softerhardware/Hermes-Lite2/README.md

Hermes-Lite 2.x
===============

See the main [Hermes-Lite Web Page](http://www.hermeslite.com) for the latest links and details.

This is a work in progress to create a low-cost software defined amateur radio HF transceiver based on a [broadband modem chip](http://www.analog.com/en/broadband-products/broadband-codecs/ad9866/products/product.html) and the [Hermes SDR](http://openhpsdr.org/wiki/index.php?title=HERMES) project.
