softerhardware/Hermes-Lite2/hardware/companions/io_jumper/README.md

# BOM

The BOM below lists possible options for IO jumper board. The builder should choose what components they need to buy and install.

| Reference | Quantity | Component |
| --- | --- | --- |
| DB1 | 1 | [5x2 male header 2.54mm](https://www.digikey.com/product-detail/en/sullins-connector-solutions/PRPC005DAAN-RC/S2011EC-05-ND) |
| P1 | 1 | [20x2 female header 2.54mm](https://www.digikey.com/product-detail/en/sullins-connector-solutions/SFH11-PBPC-D20-ST-BK/S9200-ND) |
| RF1 | 1 | [Edge Launch SMA](https://www.digikey.com/product-detail/en/adam-tech/RF2-04A-T-00-50-G/2057-RF2-04A-T-00-50-G-ND) |
| U1 | 1 | [MCP23008T-E-SS](https://www.digikey.com/product-detail/en/microchip-technology/MCP23008T-E-SS/MCP23008T-E-SSCT-ND) |
| C1 | 1 | [0.1uF 0805](https://www.digikey.com/product-detail/en/kemet/C0805C104Z5VACTU/399-1177-1-ND/411452) |
| R1, J1, J2 | 2 | [0Ohm 0805](https://www.digikey.com/product-detail/en/yageo/RC0805JR-070RL/311-0.0ARCT-ND) |
| R2 | 1 | [49.9 0805](https://www.digikey.com/product-detail/en/yageo/RC0805FR-0749R9L/311-49.9CRCT-ND) |
| R3 | 1 | [470 0805](https://www.digikey.com/product-detail/en/yageo/RC0805FR-07470RL/311-470CRCT-ND) |
| R4 | 1 | [1K 0805](https://www.digikey.com/product-detail/en/yageo/RC0805FR-071KL/311-1.00KCRCT-ND) |
