softerhardware/Hermes-Lite2/firmware/bitfiles/20180520/README.md

Hermes-Lite 2.x Firmware
========================

20180520 Release Candidate

Version 61 for beta3 and higher
Version 41 for beta2

* ADC running in low power mode to reduce heat
* New LEDs: Running, TX, ADC level just before clip, ADC clip
* Major rewrite of control to simplify and prepare for extensions
