softerhardware/Hermes-Lite2/hardware/enclosure/heatshim/enclosure_40mm/README.md

Hermes-Lite 2 heat shim for standard 40mm tall enclosure by Samuel F8ACB and Chris HB9BDM.
