softerhardware/Hermes-Lite2/hardware/companions/releases/n2adr_jumper/README.md

N2ADR Jumper Release
====================

February 24, 2019. This directory contains all files necessary to fabricate the N2ADR jumper board to connect the N2ADR filters to the Hermes-Lite 2.0.

# Files

 * pcb/* - Gerber files names as requested by assembly house
 
# BOM
 * 2-layer PCB as specified by gerber files
 * 2x20 PIN double row straight femail pin header 2.54mm pitch [AliExpress](https://www.aliexpress.com/item/10PCS-2X20-PIN-Double-row-Straight-FEMALE-PIN-HEADER-2-54MM-PITCH-Strip-Connector-Socket-2/32854215610.html)
