softerhardware/Hermes-Lite2/hardware/enclosure/endcaps/w3drk/README.md

Thank you to W3DRK for sharing these 3D printer files for HL2 end caps. They fit the recommended enclosure. The .stl files are for the 3D printer. The .f3d is an Autodesk Fusion 360 source file.
