softerhardware/Hermes-Lite2/hardware/hl/releases/hl2p0beta3/README.txt

September 4, 2017

This directory contains all files necessary to fabricate the Hermes-Lite 2.0beta3 release. Quotes are included for complete turnkey assembly by two compaines in China. A run of 5 assembled boards was done with Elecrow with good results. Elecrow is the preferred provider as they have and are developing expertise in the Hermes-Lite 2.0.
