softerhardware/Hermes-Lite2/gateware/bitfiles/stable/20180708/README.md

Hermes-Lite 2.x Firmware
========================

20180708 Release

* From Jim N2ADR: Change the CW waveform rise/fall time from 2 msec to 4 msec. Sequence TR.
* Deciamate by 8 polyphase FIR filter running at double speed.
