softerhardware/Hermes-Lite2/firmware/bitfiles/stable/20180603/README.md

Hermes-Lite 2.x Firmware
========================

20180602 Release Candidate

Version 62 for beta3 and higher
Version 42 for beta2

* Fix for proper padding with 3 or more receivers
* N2ADR additions for VNA
* N2ADR fix for PTT and CW return flags
* Combined I2C controller for I2C1 and I2C2, software may now control Versa Clock generator
