softerhardware/Hermes-Lite2/firmware/bitfiles/stable/20180106/README.md

Hermes-Lite 2.x Firmware
========================

20180106 Release Candidate

* Support for filter select via MCP23008, emulates J16 OC outputs
* New I2C module to support above
* Small change to slow ADC I2C reset to see if it makes slow ADC startup more stable
* Clock generation for 100Mbs modified to make timing closure more consistent
* RTL and SDC improvements and cleanup
