softerhardware/Hermes-Lite2/hardware/enclosure/endcaps/ad5dz/template/Readme.org

* Templates
  A kicad template is a kicad project with a meta sub-directory containing
  info.html, icon.png, and brd.png which appears in one of the template
  directories known to kicad.
  This directory provides symbolic links to the kicad projects which are
  used as templates.
