softerhardware/Hermes-Lite2/hardware/enclosure/endcaps/ad5dz/hl2-front-horiz/meta/info.html

# HL2 - Front Horizontal

Horizontally labelled front panel for the Hermes-Lite 2.0 (http://www.hermeslite.com) radio transceiver.

The final PCB looks like the following:

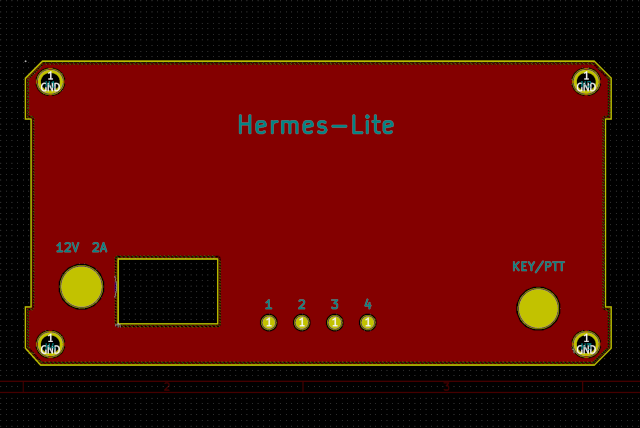
[picture p21: hardware/enclosure/endcaps/ad5dz/hl2-front-horiz/meta/brd.png]


© 2019 Roger E Critchlow Jr, Santa Fe, NM, USA
Permission granted to copy and to make derived works.
