softerhardware/Hermes-Lite2/hardware/enclosure/endcaps/ad5dz/hl2-panel/meta/info.html

# HL2 - End Panel

This is the board outline, mounting holes, and copyright notice for all the end plates of the Hermes-Lite 2.0 (http://www.hermeslite.com) radio transceiver. The board outline is cut small enough to fit inside the 105mm wide case outline. The mounting holes are spread 0.25mm horizontally to accommodate both the 105mm and 106mm width cases.

The final PCB looks like the following:

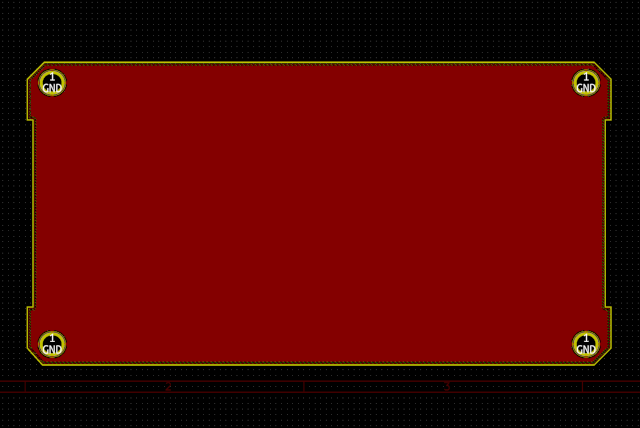
[picture p24: hardware/enclosure/endcaps/ad5dz/hl2-panel/meta/brd.png]


© 2019 Roger E Critchlow Jr, Santa Fe, NM, USA
Permission granted to copy and to make derived works.
