softerhardware/Hermes-Lite2/hardware/hl/bd.pdf

# Hermes-Lite 2.0beta2 Block Diagram

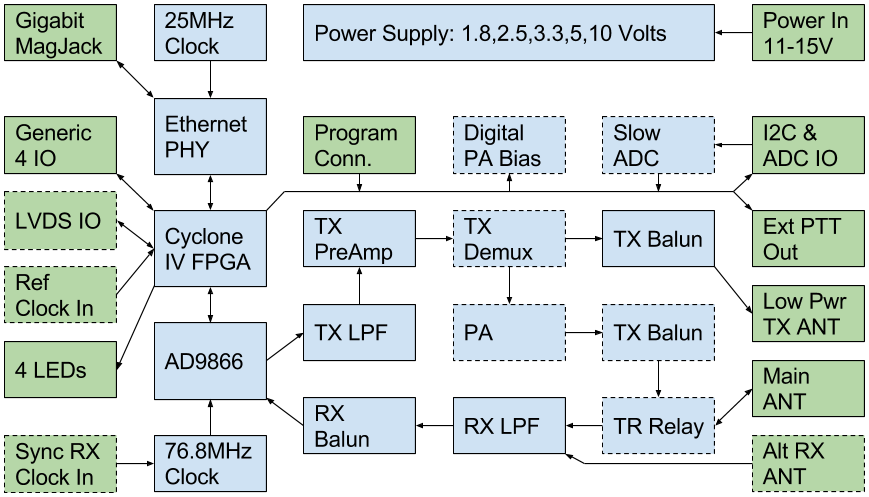
[picture p25: figure]

- Green boxes are external connectors
- Dashed boxes are common optional blocks
- Additional external filtering required for TX to meet harmonic emissions regulations
