softerhardware/Hermes-Lite2/hardware/enclosure/endcaps/ad5dz/mech-115mm/HTB1F0.VPXXXXXXGapXXq6xXFXXX0.jpg

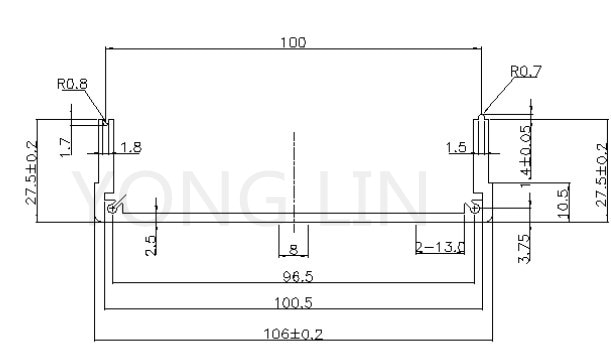
hardware/enclosure/endcaps/ad5dz/mech-115mm/HTB1F0.VPXXXXXXGapXXq6xXFXXX0.jpg
