softerhardware/Hermes-Lite2/hardware/enclosure/endcaps/ad5dz/mech-116mm/HTB1HYbmrYZnBKNjSZFrq6yRLFXaS.jpg

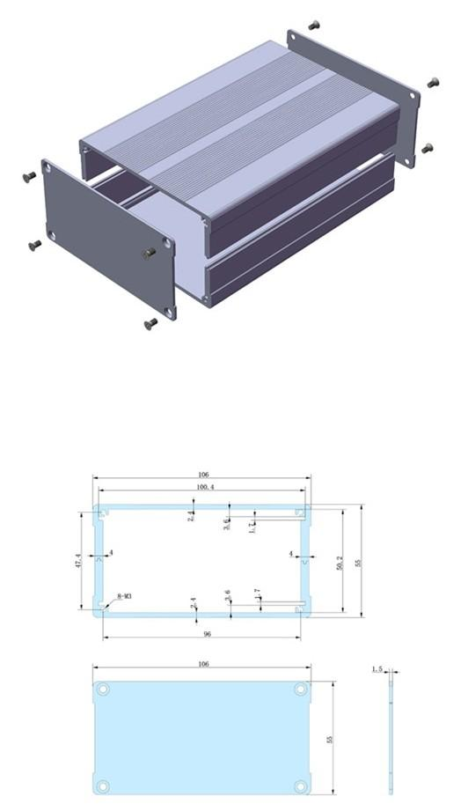
hardware/enclosure/endcaps/ad5dz/mech-116mm/HTB1HYbmrYZnBKNjSZFrq6yRLFXaS.jpg
