softerhardware/Hermes-Lite2/hardware/enclosure/endcaps/ad5dz/mech-116mm/SZOMK model number AK-C-C12.jpg

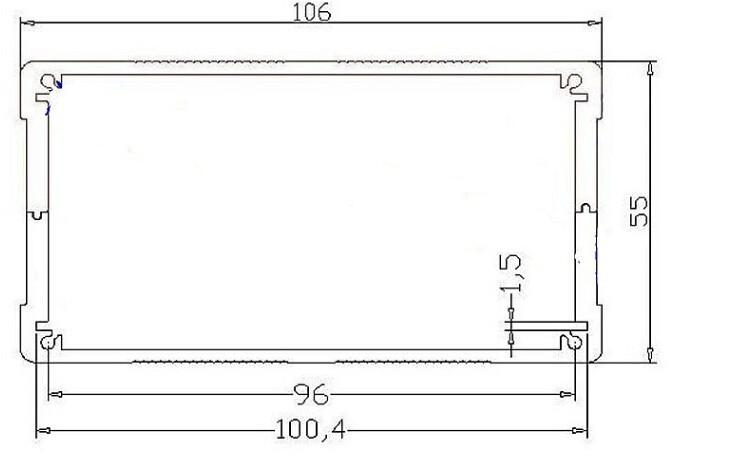
hardware/enclosure/endcaps/ad5dz/mech-116mm/SZOMK model number AK-C-C12.jpg
