softerhardware/Hermes-Lite2/hardware/enclosure/heatshim/enclosure_40mm/HL2_Cooler_Corrected_Version.jpg

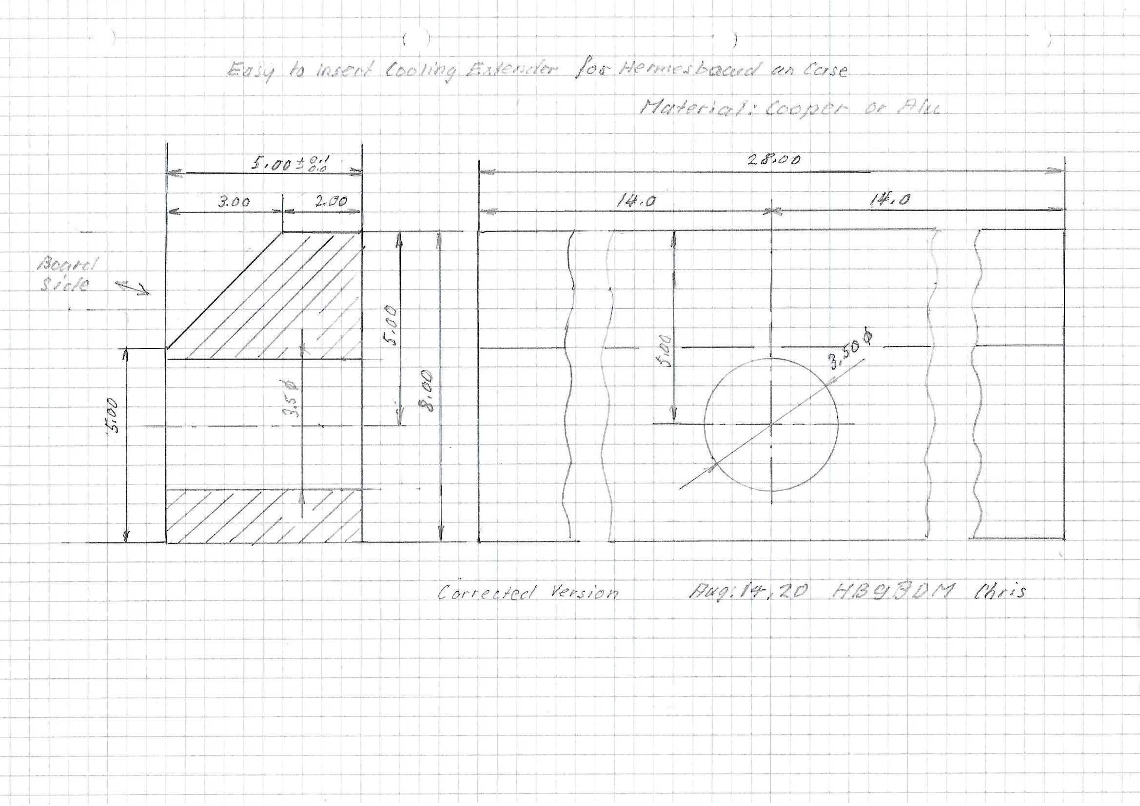
hardware/enclosure/heatshim/enclosure_40mm/HL2_Cooler_Corrected_Version.jpg
