softerhardware/Hermes-Lite2/hardware/companions/releases/n2adr_e5b9/bom.assembly.pdf

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

Line | Description | Part Number | Sub OK | Designators | Footprint | Pins | Quantity
36 | 56 0805≤1%≥1/10W | RC0805FR-0756RL (http://www.octopart.com/search?q=RC0805FR-0756RL) ERJ-6ENF56R0V (http://www.octopart.com/search?q=ERJ-6ENF56R0V) CRGCQ0805F56R (http://www.octopart.com/search?q=CRGCQ0805F56R) | Y | R3 | 0805 | 2 | 1
37 | 4.7K 0805≤1%≥1/10W | RC0805JR-074K7L (http://www.octopart.com/search?q=RC0805JR-074K7L) CRG0805F4K7 (http://www.octopart.com/search?q=CRG0805F4K7) RC2012F472CS (http://www.octopart.com/search?q=RC2012F472CS) | Y | R4,R5,R8,R9 | 0805 | 2 | 4
38 | 18 0805≤1%≥1/10W | RC0805FR-0718RL (http://www.octopart.com/search?q=RC0805FR-0718RL) CRG0805F18R (http://www.octopart.com/search?q=CRG0805F18R) | Y | R6,R7 | 0805 | 2 | 2
39 | 6.2K 0805≤1%≥1/10W | RC0805FR-076K2L (http://www.octopart.com/search?q=RC0805FR-076K2L) ERJ-6ENF6201V (http://www.octopart.com/search?q=ERJ-6ENF6201V) | Y | R11,R14 | 0805 | 2 | 2
40 | 330 0805≤1%≥1/10W | RC0805JR-07330RL (http://www.octopart.com/search?q=RC0805JR-07330RL) RC2012F331CS (http://www.octopart.com/search?q=RC2012F331CS) CRG0805F330R (http://www.octopart.com/search?q=CRG0805F330R) | Y | R12,R15 | 0805 | 2 | 2
41 | I2C Bus Expander | MCP23008T-E/SS (http://www.octopart.com/search?q=MCP23008T-E/SS) | N | U1 | SSOP-20 | 20 | 1
42 | Relay Driver | ULN2003LVPWR (http://www.octopart.com/search?q=ULN2003LVPWR) | N | U2 | TSSOP-16 | 16 | 1
43 | AD8692 Op Amp | AD8692ARMZ-R7 (http://www.octopart.com/search?q=AD8692ARMZ-R7) | N | U3 | MSOP-8 | 8 | 1
44 | NAND Gate | SN74LVC1G00DBVR (http://www.octopart.com/search?q=SN74LVC1G00DBVR) | N | U5 | SOT-23-5 | 5 | 1

Line Items: SMT:38 Assembled TH:6 Parts: SMT:81 Assembled TH:13
Pins: SMT:207 Assembled TH:107
Do Not Assemble: C12 C15 CN5 R16 RV1

3
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
