softerhardware/Hermes-Lite2/hardware/companions/releases/n2adr_e5b9/bom.assembly.xlsx

Line | Description | Part Number | Substitution Okay | Designators | Footprint | Pins | Quantity | Part Reference Links
1 | 0.1uF 0805>=X5R>=25V<=20% | 08055C104JAT2A C0805C104M3RACTU 885012207128 | Y | C1,C2,C3,C4,C5,C6, C7,C11,C13,C14,C20, C27,C28,C29,C30,C31, C45,C46,C50 | 805 | 2 | 19 | http://www.octopart.com/search?q=08055C104JAT2A | http://www.octopart.com/search?q=C0805C104M3RACTU | http://www.octopart.com/search?q=885012207128
2 | 1000pF 1206NP0>=200V<=5% | GRM31B5C2J102JW01L 885342008003 C1206C102K2GACTU | N | C8,C10 | 1206 | 2 | 2 | http://www.octopart.com/search?q=GRM31B5C2J102JW01L | http://www.octopart.com/search?q=885342008003 | http://www.octopart.com/search?q=C1206C102K2GACTU
3 | 1800pF 1206NP0>=200V<=5% | C3216C0G2J182J115AA C3216C0G2J182K115AA C1206C182JBGAC7800 | N | C9,C21,C23 | 1206 | 2 | 3 | http://www.octopart.com/search?q=C3216C0G2J182J115AA | http://www.octopart.com/search?q=C3216C0G2J182K115AA | http://www.octopart.com/search?q=C1206C182JBGAC7800
4 | 3300pF 1206NP0>=200V<=5% | C1206C332JBGACTU C3216C0G2E332J085AA CL31C332JHHNFNE | N | C22 | 1206 | 2 | 1 | http://www.octopart.com/search?q=C1206C332JBGACTU | http://www.octopart.com/search?q=C3216C0G2E332J085AA | http://www.octopart.com/search?q=CL31C332JHHNFNE
5 | 150pF 1206NP0>=200V<=5% | GRM31A5C2J151JW01D 12067A151JAT2A CC1206JKNPOZBN151 C3216C0G2J151K060AA | N | C24,C26,C33 | 1206 | 2 | 3 | http://www.octopart.com/search?q=GRM31A5C2J151JW01D | http://www.octopart.com/search?q=12067A151JAT2A | http://www.octopart.com/search?q=CC1206JKNPOZBN151 | http://www.octopart.com/search?q=C3216C0G2J151K060AA
6 | 330pF 1206NP0>=200V<=5% | GRM31A5C2J331JW01D C3216C0G2J331J060AA CL31C331JHFNNNE | N | C25,C39 | 1206 | 2 | 2 | http://www.octopart.com/search?q=GRM31A5C2J331JW01D | http://www.octopart.com/search?q=C3216C0G2J331J060AA | http://www.octopart.com/search?q=CL31C331JHFNNNE
7 | 270pF 1206NP0>=200V<=5% | GRM31A5C2J271JW01D C3216C0G2J271J060AA CL31C271JIHNNNE | N | C32,C38,C40 | 1206 | 2 | 3 | http://www.octopart.com/search?q=GRM31A5C2J271JW01D | http://www.octopart.com/search?q=C3216C0G2J271J060AA | http://www.octopart.com/search?q=CL31C271JIHNNNE
8 | 180pF 1206NP0>=200V<=5% | GRM31A5C2J181JW01D C3216C0G2J181K060AA CL31C181JHFNNNE C1206C181JGGAC7800 | N | C34,C44 | 1206 | 2 | 2 | http://www.octopart.com/search?q=GRM31A5C2J181JW01D | http://www.octopart.com/search?q=C3216C0G2J181K060AA | http://www.octopart.com/search?q=CL31C181JHFNNNE | http://www.octopart.com/search?q=C1206C181JGGAC7800
9 | 100pF 1206NP0>=200V<=5% | GRM31A5C2J101JW01D CC1206JKNPOZBN101 C3216C0G2J101J060AA | N | C35 | 1206 | 2 | 1 | http://www.octopart.com/search?q=GRM31A5C2J101JW01D | http://www.octopart.com/search?q=CC1206JKNPOZBN101 | http://www.octopart.com/search?q=C3216C0G2J101J060AA
10 | 39pF 1206NP0>=200V<=5% | GRM31A5C2J390JW01D GRM31A5C3A390JW01D | N | C36 | 1206 | 2 | 1 | http://www.octopart.com/search?q=GRM31A5C2J390JW01D | http://www.octopart.com/search?q=GRM31A5C3A390JW01D
11 | 560pF 1206NP0>=200V<=5% | GRM31A5C2J561JW01D CC1206JRNPOBBN561 C3216C0G2J561J085AA | N | C37 | 1206 | 2 | 1 | http://www.octopart.com/search?q=GRM31A5C2J561JW01D | http://www.octopart.com/search?q=CC1206JRNPOBBN561 | http://www.octopart.com/search?q=C3216C0G2J561J085AA
12 | 220pF 1206NP0>=200V<=5% | GRM31A5C2J221JW01D C3216C0G2J221J060AA CL31C221JGFNNNE | N | C41,C42 | 1206 | 2 | 2 | http://www.octopart.com/search?q=GRM31A5C2J221JW01D | http://www.octopart.com/search?q=C3216C0G2J221J060AA | http://www.octopart.com/search?q=CL31C221JGFNNNE
13 | 68pF 1206NP0>=200V<=5% | GRM31A5C2J680JW01D CL31C680JHFNNNE C1206C680J2GAC7800 | N | C43 | 1206 | 2 | 1 | http://www.octopart.com/search?q=GRM31A5C2J680JW01D | http://www.octopart.com/search?q=CL31C680JHFNNNE | http://www.octopart.com/search?q=C1206C680J2GAC7800
14 | 1500pF 0805NP0>=50V<=5% | 08055A152JAT2A 885012007064 CL21C152JBFNNNE | N | C47,C49 | 805 | 2 | 2 | http://www.octopart.com/search?q=08055A152JAT2A | http://www.octopart.com/search?q=885012007064 | http://www.octopart.com/search?q=CL21C152JBFNNNE
15 | 680pF 0805NP0>=50V<=5% | 08055A681JAT2A 885012007062 CC0805JRNPO0BN681 | N | C48 | 805 | 2 | 1 | http://www.octopart.com/search?q=08055A681JAT2A | http://www.octopart.com/search?q=885012007062 | http://www.octopart.com/search?q=CC0805JRNPO0BN681
16 | External PA Jack | RCJ-041 | Y | CN1 | Custom | 2 | 1 | http://www.aliexpress.com/wholesale?SearchText=MAXRUINOR RCA Socket PCB | http://www.octopart.com/search?q=RCJ-041
17 | 20 Pin Single Row 0.1in | PRPC020SAAN-RC | Y | CN2 | Custom | 20 | 1 | http://www.octopart.com/search?q=PRPC020SAAN-RC
18 | SMA Straight | 5-1814832-1 | Y | CN3,CN4 | Custom | 5 | 2 | http://www.aliexpress.com/wholesale?SearchText=ELECAPITAL End Launch PCB Mount SMA Female | http://www.octopart.com/search?q=5-1814832-1
19 | Schottky Diode | BAS40-07,215 BAS4007E6327HTSA1 | N | D1,D2 | SOT-143 | 4 | 2 | http://www.octopart.com/search?q=BAS40-07,215 | http://www.octopart.com/search?q=BAS4007E6327HTSA1
20 | SS Diode | 1N4148W-7-F | Y | D3 | SOD-123 | 2 | 1 | http://www.octopart.com/search?q=1N4148W-7-F
21 | FB 0805 >=600R@100MHz <=200mOhm@DC >=1.5A | MPZ2012S102AT000 ILHB0805ER601V | Y | FB1 | 805 | 2 | 1 | http://www.octopart.com/search?q=MPZ2012S102AT000 | http://www.octopart.com/search?q=ILHB0805ER601V
22 | 21cm Enameled Coopper Wire 24AWG | Various | Y | JP1 | Custom | 0 | 1 | http://www.aliexpress.com/wholesale?SearchText=Magnet Wire 0.5mm Enameled Copper Wire
23 | Relay | EC2-3NU EC2-3NJ | N | K1,K2,K3,K4,K5,K6, K7 | Custom | 10 | 7 | http://www.aliexpress.com/wholesale?SearchText=EC2-3NJ | http://www.octopart.com/search?q=EC2-3NU | http://www.octopart.com/search?q=EC2-3NJ
24 | 1.8uH | CC453232-1R8KL | N | L1,L2 | 1812 | 2 | 2 | http://www.octopart.com/search?q=CC453232-1R8KL
25 | T37 Toroid | 5977000211 | N | L3 | Custom | 5 | 1 | http://www.octopart.com/search?q=5977000211
26 | 1.8uH | LBM2016T1R8J | N | L4,L15 | 805 | 2 | 2 | http://www.octopart.com/search?q=LBM2016T1R8J
27 | 3.9uH | 7447669039 | N | L5,L6 | 1812 | 2 | 2 | http://www.octopart.com/search?q=7447669039
28 | 220nH | AISC-1210-R22J-T | N | L7,L8 | 1210 | 2 | 2 | http://www.octopart.com/search?q=AISC-1210-R22J-T
29 | 1000nH | CC453232-1R0KL | N | L9 | 1812 | 2 | 1 | http://www.octopart.com/search?q=CC453232-1R0KL
30 | 560nH | AISC-1210-R56J-T | N | L10 | 1210 | 2 | 1 | http://www.octopart.com/search?q=AISC-1210-R56J-T
31 | 390nH | AISC-1210-R39J-T | N | L11,L14 | 1210 | 2 | 2 | http://www.octopart.com/search?q=AISC-1210-R39J-T
32 | 680nH | AISC-1210-R68J-T | N | L12 | 1210 | 2 | 1 | http://www.octopart.com/search?q=AISC-1210-R68J-T
33 | 270nH | AISC-1210-R27J-T | N | L13 | 1210 | 2 | 1 | http://www.octopart.com/search?q=AISC-1210-R27J-T
34 | 22 0805<=1%>=1/10W | RC0805FR-0722RL ERJ-6ENF22R0V | Y | R1 | 805 | 2 | 1 | http://www.octopart.com/search?q=RC0805FR-0722RL | http://www.octopart.com/search?q=ERJ-6ENF22R0V
35 | 2.2K 0805<=1%>=1/10W | RC0805FR-072K2L CRG0805F2K2 | Y | R2,R10,R13 | 805 | 2 | 3 | http://www.octopart.com/search?q=RC0805FR-072K2L | http://www.octopart.com/search?q=CRG0805F2K2
36 | 56 0805<=1%>=1/10W | RC0805FR-0756RL ERJ-6ENF56R0V CRGCQ0805F56R | Y | R3 | 805 | 2 | 1 | http://www.octopart.com/search?q=RC0805FR-0756RL | http://www.octopart.com/search?q=ERJ-6ENF56R0V | http://www.octopart.com/search?q=CRGCQ0805F56R
37 | 4.7K 0805<=1%>=1/10W | RC0805JR-074K7L CRG0805F4K7 RC2012F472CS | Y | R4,R5,R8,R9 | 805 | 2 | 4 | http://www.octopart.com/search?q=RC0805JR-074K7L | http://www.octopart.com/search?q=CRG0805F4K7 | http://www.octopart.com/search?q=RC2012F472CS
38 | 18 0805<=1%>=1/10W | RC0805FR-0718RL CRG0805F18R | Y | R6,R7 | 805 | 2 | 2 | http://www.octopart.com/search?q=RC0805FR-0718RL | http://www.octopart.com/search?q=CRG0805F18R
39 | 6.2K 0805<=1%>=1/10W | RC0805FR-076K2L ERJ-6ENF6201V | Y | R11,R14 | 805 | 2 | 2 | http://www.octopart.com/search?q=RC0805FR-076K2L | http://www.octopart.com/search?q=ERJ-6ENF6201V
40 | 330 0805<=1%>=1/10W | RC0805JR-07330RL RC2012F331CS CRG0805F330R | Y | R12,R15 | 805 | 2 | 2 | http://www.octopart.com/search?q=RC0805JR-07330RL | http://www.octopart.com/search?q=RC2012F331CS | http://www.octopart.com/search?q=CRG0805F330R
41 | I2C Bus Expander | MCP23008T-E/SS | N | U1 | SSOP-20 | 20 | 1 | http://www.octopart.com/search?q=MCP23008T-E/SS
42 | Relay Driver | ULN2003LVPWR | N | U2 | TSSOP-16 | 16 | 1 | http://www.octopart.com/search?q=ULN2003LVPWR
43 | AD8692 Op Amp | AD8692ARMZ-R7 | N | U3 | MSOP-8 | 8 | 1 | http://www.octopart.com/search?q=AD8692ARMZ-R7
44 | NAND Gate | SN74LVC1G00DBVR | N | U5 | SOT-23-5 | 5 | 1 | http://www.octopart.com/search?q=SN74LVC1G00DBVR
Line Items SMT: | 38 | Line Items TH: | 6
Parts SMT: | 81 | Parts TH: | 13
Pins SMT: | 207 | Pins TH: | 107
Do Not Assemble:
C12,C15,CN5,R16,RV
