softerhardware/Hermes-Lite2/hardware/hl/releases/hl2p0beta3/Makerfabs PCBA Quotation for hermeslite2beta3.xlsx

Sheet: Total
Makerfabs PCBA Quotation
Basic info: |  |  |  |  |  | Customer address :
Vendor: Makerfabs |  |  | Customer:
Contact Person: Helen |  |  | Contact Person:
Tel: +86 189 2520 4600 |  |  | Tel:
Email: helen@makerfabs.com |  |  | Email:
Shipping method: DHL |  |  | Date:
For PCB fabricate
Project Name | Layers | Dimension | Thickness | Surface Finished | Solder Mask | Qty | Quotation（$) | Weight(kg) | Remark
hermeslite2beta3 | 4 | 10x10 cm | 1.6 | green | hasl lead free | 1 | $49.57 | 0.5
hermeslite2beta3 | 4 | 10x10 cm | 1.6 | green | hasl lead free | 5 | $49.57 | 0.5
hermeslite2beta3 | 4 | 10x10 cm | 1.6 | green | hasl lead free | 10 | $49.90 | 1.0
hermeslite2beta3 | 4 | 10x10 cm | 1.6 | green | hasl lead free | 50 | $94.69 | 5.0
Stencil |  |  |  |  |  | 1 | $18.00
 |  |  |  |  |  | Total:
For PCB Assembly
Project Name | Pads | Qty | Price | Qty of Boards | Quotation | Remark
hermeslite2beta3 | SMT | 1110 | 0.030 | 1 | $100.00
 | THT | 28 | 0.040
hermeslite2beta3 | SMT | 1110 | 0.030 | 5 | $250.00
 | THT | 28 | 0.040
hermeslite2beta3 | SMT | 1110 | 0.030 | 10 | $350.00
 | THT | 28 | 0.040
hermeslite2beta3 | SMT | 1110 | 0.030 | 50 | $780.00
 | THT | 28 | 0.040
 |  |  |  | Total:
Engineer Start
Total: | $10.00
Components
Project | Price | Remark
hermeslite2beta3 | $174.39 | for 1 pcs | $40 sourcing fee added for the first round of prototyping
hermeslite2beta3 | $671.96 | for 5 pcs
hermeslite2beta3 | $1273.20 | for 10 pcs
hermeslite2beta3 | $5894.63 | for 50 pcs
Total:
Shipping
Products | Shipping Method | Weight(kg) | Quotation | Remark
PCBAs | SZ DHL | 0.5 | $0.00 | for 1 pcs 2-3 shipping day
 |  | 0.5 | $0.00 | for 5 pcs 2-3 shipping day
 |  | 1.0 | $25.56 | for 10 pcs 2-3 shipping day
 |  | 5.0 | $45.00 | for 50 pcs 2-3 shipping day
 |  | Total:
 |  |  |  |  |  | Total Quatation($): | $351.96 | for 1 pcs
 |  |  |  |  |  |  | $999.53 | for 5 pcs
 |  |  |  |  |  |  | $1726.66 | for 10 pcs
 |  |  |  |  |  |  | $6842.32 | for 50 pcs

Sheet: hermeslite2beta3
 |  |  |  |  |  |  |  | 1/5pcs |  | 10pcs |  | 50pcs
Part ID | Description | Part Number | Substitution Okay | Designators | Footprint | Pins | Quantity | Unit Price | Total Price | Unit Price | Total Price | Unit Price | Total Price | Part Reference Link
1941-12-21 | 0.1uF 0603>=X5R>=50V<=20% | C0603C104M5RACTU | Y | B1,B2,B3,B4,B5,B6, B7,B8,B9,B10,B11, B12,B13,B14,B15,B16, B17,B18,B19,B20,B21, B22,B23,B24,B25,B26, B27,B28,B29,B30,B31, B32,B33,B34,B35,B36, B37,B38,B39,B40,B41, B42,B43,B44,B45,B46, B47,B48,B49,B50,B51, B52,B53,B54,B56,B57, B59,B60,B61,B62,B63, B64,B66,B67,B68,B69, B70,B71,B72,B73,B74, B75,B76,B77,B78,B79, B80,B81,B83,B84,B85, B86,B87,B88,B89,B90, B91,B92,B93,B94,B95, B96,B97,B98,B99,B100, B101,B102,B103,B105, B106,B108,B109,B111, B113,B114,B115,B116, B117,B119,B120,B122 | 603 | 2 | 112 | 0.000 | 0.000 | 0.000 | 0.000 | 0.000 | 0.000 | http://www.octopart.com/search?q=C0603C104M5RACTU
1955-11-18 | 10uF 0603>=X5R>=6.3V<=20% | GRM188R60J106KE47D | Y | C1,C2,C3,C4,C6,C7, C8,C9,C12,C25,C35, C38,C39,C40,C41,C44, C45,C62,C64,C66,C70 | 603 | 2 | 21 | 0.000 | 0.000 | 0.000 | 0.000 | 0.000 | 0.000 | http://www.octopart.com/search?q=GRM188R60J106KE47D
 | 100uF 1206>=X5R>=6.3V<=20% | GRM31CR60J107ME39K | Y | C5,C16,C22 | 1206 | 2 | 3 | 0.400 | 1.200 | 0.400 | 1.200 | 0.300 | 0.900 | http://www.octopart.com/search?q=GRM31CR60J107ME39K
2050-08-04 | 4.7nF 0603>=X5R>=25V<=20% | CL10B472KB8NNNC | Y | C13,C19,C27 | 603 | 2 | 3 | 0.000 | 0.000 |  | 0.000 |  | 0.000 | http://www.octopart.com/search?q=CL10B472KB8NNNC
2028-02-03 | 22uF 0805>=X5R>=16V<=20% | GRM21BR61E226ME44L | Y | C14,C15,C20,C21,C28, C29,C30,C31,C32 | 805 | 2 | 9 | 0.200 | 1.800 | 0.200 | 1.800 | 0.150 | 1.350 | http://www.octopart.com/search?q=GRM21BR61E226ME44L
1938-12-22 | 10uF 1206>=X5R>=25V<=20% | CL31A106KAHNNNE | Y | C17,C23,C33,C43,C48, C86,C88 | 1206 | 2 | 7 | 0.050 | 0.350 | 0.050 | 0.350 | 0.040 | 0.280 | http://www.octopart.com/search?q=CL31A106KAHNNNE
1905-10-31 | 4.7uF 0805>=X5R>=25V<=20% | GRM21BR61E475KA12L | Y | C18,C24,C34 | 805 | 2 | 3 | 0.000 | 0.000 | 0.000 | 0.000 | 0.000 | 0.000 | http://www.octopart.com/search?q=GRM21BR61E475KA12L
1945-04-04 | 1uF 0603>=X5R>=6.3V<=20% | GRM188R61E105KA12D | Y | C26,C60,C61,C63,C65, C67,C68,C69,C71,C72, C73,C74 | 603 | 2 | 12 | 0.000 | 0.000 | 0.000 | 0.000 | 0.000 | 0.000 | http://www.octopart.com/search?q=GRM188R61E105KA12D
1905-06-18 | 15pF 0603NP0>=6.3V<=5% | CC0603JRNPO9BN150 | Y | C36,C37 | 603 | 2 | 2 | 0.000 | 0.000 | 0.000 | 0.000 | 0.000 | 0.000 | http://www.octopart.com/search?q=CC0603JRNPO9BN150
1979-08-07 | 1uF 0805>=X5R>=25V<=20% | CL21B105KAFNNNE | Y | C46,C89,C144,C145, C146,C147 | 805 | 2 | 6 | 0.000 | 0.000 | 0.000 | 0.000 | 0.000 | 0.000 | http://www.octopart.com/search?q=CL21B105KAFNNNE
 | 75pF 0805NP0>=50V<=5% | C0805C750J1GACTU | Y | C49 | 805 | 2 | 1 | 0.000 | 0.000 | 0.000 | 0.000 | 0.000 | 0.000 | http://www.octopart.com/search?q=C0805C750J1GACTU
 | 150pF 0805NP0>=50V<=5% | CC0805JRNPO0BN151 | Y | C50 | 805 | 2 | 1 | 0.000 | 0.000 | 0.000 | 0.000 | 0.000 | 0.000 | http://www.octopart.com/search?q=CC0805JRNPO0BN151
 | 160pF 0805NP0>=50V<=5% | GRM2165C2A161JA01D | Y | C51 | 805 | 2 | 1 | 0.000 | 0.000 | 0.000 | 0.000 | 0.000 | 0.000 | http://www.octopart.com/search?q=GRM2165C2A161JA01D
1905-11-11 | 100pF 0805NP0>=50V<=5% | CC0805JRNPO0BN101 | Y | C52,C57,C81 | 805 | 2 | 3 | 0.000 | 0.000 | 0.000 | 0.000 | 0.000 | 0.000 | http://www.octopart.com/search?q=CC0805JRNPO0BN101
1905-11-06 | 10pF 0805NP0>=50V<=5% | CC0805JRNPO9BN100 | Y | C53 | 805 | 2 | 1 | 0.000 | 0.000 | 0.000 | 0.000 | 0.000 | 0.000 | http://www.octopart.com/search?q=CC0805JRNPO9BN100
 | 180pF 0805NP0>=50V<=5% | CC0805JRNPO0BN181 | Y | C56 | 805 | 2 | 1 | 0.000 | 0.000 | 0.000 | 0.000 | 0.000 | 0.000 | http://www.octopart.com/search?q=CC0805JRNPO0BN181
 | 270pF 0805NP0>=50V<=5% | CC0805JRNPO0BN271 | Y | C84 | 805 | 2 | 1 | 0.000 | 0.000 | 0.000 | 0.000 | 0.000 | 0.000 | http://www.octopart.com/search?q=CC0805JRNPO0BN271
 | 8.2pF 0805NP0>=25V<=5% | CL21C8R2DBANNNC | Y | C87 | 805 | 2 | 1 | 0.000 | 0.000 | 0.000 | 0.000 | 0.000 | 0.000 | http://www.octopart.com/search?q=CL21C8R2DBANNNC
 | 2x5 M 0.1in | 67997-410HLF | Y | CN1 | Custom | 10 | 1 | 0.100 | 0.100 | 0.100 | 0.100 | 0.100 | 0.100 | http://www.octopart.com/search?q=67997-410HLF
 | Eth MagJack | L829-1J1T-43 | N | CN3 | Custom | 18 | 1 | 7.370 | 7.370 | 7.060 | 7.060 | 6.180 | 6.180 | http://www.octopart.com/search?q=L829-1J1T-43
 | TVS Diode | CDSOD323-T05LC | N | D1 | SC-76, SOD-323 | 2 | 1 | 0.948 | 0.948 | 0.821 | 0.821 | 0.821 | 0.821 | http://www.octopart.com/search?q=CDSOD323-T05LC
 | LED RA | LTST-S220KFKT | N | D2,D3,D4,D5 | 2.1x1.0mmRightAngle | 2 | 4 | 0.291 | 1.165 | 0.227 | 0.908 | 0.117 | 0.468 | http://www.octopart.com/search?q=LTST-S220KFKT
 | Schottky Barrier Diode | 1N5711WS-7-F | N | D10,D11 | SC-76, SOD-323 | 2 | 2 | 0.220 | 0.440 | 0.120 | 0.240 | 0.080 | 0.160 | http://www.octopart.com/search?q=1N5711WS-7-F
 | TVS Diode | SMBJ18CA | N | D12 | DO-214AA (SMB) | 2 | 1 | 0.400 | 0.400 | 0.200 | 0.200 | 0.150 | 0.150 | http://www.aliexpress.com/wholesale?SearchText=SMBJ18CA
 | FUSE PTC 3.0A 24V | MF-LSMF300/24X-2 | N | F1 | 2920 7.36x5.12mm | 2 | 1 | 0.583 | 0.583 | 0.548 | 0.548 | 0.462 | 0.462 | http://www.aliexpress.com/wholesale?SearchText=MF-LSMF300/24X-2
 | Ferrite Bead 0603 >= 600 Ohms at 100MHz <= 200 mOhms at DC 1A <=25% | MPZ1608S601ATA00 | Y | FB1,FB2,FB3,FB4,FB5, FB6,FB7,FB8,FB9,FB10, FB11,FB12,FB13,FB14, FB15,FB16,FB17,FB18, FB19,FB20,FB21,FB23, FB24,FB25,FB26,FB28, FB30 | 603 | 2 | 27 | 0.040 | 1.080 | 0.040 | 1.080 | 0.030 | 0.810 | http://www.octopart.com/search?q=MPZ1608S601ATA00
1959-12-19 | 0Ohm 0603<=5%>=1/10W | RC0603JR-070RL | Y | J1,J2,J9,J10,J11, J14,J15,J19,J21,J22, J28,J30,J31,J32,L33, L34 | 603 | 2 | 16 | 0.000 | 0.000 | 0.000 | 0.000 | 0.000 | 0.000 | http://www.octopart.com/search?q=RC0603JR-070RL
 | 3.3uH >=2.4A | SRN5020-3R3M | N | L1,L3 | 5x5mm | 2 | 2 | 0.449 | 0.899 | 0.330 | 0.660 | 0.330 | 0.660 | http://www.octopart.com/search?q=SRN5020-3R3M
 | 2.2uH >=2.4A | SRN5020-2R2Y | N | L2 | 5x5mm | 2 | 1 | 0.449 | 0.449 | 0.330 | 0.330 | 0.330 | 0.330 | http://www.octopart.com/search?q=SRN5020-2R2Y
 | 240nH | LQW2BASR24J00L | N | L4,L7 | 805 | 2 | 2 | 0.300 | 0.600 | 0.300 | 0.600 | 0.250 | 0.500 | http://www.octopart.com/search?q=LQW2BASR24J00L
 | 270nH | LQW2BASR27J00L | N | L5,L6,L8,L9 | 805 | 2 | 4 | 0.292 | 1.170 | 0.250 | 1.000 | 0.250 | 1.000 | http://www.octopart.com/search?q=LQW2BASR27J00L
 | 330nH | LQW2BASR33J00L | N | L10,L11 | 805 | 2 | 2 | 0.291 | 0.583 | 0.257 | 0.515 | 0.175 | 0.351 | http://www.octopart.com/search?q=LQW2BASR33J00L
 | MOSFET P-CH 30V | DMP3099L-7 | N | Q1 | SOT-23-3 | 3 | 1 | 0.250 | 0.250 | 0.200 | 0.200 | 0.100 | 0.100 | http://www.octopart.com/search?q=DMP3099L-7
 | Inductive Load Driver | NUD3124LT1G | N | Q2,Q5 | SOT-23-3 | 3 | 2 | 0.350 | 0.700 | 0.250 | 0.500 | 0.200 | 0.400 | http://www.aliexpress.com/wholesale?SearchText=NUD3124LT1G
 | RF LDMOS | AFT05MS003NT1 | N | Q3,Q4 | SOT-89-3 | 3 | 2 | 2.352 | 4.703 | 2.106 | 4.212 | 1.708 | 3.416 | http://www.octopart.com/search?q=AFT05MS003NT1
 | Thermal Sensor | MCP9700T-E/TT | N | Q6 | SOT-23-3 | 3 | 1 | 0.250 | 0.250 | 0.250 | 0.250 | 0.210 | 0.210 | http://www.aliexpress.com/wholesale?SearchText=MCP9700T-E/TT
1965-05-05 | 33 0603<=1%>=1/10W | RC0603FR-0733RL | Y | R1,R42,R50,R64 | 603 | 2 | 4 | 0.000 | 0.000 | 0.000 | 0.000 | 0.000 | 0.000 | http://www.octopart.com/search?q=RC0603FR-0733RL
1972-09-05 | 10K 0603<=5%>=1/10W | RC0603FR-0710KL | Y | R2,R3,R4,R5,R6,R7, R14,R21,R22,R23,R24, R25,R27,R28,R29 | 603 | 2 | 15 | 0.000 | 0.000 | 0.000 | 0.000 | 0.000 | 0.000 | http://www.octopart.com/search?q=RC0603FR-0710KL
1964-10-16 | 2.2 0603<=5%>=1/10W | RC0603FR-072R2L | Y | R10 | 603 | 2 | 1 | 0.000 | 0.000 | 0.000 | 0.000 | 0.000 | 0.000 | http://www.octopart.com/search?q=RC0603FR-072R2L
 | 35.7K 0603<=1%>=1/10W | RC0603FR-0735K7L | Y | R11 | 603 | 2 | 1 | 0.000 | 0.000 | 0.000 | 0.000 | 0.000 | 0.000 | http://www.octopart.com/search?q=RC0603FR-0735K7L
 | 11.5K 0603<=1%>=1/10W | RC0603FR-0711K5L | Y | R12,R91 | 603 | 2 | 2 | 0.000 | 0.000 | 0.000 | 0.000 | 0.000 | 0.000 | http://www.octopart.com/search?q=RC0603FR-0711K5L
1912-07-26 | 20K 0603<=1%>=1/10W | RC0603FR-0720KL | Y | R15 | 603 | 2 | 1 | 0.000 | 0.000 | 0.000 | 0.000 | 0.000 | 0.000 | http://www.octopart.com/search?q=RC0603FR-0720KL
 | 16.2K 0603<=1%>=1/10W | RC0603FR-0716K2L | Y | R19 | 603 | 2 | 1 | 0.000 | 0.000 | 0.000 | 0.000 | 0.000 | 0.000 | http://www.octopart.com/search?q=RC0603FR-0716K2L
1912-08-01 | 2.2K 0603<=5%>=1/10W | RC0603FR-072K2L | Y | R20,R26,R49,R65,R75, R76,R79,R80 | 603 | 2 | 8 | 0.000 | 0.000 | 0.000 | 0.000 | 0.000 | 0.000 | http://www.octopart.com/search?q=RC0603FR-072K2L
1964-11-12 | 270 0603<=5%>=1/10W | RC0603FR-07270RL | Y | R30,R31,R92,R99 | 603 | 2 | 4 | 0.000 | 0.000 | 0.000 | 0.000 | 0.000 | 0.000 | http://www.octopart.com/search?q=RC0603FR-07270RL
1959-12-20 | 1K 0603<=5%>=1/10W | RC0603FR-071KL | Y | R32,R33,R57,R58,R67, R68,R71,R72,R73,R74, R103,R108,R111,R114 | 603 | 2 | 14 | 0.000 | 0.000 | 0.000 | 0.000 | 0.000 | 0.000 | http://www.octopart.com/search?q=RC0603FR-071KL
 | 12.1K 0603<=1%>=1/10W | RC0603FR-0712K1L | Y | R34 | 603 | 2 | 1 | 0.000 | 0.000 | 0.000 | 0.000 | 0.000 | 0.000 | http://www.octopart.com/search?q=RC0603FR-0712K1L
1965-05-27 | 4.7K 0603<=5%>=1/10W | RC0603FR-074K7L | Y | R43,R44,R48,R53,R106, R107,R124,R125,R126, R130 | 603 | 2 | 10 | 0.000 | 0.000 | 0.000 | 0.000 | 0.000 | 0.000 | http://www.octopart.com/search?q=RC0603FR-074K7L
1912-07-19 | 1.8K 0603<=1%>=1/10W | RC0603FR-071K8L | Y | R46,R104,R115 | 603 | 2 | 3 | 0.000 | 0.000 | 0.000 | 0.000 | 0.000 | 0.000 | http://www.octopart.com/search?q=RC0603FR-071K8L
1965-09-02 | 9.1K 0603<=1%>=1/10W | RC0603FR-079K1L | Y | R47,R66 | 603 | 2 | 2 | 0.000 | 0.000 | 0.000 | 0.000 | 0.000 | 0.000 | http://www.octopart.com/search?q=RC0603FR-079K1L
1965-12-02 | 22 0603<=5%>=1/10W | RC0603FR-0722RL | Y | R51,R63 | 603 | 2 | 2 | 0.000 | 0.000 | 0.000 | 0.000 | 0.000 | 0.000 | http://www.octopart.com/search?q=RC0603FR-0722RL
 | 12 0805<=5%>=1/8W | RC0805FR-0712RL | Y | R52,R54,R61,R62,R94, R100 | 805 | 2 | 6 | 0.000 | 0.000 | 0.000 | 0.000 | 0.000 | 0.000 | http://www.octopart.com/search?q=RC0805FR-0712RL
1912-10-25 | 75 0603<=5%>=1/10W | RC0603FR-0775RL | Y | R55 | 603 | 2 | 1 | 0.000 | 0.000 | 0.000 | 0.000 | 0.000 | 0.000 | http://www.octopart.com/search?q=RC0603FR-0775RL
1965-05-03 | 330 0603<=1%>=1/10W | RC0603FR-07330RL | Y | R56,R59 | 603 | 2 | 2 | 0.000 | 0.000 | 0.000 | 0.000 | 0.000 | 0.000 | http://www.octopart.com/search?q=RC0603FR-07330RL
 | 1.6K 0603<=5%>=1/10W | RC0603FR-071K6L | Y | R69,R102 | 603 | 2 | 2 | 0.000 | 0.000 | 0.000 | 0.000 | 0.000 | 0.000 | http://www.octopart.com/search?q=RC0603FR-071K6L
1964-11-13 | 27K 0603<=1%>=1/10W | RC0603FR-0727KL | Y | R70,R127 | 603 | 2 | 2 | 0.000 | 0.000 | 0.000 | 0.000 | 0.000 | 0.000 | http://www.octopart.com/search?q=RC0603FR-0727KL
1964-05-05 | 100 0603<=1%>=1/10W | RC0603FR-07100RL | Y | R77,R78,R81,R82,R120, R121,R122 | 603 | 2 | 7 | 0.000 | 0.000 | 0.000 | 0.000 | 0.000 | 0.000 | http://www.octopart.com/search?q=RC0603FR-07100RL
1964-11-07 | 220K 0603<=1%>=1/10W | RC0603FR-07220KL | Y | R113,R116 | 603 | 2 | 2 | 0.000 | 0.000 | 0.000 | 0.000 | 0.000 | 0.000 | http://www.octopart.com/search?q=RC0603FR-07220KL
 | 0.04 1206<=1%>=1/4W | RL1206FR-070R04L | Y | R123 | 1206 | 2 | 1 | 0.100 | 0.100 | 0.100 | 0.100 | 0.100 | 0.100 | http://www.octopart.com/search?q=RL1206FR-070R04L
 | 1:1 RF Transformer | MABAES0060 | N | T1 | SM-22-5 3.81x3.81mm | 5 | 1 | 1.900 | 1.900 | 1.800 | 1.800 | 1.500 | 1.500 | http://www.aliexpress.com/wholesale?SearchText=MABAES0060
 | 8:1 RF Transformer | MABA-010143-FLUX18 | N | T2 | SM-22-5 3.81x3.81mm | 5 | 1 | 3.600 | 3.600 | 3.600 | 3.600 | 3.250 | 3.250 | http://www.octopart.com/search?q=MABA-010143-FLUX18
 | EEPROM 2Mx8bit >40MHz | W25Q16JVSNIQ | N | U1 | 8-SOIC (3.90mm) | 8 | 1 | 0.400 | 0.400 | 0.400 | 0.400 | 0.400 | 0.400 | http://www.aliexpress.com/wholesale?SearchText=S25FL116K0XMFI041
 | FPGA | EP4CE22E22C8N | N | U2 | 144-LQFP EP | 144 | 1 | 41.558 | 41.558 | 41.558 | 41.558 | 41.558 | 41.558 | http://www.aliexpress.com/wholesale?SearchText=EP4CE22E22C8N
 | Switching Regulator | ST1S10PHR | N | U3,U8,U16 | 8-SOIC (3.90mm) EP | 8 | 3 | 1.100 | 3.300 | 1.000 | 3.000 | 0.900 | 2.700 | http://www.aliexpress.com/wholesale?SearchText=st1s10
 | Gigabit EthPhy | KSZ9031RNXCC | N | U4 | 48-VFQFN EP | 48 | 1 | 3.978 | 3.978 | 3.346 | 3.346 | 2.960 | 2.960 | http://www.aliexpress.com/wholesale?SearchText=KSZ9031
 | Clock Generator | 5P49V5923B000NLGI | N | U6 | 24-VFQFN EP | 24 | 1 | 3.393 | 3.393 | 3.042 | 3.042 | 2.738 | 2.738 | http://www.octopart.com/search?q=5P49V5923B000NLGI
 | RF ADC DAC | AD9866BCPZ | N | U7 | 64-VFQFN EP | 64 | 1 | 35.000 | 35.000 | 33.000 | 33.000 | 30.000 | 30.000 | http://www.aliexpress.com/wholesale?SearchText=AD9866BCPZ
 | RF Preamp OpAmp | OPA2677IDDA | N | U9 | 8-SOIC (3.90mm) EP | 8 | 1 | 4.762 | 4.762 | 4.270 | 4.270 | 3.978 | 3.978 | http://www.aliexpress.com/wholesale?SearchText=OPA2677
 | RF Switch | 4259-63 | N | U10,U11 | SC70-6 | 6 | 2 | 0.870 | 1.740 | 0.870 | 1.740 | 0.870 | 1.740 | http://www.aliexpress.com/wholesale?SearchText=pe4259
 | LDO Regulator | AP2204MP-ADJTRG1 | N | U12 | 8-SOIC (3.90mm) EP | 8 | 1 | 0.400 | 0.400 | 0.350 | 0.350 | 0.320 | 0.320 | http://www.octopart.com/search?q=AP2204MP-ADJTRG1
 | Slow ADC | MAX11613EUA | N | U13 | 8-MSOP (3.00mm) | 8 | 1 | 2.141 | 2.141 | 2.059 | 2.059 | 2.059 | 2.059 | http://www.octopart.com/search?q=MAX11613EUA
 | Current Sense AMP | INA199A1DC | N | U14 | SC-70-6 | 6 | 1 | 0.900 | 0.900 | 0.800 | 0.800 | 0.550 | 0.550 | http://www.octopart.com/search?q=INA199A1DC
 | Digital Rheostat 5K | MCP4662-502E/UN | N | U15 | 10-MSOP (3.00mm) | 10 | 1 | 1.622 | 1.622 | 1.474 | 1.474 | 1.305 | 1.305 | http://www.octopart.com/search?q=MCP4662-502E/UN
 | LDO Regulator | TPS73025DBVR | N | U17 | SOT-23-5 | 5 | 1 | 0.600 | 0.600 | 0.500 | 0.500 | 0.500 | 0.500 | http://www.aliexpress.com/wholesale?SearchText=TPS73025DBVR
 | OpAmp | LMV324IDR | N | U18 | 14-SOIC (3.90mm) | 14 | 1 | 0.400 | 0.400 | 0.300 | 0.300 | 0.250 | 0.250 | http://www.aliexpress.com/wholesale?SearchText=LMV324IDR
 | LDO 10V 150mA | LP2985-10DBVR | N | U19 | SOT-23-5 | 5 | 1 | 0.702 | 0.702 | 0.620 | 0.620 | 0.580 | 0.580 | http://www.octopart.com/search?q=LP2985-10DBVR
 | 25MHz XTAL | NX3225SA-25.000M-STD-CSR-3 | Y | X1 | 3.2x2.5mm | 4 | 1 | 0.200 | 0.200 | 0.200 | 0.200 | 0.170 | 0.170 | http://www.aliexpress.com/wholesale?SearchText=25mhz 3.2x2.5 passive
 | 38.4MHz Osc 3.3V<=10ppm | ASTXR-12-38.400MHZ-514054-T | N | X2 | 2.5x2mm | 4 | 1 | 2.656 | 2.656 | 2.586 | 2.586 | 2.586 | 2.586 | http://www.octopart.com/search?q=ASTXR-12-38.400MHZ-514054-T
Line Items SMT: | 76 | Line Items TH: | 2 |  |  |  |  | Total: | 134.391 |  | 127.320 |  | 117.893
Parts SMT: | 371 | Parts TH: | 2
Pins SMT: | 1110 | Pins TH: | 28
Do Not Assemble:
B55 B58 B65 B82 B104 B107 B112 B118 B121 C10 C11 C42 C47 C54 C55 C58 C59 C75 C76 C77 C78 C79 C80 C82 C83 C85 C148 C149 CL1 CL2 CL3 CL4 CN2 CN4 CN5 CN6 CN7 CN8 CN9 CN10 CN11 CN12 D6 D7 D8 D9 D13 D14 DB1 DB2 DB3 DB4 DB5 DB6 DB7 DB8 DB9 DB10 DB11 DB12 DB14 DB16 DB17 DB19 DB20 DB22 DB23 DB24 DB26 DB27 EN1 FB27 FB29 J3 J4 J5 J6 J7 J8 J12 J13 J16 J17 J18 J20 J23 K2 PB1 PG1 Q7 R8 R9 R13 R16 R17 R18 R35 R36 R37 R38 R39 R40 R41 R45 R60 R83 R84 R85 R86 R87 R88 R89 R90 R93 R96 R97 R98 R105 R109 R110 R112 R117 R118 R119 R128 R129 R131 R132 R133 R134 R135 RF1 RF2 RF3 T3 U5 X3
