softerhardware/Hermes-Lite2/hardware/hl/bom/bom.assembly.pdf

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

Line | Description | Part Number | Sub OK | Designators | Footprint | Pins | Quantity
39 | RF LDMOS | AFT05MS003NT1 (http://www.octopart.com/search?q=AFT05MS003NT1) | N | Q3,Q4 | SOT-89-3 | 3 | 2
40 | Thermal Sensor | AliExpress (http://www.aliexpress.com/wholesale?SearchText=MCP9700T-E/TT) MCP9700T-E/TT (http://www.octopart.com/search?q=MCP9700T-E/TT) | N | Q6 | SOT-23-3 | 3 | 1
41 | 33 0603≤1%≥1/10W | RC0603FR-0733RL (http://www.octopart.com/search?q=RC0603FR-0733RL) CR0603-FX-33R0ELF (http://www.octopart.com/search?q=CR0603-FX-33R0ELF) | Y | R1,R41,R42,R45,R50, R64 | 0603 | 2 | 6
42 | 10K 0603≤5%≥1/10W | RC0603FR-0710KL (http://www.octopart.com/search?q=RC0603FR-0710KL) CR0603-FX-1002HLF (http://www.octopart.com/search?q=CR0603-FX-1002HLF) | Y | R2,R3,R4,R5,R6,R7, R14,R21,R22,R23,R24, R25,R27,R28,R29,R131, R132 | 0603 | 2 | 17
43 | 2.2 0603≤5%≥1/10W | RC0603FR-072R2L (http://www.octopart.com/search?q=RC0603FR-072R2L) | Y | R10 | 0603 | 2 | 1
44 | 35.7K 0603≤1%≥1/10W | RC0603FR-0735K7L (http://www.octopart.com/search?q=RC0603FR-0735K7L) | Y | R11 | 0603 | 2 | 1
45 | 11.5K 0603≤1%≥1/10W | RC0603FR-0711K5L (http://www.octopart.com/search?q=RC0603FR-0711K5L) | Y | R12,R91 | 0603 | 2 | 2
46 | 20K 0603≤1%≥1/10W | RC0603FR-0720KL (http://www.octopart.com/search?q=RC0603FR-0720KL) CR0603-FX-2002ELF (http://www.octopart.com/search?q=CR0603-FX-2002ELF) | Y | R15 | 0603 | 2 | 1
47 | 16.2K 0603≤1%≥1/10W | RC0603FR-0716K2L (http://www.octopart.com/search?q=RC0603FR-0716K2L) | Y | R19 | 0603 | 2 | 1
48 | 2.2K 0603≤5%≥1/10W | RC0603FR-072K2L (http://www.octopart.com/search?q=RC0603FR-072K2L) | Y | R20,R26,R49,R65,R75, R76 | 0603 | 2 | 6
49 | 12.1K 0603≤1%≥1/10W | RC0603FR-0712K1L (http://www.octopart.com/search?q=RC0603FR-0712K1L) | Y | R34 | 0603 | 2 | 1
50 | 130 0603≤1%≥1/10W | RC0603FR-07130RL (http://www.octopart.com/search?q=RC0603FR-07130RL) | Y | R39 | 0603 | 2 | 1
51 | 75 0603≤5%≥1/10W | RC0603FR-0775RL (http://www.octopart.com/search?q=RC0603FR-0775RL) CR0603-FX-75R0ELF (http://www.octopart.com/search?q=CR0603-FX-75R0ELF) | Y | R40 | 0603 | 2 | 1
52 | 4.7K 0603≤5%≥1/10W | RC0603FR-074K7L (http://www.octopart.com/search?q=RC0603FR-074K7L) CR0603-FX-4701ELF (http://www.octopart.com/search?q=CR0603-FX-4701ELF) | Y | R43,R44,R48,R53,R95, R101,R106,R107,R117, R118,R119,R124,R125, R126,R130 | 0603 | 2 | 15
53 | 1.8K 0603≤1%≥1/10W | RC0603FR-071K8L (http://www.octopart.com/search?q=RC0603FR-071K8L) CR0603-FX-1801ELF (http://www.octopart.com/search?q=CR0603-FX-1801ELF) | Y | R46 | 0603 | 2 | 1
54 | 9.1K 0603≤1%≥1/10W | RC0603FR-079K1L (http://www.octopart.com/search?q=RC0603FR-079K1L) | Y | R47,R66 | 0603 | 2 | 2
55 | 22 0603≤5%≥1/10W | RC0603FR-0722RL (http://www.octopart.com/search?q=RC0603FR-0722RL) CR0603-FX-22R0ELF (http://www.octopart.com/search?q=CR0603-FX-22R0ELF) | Y | R51,R63 | 0603 | 2 | 2
56 | 12 0805≤5%≥1/8W | RC0805FR-0712RL (http://www.octopart.com/search?q=RC0805FR-0712RL) ERJ-6ENF12R0V (http://www.octopart.com/search?q=ERJ-6ENF12R0V) | Y | R52,R54,R61,R62,R94, R100 | 0805 | 2 | 6
57 | 120 0603≤1%≥1/10W | RC0603FR-07120RL (http://www.octopart.com/search?q=RC0603FR-07120RL) | Y | R55 | 0603 | 2 | 1
58 | 330 0603≤1%≥1/10W | RC0603FR-07330RL (http://www.octopart.com/search?q=RC0603FR-07330RL) CR0603-FX-3300ELF (http://www.octopart.com/search?q=CR0603-FX-3300ELF) | Y | R56,R59 | 0603 | 2 | 2
59 | 1K 0603≤5%≥1/10W | RC0603FR-071KL (http://www.octopart.com/search?q=RC0603FR-071KL) CR0603-FX-1001HLF (http://www.octopart.com/search?q=CR0603-FX-1001HLF) | Y | R57,R58,R67,R68,R71, R72,R73,R74,R109 | 0603 | 2 | 9
60 | 1.6K 0603≤5%≥1/10W | RC0603FR-071K6L (http://www.octopart.com/search?q=RC0603FR-071K6L) | Y | R69,R102 | 0603 | 2 | 2

4

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
