softerhardware/Hermes-Lite2/hardware/hl/releases/hl2p0build9/bom.assembly.pdf

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

Line | Description | Part Number | Sub OK | Designators | Footprint | Pins | Quantity
37 | 240nH | LQW2BASR24J00L (http://www.octopart.com/search?q=LQW2BASR24J00L) | N | L4,L7 | 0805 | 2 | 2
38 | 270nH | LQW2BASR27J00L (http://www.octopart.com/search?q=LQW2BASR27J00L) | N | L5,L6,L8,L9 | 0805 | 2 | 4
39 | 330nH | LQW2BASR33J00L (http://www.octopart.com/search?q=LQW2BASR33J00L) | N | L10,L11 | 0805 | 2 | 2
40 | MOSFET P-CH 30V | DMP3099L-7 (http://www.octopart.com/search?q=DMP3099L-7) | N | Q1 | SOT-23-3 | 3 | 1
41 | Inductive Load Driver | AliExpress (http://www.aliexpress.com/wholesale?SearchText=NUD3124LT1G) NUD3124LT1G (http://www.octopart.com/search?q=NUD3124LT1G) | N | Q2,Q5 | SOT-23-3 | 3 | 2
42 | RF LDMOS | AFT05MS003NT1 (http://www.octopart.com/search?q=AFT05MS003NT1) | N | Q3,Q4 | SOT-89-3 | 3 | 2
43 | Thermal Sensor | AliExpress (http://www.aliexpress.com/wholesale?SearchText=MCP9700T-E/TT) MCP9700T-E/TT (http://www.octopart.com/search?q=MCP9700T-E/TT) | N | Q6 | SOT-23-3 | 3 | 1
44 | 33 0603≤1%≥1/10W | RC0603FR-0733RL (http://www.octopart.com/search?q=RC0603FR-0733RL) CR0603-FX-33R0ELF (http://www.octopart.com/search?q=CR0603-FX-33R0ELF) | Y | R1,R41,R42,R45,R50, R64 | 0603 | 2 | 6
45 | 10K 0603≤5%≥1/10W | RC0603FR-0710KL (http://www.octopart.com/search?q=RC0603FR-0710KL) CR0603-FX-1002HLF (http://www.octopart.com/search?q=CR0603-FX-1002HLF) | Y | R2,R3,R4,R5,R6,R7, R13,R14,R16,R21,R22, R23,R24,R25,R27,R28, R29,R131,R132 | 0603 | 2 | 19
46 | 2.2 0603≤5%≥1/10W | RC0603FR-072R2L (http://www.octopart.com/search?q=RC0603FR-072R2L) | Y | R10 | 0603 | 2 | 1
47 | 35.7K 0603≤1%≥1/10W | RC0603FR-0735K7L (http://www.octopart.com/search?q=RC0603FR-0735K7L) | Y | R11 | 0603 | 2 | 1
48 | 11.5K 0603≤1%≥1/10W | RC0603FR-0711K5L (http://www.octopart.com/search?q=RC0603FR-0711K5L) | Y | R12,R91 | 0603 | 2 | 2
49 | 20K 0603≤1%≥1/10W | RC0603FR-0720KL (http://www.octopart.com/search?q=RC0603FR-0720KL) CR0603-FX-2002ELF (http://www.octopart.com/search?q=CR0603-FX-2002ELF) | Y | R15 | 0603 | 2 | 1
50 | 16.2K 0603≤1%≥1/10W | RC0603FR-0716K2L (http://www.octopart.com/search?q=RC0603FR-0716K2L) | Y | R19 | 0603 | 2 | 1
51 | 2.2K 0603≤5%≥1/10W | RC0603FR-072K2L (http://www.octopart.com/search?q=RC0603FR-072K2L) | Y | R20,R26,R49,R65,R75, R76 | 0603 | 2 | 6
52 | 12.1K 0603≤1%≥1/10W | RC0603FR-0712K1L (http://www.octopart.com/search?q=RC0603FR-0712K1L) | Y | R34 | 0603 | 2 | 1
53 | 130 0603≤1%≥1/10W | RC0603FR-07130RL (http://www.octopart.com/search?q=RC0603FR-07130RL) | Y | R39 | 0603 | 2 | 1
54 | 75 0603≤5%≥1/10W | RC0603FR-0775RL (http://www.octopart.com/search?q=RC0603FR-0775RL) CR0603-FX-75R0ELF (http://www.octopart.com/search?q=CR0603-FX-75R0ELF) | Y | R40 | 0603 | 2 | 1
55 | 4.7K 0603≤5%≥1/10W | RC0603FR-074K7L (http://www.octopart.com/search?q=RC0603FR-074K7L) CR0603-FX-4701ELF (http://www.octopart.com/search?q=CR0603-FX-4701ELF) | Y | R43,R44,R48,R53,R95, R101,R106,R107,R117, R118,R119,R124,R125, R126,R130 | 0603 | 2 | 15
56 | 1.8K 0603≤1%≥1/10W | RC0603FR-071K8L (http://www.octopart.com/search?q=RC0603FR-071K8L) CR0603-FX-1801ELF (http://www.octopart.com/search?q=CR0603-FX-1801ELF) | Y | R46 | 0603 | 2 | 1
57 | 9.1K 0603≤1%≥1/10W | RC0603FR-079K1L (http://www.octopart.com/search?q=RC0603FR-079K1L) | Y | R47,R66 | 0603 | 2 | 2
58 | 22 0603≤5%≥1/10W | RC0603FR-0722RL (http://www.octopart.com/search?q=RC0603FR-0722RL) CR0603-FX-22R0ELF (http://www.octopart.com/search?q=CR0603-FX-22R0ELF) | Y | R51,R63 | 0603 | 2 | 2
59 | 12 0805≤5%≥1/8W | RC0805FR-0712RL (http://www.octopart.com/search?q=RC0805FR-0712RL) ERJ-6ENF12R0V (http://www.octopart.com/search?q=ERJ-6ENF12R0V) | Y | R52,R54,R61,R62,R94, R100 | 0805 | 2 | 6

4

Line | Description | Part Number | Sub OK | Designators | Footprint | Pins | Quantity
60 | 120 0603≤1%≥1/10W | RC0603FR-07120RL (http://www.octopart.com/search?q=RC0603FR-07120RL) | Y | R55 | 0603 | 2 | 1
61 | 330 0603≤1%≥1/10W | RC0603FR-07330RL (http://www.octopart.com/search?q=RC0603FR-07330RL) CR0603-FX-3300ELF (http://www.octopart.com/search?q=CR0603-FX-3300ELF) | Y | R56,R59 | 0603 | 2 | 2
62 | 1K 0603≤5%≥1/10W | RC0603FR-071KL (http://www.octopart.com/search?q=RC0603FR-071KL) CR0603-FX-1001HLF (http://www.octopart.com/search?q=CR0603-FX-1001HLF) | Y | R57,R58,R67,R68,R71, R72,R73,R74,R109 | 0603 | 2 | 9
63 | 1.6K 0603≤5%≥1/10W | RC0603FR-071K6L (http://www.octopart.com/search?q=RC0603FR-071K6L) | Y | R69,R102 | 0603 | 2 | 2
64 | 27K 0603≤1%≥1/10W | RC0603FR-0727KL (http://www.octopart.com/search?q=RC0603FR-0727KL) | Y | R70,R127 | 0603 | 2 | 2
65 | 100 0603≤1%≥1/10W | RC0603FR-07100RL (http://www.octopart.com/search?q=RC0603FR-07100RL) CR0603-FX-1000ELF (http://www.octopart.com/search?q=CR0603-FX-1000ELF) AC0603FR-07100RL (http://www.octopart.com/search?q=AC0603FR-07100RL) | Y | R77,R78 | 0603 | 2 | 2
66 | 270 0603≤5%≥1/10W | RC0603FR-07270RL (http://www.octopart.com/search?q=RC0603FR-07270RL) CR0603-FX-2700ELF (http://www.octopart.com/search?q=CR0603-FX-2700ELF) | Y | R92,R99,R108,R133, R134 | 0603 | 2 | 5
67 | 0.04 1206≤1%≥1/4W | RL1206FR-070R04L (http://www.octopart.com/search?q=RL1206FR-070R04L) PE1206FRM070R04L (http://www.octopart.com/search?q=PE1206FRM070R04L) | Y | R123 | 1206 | 2 | 1
68 | 1:1 RF Transformer | AliExpress (http://www.aliexpress.com/wholesale?SearchText=MABAES0060) MABAES0060 (http://www.octopart.com/search?q=MABAES0060) PWB1010-1LB (http://www.octopart.com/search?q=PWB1010-1LB) TC1-1TG2+ (http://www.octopart.com/search?q=TC1-1TG2+) | N | T1 | SM-22-5 3.81x3.81mm | 5 | 1
69 | 8:1 RF Transformer | MABA-010143-FLUX18 (http://www.octopart.com/search?q=MABA-010143-FLUX18) WBC8-1LB (http://www.octopart.com/search?q=WBC8-1LB) | N | T2 | SM-22-5 3.81x3.81mm | 5 | 1
70 | 4:1 RF Transformer | B62152A4X30 (http://www.octopart.com/search?q=B62152A4X30) | N | T3 | Custom | 5 | 1
71 | EEPROM 2Mx8bit >40MHz | AliExpress (http://www.aliexpress.com/wholesale?SearchText=S25FL116K0XMFI041) W25Q16JVSNIQ (http://www.octopart.com/search?q=W25Q16JVSNIQ) S25FL116K0XMFI043 (http://www.octopart.com/search?q=S25FL116K0XMFI043) S25FL116K0XMFI041 (http://www.octopart.com/search?q=S25FL116K0XMFI041) | N | U1 | 8-SOIC (3.90mm) | 8 | 1
72 | FPGA | AliExpress (http://www.aliexpress.com/wholesale?SearchText=EP4CE22E22C8N) EP4CE22E22C8N (http://www.octopart.com/search?q=EP4CE22E22C8N) | N | U2 | 144-LQFP EP | 144 | 1
73 | Switching Regulator | AliExpress (http://www.aliexpress.com/wholesale?SearchText=st1s10) ST1S10PHR (http://www.octopart.com/search?q=ST1S10PHR) | N | U3,U8,U16 | 8-SOIC (3.90mm) EP | 8 | 3
74 | Gigabit EthPhy | AliExpress (http://www.aliexpress.com/wholesale?SearchText=KSZ9031) KSZ9031RNXCC (http://www.octopart.com/search?q=KSZ9031RNXCC) KSZ9031RNXCA (http://www.octopart.com/search?q=KSZ9031RNXCA) | N | U4 | 48-VFQFN EP | 48 | 1
75 | Clock Generator | 5P49V5923B000NLGI (http://www.octopart.com/search?q=5P49V5923B000NLGI) | N | U6 | 24-VFQFN EP | 24 | 1
76 | RF ADC DAC | AliExpress (http://www.aliexpress.com/wholesale?SearchText=AD9866BCPZ) AD9866BCPZ (http://www.octopart.com/search?q=AD9866BCPZ) | N | U7 | 64-VFQFN EP | 64 | 1
77 | RF Preamp OpAmp | AliExpress (http://www.aliexpress.com/wholesale?SearchText=OPA2677) OPA2677IDDA (http://www.octopart.com/search?q=OPA2677IDDA) | N | U9 | 8-SOIC (3.90mm) EP | 8 | 1
78 | RF Switch | AliExpress (http://www.aliexpress.com/wholesale?SearchText=pe4259) 4259-63 (http://www.octopart.com/search?q=4259-63) 4239-52 (http://www.octopart.com/search?q=4239-52) PE42421SCAA (http://www.octopart.com/search?q=PE42421SCAA) | N | U10,U11 | SC70-6 | 6 | 2

5

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
