softerhardware/Hermes-Lite2/hardware/hl/releases/hl2p0build7/bom.standard.pdf

## Hermes-Lite 2.0build7 BOM

Standard Build - June 19, 2018

Reference | Spec | Part No. | Supplier | SKU | Price | Qty | Total
B1,B2,B3,B4,B5,B6,
B7,B8,B9,B10,B11,
B12,B13,B14,B15,B16,
B17,B18,B19,B20,B21,
B22,B23,B24,B25,B26,
B27,B28,B29,B30,B31,
B32,B33,B34,B35,B36,
B37,B38,B39,B40,B41,
B42,B43,B44,B45,B46,
B47,B48,B49,B50,B51,
B52,B53,B54,B56,B57,
B59,B60,B61,B62,B63,
B64,B66,B68,B70,B72,
B73,B74,B75,B77,B78,
B80,B81,B83,B84,B85,
B86,B87,B88,B89,B90,
B91,B92,B94,B97,B98,
B99,B100,B101,B102,
B103,B105,B106,B108,
B109,B111,B113,B114,
B115,B116,B118,B119,
B120,B122
0.1uF 0603≥X5R≥25V≤20% | C1608X7R1E104K080AA (http://www.octopart.com/search?q=C1608X7R1E104K080AA) | Digi-Key (http://www.digikey.com) | 445-1316-1-ND (http://www.digikey.com/product-search/en?keywords=445-1316-1-ND) | 0.03 | 104 | 3.37
C1,C2,C3,C4,C6,C7, C8,C9,C12,C25,C35, C38,C39,C40,C41,C44, C45,C62,C64,C66,C70 | 10uF 0603≥X5R≥6.3V≤20% | GRM188R60J106ME47D (http://www.octopart.com/search?q=GRM188R60J106ME47D) | Digi-Key (http://www.digikey.com) | 490-3896-1-ND (http://www.digikey.com/product-search/en?keywords=490-3896-1-ND) | 0.32 | 21 | 6.78
C5,C16,C22 | 100uF 1206≥X5R≥6.3V≤20% | GRM31CR60J107ME39K (http://www.octopart.com/search?q=GRM31CR60J107ME39K) | Digi-Key (http://www.digikey.com) | 490-7217-1-ND (http://www.digikey.com/product-search/en?keywords=490-7217-1-ND) | 1.23 | 3 | 3.69
C13,C19,C27,C90,C91 | 4.7nF 0603≥X5R≥25V≤20% | CL10B472KB8NNNC (http://www.octopart.com/search?q=CL10B472KB8NNNC) | Digi-Key (http://www.digikey.com) | 1276-1098-1-ND (http://www.digikey.com/product-search/en?keywords=1276-1098-1-ND) | 0.10 | 5 | 0.50
C14,C15,C20,C21,C28, C29,C30,C31,C32,C92 | 22uF 0805≥X5R≥16V≤20% | CL21A226MOCLRNC (http://www.octopart.com/search?q=CL21A226MOCLRNC) | Digi-Key (http://www.digikey.com) | 1276-6780-1-ND (http://www.digikey.com/product-search/en?keywords=1276-6780-1-ND) | 0.23 | 10 | 2.27
C17,C23,C33,C43,C48, C86,C88 | 10uF 1206≥X5R≥25V≤20% | TMK316AB7106KL-T (http://www.octopart.com/search?q=TMK316AB7106KL-T) | Digi-Key (http://www.digikey.com) | 587-3486-1-ND (http://www.digikey.com/product-search/en?keywords=587-3486-1-ND) | 0.38 | 7 | 2.66
C18,C24,C34 | 4.7uF 0805≥X5R≥25V≤20% | GRM21BR61E475KA12L (http://www.octopart.com/search?q=GRM21BR61E475KA12L) | Digi-Key (http://www.digikey.com) | 490-3335-1-ND (http://www.digikey.com/product-search/en?keywords=490-3335-1-ND) | 0.19 | 3 | 0.57
C26,C60,C61,C63,C65, C67,C68,C69,C71,C72 | 1uF 0603≥X5R≥6.3V≤20% | CL10B105KP8NNNC (http://www.octopart.com/search?q=CL10B105KP8NNNC) | Digi-Key (http://www.digikey.com) | 1276-1946-1-ND (http://www.digikey.com/product-search/en?keywords=1276-1946-1-ND) | 0.05 | 10 | 0.47

Reference | Spec | Part No. | Supplier | SKU | Price | Qty | Total
C36,C37 | 15pF 0603NP0≥6.3V≤5% | CC0603JRNPO9BN150 (http://www.octopart.com/search?q=CC0603JRNPO9BN150) | Digi-Key (http://www.digikey.com) | 311-1060-1-ND (http://www.digikey.com/product-search/en?keywords=311-1060-1-ND) | 0.10 | 2 | 0.20
C46,C89,C144,C145, C146,C147 | 1uF 0805≥X5R≥25V≤20% | CL21A105KACLNNC (http://www.octopart.com/search?q=CL21A105KACLNNC) | Digi-Key (http://www.digikey.com) | 1276-2395-1-ND (http://www.digikey.com/product-search/en?keywords=1276-2395-1-ND) | 0.18 | 6 | 1.08
C49 | 75pF 0805NP0≥50V≤5% | C0805C750J1GACTU (http://www.octopart.com/search?q=C0805C750J1GACTU) | Mouser (http://www.mouser.com) | 80-C0805C750J1G | 0.27 | 1 | 0.27
C50 | 150pF 0805NP0≥50V≤5% | CC0805JRNPO0BN151 (http://www.octopart.com/search?q=CC0805JRNPO0BN151) | Digi-Key (http://www.digikey.com) | 311-1839-1-ND (http://www.digikey.com/product-search/en?keywords=311-1839-1-ND) | 0.15 | 1 | 0.15
C51 | 160pF 0805NP0≥50V≤5% | GRM2165C2A161JA01D (http://www.octopart.com/search?q=GRM2165C2A161JA01D) | Mouser (http://www.mouser.com) | 81-GRM2165C2A161JA1D | 0.19 | 1 | 0.19
C52,C57,C81 | 100pF 0805NP0≥50V≤5% | C0805C101J1GACTU (http://www.octopart.com/search?q=C0805C101J1GACTU) | Mouser (http://www.mouser.com) | 80-C0805C101J1G | 0.11 | 3 | 0.33
C53 | 10pF 0805NP0≥50V≤5% | CC0805JRNPO9BN100 (http://www.octopart.com/search?q=CC0805JRNPO9BN100) | Digi-Key (http://www.digikey.com) | 311-1099-1-ND (http://www.digikey.com/product-search/en?keywords=311-1099-1-ND) | 0.10 | 1 | 0.10
C56 | 180pF 0805NP0≥50V≤5% | CC0805JRNPO0BN181 (http://www.octopart.com/search?q=CC0805JRNPO0BN181) | Mouser (http://www.mouser.com) | 603-CC805JRNPO0BN181 | 0.16 | 1 | 0.16
C84 | 270pF 0805NP0≥50V≤5% | CC0805JRNPO0BN271 (http://www.octopart.com/search?q=CC0805JRNPO0BN271) | Mouser (http://www.mouser.com) | 603-CC805JRNPO0BN271 | 0.18 | 1 | 0.18
C87 | 8.2pF 0805NP0≥25V≤5% | CL21C8R2DBANNNC (http://www.octopart.com/search?q=CL21C8R2DBANNNC) | Digi-Key (http://www.digikey.com) | 1276-2697-1-ND (http://www.digikey.com/product-search/en?keywords=1276-2697-1-ND) | 0.10 | 1 | 0.10
CN1 | 2x5 M 0.1in | 67997-410HLF (http://www.octopart.com/search?q=67997-410HLF) | Digi-Key (http://www.digikey.com) | 609-3243-ND (http://www.digikey.com/product-search/en?keywords=609-3243-ND) | 0.27 | 1 | 0.27
CN2 | Power | PJ-102AH (http://www.octopart.com/search?q=PJ-102AH) | Mouser (http://www.mouser.com) | 490-PJ-102AH | 0.75 | 1 | 0.75
CN3 | Eth MagJack | L829-1J1T-43 (http://www.octopart.com/search?q=L829-1J1T-43) | Mouser (http://www.mouser.com) | 530-L829-1J1T-43 | 5.72 | 1 | 5.72
CN4 | CW Jack | SJ1-3525N (http://www.octopart.com/search?q=SJ1-3525N) | Mouser (http://www.mouser.com) | 490-SJ1-3525N | 0.76 | 1 | 0.76
D1 | TVS Diode | CDSOD323-T05LC (http://www.octopart.com/search?q=CDSOD323-T05LC) | Mouser (http://www.mouser.com) | 652-CDSOD323-T05LC | 0.82 | 1 | 0.82
D2,D3,D4,D5 | LED RA | LTST-S220KFKT (http://www.octopart.com/search?q=LTST-S220KFKT) | Mouser (http://www.mouser.com) | 859-LTST-S220KFKT | 0.23 | 4 | 0.92
D8 | TVS Diode | SM05.TCT (http://www.octopart.com/search?q=SM05.TCT) | Mouser (http://www.mouser.com) | 947-SM05.TCT | 0.62 | 1 | 0.62
D12 | TVS Diode | SMBJ18CA (http://www.octopart.com/search?q=SMBJ18CA) | Mouser (http://www.mouser.com) | 512-SMBJ18CA | 0.40 | 1 | 0.40
F1 | FUSE PTC 3.0A 24V | MF-LSMF300/24X-2 (http://www.octopart.com/search?q=MF-LSMF300/24X-2) | Mouser (http://www.mouser.com) | 652-MF-LSMF300/24X-2 | 0.80 | 1 | 0.80
FB1,FB2,FB3,FB4,FB5, FB6,FB7,FB8,FB9,FB10, FB11,FB12,FB13,FB14, FB15,FB16,FB17,FB18, FB19,FB20,FB21,FB22, FB23,FB24,FB25,FB26, FB28,FB30 | FB 0603 ≥600R@100MHz ≤200mOhm@DC 1A ≤25% | MPZ1608S601ATA00 (http://www.octopart.com/search?q=MPZ1608S601ATA00) | Digi-Key (http://www.digikey.com) | 445-2205-1-ND (http://www.digikey.com/product-search/en?keywords=445-2205-1-ND) | 0.07 | 28 | 2.00
J1,J2,J5,J9,J10,J11, J13,J15,J17,J18,J19, J21,J22,J23,J24,J25, J26,J27,J28,J29,J30, J31,J32,L33,L34 | 0Ohm 0603≤5%≥1/10W | CR0603-J/-000ELF (http://www.octopart.com/search?q=CR0603-J/-000ELF) | Mouser (http://www.mouser.com) | 652-CR0603-J/-000ELF | 0.01 | 25 | 0.20
L1,L3 | 3.3uH ≥2.4A | SRN5020-3R3M (http://www.octopart.com/search?q=SRN5020-3R3M) | Mouser (http://www.mouser.com) | 652-SRN5020-3R3M | 0.36 | 2 | 0.72
L2 | 2.2uH ≥2.4A | SRN5020-2R2Y (http://www.octopart.com/search?q=SRN5020-2R2Y) | Mouser (http://www.mouser.com) | 652-SRN5020-2R2Y | 0.36 | 1 | 0.36
L4,L7 | 240nH | LQW2BASR24J00L (http://www.octopart.com/search?q=LQW2BASR24J00L) | Digi-Key (http://www.digikey.com) | 490-5670-1-ND (http://www.digikey.com/product-search/en?keywords=490-5670-1-ND) | 0.24 | 2 | 0.48
L5,L6,L8,L9 | 270nH | LQW2BASR27J00L (http://www.octopart.com/search?q=LQW2BASR27J00L) | Digi-Key (http://www.digikey.com) | 490-5671-1-ND (http://www.digikey.com/product-search/en?keywords=490-5671-1-ND) | 0.24 | 4 | 0.96
L10,L11 | 330nH | LQW2BASR33J00L (http://www.octopart.com/search?q=LQW2BASR33J00L) | Digi-Key (http://www.digikey.com) | 490-5672-1-ND (http://www.digikey.com/product-search/en?keywords=490-5672-1-ND) | 0.24 | 2 | 0.48
Q1 | MOSFET P-CH 30V | DMP3099L-7 (http://www.octopart.com/search?q=DMP3099L-7) | Mouser (http://www.mouser.com) | 621-DMP3099L-7 | 0.34 | 1 | 0.34

Reference | Spec | Part No. | Supplier | SKU | Price | Qty | Total
Q2,Q5 | Inductive Load Driver | NUD3124LT1G (http://www.octopart.com/search?q=NUD3124LT1G) | Mouser (http://www.mouser.com) | 863-NUD3124LT1G | 0.45 | 2 | 0.90
Q3,Q4 | RF LDMOS | AFT05MS003NT1 (http://www.octopart.com/search?q=AFT05MS003NT1) | Mouser (http://www.mouser.com) | 841-AFT05MS003NT1 | 3.16 | 2 | 6.32
Q6 | Thermal Sensor | MCP9700T-E/TT (http://www.octopart.com/search?q=MCP9700T-E/TT) | Digi-Key (http://www.digikey.com) | MCP9700T-E/TTCT-ND (http://www.digikey.com/product-search/en?keywords=MCP9700T-E/TTCT-ND) | 0.26 | 1 | 0.26
R1,R41,R42,R45,R50, R64 | 33 0603≤1%≥1/10W | CR0603-FX-33R0ELF (http://www.octopart.com/search?q=CR0603-FX-33R0ELF) | Mouser (http://www.mouser.com) | 652-CR0603FX-33R0ELF | 0.10 | 6 | 0.60
R2,R3,R4,R5,R6,R7, R14,R21,R22,R23,R24, R25,R27,R28,R29,R131, R132 | 10K 0603≤5%≥1/10W | CR0603-FX-1002HLF (http://www.octopart.com/search?q=CR0603-FX-1002HLF) | Mouser (http://www.mouser.com) | 652-CR0603-FX1002HLF | 0.02 | 17 | 0.42
R10 | 2.2 0603≤5%≥1/10W | RC0603FR-072R2L (http://www.octopart.com/search?q=RC0603FR-072R2L) | Digi-Key (http://www.digikey.com) | 311-2.2HRCT-ND (http://www.digikey.com/product-search/en?keywords=311-2.2HRCT-ND) | 0.10 | 1 | 0.10
R11 | 35.7K 0603≤1%≥1/10W | RC0603FR-0735K7L (http://www.octopart.com/search?q=RC0603FR-0735K7L) | Digi-Key (http://www.digikey.com) | 311-35.7KHRCT-ND (http://www.digikey.com/product-search/en?keywords=311-35.7KHRCT-ND) | 0.10 | 1 | 0.10
R12,R91 | 11.5K 0603≤1%≥1/10W | RC0603FR-0711K5L (http://www.octopart.com/search?q=RC0603FR-0711K5L) | Digi-Key (http://www.digikey.com) | 311-11.5KHRCT-ND (http://www.digikey.com/product-search/en?keywords=311-11.5KHRCT-ND) | 0.10 | 2 | 0.20
R15 | 20K 0603≤1%≥1/10W | CR0603-FX-2002ELF (http://www.octopart.com/search?q=CR0603-FX-2002ELF) | Digi-Key (http://www.digikey.com) | CR0603-FX-2002ELFCT-ND (http://www.digikey.com/product-search/en?keywords=CR0603-FX-2002ELFCT-ND) | 0.10 | 1 | 0.10
R19 | 16.2K 0603≤1%≥1/10W | RC0603FR-0716K2L (http://www.octopart.com/search?q=RC0603FR-0716K2L) | Mouser (http://www.mouser.com) | 603-RC0603FR-0716K2L | 0.10 | 1 | 0.10
R20,R26,R49,R65,R75, R76 | 2.2K 0603≤5%≥1/10W | RC0603FR-072K2L (http://www.octopart.com/search?q=RC0603FR-072K2L) | Digi-Key (http://www.digikey.com) | 311-2.20KHRCT-ND (http://www.digikey.com/product-search/en?keywords=311-2.20KHRCT-ND) | 0.10 | 6 | 0.60
R34 | 12.1K 0603≤1%≥1/10W | RC0603FR-0712K1L (http://www.octopart.com/search?q=RC0603FR-0712K1L) | Digi-Key (http://www.digikey.com) | 311-12.1KHRCT-ND (http://www.digikey.com/product-search/en?keywords=311-12.1KHRCT-ND) | 0.10 | 1 | 0.10
R39 | 130 0603≤1%≥1/10W | RC0603FR-07130RL (http://www.octopart.com/search?q=RC0603FR-07130RL) | Digi-Key (http://www.digikey.com) | 311-130HRCT-ND (http://www.digikey.com/product-search/en?keywords=311-130HRCT-ND) | 0.10 | 1 | 0.10
R40 | 75 0603≤5%≥1/10W | CR0603-FX-75R0ELF (http://www.octopart.com/search?q=CR0603-FX-75R0ELF) | Mouser (http://www.mouser.com) | 652-CR0603FX-75R0ELF | 0.10 | 1 | 0.10
R43,R44,R48,R53,R95, R101,R106,R107,R124, R125,R126,R130 | 4.7K 0603≤5%≥1/10W | CR0603-FX-4701ELF (http://www.octopart.com/search?q=CR0603-FX-4701ELF) | Mouser (http://www.mouser.com) | 652-CR0603FX-4701ELF | 0.02 | 12 | 0.25
R46 | 1.8K 0603≤1%≥1/10W | CR0603-FX-1801ELF (http://www.octopart.com/search?q=CR0603-FX-1801ELF) | Digi-Key (http://www.digikey.com) | CR0603-FX-1801ELFCT-ND (http://www.digikey.com/product-search/en?keywords=CR0603-FX-1801ELFCT-ND) | 0.10 | 1 | 0.10
R47,R66 | 9.1K 0603≤1%≥1/10W | RC0603FR-079K1L (http://www.octopart.com/search?q=RC0603FR-079K1L) | Digi-Key (http://www.digikey.com) | 311-9.10KHRCT-ND (http://www.digikey.com/product-search/en?keywords=311-9.10KHRCT-ND) | 0.10 | 2 | 0.20
R51,R63 | 22 0603≤5%≥1/10W | CR0603-FX-22R0ELF (http://www.octopart.com/search?q=CR0603-FX-22R0ELF) | Digi-Key (http://www.digikey.com) | CR0603-FX-22R0ELFCT-ND (http://www.digikey.com/product-search/en?keywords=CR0603-FX-22R0ELFCT-ND) | 0.10 | 2 | 0.20
R52,R54,R61,R62,R94, R100 | 12 0805≤5%≥1/8W | RC0805FR-0712RL (http://www.octopart.com/search?q=RC0805FR-0712RL) | Digi-Key (http://www.digikey.com) | 311-12.0CRCT-ND (http://www.digikey.com/product-search/en?keywords=311-12.0CRCT-ND) | 0.10 | 6 | 0.60
R55 | 120 0603≤1%≥1/10W | RC0603FR-07120RL (http://www.octopart.com/search?q=RC0603FR-07120RL) | Digi-Key (http://www.digikey.com) | 311-120HRCT-ND (http://www.digikey.com/product-search/en?keywords=311-120HRCT-ND) | 0.10 | 1 | 0.10
R56,R59 | 330 0603≤1%≥1/10W | CR0603-FX-3300ELF (http://www.octopart.com/search?q=CR0603-FX-3300ELF) | Mouser (http://www.mouser.com) | 652-CR0603FX-3300ELF | 0.10 | 2 | 0.20
R57,R58,R67,R68,R71, R72,R73,R74,R109 | 1K 0603≤5%≥1/10W | CR0603-FX-1001HLF (http://www.octopart.com/search?q=CR0603-FX-1001HLF) | Mouser (http://www.mouser.com) | 652-CR0603-FX1001HLF | 0.10 | 9 | 0.90
R69,R102 | 1.6K 0603≤5%≥1/10W | RC0603FR-071K6L (http://www.octopart.com/search?q=RC0603FR-071K6L) | Digi-Key (http://www.digikey.com) | 311-1.60KHRCT-ND (http://www.digikey.com/product-search/en?keywords=311-1.60KHRCT-ND) | 0.10 | 2 | 0.20
R70,R127 | 27K 0603≤1%≥1/10W | RC0603FR-0727KL (http://www.octopart.com/search?q=RC0603FR-0727KL) | Digi-Key (http://www.digikey.com) | 311-27.0KHRCT-ND (http://www.digikey.com/product-search/en?keywords=311-27.0KHRCT-ND) | 0.10 | 2 | 0.20
R77,R78 | 100 0603≤1%≥1/10W | AC0603FR-07100RL (http://www.octopart.com/search?q=AC0603FR-07100RL) | Mouser (http://www.mouser.com) | 603-AC0603FR-07100RL | 0.10 | 2 | 0.20
R92,R99,R108,R133, R134 | 270 0603≤5%≥1/10W | CR0603-FX-2700ELF (http://www.octopart.com/search?q=CR0603-FX-2700ELF) | Mouser (http://www.mouser.com) | 652-CR0603FX-2700ELF | 0.12 | 5 | 0.60
R123 | 0.04 1206≤1%≥1/4W | RL1206FR-070R04L (http://www.octopart.com/search?q=RL1206FR-070R04L) | Digi-Key (http://www.digikey.com) | 311-.04LWCT-ND (http://www.digikey.com/product-search/en?keywords=311-.04LWCT-ND) | 0.70 | 1 | 0.70
T1 | 1:1 RF Transformer | MABAES0060 (http://www.octopart.com/search?q=MABAES0060) | Mouser (http://www.mouser.com) | 937-MABAES0060 | 2.35 | 1 | 2.35

Reference | Spec | Part No. | Supplier | SKU | Price | Qty | Total
T2 | 8:1 RF Transformer | MABA-010143-FLUX18 (http://www.octopart.com/search?q=MABA-010143-FLUX18) | Mouser (http://www.mouser.com) | 937-MABA010143FLUX18 | 3.15 | 1 | 3.15
U1 | EEPROM 2Mx8bit >40MHz | W25Q16JVSNIQ (http://www.octopart.com/search?q=W25Q16JVSNIQ) | Digi-Key (http://www.digikey.com) | W25Q16JVSNIQ-ND (http://www.digikey.com/product-search/en?keywords=W25Q16JVSNIQ-ND) | 0.60 | 1 | 0.60
U2 | FPGA | EP4CE22E22C8N (http://www.octopart.com/search?q=EP4CE22E22C8N) | Digi-Key (http://www.digikey.com) | 544-3193-ND (http://www.digikey.com/product-search/en?keywords=544-3193-ND) | 35.52 | 1 | 35.52
U3,U8,U16 | Switching Regulator | ST1S10PHR (http://www.octopart.com/search?q=ST1S10PHR) | Digi-Key (http://www.digikey.com) | ST1S10PHR (http://www.digikey.com/product-search/en?keywords=ST1S10PHR) | 1.82 | 3 | 5.46
U4 | Gigabit EthPhy | KSZ9031RNXCC (http://www.octopart.com/search?q=KSZ9031RNXCC) | Digi-Key (http://www.digikey.com) | KSZ9031RNXCC-ND (http://www.digikey.com/product-search/en?keywords=KSZ9031RNXCC-ND) | 2.89 | 1 | 2.89
U6 | Clock Generator | 5P49V5923B000NLGI (http://www.octopart.com/search?q=5P49V5923B000NLGI) | Digi-Key (http://www.digikey.com) | 800-3404-ND (http://www.digikey.com/product-search/en?keywords=800-3404-ND) | 2.80 | 1 | 2.80
U7 | RF ADC DAC | AD9866BCPZ (http://www.octopart.com/search?q=AD9866BCPZ) | Digi-Key (http://www.digikey.com) | AD9866BCPZ-ND (http://www.digikey.com/product-search/en?keywords=AD9866BCPZ-ND) | 38.59 | 1 | 38.59
U9 | RF Preamp OpAmp | OPA2677IDDA (http://www.octopart.com/search?q=OPA2677IDDA) | Digi-Key (http://www.digikey.com) | 296-33472-5-ND (http://www.digikey.com/product-search/en?keywords=296-33472-5-ND) | 5.12 | 1 | 5.12
U10,U11 | RF Switch | 4259-63 (http://www.octopart.com/search?q=4259-63) | Digi-Key (http://www.digikey.com) | 1046-1011-1-ND (http://www.digikey.com/product-search/en?keywords=1046-1011-1-ND) | 0.65 | 2 | 1.30
U12 | LDO Regulator | AP2204MP-ADJTRG1 (http://www.octopart.com/search?q=AP2204MP-ADJTRG1) | Mouser (http://www.mouser.com) | 621-AP2204MP-ADJTRG1 | 0.51 | 1 | 0.51
U13 | Slow ADC | MAX11613EUA (http://www.octopart.com/search?q=MAX11613EUA) | Mouser (http://www.mouser.com) | 700-MAX11613EUA | 1.75 | 1 | 1.75
U14 | Current Sense AMP | INA199A1DCKR (http://www.octopart.com/search?q=INA199A1DCKR) | Mouser (http://www.mouser.com) | 595-INA199A1DCKR | 0.83 | 1 | 0.83
U15 | Digital Rheostat 5K | MCP4662-502E/UN (http://www.octopart.com/search?q=MCP4662-502E/UN) | Digi-Key (http://www.digikey.com) | MCP4662-502E/UN-ND (http://www.digikey.com/product-search/en?keywords=MCP4662-502E/UN-ND) | 1.30 | 1 | 1.30
U17 | LDO Regulator | TPS73025DBVR (http://www.octopart.com/search?q=TPS73025DBVR) | Mouser (http://www.mouser.com) | 595-TPS73025DBVR | 0.69 | 1 | 0.69
U19 | LDO 10V 150mA | LP2985-10DBVR (http://www.octopart.com/search?q=LP2985-10DBVR) | Mouser (http://www.mouser.com) | 595-LP2985-10DBVR | 0.58 | 1 | 0.58
X1 | 25MHz XTAL | NX3225SA-25.000M-STD-CSR-3 (http://www.octopart.com/search?q=NX3225SA-25.000M-STD-CSR-3) | Digi-Key (http://www.digikey.com) | 644-1267-1-ND (http://www.digikey.com/product-search/en?keywords=644-1267-1-ND) | 1.09 | 1 | 1.09
X2 | 38.4MHz Osc 3.3V≤10ppm | ASTXR-12-38.400MHZ-514054-T (http://www.octopart.com/search?q=ASTXR-12-38.400MHZ-514054-T) | Digi-Key (http://www.digikey.com) | 535-13192-1-ND (http://www.digikey.com/product-search/en?keywords=535-13192-1-ND) | 2.18 | 1 | 2.18

Total Price: $160.84
Line Items: SMT:76 TH:4 Total:80
Parts: SMT:365 TH:4 Total:369
Pins: SMT:1087 TH:36 Total:1123
Do Not Include: B55 B104 B107 C42 C47 C54 C55 C58 C59 C79 C80 C82 C83 C85 C148 C149 CL1 CL2 CL3 CL4 CL5 CL6 CL7 CL8 CL10 CN7 CN8 CN9 CN10 D6 D7 DB1 DB2 DB3 DB6 DB7 DB8 DB9 DB11 DB12 DB13 DB14 DB15 DB17 DB20 DB23 DB27 J3 J4 J6 J7 J8 J12 J14 J16 J20 K2 R8 R9 R13 R16 R17 R36 R38 R60 R93 R96 R97 R98 R104 R112 R115 R117 R118 R119 R128 R129 R135 RF1 RF2 RF3 RF4 RF5 RF6 RF7 T3 X3
