softerhardware/Hermes-Lite2/hardware/enclosure/endcaps/ad5dz/dxf/front.dxf

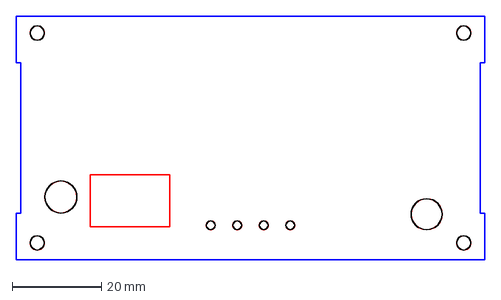
[picture p31: CAD file, 2019-08-12]
hardware/enclosure/endcaps/ad5dz/dxf/front.dxf
104.7 x 54.3 mm
