softerhardware/Hermes-Lite2/hardware/enclosure/endcaps/f4grx/front.dxf

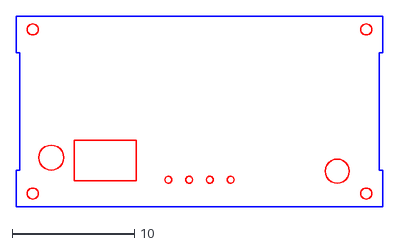
[picture p32: CAD file, 2018-06-18]
hardware/enclosure/endcaps/f4grx/front.dxf
29.9 x 15.5
