softerhardware/Hermes-Lite2/hardware/enclosure/endcaps/w3drk/HL_Front_Cover.dxf

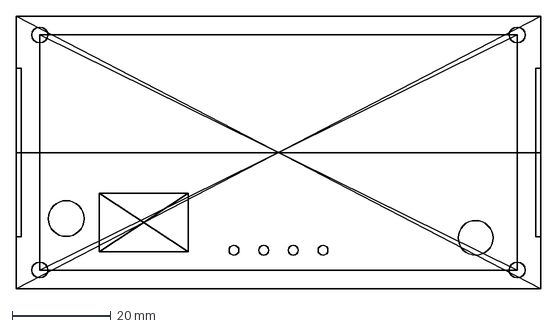
[picture p33: CAD file, 2018-06-16]
hardware/enclosure/endcaps/w3drk/HL_Front_Cover.dxf
106.0 x 55.0 mm
