softerhardware/Hermes-Lite2/hardware/enclosure/heatshim/enclosure_40mm/HL2CoolerCorrected.step

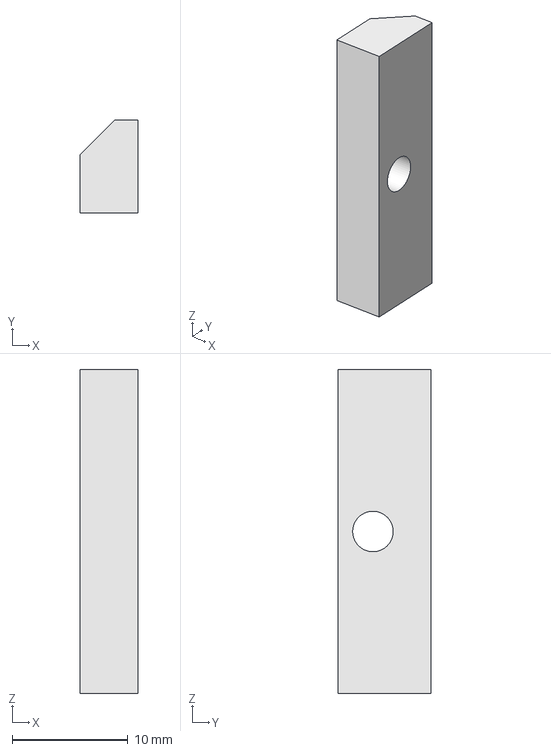
[picture p34: CAD file, 2020-11-26]
hardware/enclosure/heatshim/enclosure_40mm/HL2CoolerCorrected.step
5.00 x 8.00 x 28.0 mm
