softerhardware/Hermes-Lite2/hardware/enclosure/endcaps/ad5dz/dxf/rear.dxf

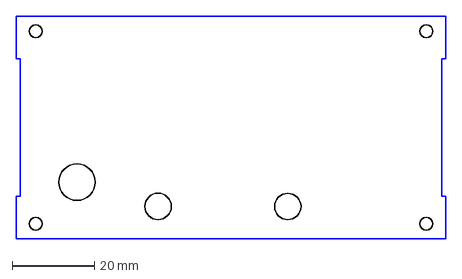
[picture p35: CAD file, 2019-08-12]
hardware/enclosure/endcaps/ad5dz/dxf/rear.dxf
104.7 x 54.3 mm
