softerhardware/Hermes-Lite2/hardware/enclosure/endcaps/f4grx/rear.dxf

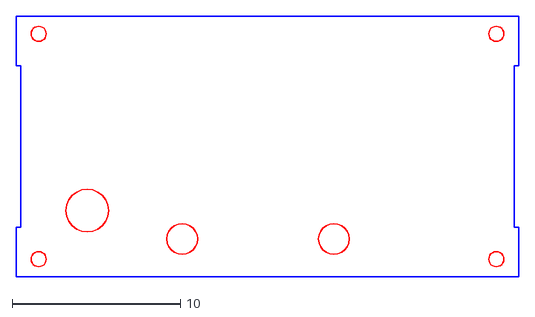
[picture p36: CAD file, 2018-06-18]
hardware/enclosure/endcaps/f4grx/rear.dxf
29.9 x 15.5
