softerhardware/Hermes-Lite2/hardware/enclosure/endcaps/w3drk/HL2_Enclosure_Front_Cap.stl

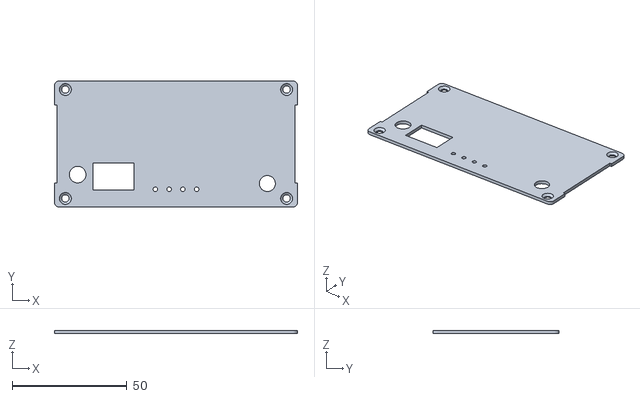
[picture p38: CAD file, 2018-05-19]
hardware/enclosure/endcaps/w3drk/HL2_Enclosure_Front_Cap.stl
106.0 x 55.0 x 1.50
