softerhardware/Hermes-Lite2/(list of files, cad)

Other CAD files:
hardware/enclosure/endcaps/w3drk/HL2_Enclosure_Rear_Cap.stl
hardware/enclosure/endcaps/w3drk/HL2_End_Caps.f3d
hardware/enclosure/heatshim/enclosure_40mm/HL2CoolerCorrected.FCStd
hardware/enclosure/heatshim/enclosure_40mm/HL2CoolerCorrected.stl
