softerhardware/Hermes-Lite2/hardware/hl/releases/hl2p0build6/hermeslite.pdf

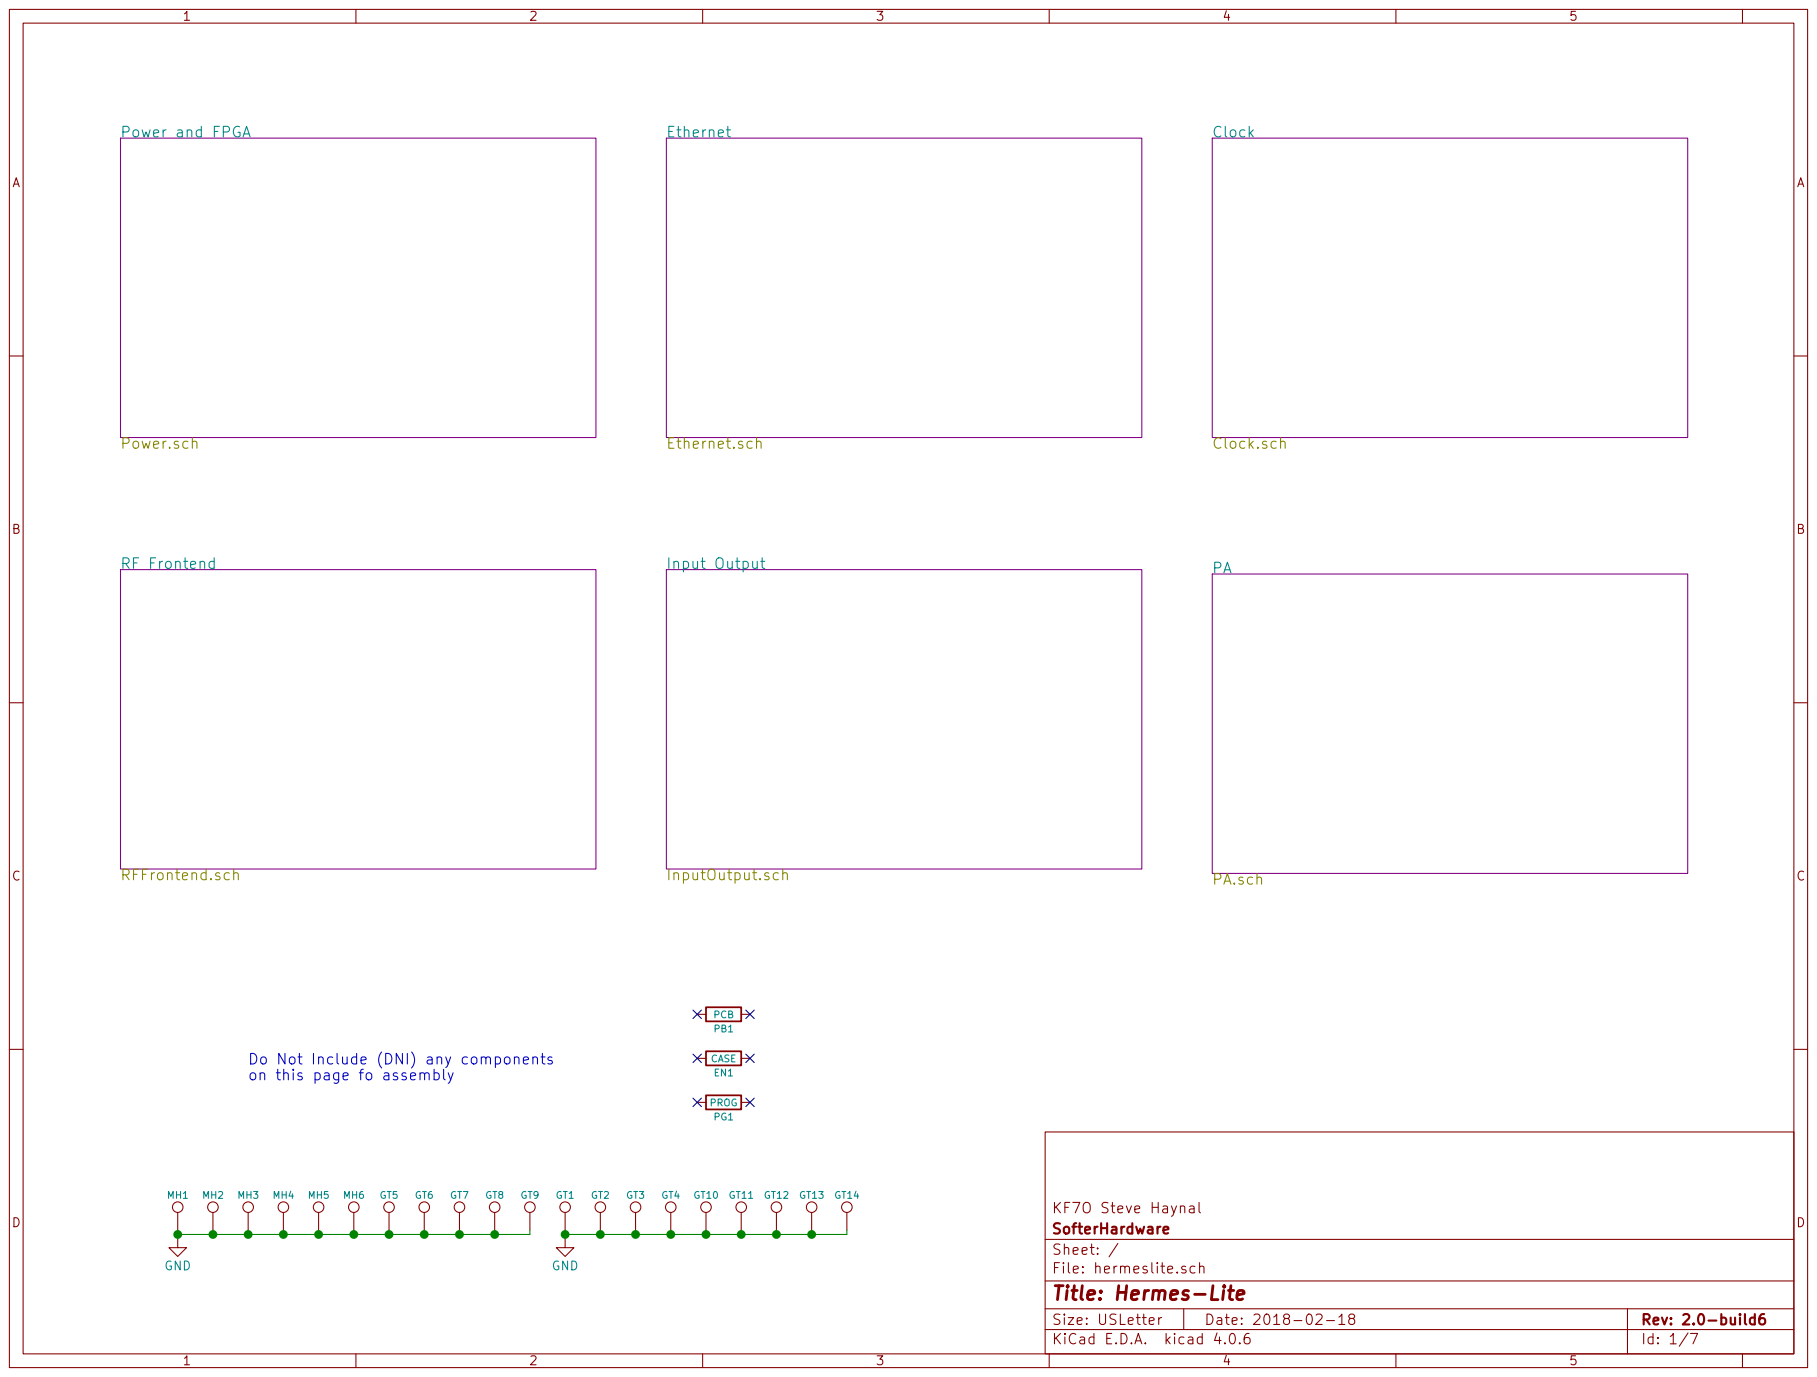
[picture p53: page 1]

Clock.sch RF Frontend RFFrontend.sch

on this page fo assembly

File: hermeslite.sch Sheet: / SofterHardware KF7O Steve Haynal

Id: 1/7 Title: Hermes-Lite

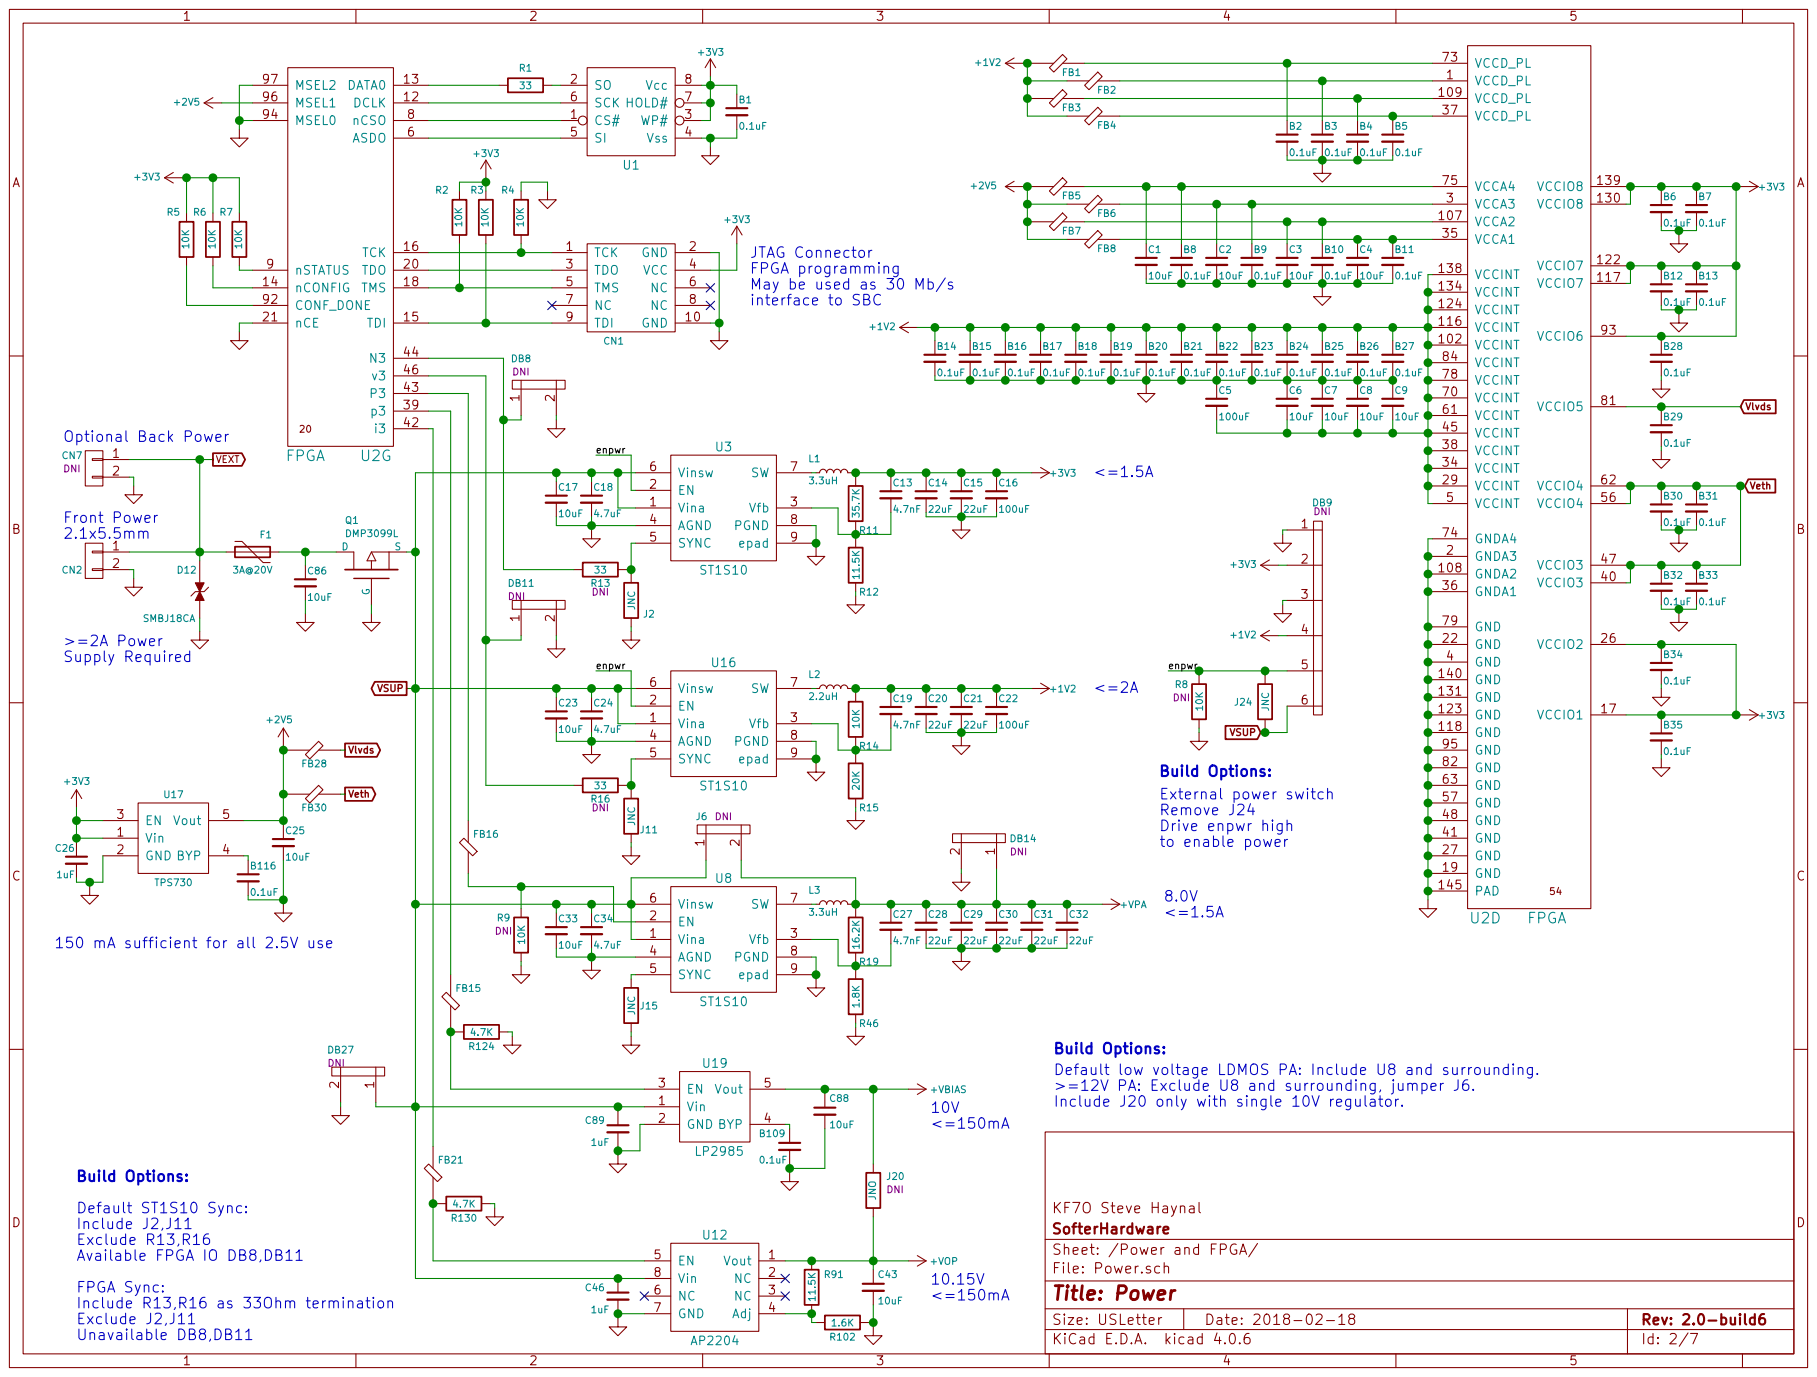
[picture p54: page 2]

FPGA programming
May be used as 30 Mb/s
interface to SBC

J15 JNC >=2A Power Supply Required

Build Options:
External power switch Remove J24 Drive enpwr high

22uF Default low voltage LDMOS PA: Include U8 and surrounding.

>=12V PA: Exclude U8 and surrounding, jumper J6.

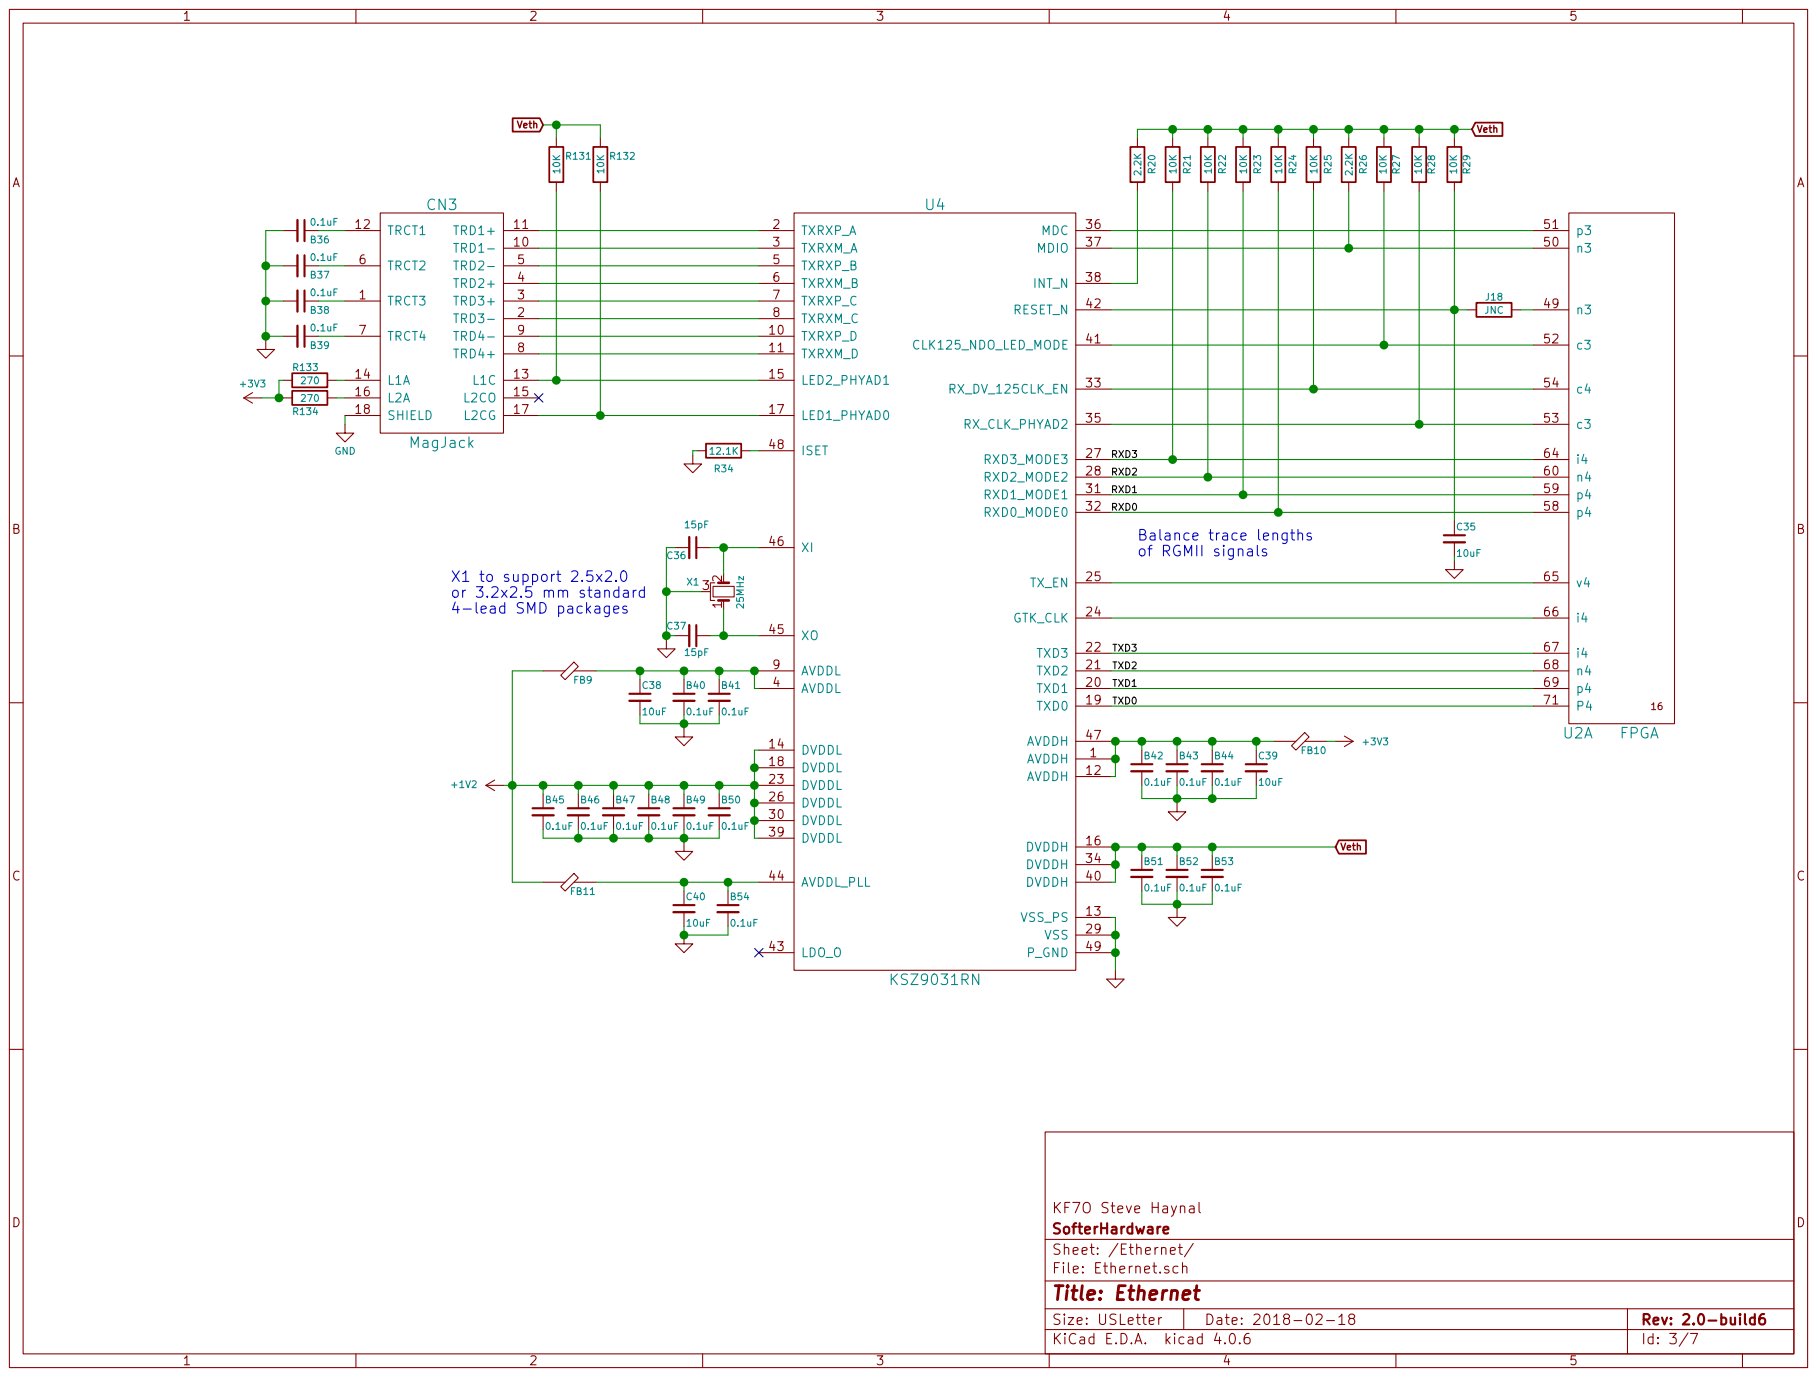
[picture p55: page 3]

i4 64
n4 60
p4 59
p4 58

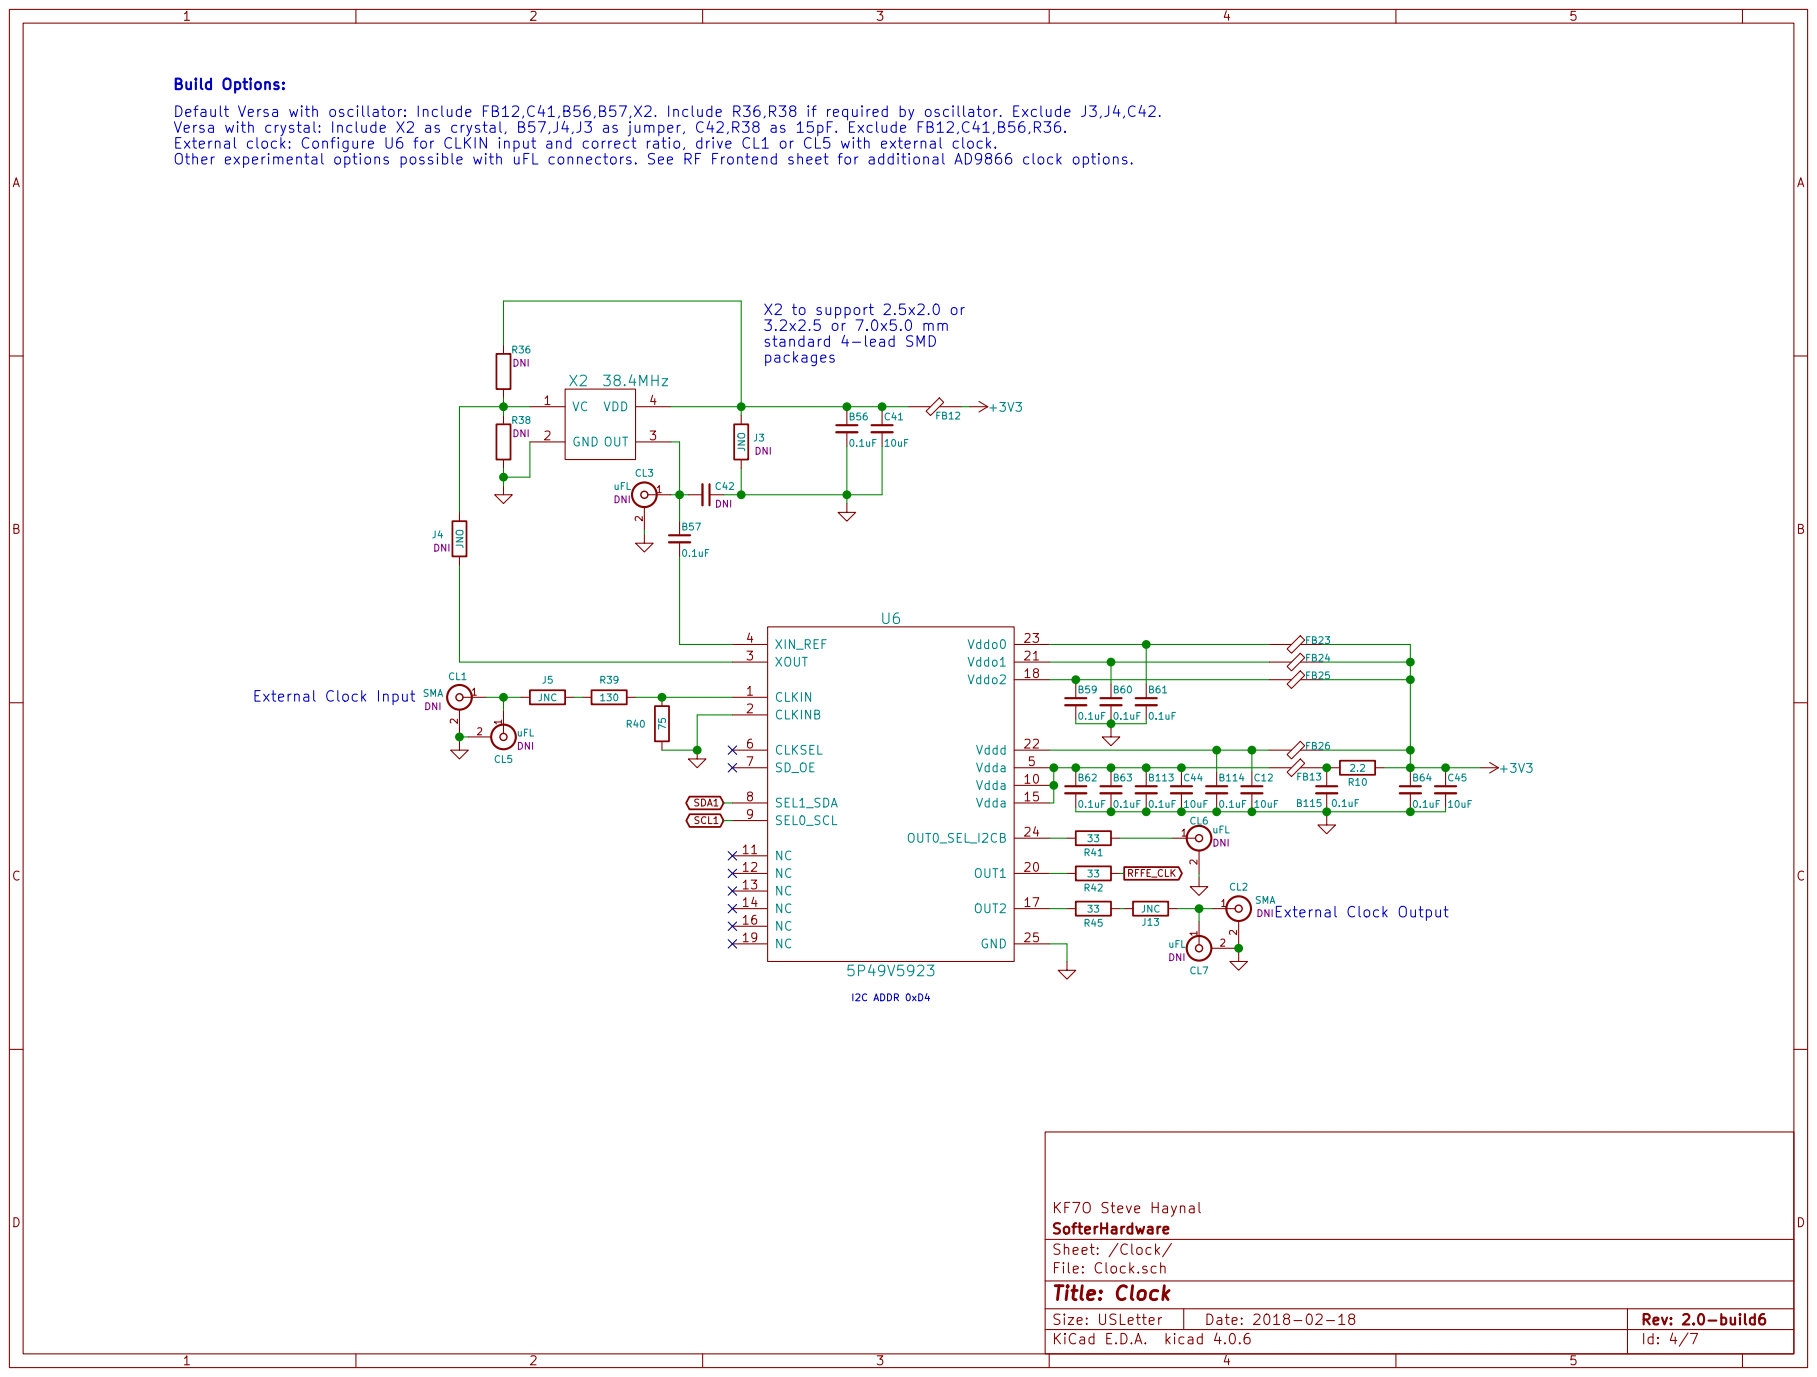
[picture p56: page 4]

Build Options:
Default Versa with oscillator: Include FB12,C41,B56,B57,X2. Include R36,R38 if required by oscillator. Exclude J3,J4,C42.
Versa with crystal: Include X2 as crystal, B57,J4,J3 as jumper, C42,R38 as 15pF. Exclude FB12,C41,B56,R36.
External clock: Configure U6 for CLKIN input and correct ratio, drive CL1 or CL5 with external clock.

10uF X2 to support 2.5x2.0 or 3.2x2.5 or 7.0x5.0 mm
standard 4-lead SMD
packages

uFL DNI External Clock Input

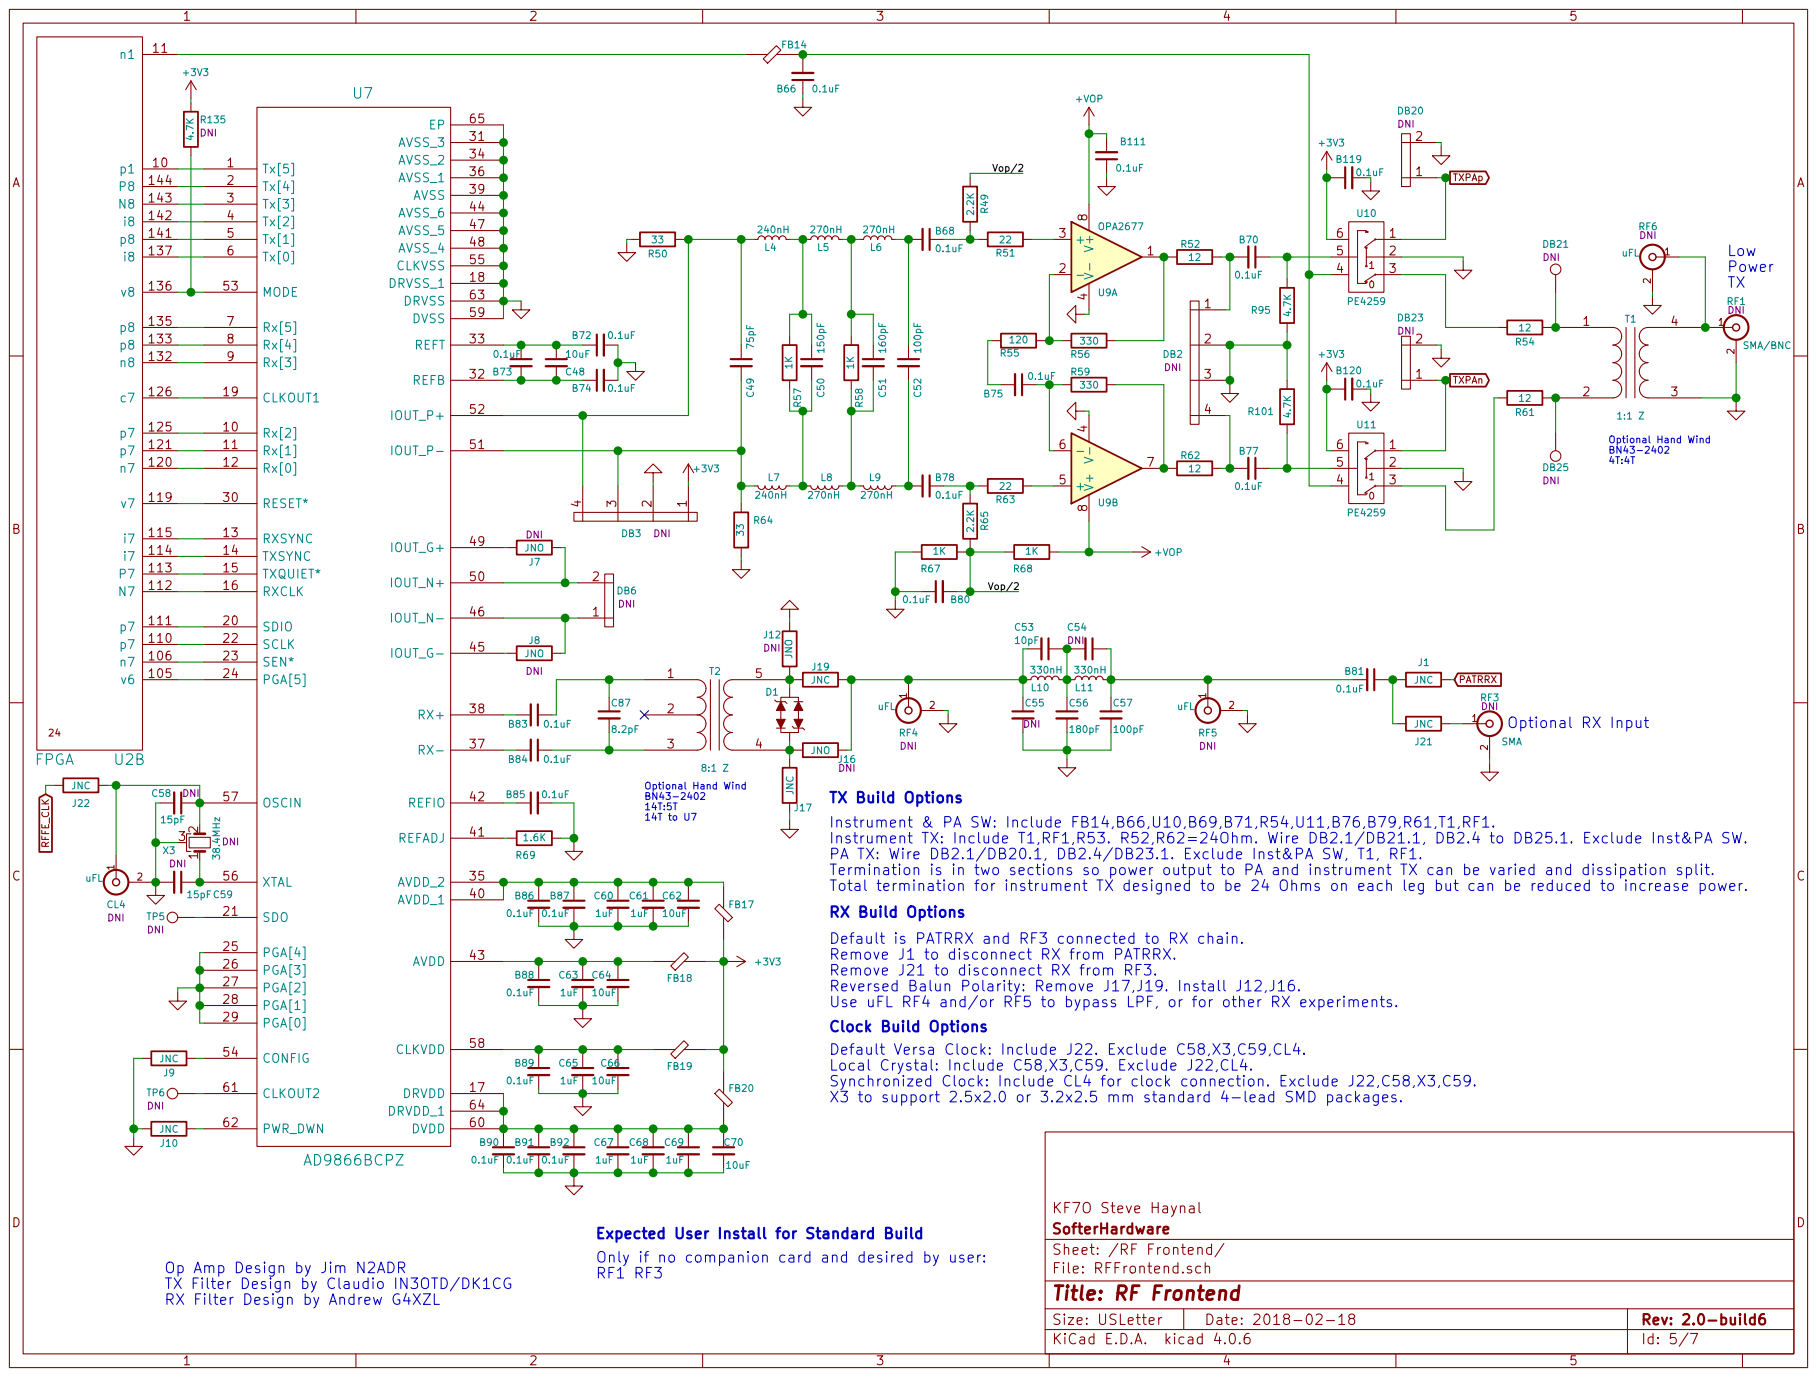
[picture p57: page 5]

2 RF3 SMA DNI Optional RX Input

J17 JNC
TX Build Options
Instrument & PA SW: Include FB14,B66,U10,B69,B71,R54,U11,B76,B79,R61,T1,RF1.
Instrument TX: Include T1,RF1,R53. R52,R62=24Ohm. Wire DB2.1/DB21.1, DB2.4 to DB25.1. Exclude Inst&PA SW.
PA TX: Wire DB2.1/DB20.1, DB2.4/DB23.1. Exclude Inst&PA SW, T1, RF1.
Termination is in two sections so power output to PA and instrument TX can be varied and dissipation split.
Total termination for instrument TX designed to be 24 Ohms on each leg but can be reduced to increase power.
RX Build Options

File: RFFrontend.sch Sheet: /RF Frontend/ SofterHardware KF7O Steve Haynal B87

Use uFL RF4 and/or RF5 to bypass LPF, or for other RX experiments.
Clock Build Options
Default Versa Clock: Include J22. Exclude C58,X3,C59,CL4.
Local Crystal: Include C58,X3,C59. Exclude J22,CL4.
Synchronized Clock: Include CL4 for clock connection. Exclude J22,C58,X3,C59.
X3 to support 2.5x2.0 or 3.2x2.5 mm standard 4-lead SMD packages.

Expected User Install for Standard Build
Only if no companion card and desired by user: RF1 RF3

TX Filter Design by Claudio IN3OTD/DK1CG
RX Filter Design by Andrew G4XZL

Id: 5/7 Title: RF Frontend

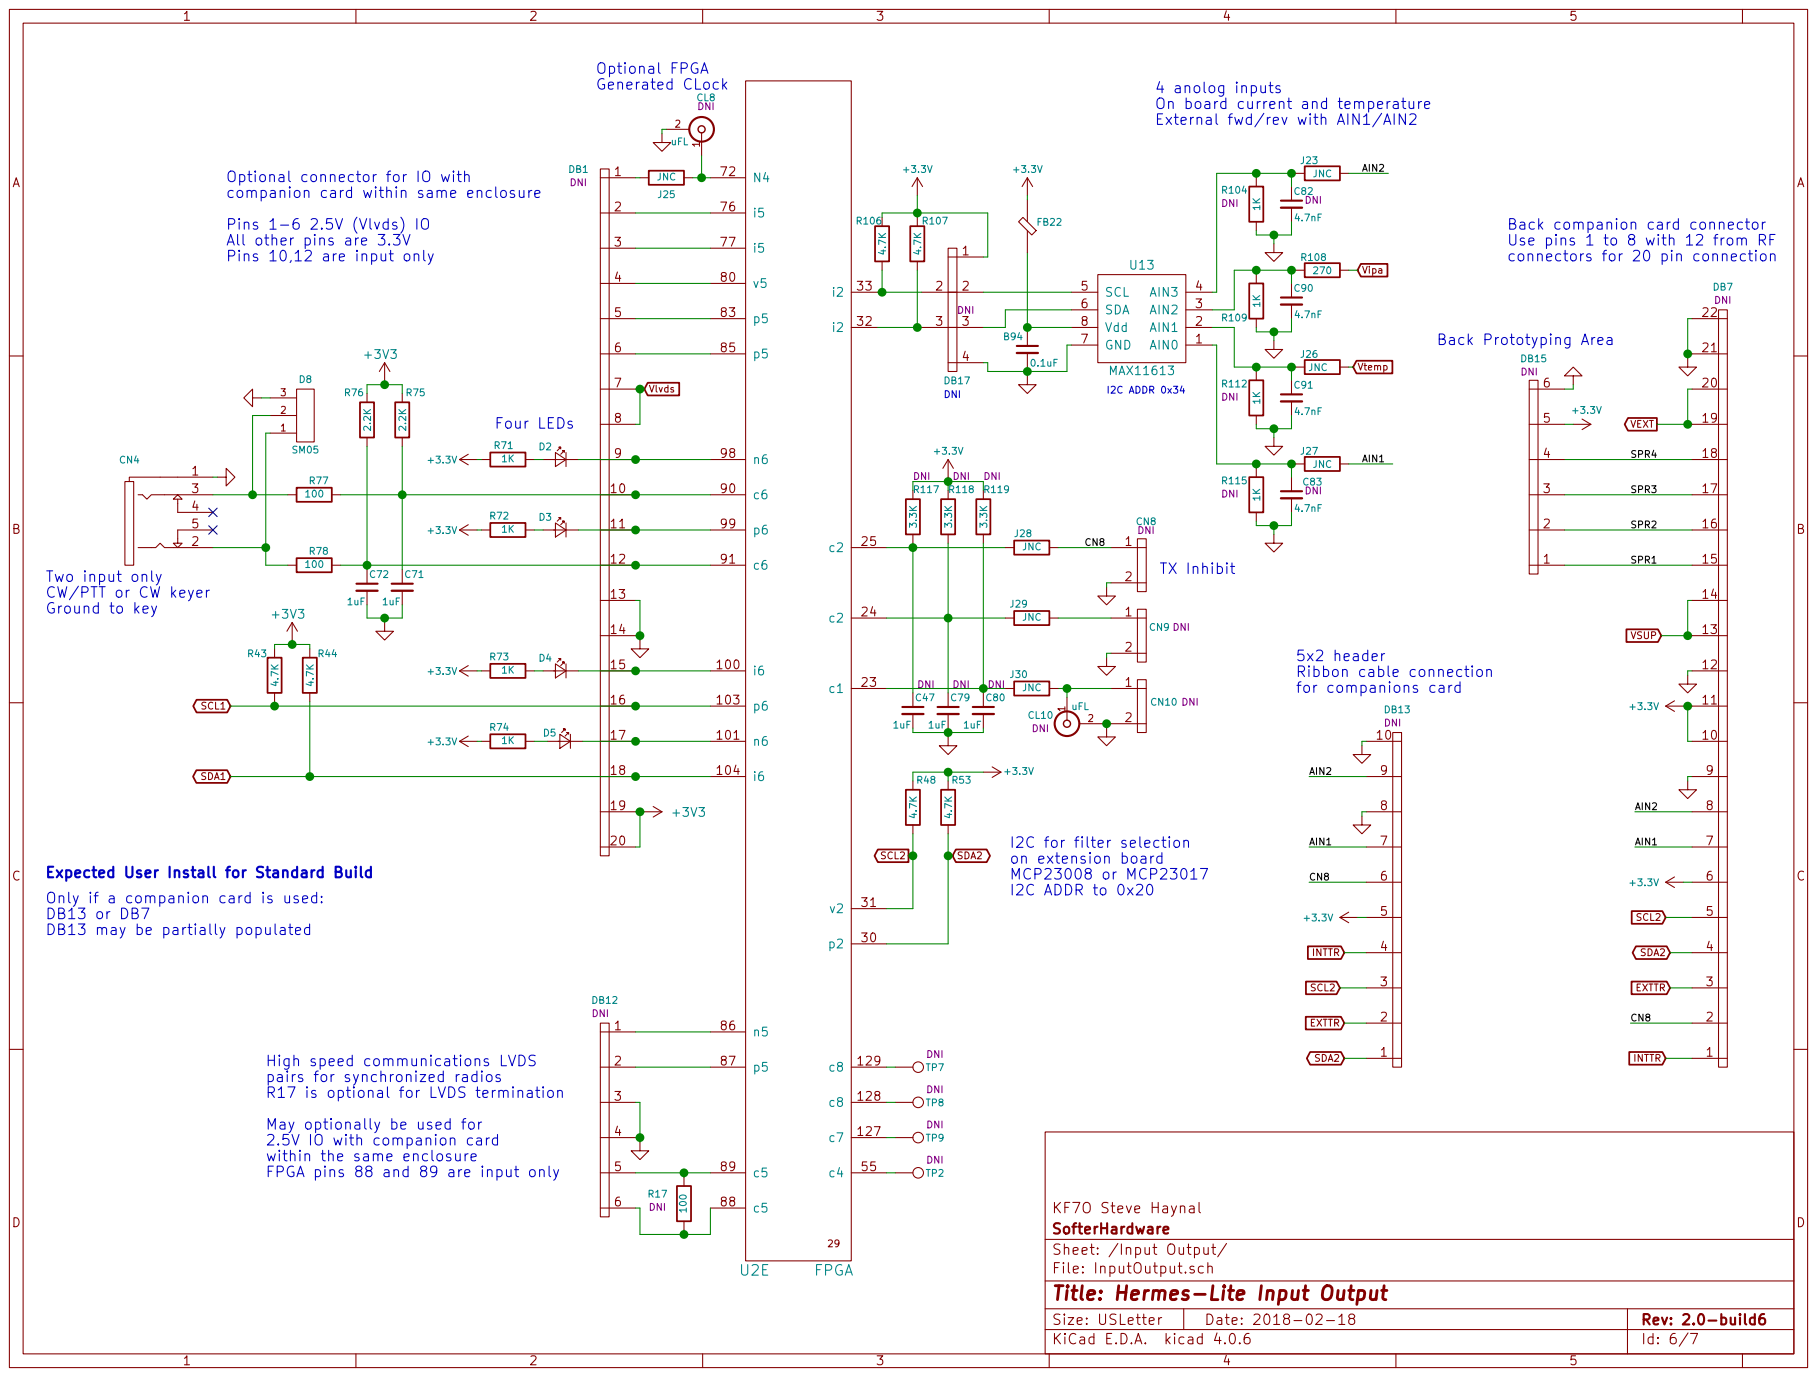
[picture p58: page 6]

4 anolog inputs
On board current and temperature
External fwd/rev with AIN1/AIN2

Optional connector for IO with
companion card within same enclosure
Pins 1-6 2.5V (Vlvds) IO
All other pins are 3.3V
Pins 10,12 are input only

Back companion card connector
Use pins 1 to 8 with 12 from RF
connectors for 20 pin connection

100 High speed communications LVDS

Two input only
CW/PTT or CW keyer
Ground to key

5x2 header Ribbon cable connection
for companions card

I2C for filter selection
on extension board MCP23008 or MCP23017
I2C ADDR to 0x20

Expected User Install for Standard Build
Only if a companion card is used: DB13 or DB7 DB13 may be partially populated

pairs for synchronized radios
R17 is optional for LVDS termination
May optionally be used for
2.5V IO with companion card within the same enclosure FPGA pins 88 and 89 are input only

Sheet: /Input Output/ SofterHardware KF7O Steve Haynal

File: InputOutput.sch
Id: 6/7 Title: Hermes-Lite Input Output

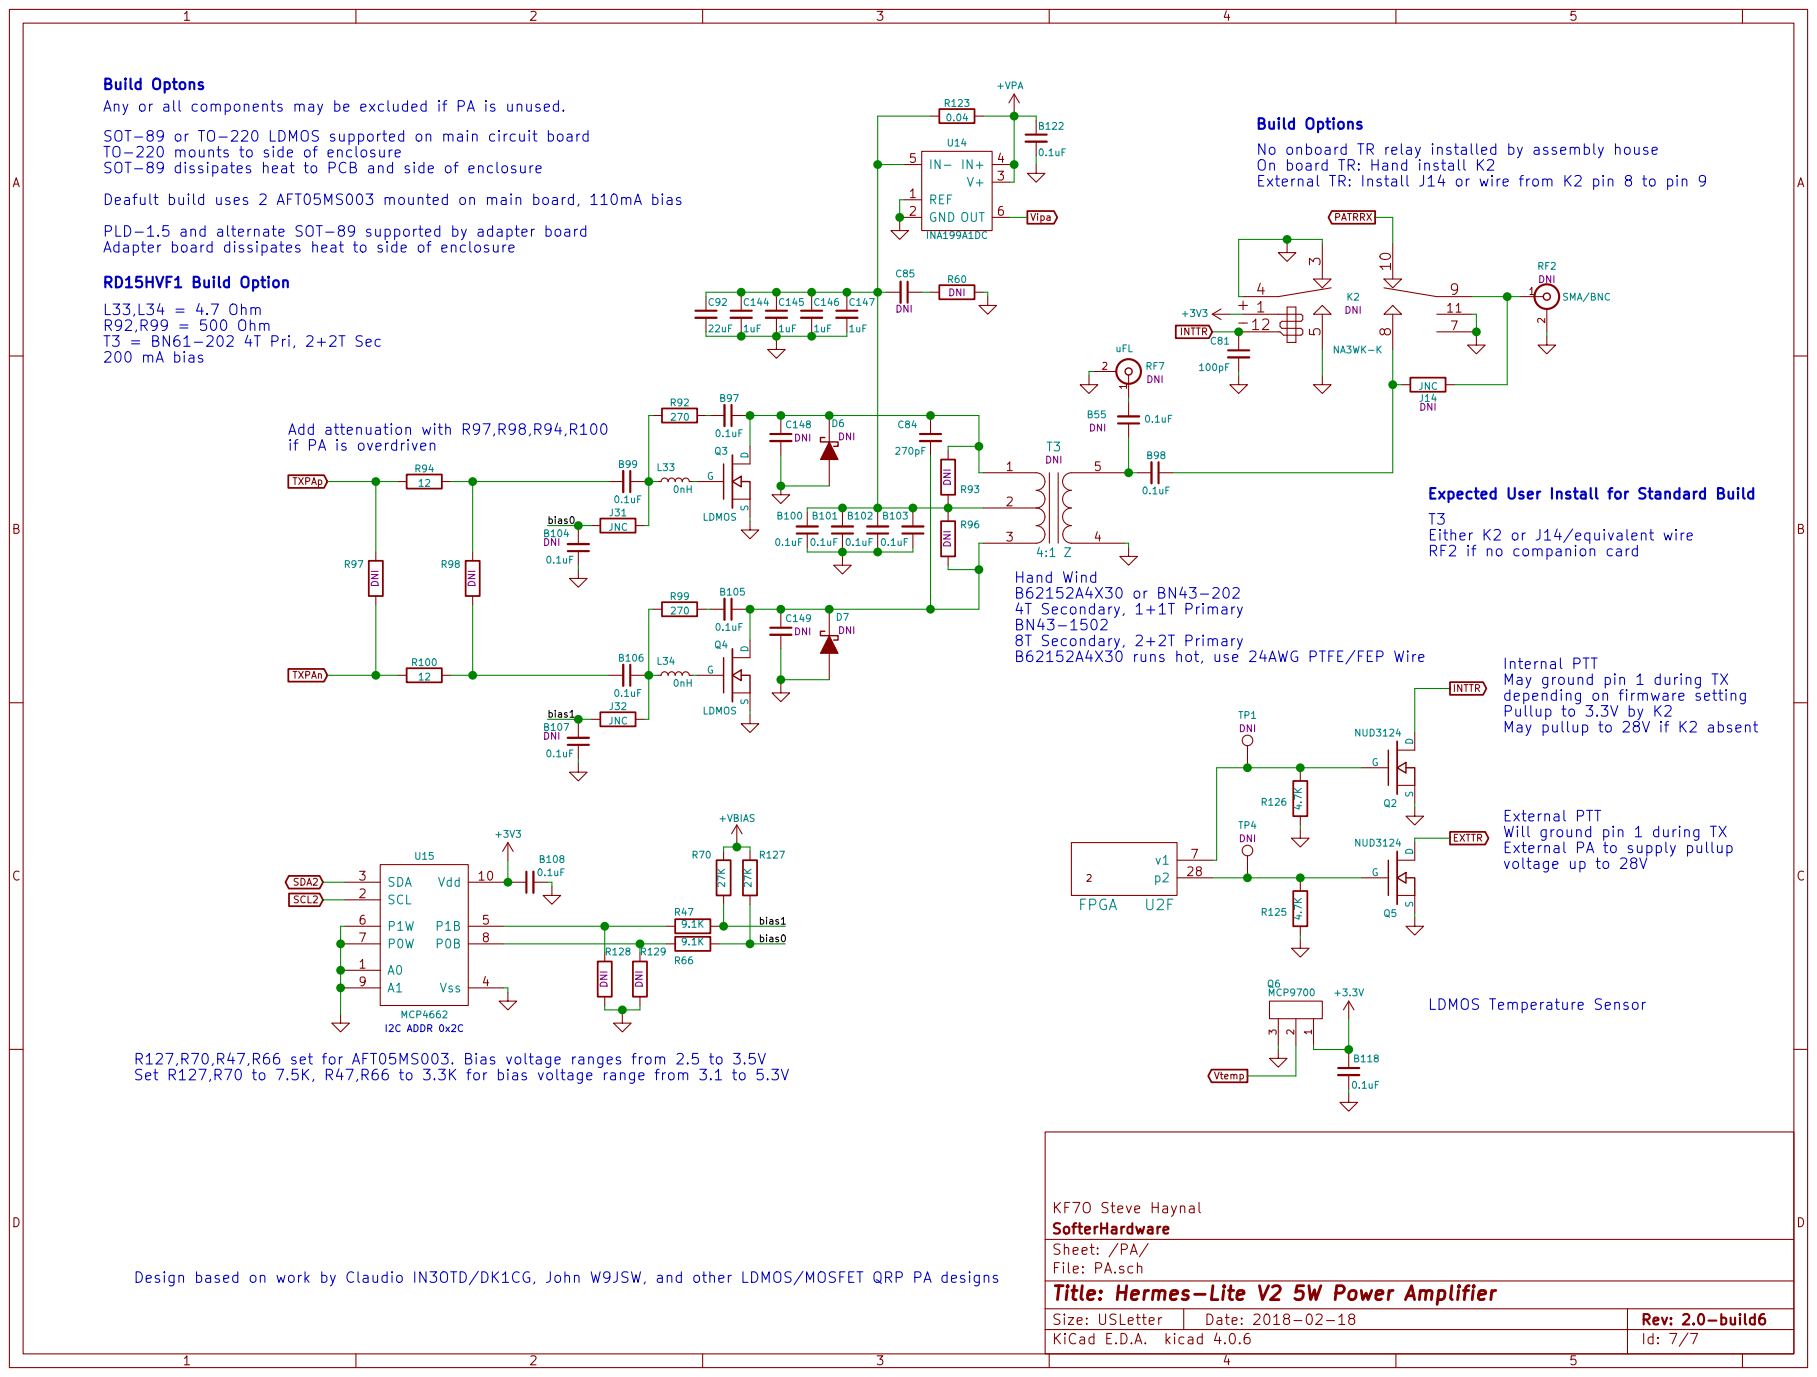
[picture p59: page 7]

Build Optons
Any or all components may be excluded if PA is unused.
SOT-89 or TO-220 LDMOS supported on main circuit board
TO-220 mounts to side of enclosure
SOT-89 dissipates heat to PCB and side of enclosure
Deafult build uses 2 AFT05MS003 mounted on main board, 110mA bias
PLD-1.5 and alternate SOT-89 supported by adapter board
Adapter board dissipates heat to side of enclosure
T3 = BN61-202 4T Pri, 2+2T Sec 200 mA bias RD15HVF1 Build Option

Build Options
No onboard TR relay installed by assembly house
On board TR: Hand install K2
External TR: Install J14 or wire from K2 pin 8 to pin 9

JNC
DNI Expected User Install for Standard Build

270pF Add attenuation with R97,R98,R94,R100
if PA is overdriven

DNI TXPAp TXPAn Design based on work by Claudio IN3OTD/DK1CG, John W9JSW, and other LDMOS/MOSFET QRP PA designs

T3Either K2 or J14/equivalent wire
RF2 if no companion card

4T Secondary, 1+1T Primary BN43-1502
8T Secondary, 2+2T Primary
B62152A4X30 runs hot, use 24AWG PTFE/FEP Wire

Internal PTT May ground pin 1 during TX
depending on firmware setting
Pullup to 3.3V by K2
May pullup to 28V if K2 absent

S D Q5 NUD3124 R125 4.7K External PTT Will ground pin 1 during TX

External PA to supply pullup
voltage up to 28V

Id: 7/7 Title: Hermes-Lite V2 5W Power Amplifier File: PA.sch Sheet: /PA/ SofterHardware KF7O Steve Haynal bias1

9.1K R127,R70,R47,R66 set for AFT05MS003. Bias voltage ranges from 2.5 to 3.5V

Set R127,R70 to 7.5K, R47,R66 to 3.3K for bias voltage range from 3.1 to 5.3V
