softerhardware/Hermes-Lite2/hardware/hl/releases/hl2p0build6/hl2top.jpg

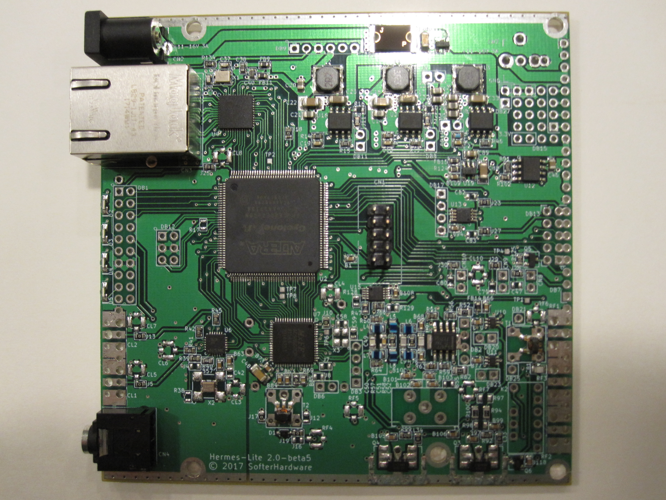
hardware/hl/releases/hl2p0build6/hl2top.jpg
