softerhardware/Hermes-Lite2/gateware/bitfiles/testing/20261025_74p3_41d75b8/README.md

Hermes-Lite 2.x Gateware
========================

## 20261025_74p3_41d75b8 Testing Release

This is a testing release for these changes:

* Fix for IP lost when ethernet cable is disconnected as discussed in [this thread](https://groups.google.com/g/hermes-lite/c/Kl3wbTzMy-8)

This test release contains only the RBF files for main variant hl2b5up_main 

See the [gateware](https://github.com/softerhardware/Hermes-Lite2/wiki/Updating-Gateware) wiki page for more details on how to update the gateware. Most people will use the file root and suffix in bold below, hl2b5up_main.rbf, for programming over ethernet.

### Variants

* **hl2b5up_main - Main gateware for Hermes-Lite 2.0 build5 and later** Includes all programming file types. This is what most people will use. Use the hl2b5up_main.rbf file for network update with Quisk, SparkSDR or hermeslite.py.
* variants/hl2b3to4_main - Main gateware for Hermes-Lite 2.0 beta3 or beta4. Includes all programming file types.
* variants/hl2b2_main - Main gateware for Hermes-Lite 2.0 beta2. Includes all programming file types.
* variants/hl2b5_cicrx - 10RX only gateware for Hermes-Lite 2.0 build5 and later. This only supports 192kHz receivers. This uses only CIC filters and consequently only about 70kHz of the spectrum is usable. This is for multiband skimming.
* variants/hl2b3to4_cicrx - 10RX only gateware for Hermes-Lite 2.0 beta3 or beta4. This only supports 192kHz receivers. This uses only CIC filters and consequently only about 70kHz of the spectrum is usable. This is for multiband skimming.
* variants/hl2b5up_ak4951v3 - AK4951V3 companion board gateware for Hermes-Lite 2. build5 and later. ATU is not supported.
* variants/hl2b5up_ak4951v4 - AK4951V4 companion board gateware for Hermes-Lite 2. build5 and later. ATU is supported. Do not use AK4951V4 gateware with AK4951V3 companion board.

### File Types

* **.rbf - Raw binary format for programming over ethernet using openhpsdr protocol 1**
* .jic - Nonvolatile EEPROM programming with Quartus
* .sof - Volatile FPGA-only programming with Quartus
* jic.jam - Nonvolatile EEPROM programming with JAM/STAPL player as used in the Raspberry Pi setup image
* sof.jam - Volatile FPGA-only programming with JAM/STAPL player as used in the Raspberry Pi setup image
* .svf - Volatile FPGA-only programming with urjtag or openocd

If your HL2 does not yet have gateware which supports network gateware updates and only a .rbf file is provided for your desired variant, first update to the main gateware and then update to your variant.
