softerhardware/Hermes-Lite2/(threads)

Thread 1 (2016-12-30):

Hardware: Wrong voltage for 1.2V supply

softerhardware, 2016-12-30:
Some schematics out in the wild have an incorrect voltage divider (swapped resistor values) for the 1.2V power supply. R14 should be 10K and R15 should be 20K. R14 is the resistor in parallel with C19.

jimahlstrom, 2016-12-31:
On the KiCad schematic in Hermes-Lite2/hardware/hl the value of R14 is 10K, and R15 is 20K.  But in the printed circuit board editor, the values are reversed.  It is necessary to create a new netlist and read it into the board editor.  Then create a new BOM.  I can try this if I have permission.

softerhardware, 2017-01-01:
I have custom Python scripts that generate the BOMs in a different way directly from the schematics. I just need to update all files eventually.

jimahlstrom, 2017-01-01:
There are a number of small PCB changes (labels, etc.) in these Open Issues.  Do you want me to make them and push them to github, or do you want to make them yourself?

softerhardware, 2017-01-02:
I am happy if you make these changes. I do not want give commit privileges to others yet for HL2. (HL1 and HL2 are separate repositories.) It is under active development, and just like what is done with Linux, I want to review all accepted patches. Please create a fork and then issue a pull request for the changes you think should be in my repository. See https://help.github.com/articles/creating-a-pull-request-from-a-fork/ Please make more smaller commits to your github rather than fewer large commits as that will make it easier to pull in changes. I will try to do the same to make merges easier for you too.

In my mind, a successful open source project accept patches from others, but has a gatekeeper that reviews patches, even when they come from skilled and qualified contributors. I've seen too many open source projects devolve into a buggy bowel of spaghetti because everyone is given commit privileges.

Sometimes a fork overtakes the original repository because the fork developer is more active, does better work, or has better ideas and goals. I am totally fine with that if it happens.

jimahlstrom, 2017-01-02:
Perfectly fine with me.  I will fork and issue a pull request.  My git is a little weak, so if I am doing it wrong, please advise.  Meanwhile just assume I am working on all PCB issues.

jimahlstrom, 2017-01-02:
Posted here in case someone else wants to work on the PCB.

Without any PCB changes, I made a new hermeslite.net file on my Linux KiCad version 4.0.2.  Your version was made on Windows KiCad 4.0.4.  The files seem totally different because of the difference in line endings between Windows and Linux.

So I made a new hermeslite.net on Windows KiCad 4.0.5.  Now the line endings agree but the new version wants to update the obsolete library files.  I could use 4.0.5 but I am not sure your 4.0.4 will read the new files.

To make things simple, anyone working on the PCB must be using the same operating system and the same version of KiCad.  I don't have your version of KiCad 4.0.4 and I don't know where to download it, as the new 4.0.5 is on the download page.

I am happy to switch to Windows, but either you must upgrade to 4.0.5 or I must find the install file for 4.0.4.  That way, there should be no confusing differences in the files, and the only difference should be the result of actual changes.  And it will be easy to compare the original and changed branches.

softerhardware, 2017-01-03:
I switch back and forth between using 4.05 on Linux and 4.04 on Windows without issues. The KiCAD databases/files are compatible when just the minor version number changes. KiCAD can handle the files with or without the Windows control-M at the end of lines. There are also the Linux utilities dos2unix and unix2dos to clean this up. These utilities are also available with Cygwin when using Windows. I will upgrade my Windows install to 4.0.5. You can find the Windows install at http://kicad-pcb.org/download/windows/

jimahlstrom, 2017-01-03:
Glad to hear you are set up for dual boot, and able to sort out line end problems.  Another handy command with Ubuntu is:
git difftool --tool gvimdiff origin/master rtl/receiver.v
The gvimdiff tool is immune to line ends, and you can change the last two file arguments or omit them.

I will carry on on Linux with KiCad 4.0.2 if that is OK with you.

softerhardware, 2017-01-10:
I had switched the values of R14 and R15, but didn't generate a netlist. You switched them back. I just switched them again and updated the netlist. Also, in the schematics, I don't like to use the hermeslite-cache library as that is problematic, so removed it.

jimahlstrom, 2017-01-10:
The schematic and PCB have correct values for R14 and R15.  But the BOM is incorrect.  I tried to run your code to create the BOM but it failed because some imports were missing.  Please run the BOM code, as it depends on the netlist file.

softerhardware, 2017-01-11:
I updated the BOM pdfs. If you like, you can grab missing packages with "pip install <package name>." LaTeX is also required to create the pdf.

Closed 2017-01-10.

Thread 10 (2016-12-30):

Hardware: FPGA EEPROM on some BOMs is too wide

softerhardware, 2016-12-30:
The FPGA EEPROM U1 on some BOMs is specified as the wide package. The footprints on the PCB expects 3.9mm width. All BOMs in circulation should be updated.

jimahlstrom, 2017-01-10:
The part number on the BOM is incorrect.  It should be S25FL116K0XMFI041.  In the last four characters, the "I" (eye) is the temperature grade, "04" is the narrow 3.9 mm width, and "1" means tube packaging.  Mouser doesn't stock this, but they have the better temperature "A" part with Mouser number 727-S25FL116K0XMF040 for $1.36.  Digikey stocks S25FL116K0XMFI041 with Digikey part number 1274-1106-ND for $0.53.

I do not know how your database BOM files work, so I can't change this myself.

softerhardware, 2017-01-11:
Please add any alternate new part numbers to Hermes-Lite2/hardware/hl/bom/parts.json. This is a text file. If you look for "C 270pF 0805" in this file, you will see that there is a list "mpn" associated with it of part numbers. You can just add new part numbers to this list. The requirement is that the part number yields a valid result on www.octopart.com. Once the new parts are in place, they will be picked up and possibly used the next time I generate a BOM.

jimahlstrom, 2017-01-11:
I didn't change anything, but the "I041" part number is now correct in parts.json.

softerhardware, 2017-05-25:
Corrected.

Closed 2017-05-25.

Thread 11 (2016-12-30):

Hardware: Oscillator X2 footprint is very tight

softerhardware, 2016-12-30:
The primary X2 on the BOM has 6 pins. Only the 4 outer pins are used and the 2 inner pins are no connect. The footprint is such that it is easy to short one of the outer pins with an inner pin. Adjust the footprint to make this less likely. Also, the primary X2 has no pads that wrap around the edge for easy hand soldering. I resorted to hot air for this (which worked well). The current X2 is preferred as it is the most stable. Consider specifying/recommending a 4-pin variant also on the BOM for any hand builds.

jimahlstrom, 2017-01-05:
I am working on this.

jimahlstrom, 2017-01-09:
The footprint for X2 supports multiple packages.  A useful trick is to place all the manufactures' recommended footprints for various packages on the bottom, and then draw a footprint on the top that accommodates them all.  When the top is done, delete the bottom footprints.

There doesn't seem to be a way to specify a keepout on a footprint, so KiCad will try to flow ground copper under X2.  You must draw the keepout on the PCB every time the X2 footprint is used.

Closed 2017-01-10.

Thread 12 (2016-12-30):

Hardware: Add alternates to BOM

softerhardware, 2016-12-30:
The current BOM only includes the preferred part for any line item. There are more alternatives in the master database. These should be exposed in the BOM so that builders can better see and understand the options.

jimahlstrom, 2017-04-05:
The commercial receive transformer T2 is:
    MABA-010143-FLUX18
The commercial transmit transformers for T1 are:
    CoilCraft PWB1010-1LB
    MABAES0060 from Mouser
    ETC1-1T
    Mini Circuits TC1-1TG2+
The above parts were discussed on newsgroup "Commercial Transformers" on March 14, 2017.

daniestevez, 2017-04-11:
Low priority: The EEPROM part for U1 (S25FL116K0XMFI041) in the BOM should be replaced by an equivalent part. I just received notification from Digikey that this particular part reaches its end of life.

softerhardware, 2017-06-20:
I considered this but don't have room in the pdf. I or other users can always generate a new BOM with alternatives using the scripts.

Closed 2017-06-20.

Thread 13 (2016-12-30):

Hardware: Solder stencil support

softerhardware, 2016-12-30:
The current PCB has some footprints with invalid openings for the solder stencil. All footprints need to be reviewed and valid solder stencil footprints verified, corrected or created. For example, larger ICs will have a grid of openings, but beta2 footprints have just a single large opening. This is required for any sort of mass production.

softerhardware, 2017-06-28:
The PCB assembly house may make there own based on the gerbers and their desires.

softerhardware, 2019-02-11:
Added to build7, thanks to group member.

Closed 2019-02-11.

Thread 14 (2016-12-30):

Hardware: Standalone KiCAD support

softerhardware, 2016-12-30:
The HL2beta2 KiCAD files still depend on a few components in the KiCAD libraries. Sometimes these libraries change or are hard to install for a user. Any external library dependencies should be copied into the hermes lite libraries so that KiCAD files are more portable, not subject to library changes, and easier for users to setup.

softerhardware, 2017-05-25:
Latest beta3 schematic is standalone. All components are in the local hermeslite library.

softerhardware, 2017-06-28:
Both PCB and schematic editor are standalone. Design was done with KiCAD 4.0.6.

Closed 2017-06-28.

Thread 17 (2016-12-30):

Firmware: Sync HL2 Ethernet RTL with latest openHPSDR version

softerhardware, 2016-12-30:
The HL2 ethernet RTL forked from the openHPSDR version over a year ago. It is now quite different to support the old protocol and we can't just switch to what openHPSDR has. All changes made to the openHPSDR since we forked should be reviewed and incorporated into the HL2 version if of value.

jimahlstrom, 2017-01-01:
Does anyone have a URL for Phil's current Ethernet code?  Does this code use the same MAC as HL2?

softerhardware, 2017-01-02:
I always have to ask Phil for the latest RTL. Last time I asked, I didn't get around to merging it into our branch. Before asking him again, I want to be sure that I am ready and will merge his changes soon.

I forked from Phil's new ethernet MAC more than a year ago. The new MAC does not support the old protocol. The changes we made to this MAC was to support the old protocol and fix a few bugs. The HL2 MAC and Phil's new MAC are now different enough that you can not take the latest from Phil and plug it into any HL RTL and have it work. Phil may have fixed some other bugs and added support for 100 Mb/s since we forked which I would like to merge back into the HL2 repository.

jimahlstrom, 2017-01-09:
I got a new ./Ethernet directory from Phil because we are working on the DHCP renewal.  We have new DHCP code in the files Ethernet/dhcp.v and Ethernet/network.v.  These two files are now in Hermes-Lite/rtl/Ethernet and (I think) can be directly moved to HL2.

softerhardware, 2017-01-10:
Great! Can you e-mail me a copy?

softerhardware, 2017-05-25:
Check done in early Jan. Not much difference. Now openhpsdr supports 100mb so another check should be done.

softerhardware, 2018-02-18:
Check done in January 2018. Incorporated some DHCP enhancements from Jim. With 1000/100 autosense, we are now quite different and more enhanced then the main branch.

Closed 2018-02-18.

Thread 18 (2016-12-30):

Firmware: Support for i2c programming of clock and PA bias

softerhardware, 2016-12-30:
As a first step, create a bit file that properly programs the i2c clock generator.

As a longterm solution, add support for a wishbone communication structure to all i2c and spi clients so that they can be accessed via software over a ethernet connection sidechannel.

jimahlstrom, 2017-01-01:
I looked up "Wishbone" on wikipedia.  Interesting.  But it is easier to extend the Hermes PC to HPSDR protocol by using the C0 indexes from 18 to 127 that are currently unused.  For example, we need a way to specify the frequency of the second clock output of the VersaClock.

softerhardware, 2017-01-02:
Wishbone is part of www.opencores.org. I work with a lot of RTL in may day job, and there are certain design patterns that lead to RTL that is maintainable, sharable, learnable, less buggy, etc. One of those is abstraction of IP blocks and a standard mechanism (bus) for communication. This is lacking in the current inherited hermes-lite RTL. A wishbone bus provides this.

I do not want to simply extend the protocol because most people are not using software that natively supports the Hermes-Lite like Quisk or Spark SDR. They are using PowerSDR. By adding a side channel to make Hermes-Lite features, people can continue using PowerSDR with support for Pure Signal. On a side note, Quisk could use Warren Pratt's wdsp library and implement pure signal too.

My goal is to have everything memory mapped. For example, to specify the second clock output of the VersaClock, the software will read and write memory locations that correspond to a remapped range of the VersaClock IC's native memory map. The software will program with the native VersaClock interface. There will be no abstraction in the RTL that takes a frequency and converts this to VersaClock interface commands. This leads to simpler and smaller RTL, and more flexibility for the software.

I have thought about and am open to extending the current Hermes protocoal (via C0 indices fro 18 to 127, etc.) to pack memory map read and write commands into the existing protocol. This would allow software targeting the Hermes-Lite to have just one communication mechanism. The RTL would support both paths, side channel and packed in original protocol, to support PowerSDR and other software users.

jimahlstrom, 2017-01-02:
All this sounds good to me.

As you know, it is hard to make a "universal protocol" for hardware you don't have yet.  The current Old Hermes protocol is full of peculiar bits of data for old hardware which will probably never be used again.  But it lacks anything like the 2nd output of VersaClock.  This is a tough problem.

softerhardware, 2017-05-25:
Wishbone bus in use for AD9866 and I2C peripherals. Clock, bias and slow ADC i2c in place. Need to combine clock and bias I2C controllers to save space in the FPGA.

softerhardware, 2018-05-19:
Switched to cmd bus with ack and AXI4-ST for stream traffic.

Closed 2018-05-19.

Thread 19 (2016-12-30):

Firmware: Port VNA support in HL1.22 to HL2

softerhardware, 2016-12-30:
The current HL2 RTL forked before Jim added better VNA support. Backport Jim's changes into HL2.

jimahlstrom, 2016-12-31:
I will do this as soon as I have the RTL and a working board.

softerhardware, 2019-02-11:
Jim Ahlstrom, N2ADR, has done this. VNA suppot works in Quisk.

Closed 2019-02-11.

Thread 2 (2016-12-30):

Hardware: Improve power supply labels

softerhardware, 2016-12-30:
Label VPA+ with target 9.44V on schematic.
Label input power supply requirements and +/- on PCB silkscreen.

jimahlstrom, 2017-01-05:
I am working on this.

jimahlstrom, 2017-01-10:
I think these changes were merged, so this issue should be closed too.

Closed 2017-01-11.

Thread 20 (2016-12-30):

Hardware: Measure and document proper current consumption in HL2

softerhardware, 2016-12-30:
Stew observed variations in HL2 current usage. Look for these variations in my prototypes. Document what expected current consumption should be.

kf5kog, 2016-12-30:
After loading LED .jic file power consumption dropped to a steady 100ma.

softerhardware, 2017-05-25:
Beta2 build notes on wiki contains a table with current measurements.

softerhardware, 2017-06-28:
On wiki.

Closed 2017-06-28.

Thread 3 (2016-12-30):

Hardware: PowerPole holes too small on PCB

softerhardware, 2016-12-30:
The holes on the PCB for the dual-purpose power connector are too small for the power pole connectors specified in the BOM. The holes must be enlarged.

softerhardware, 2017-06-11:
PCB holes large enough for mouser 879-1377G2-BK. Connector will be outside of chassis due to size. Extra pads for better mechanical durability.

Closed 2017-06-11.

Thread 4 (2016-12-30):

Hardware: Dim and bright LEDs

softerhardware, 2016-12-30:
The ethernet connector LEDs are very dim. The 4 general purpose LEDs are very bright. Consider tweaking resistor values for more current for ethernet connector LEDs and less for general purpose LEDs.

softerhardware, 2017-05-25:
New values in latest beta3 schematic.

softerhardware, 2017-05-30:
Eth PHY LEDs not working at 3.3V.  See:
https://groups.google.com/d/msg/hermes-lite/fcMIKhnhkoY/pT1L4uc-BwAJ

Try to support 3.3, 2.5V as well as pullup and pulldown configurations.

softerhardware, 2017-06-10:
PCB supports 3.3, 2.5, pull up and pull down configurations. Best configuration to be determined experimentally on beta3 build.

Closed 2017-06-10.

Thread 5 (2016-12-30):

Hardware: Simplify metric hole sizes

softerhardware, 2016-12-30:
In beta2, corner holes support metric M2.5 but the hole for pressure on the PA transistors is M2. Consider increasing this hole to M2.5 to simplify nut/bolt/standoff requirements.

vk3pe, 2016-12-30:
Steve, not sure about USA but in VK, 2 or 2.5mm screws are much harder to get in small quantities, than 3mm. (even though we are an official metric country)  Might you consider changing all to 3mm?
glenn
vk3pe

vk3pe, 2016-12-30:
Steve, from Stews picture,  it appears the holes on the rear of some parts for soldering the IC paddles, is located in a corner of the chip. Would it not be better located in the centre?  And made a bit larger? I find 3mm a better size for getting a reasonable sized solder iron tip through for better heat transfer. (ie a small hole means a small solder iron tip which is much harder to get good heat transfer, to solder the chips paddle.)

glenn
vk3pe

vk3pe, 2017-01-01:
Thanks Steve

You need about 240-250mils for a 3mm screw head.  Digikey and Mouser is
fine but freight cost are the killer for us. OK if already placing an
order for other items though.   Most electronic stores here (we have
only have 3 companies with outlets) stock 3mm screws, sometimes 2.5mm in
very limited lengths and never 2mm.. Imperial sizes just not available
in small qty. I am talking local stores, not via internet. I don't have
a pcb in my hand and you know it better of course, but the step up from
2.5mm to 3mm is not all that great.

I would have thought that auto assembly of PCB's with a hole off centre
of the paddle, would tend to draw heat away from the opposite corner? I
may well be wrong but center 'seems' like a nicer way. And 3mm even
better to fit a decent solder tip in the hole for good heat transfer,
not just a blob in the hole, which may not solder the paddle at all.
Just my thoughts.

glenn

vk3pe

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

---
This email has been checked for viruses by Avast antivirus software.
https://www.avast.com/antivirus

ahopper, 2017-01-01:
Steve,
I'd vote for M3 if you can make it fit, taps get very fragile below M3 and tend to be more expensive.  The average cheap tap and die sets often stop at M3.
Alan M0NNB

softerhardware, 2017-01-02:
My measurements have been based on http://www.spaenaur.com/pdf/sectionR/R11.pdf My concern is not the hole size for M3 but the head size of the bolt or screw. Looking at the PCB, we should be able to support a M3 head size of 5.6mm. I will have to expand the hole to accommodate M3. Note that not all M3 hardware will work, as some head dimensions for M3 are 6mm.

Since most diy builders will have to order some specialized parts (AD9866, ethernet, et.c) from a place like Digi-Key or Mouser, I don't think it is too much to expect that some hardware should be added to the order. Also, the mounting holes are secondary in my mind. An enclosure is needed for proper thermal dissipation of the PA and so fitting into the slot of an enclosure is more important in my mind.

I've already received concern from assembly houses regarding the hole I include to solder the hidden pad on some ICs. This is nonstandard and only included to support hand builders. Again, I expect the number of hand builders to be low relative to those who want a preassembled unit so this hole is a secondary consideration. Solder is a relatively bad conductor of heat. You want the center of the pad as close as possible to copper and vias for thermal dissipation. The empty space with a centered hole means the solder is conducting the heat. Since Stew has been able to build his board with an iron, I feel the holes are large enough.

vk3pe, 2017-01-02:
Thats all fine Steve.

Happy to go with whatever you decide.

glenn

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

---
This email has been checked for viruses by Avast antivirus software.
https://www.avast.com/antivirus

ahopper, 2017-01-02:
just to complete your list of head sizes http://www.roymech.co.uk/Useful_Tables/Screws/cap_screws.htm this puts M3 socket head cap screws at 5.2-5.5mm
Alan

softerhardware, 2017-06-20:
PCB supports M3 screws with small heads, regular M2.5 in all corners plus the pressure point for thermal dissipation.

All other holes on PCB have been checked and consolidated.

Closed 2017-06-20.

Thread 6 (2016-12-30):

Hardware: ENIG finish

softerhardware, 2016-12-30:
Beta2 was fabricated without ENIG finish. It worked fine, but for hand-built ENIG may be better. I did pull one pad and destroy one trace that I had to fix with a manual mod.

softerhardware, 2017-06-28:
Not sure how this will affect thermal conductivity.

softerhardware, 2017-08-07:
Sticking with least expensive finish as all prototypes used that, and majority of assembly occurs soon after board is made.

Closed 2017-08-07.

Thread 7 (2016-12-30):

Hardware: Working support for multiple enclosure widths

softerhardware, 2016-12-30:
Beta2 has tabs to support two enclosure widths. The intent is that these tabs may be broken off for use with  the narrower enclosure width. The beta2 boards were fabricated without V-cuts to make this break-off easy. Also, the enclosure listed in the BOM has a slot that is not tall enough for a 1.6mm thick PCB. Support for multiple enclosure widths needs to be cleaned up. Possibilities are:

Work with Elecrow so that V-cuts are on the next batches of boards, and use a 1mm thick PCB (no extra cost) instead of 1.6mm. This option is attractive as PCB weight will be reduced for shipment and 0.05 spacing inexpensive headers/receptacles can be used for end launch connection to the filter board.

Scrap the narrow enclosure option, but then the BOM must be updated with a 10mm length of the current 15mm length enclosure. The 15mm length is commonly available, but the 10mm length is supposedly available for special order. I prefer relying on commonly available enclosures.

jimahlstrom, 2016-12-31:
I recall that the enclosure first discussed by Steve had a slot for the PCB, but the eBay reference for the enclosure EN1 lacks a slot; or at least the picture lacks a slot.  It is also out of stock.  This enclosure

http://www.ebay.com/itm/Silver-Aluminum-PCB-instrument-Box-Enclosure-DIY-Project-100-100-50mm-US-Stock/112121507828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

is available but I can't quite make out if it has a slot.  Even if it does, I don't know the size.  The two comments state that the size 100x100x50mm is inaccurate.  I am uncomfortable depending on boxes on ebay that come and go and vary in size.

In contrast, the Hammond 1455 series boxes are designed for standard PCBs and have 2mm slots.  For example, the 1455L1201 fits a 100x120mm PCB.  But it costs $19.32 from Digikey.  It has multiple PCB slots, so is convenient for inserting a second board.  But the slots interfere with mounting a TO-220 on the side of the box with good thermal contact.

I am uncomfortable with a 1mm PCB  because OshPark does not offer them.  I guess if we just provide everyone with boards from Elecrow maybe the non-standard size is not a problem.  But why change to a 1mm board because of an ebay board that goes out of stock.

Maybe going to a no-slot box makes sense.  The HL2 is mounted with four standoffs, and more boards are added with a second layer of standoffs.  Then the box is less of a problem.

I guess I came up with more problems than solutions.  Sorry.  I will try and search for more boxes to see if there is a standard size we can depend on.  If anyone knows of one, please post here.

softerhardware, 2017-01-01:
Jim, I have both target enclosures in hand. They are pretty common models and I don't anticipate variation. I have verified the slot is not tall enough in one unit. I also have drawings for these two enclosures. I want to stick with the two current target enclosures, although hopefully keeping it easy to target other enclosures for those who want to.

I don't think a 1mm PCB will be a problem for you or any others interested in using OshPark. The same Gerber files are used for both 1.6mm or 1mm. You can have OshPark build 1.6mm. When ordering from www.elecrow.com, one just select the thickness they want. People using OshPark may want to tweak the final card dimensions also to support some other target enclosure they want to use.

I don't think the stackup spacing (except between the two inner layers) or dielectric variations between OshPark and Elecrow will be significant enough to matter. A closer spacing between the two inner ground layers should have no electrical impact. The 1mm thick boards have better thermal transfer for the PA transistors. The PA test boards sent to Claudio were 1mm thick.

jimahlstrom, 2017-01-01:
There is one enclosure on the HL2 BOM.  What is the URL for the second enclosure?  If the dimensions are standard then we can provide a template for drilling the holes in the back panel.

softerhardware, 2017-01-02:
The second enclosure is:
https://www.amazon.com/Electronic-Enclousure-Amplifier-Headphone-Wv-diyc-l/dp/B00ZOM3BUK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

Search for AK-C-C12 on www.aliexpress.com. SMOZK will customize the length. 150mm is the target with filter extension board, 100mm without the extension board. There are other manufacturers of this style of enclosure. Search for aluminum enclosures 150*105*55  or 150*106*55 on aliexpress or google.

Another possibility for the panes is a 3D printer. I expect that elecrow will be able to help with sourcing enclosures with custom front and rear panels once we go into small production.

softerhardware, 2017-06-12:
Since it appears difficult to have PCBs fabricated with break away tabs for various widths, beta3 will be 100mm. There is unused area so that narrower width PCBs can be fabricated in the future if needed.

For enclosure, I am standardizing on AK-C-C12 my SZOMK and others at 100 mm length for two board configuration, filters on second 100x100 board. Google AK-C-C12.

Closed 2017-06-12.

Thread 8 (2016-12-30):

Hardware: Tweak BOM to reduce lines, use less expensive capacitors

softerhardware, 2016-12-30:
Some resistor and capacitor values may be modified to reduce the total number of BOM lines.

In places where higher voltage capacitors are required, consider using sizes even larger than 0805 to reduce cost.

Consider using higher voltage capacitors in more locations to reduce ESR.

It can be confusing to have the same value of resistor or capacitor but in different packages in different spots. Try to simplify this.

softerhardware, 2017-06-20:
This is done. Capacitors all differ by value and/or package.

Closed 2017-06-20.

Thread 9 (2016-12-30):

Hardware: Clean-up silkscreen

softerhardware, 2016-12-30:
There are still some places in beta2 where the silkscreen is not clear. For example, around the clock generator U6.

Create pdf files of just the silkscreen at 2x enlargement to check. Post these pdfs for builders without KiCAD access to use when identifying components.

softerhardware, 2017-06-28:
Done

Closed 2017-06-28.

Thread 22 (2017-02-22):

Hardware: Make sure stuff is disabled during FPGA configuration

in3otd, 2017-02-22:
In the H-L v2b2 the TX relay toggles at power-up, while the FPGA is being configured. Similarly, the  bias source for the PA, U14, is briefly enabled. May not be harmful but would be good to add a pull down (as R125, which should likely be mounted by default).
I find the relay clicking a bit annoying because it makes the user think that the unit went into TX unexpectedly.

in3otd, 2017-05-22:
I may have missed something but why did you move this to "Firmware"? My understanding was that you cannot control the pin status during configuration - the docs say "The user I/O pins and dual-purpose I/O pins have weak pull-up resistors, which are always enabled (after POR) before and during configuration".

softerhardware, 2017-05-23:
Yes, you are right. I didn't pay close attention when reading this initially. There are also some sequencing changes that need to be made in the firmware.

softerhardware, 2017-05-25:
Resistors R124, R125, R126 added to beta3 schematic.

softerhardware, 2017-06-10:
Done on PCB.

Closed 2017-06-10.

Thread 23 (2017-03-04):

Hardware: Feedback from Claudio

softerhardware, 2017-03-04:
General:
- could be useful to add to the wiki that KiCad 5 (under development) should allow to flip the PCB view; this will make easier to find/check components on the bottom side. This new feature was mentioned at FOSDEM 2017, I did not try KiCad 5 yet.
- for those manually assembling an H-L v2 from a bare PCB, a separate top-components BOM and bottom-components BOM will be useful. I extracted the top/bottom info from the KiCad "PCB Footprint Report" with a simple python script and manually marked with a different color every component on the BOM. Maybe your scripts could be modified to print the references in the BOM e.g. in red for the components on the top and in green for the ones on the bottom so there will still be a single BOM but it will be immediately clear where a component goes. This can avoid flipping the PCB too many times or easing placing all the components on one side first for those using reflow.

Schematic:
- U12 should be marked DNI ?
- is there a reason to have connection dots on the lines to DB2, DB16 and DB4?

BOM:
- J29 has a space in front of the reference text in the BOM (just wondering why)

PCB:
- C12 reference positioning on silkscreen unclear (maybe there was no space for a connecting line)
- D8-D11 polarity on PCB unclear (I see no polarity indication in their silkscreen)
- R54 refdes partially over pad
- B70 refdes partially over via
- B22 1v2 via maybe too close to B29, for manual assembly
  The problem here is that vias are not tented, which is great for a prototype, since one has many test points for "free" but for (manual) reflow may lead to some issues.
  On my PCB, after reflow I found several capacitors which were "skewed" toward the untented via, probably because of solder sucked by the via and/or surface tension during reflow moving the component in that direction. I then used too much solder paste and had several shorts due to this. I understand it may not be an issue for a proper reflow process but I wonder if in a "production" run via near pads (or even in general) should be tented.
  Same as above for
  - B10, C3 and B4
  - B9, B3 and B14
  - B18 and B30 - but they are on same net, GND (I just got the caps stuck together during soldering)
  - B19 and B33 - but they are on same net, GND
  - B11 and B16 - but they are on same net, GND
- C48, C150 could be in 0603 (like the other 10 uF caps) instead of 0805?
- X1 has no pin 1 dot/indication on silkscreen
- D1 should be CDSOD323-T05L*C* (bidirectional); its footprint on PCB is fine for an unidirectional device but will not for a bidirectional one (it shows a polarity line, bidirectional devices do not have a polarity line on case)
- L33, L34 (actually 0 ohm for a "standard build") can be 0603 like the other 0 ohm resistors in the BOM

Testing:
- on the wiki, for the leds.jic test, which 2 of the 4 are lit ? (is it random ?)

in3otd, 2017-03-25:
- PCB mounting holes: the holes in the corners currently accept a #<i></i>4 screw or a M2.5. Here standoffs are slightly more common with M3 screws, in my experience - M3 can be forced in the current holes but it's of course not a good thing to do. M3 will require also a bit more clearance, to be safe.
No real need to enlarge the holes, but put a note somewhere to use M2.5 or #4 screws :grin:

- T3 (PA output) holes are too big, except maybe the one for the center tap, which will usually be done by twisting the wire. If you would like to support wires in parallel for the primary, two smaller holes side by side can be used.

softerhardware, 2017-05-25:
Schematic changes made in beta3.

softerhardware, 2017-06-20:
Still need to clean-up silkscreen, but a few comments:

C48 is now uses 1206 package (as others in the power supply do) for higher ESR. There are only two sizes of 10uF now.

L3 and L4 are 0 ohm now.

Mounting holes are larger to supper M3

softerhardware, 2017-06-28:
Vias can be selected now to have tenting on top, bottom or both.
I think all issues are addressed. It would still be nice to eventually have printouts of components by side.

Closed 2017-06-28.

Thread 24 (2017-03-07):

Hardware: Add Bypass Cap Near OpAmp Power

softerhardware, 2017-03-07:
See data from Claudio: https://groups.google.com/forum/#!topic/hermes-lite/1M7IdEku60U

softerhardware, 2017-05-16:
Link should be https://groups.google.com/d/msg/hermes-lite/1M7IdEku60U/XoHzL_yFAgAJ

softerhardware, 2017-05-16:
Change made in schematic.

softerhardware, 2017-06-10:
Done on PCB.

Closed 2017-06-10.

Thread 25 (2017-03-07):

Firmware: Simulation of DSP Chain

softerhardware, 2017-03-07:
Bugs may have crept into the DSP chain. Simulation of the DSP blocks at max,min,normal values as well as reponse extraction would be good.

softerhardware, 2017-05-25:
Github Hermes-Lite2/firmware/sim now has tests for some of the RX chain.

softerhardware, 2019-12-14:
Full Verilator simulation would be nice.

Thread 26 (2017-03-20):

Hardware: How to Measure Power Amp Current

jimahlstrom, 2017-03-20:
There needs to be a better way to measure the current to the power amp so that we can set the bias.

softerhardware, 2017-05-25:
Beta3 schematic has sense resistor, INA199x1 and uses one slow ADC channel for current measurements.

softerhardware, 2017-06-10:
Done on PCB.

Closed 2017-06-10.

Thread 27 (2017-03-24):

Hardware: K2 pins 1 and 12 are reversed

jimahlstrom, 2017-03-24:
Reverse them.

softerhardware, 2017-05-30:
Fixed in schematic and PCB.

Closed 2017-05-30.

Thread 28 (2017-03-25):

Hardware:  Static protection for Q1

jimahlstrom, 2017-03-25:
Add a 10 uF capacitor to the input of Q1.

in3otd, 2017-03-25:
and/or a TVS like [this](https://www.digikey.com/product-detail/en/epcos-tdk/B72530T140K62/495-7474-1-ND/6073151). I wonder if we should provide also some overvoltage protection (the input MOS is rated to 30 V); I don't think a TVS like this will be enough for non-transient overvoltages, though.

softerhardware, 2017-05-16:
Change made in schematic. There is room for both capacitor and TVS device so footprints for both are planned. Best build TBD.

softerhardware, 2017-05-30:
In schematic, footprints on PCB. BOM will pick up info from schematic. TVS was moved to before fuse.

Closed 2017-05-30.

Thread 29 (2017-03-25):

Hardware: Test Q5 works, use same device for Q2 and Q5

softerhardware, 2017-03-25:
Test that external PTT driven by Q5 works.

There are two similar devices Q2 NUD3124 and Q5 2N7002K. I would like to merge these BOM lines. The 2N7002K is less expensive. Can it be used for Q2?

in3otd, 2017-03-26:
I think it can be used, with a freewheeling diode preferably.

We could probably get rid of Q5 entirely and use the unused pole of K2 instead.

kf5kog, 2017-03-27:
Q5 works fine with John's 5W amp.   Using K2 unused pin is an interesting idea.  The SMA connectors can be slid up and the PTT out can be placed near the relay.   Stew

daniestevez, 2017-03-27:
Q5 also works fine with my Hardrock-50 HF amp.

in3otd, 2017-03-27:
out of curiosity I did some measurements around the PA relay timings, using Quisk 4.1.3.hl2; I put a pull up on the PTT output at CN11 and used the relay second pole to switch a voltage and get an indication of when the relay had actually switched (I hadn't soldered these relay pins on the PCB but bent them outwards for later use).

At TX start - with infinite persistence
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
the relay switches in a couple of milliseconds; actual RF output starts 30 ms to 50 ms later - seems a bit long even if we are not aiming for QSK, hi. I do not know if this delay is introduced by Quisk or the FW on purpose.

At TX end - also with infinite persistence
(note the change of scale w.r.t. the previous capture)
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
The RF output stops just before the PTT output is released, relay switches about 1 ms later.

I was wondering if we need a *TX inhibit* input also; it could be useful for relay sequencing for those using old big relays or transverters. This will exclude the possibility of using the relay second pole as H-Lv2 PTT output, though.

in3otd, 2017-03-28:
> I was wondering if we need a TX inhibit input also; it could be useful for relay sequencing for those using old big relays or transverters. This will exclude the possibility of using the relay second pole as H-Lv2 PTT output, though.

correction: the relay can be used anyway, it's enough that no RF signal is present at the H-L PA output until the *TX inhibit* is deasserted.

softerhardware, 2017-06-20:
NUD3124 is used in both places. Footprint is the same if we need to revert back. TX inhibit is specified to a free input.

Closed 2017-06-20.

Thread 31 (2017-04-11):

Hardware: Mark CN7 I2C

jimahlstrom, 2017-04-11:
Mark pin 2 of CN7 (FPGA 30) as "SDA" and pin 3 (FPGA 31) as "SCL".

jimahlstrom, 2017-04-23:
Also, mark the I2C address as 0x20.

softerhardware, 2017-05-16:
Change made in beta3 schematic.

Closed 2017-05-16.

Thread 32 (2017-04-23):

Firmware: I2C address for CN7

jimahlstrom, 2017-04-23:
The default standard I2C address for CN7 (band select) is 0x20.

softerhardware, 2017-05-16:
Change made in schematic.

Closed 2017-05-16.

Thread 33 (2017-04-23):

Hardware: U18 configured as followers

jimahlstrom, 2017-04-23:
The diodes D8, D9, D10 and D11 are removed, and U18 is configured as four followers.

jimahlstrom, 2017-04-25:
Maybe diodes D10 and D11 should remain.  They are used for AIN1 and AIN2, and the forward and reverse power is probably measured with diodes.  If so, D10 and D11 will provide some diode drop compensation.

softerhardware, 2017-05-25:
Beta3 schematic updated. 2 channels for temp and current are followers.

softerhardware, 2017-06-10:
Done on PCB.

Closed 2017-06-10.

Thread 34 (2017-04-28):

Hardware: Better Capacitor Placement for RX

softerhardware, 2017-04-28:
See post https://groups.google.com/d/msg/hermes-lite/1M7IdEku60U/_WGwC57HEgAJ from Claudio

Hello,

I was doing some more experiments on the RX input and noticed that probably the value of C55 needs to be corrected to compensate for the input capacitance of the AD9866. The differential input capacitance, from the datasheet, is 4 pF, which is then multiplied by 8 by the input transformer T2 so it looks like 32 pF on the 50 ohm side; this value needs to be subtracted from the theoretical 100 pF needed. We could then use 68 pF for C55 but for some reason things look a bit better when moving the whole capacitance after the transformer, removing C55 and placing 8.2 pF across the AD9866 RX inputs.

In the graph below is the measured wideband response for the default values (same as in the previous post) and when replacing C55 with 8.2 pF on the differential RX pins:

the notch moves a little higher in frequency (in the middle of the FM band) and the final rejection is a little higher, maybe because the transformer leakage inductance adds some filtering effect.

Looking at the passband response, there is a slight change on the upper end of the HF, maybe some fraction of a dB less loss at 30 MHz (as usual, ignore the small dips on the red trace, these were due to an issue in the measurement script)

the input impedance also looks a bit better, as the return loss above 10 MHz is improved:

softerhardware, 2017-05-16:
Change done in schematic. Left footprint for original C55 in case it is ever needed. Claudio's tests included C55 footprint.

softerhardware, 2017-06-10:
Done on PCB.

Closed 2017-06-10.

Thread 35 (2017-04-30):

Hardware: ESD protection

jimahlstrom, 2017-04-30:
Add four TVS at CN4.  Or document the need for TVS at panel mount connectors.

softerhardware, 2017-05-25:
D8, D9, D13 and D14 added to beta3 schematic.

softerhardware, 2017-05-30:
Footprints added to schematic.

Closed 2017-05-30.

Thread 36 (2017-05-23):

Hardware: Allow for Enable use of 1.2 and 3.3V regulators

softerhardware, 2017-05-23:
Layout traces to the enable pins on the 1.2 and 3.3V regulators such that they can be cut and a wire connected easily. This is to support companion cards which may want to switch these supplies on and off.

softerhardware, 2017-06-10:
Routing changed on PCB.

Closed 2017-06-10.

Thread 37 (2017-05-30):

Hardware: Allow for aluminum block below PA transistors

softerhardware, 2017-05-30:
The holes for TO-220 devices get in the way of using an aluminum block below the PA transistors as an alternate heat transfer path. Modify the PA device footprints so that TO-220 device leads must be bent and therefore no through holes. Make sure there is enough area with only ground exposed so that an reasonable size aluminum block may be used.

softerhardware, 2017-06-11:
Done on PCB.

Closed 2017-06-11.

Thread 38 (2017-05-30):

Hardware: Consider Ferrite Bead or Jumper on all SW PS Output

softerhardware, 2017-05-30:
To facilitate testing the power supplies isolated from the design, consider ferrite bead or jumpers on all switching regulator output pins.

softerhardware, 2017-06-10:
Considered but no room and little benefit. For DIY, please build power supply first and test.

Closed 2017-06-10.

Thread 39 (2017-06-10):

Hardware: Consider support for shield over AD9866

softerhardware, 2017-06-10:

softerhardware, 2017-06-12:
Added another ground through hole. There are enough ground through holes around the AD9866 that a shield can be hacked and tested.

Closed 2017-06-12.

Thread 40 (2017-08-07):

Hardware: Beta3 R55 should be 120 Ohm

softerhardware, 2017-08-07:
R55 was changed from 75 to 120 Ohm to reduce the output of the opamp so that the PA is not over driven. This change did not make it into the beta3 BOM. With 75 Ohm, the output is 20dBm. R55 must be changed to 120 Ohm or care must be taken to not over drive the PA by reducing the TX Dac output level.

softerhardware, 2017-09-07:
Done in github.

Closed 2017-09-07.

Thread 41 (2017-08-12):

Firmware: More CW Options

softerhardware, 2017-08-12:
See:

https://groups.google.com/d/msg/hermes-lite/_BAiRyqGvJk/GZsyNuuNBAAJ

softerhardware, 2019-07-15:
Include fast path for CW: https://groups.google.com/d/msg/hermes-lite/CnqO2wi1m-4/ZzBxK46hCQAJ

softerhardware, 2019-10-29:
Yesterday I upgraded my HL2b8 to the latest gateware for a build 8 using the N2ADR filter boards on a 64 bit Win10 laptop using the latest Sparkradio SW over direct ethernet connection.
It went flawlessly.
The gateware runs fine on Spark and PowerSDR. But when using Quisk in CW mode, the TX mode hangs and does not return to receive mode when done keying. Quisk works just fine running digital modes (FT8) with respect to RX/TX switching.
This was not an issue with the gateware version factory-installed by MakerFabs for the build 8 run.
I hope reporting this bug is helpful.

softerhardware, 2019-12-14:
I've started simplifying the keyer. The idea is to enable it with no side tone. Can be used from the front panel but intended uses is primarily remote use with CWX from PowerSDR.

softerhardware, 2019-12-14:
Also, experimenting with connecting a CW key or paddle to a Pro Micro board:
https://www.amazon.com/HiLetgo-Atmega32U4-Bootloadered-Development-Microcontroller/dp/B01MTU9GOB

Key on/off can be sent to PC as MIDI events with low latency using this library
https://github.com/arduino-libraries/MIDIUSB

A small independent program can send data to the HL2 via the alternate async ethernet port. This small program can use ASIO or JACK for low latency sidetone at the PC. This program can be modeled after the one just started for HL2 EEPROM configuration.

softerhardware, 2020-01-04:
Look at the YouTube videos of Chuck aa0hw:
http://qrqcwnet.ning.com/profile/chase

In particular
https://www.youtube.com/watch?v=zzd7naKzRgw
https://www.youtube.com/user/QRQcw
https://www.youtube.com/watch?v=w3LKiU0kKCg
https://www.youtube.com/watch?v=TgiHS2UC0JQ

His use of Jack and KXStudio is exactly along the lines of what I'd like to do. For example, an LV plugin for Carla that sits between the radio output and main jack output could listen for CW over midi, insert the CW tone in near real time, and send key signals to the HL2 over ethernet asynchronously.

Thread 42 (2017-08-12):

Firmware: Temperature and Current data sometimes stops

softerhardware, 2017-08-12:
Handle errors in firmware

softerhardware, 2019-12-14:
This hasn't been seen or reported in a long time. Will close.

Closed 2019-12-14.

Thread 46 (2017-09-01):

Hardware: PE4259s are not switching cleanly in beta3, need pulldown resistors

softerhardware, 2017-09-01:
https://github.com/softerhardware/Hermes-Lite2/wiki/Build-Notes-2.0beta3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

softerhardware, 2017-09-24:
Done in beta4.

Closed 2017-09-24.

Thread 47 (2017-09-01):

Hardware: Switch to 2 input opamp, direct connection for temperature and current

softerhardware, 2017-09-01:
https://github.com/softerhardware/Hermes-Lite2/wiki/Build-Notes-2.0beta3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

softerhardware, 2017-09-01:
Current measurement is not full range, use resistor divider at input of slow ADC.

Taka has noise or pegged at zero issues. Review his modifications.

in3otd, 2017-09-02:
The opamp used may not be well suited to the diode linearization circuit, as its bias current is relatively high. Moreover, the conventional wisdom says that the RF detector diode and the linearization diode used around the opamp should be matched; this won't likely be the case if these two diodes resides on two different boards. We could maybe drop the opamp completely and assume that it will be on the filter/SWR bridge board or provide jumpers to access the ADC inputs directly. More details in the following days, hopefully  :grin:

softerhardware, 2017-09-24:
U18 was essentially eliminated in beta4 with bypass vias provided for FWD and REV, and temperature and bias current connected directly to the ADC. The issue remains open as U18 will be entirely removed in beta5. This op amp belongs near the SWR bridge.

softerhardware, 2017-10-27:
Removed in beta5.

Closed 2017-10-27.

Thread 48 (2017-09-01):

Hardware: Beta3 RF low power output rolls off at 12/10M unline beta2

softerhardware, 2017-09-01:
https://groups.google.com/d/msg/hermes-lite/xJK3CdW_uV0/1ZSSs5A8AQAJ

softerhardware, 2017-09-20:
C50 and C51 must be as specified and with <=5% tolerance. It appears Elecrow installed two 150pF capacitors of large tolerance. No substitutions in BOM.

softerhardware, 2017-09-24:
Done for beta4.

Closed 2017-09-24.

Thread 49 (2017-09-01):

Hardware: Short jumpers that will not change on PCB

softerhardware, 2017-09-01:
Footprints to be left in place so that traces can be cut to have real jumper if ever needed.

softerhardware, 2017-11-06:
This was a bad idea when tried. Requires void in layer underneath. Grounds become ambiguous. Not enough to make much of an assembly difference. Sticking with 0603 jumpers.

Closed 2017-11-06.

Thread 50 (2017-09-01):

Firmware: Enable half/full duplex dynamic switching

in3otd, 2017-09-01:
As discussed [here](https://groups.google.com/d/msg/hermes-lite/iP45Tecrlsg/ZneH7Ef8AwAJ), it would be nice to be able to switch to half duplex to (hopefully) improve RX performances and to full duplex when needed (Puresignal, etc.).

softerhardware, 2019-02-11:
There are build targets for half duplex now. Dynamic switching still does not exist.

softerhardware, 2019-12-14:
This would help lower power.

Thread 51 (2017-09-01):

Firmware: Faint Lines in Bandscope Waterfall

softerhardware, 2017-09-01:
See

https://groups.google.com/d/msg/hermes-lite/PM1fHZNECS4/Cdzv8tFKAAAJ

and other posts in that same thread.

softerhardware, 2019-09-22:
This is fixed in Quisk 4.1.45. It was a software bug.

Closed 2019-09-22.

Thread 52 (2017-09-02):

Hardware: Add PTT to free pin on CN7

softerhardware, 2017-09-02:
https://groups.google.com/d/msg/hermes-lite/cbwdlO_I4uM/PA-fE4QABwAJ

softerhardware, 2017-09-24:
No longer needed as we will try to put the RX HPF on the HL2.

Closed 2017-09-24.

Thread 55 (2017-09-09):

Hardware: Via inductance on beta3 may affect RF paths

softerhardware, 2017-09-09:
Unmask and make vias near pins 2 and 6 of U9 larger. Consider the same for other vias in RF path.

softerhardware, 2017-09-24:
The problem here was out of spec capacitors used in the TX filter. These have been changed to no substitutions in beta4. No changes will be made to these vias.

Closed 2017-09-24.

Thread 56 (2017-09-09):

Hardware: B106 is very near LDMOS thermal mount hole

softerhardware, 2017-09-09:
Consider moving

softerhardware, 2017-09-24:
Fixed in beta4

Closed 2017-09-24.

Thread 57 (2017-09-09):

Hardware: MCP9700 Needs Decoupling Capacitor

softerhardware, 2017-09-09:
Datasheet recommends cap to decouple. B118 on output is unneeded and unused. Switch this to decouple power.

softerhardware, 2017-09-24:
Fixed in beta4

Closed 2017-09-24.

Thread 58 (2017-09-24):

Hardware: Move power supply connector to front by ethernet jack

softerhardware, 2017-09-24:
To facilitate testing and usage without companion filter board.

softerhardware, 2017-09-24:
Prefer 5.5mm OD 2.1mm barrel jack. May have to nudge ethernet connector slightly provided there is more room after the addition of a stereo jack for CW.

softerhardware, 2017-10-27:
Done

Closed 2017-10-27.

Thread 59 (2017-09-24):

Hardware: RX HPF on main HL2 board

softerhardware, 2017-09-24:
Use PE4259s to switch in and out RX HPF filter. Use Jim's design or the design by Graeme and tested by Taka. Repurpose the mode FPGA line switch this filter. This needs to be checked. For more room, possibly reduce the footprint size of the RX balun to only the commercial option.

softerhardware, 2017-11-06:
Decided against this. Group members who responded do not want this on the HL2 but prefer any HPF on a companion card. Since I do not suffer from ADC overload, I have no strong preference.

Closed 2017-11-06.

Thread 60 (2017-09-24):

Hardware: Add 2.54mm Single Row Header at Rear of HL2

softerhardware, 2017-09-24:
This is a vertical header. This is to interface with a companion filter board. The two parallel vertical headers are also spaced at 2.54mm so that standard jumpers, wires or even a custom connector board may be used to join the two.

softerhardware, 2017-10-27:
Done

Closed 2017-10-27.

Thread 62 (2017-09-24):

Hardware: Consider Using UFL Connectors instead of SMA for some RF/clock connectors

softerhardware, 2017-09-24:

softerhardware, 2017-10-27:
Done. Still consider RX filter bypass with uFL. Additonal clock out of AD9866 to uFL. uFL overlap with back RF connectors.

softerhardware, 2017-11-06:
Done in beta5.

Closed 2017-11-06.

Thread 65 (2017-09-27):

Hardware: Consider Larger Footprint for C92

softerhardware, 2017-09-27:
C92 was added to reduce ripple of Vpa at T3. If possible, switch to 1206 10uF HV as used in power supply for lowest ESR.

softerhardware, 2017-11-06:
No room on PCB. 0805 22uF HV is also used in power supply. C92 will bring the count up to 10 for lower price break.

Closed 2017-11-06.

Thread 66 (2017-09-27):

Hardware: Consider Larger Footprint or Jumper for B82

softerhardware, 2017-09-27:
B82 enables RF3 RX input. This is one component that many will have to add depending on how they want to customize their HL2. Make it easy to add this by using a larger footprint or wire jumper. There is already a decoupling capacitor in the path.

softerhardware, 2017-10-27:
Shorted 0603 footprints were added here. RF3 is always enabled. May be disabled by cut.

Closed 2017-10-27.

Thread 67 (2017-09-30):

Hardware: Glitches Seen on Power Supply

softerhardware, 2017-09-30:
https://groups.google.com/d/msg/hermes-lite/xJK3CdW_uV0/tPshwRzXAwAJ

softerhardware, 2017-11-02:
I tried to observe these again but did not see them. I had some noise issues when my probe was set to 1x that looked like these glitches. Perhaps these are the "pulse skipping" feature of these regulators. I reviewed the datasheet and didn't find anything I wanted to change or experiment with. I think the layout and circuit are okay. Maybe someone will tweak discrete component values to find a better operation point in the future.

softerhardware, 2019-12-14:
Stale report. No recent reports.

Closed 2019-12-14.

Thread 68 (2017-09-30):

Hardware: Experiment with Shield on AD9866 to Possibly Improve RX IMD

softerhardware, 2017-09-30:
https://groups.google.com/d/msg/hermes-lite/iP45Tecrlsg/w_FOoVNDAgAJ

softerhardware, 2017-10-27:
More ground holes around AD9866 added in beta5

softerhardware, 2019-12-14:
We've switched to using a Raspberry Pi heat sink.

Closed 2019-12-14.

Thread 69 (2017-10-02):

Firmware: 5W Full Duplex with TR Switch on Main HL Board

softerhardware, 2017-10-02:
We can enable full duplex with 5W out if internal TX keeps the relay in TX and RX is on RF3. Also, to prevent damaging RX, full duplex low power can also use RF3 provided nothing is loaded RX on RF2.

softerhardware, 2019-12-14:
Little interest for this.

Closed 2019-12-14.

Thread 71 (2017-10-27):

Hardware: Test I2C for Filters on Back Connector

softerhardware, 2017-10-27:
And test all beta5 changes in firmware.

softerhardware, 2018-02-18:
N2ADR board is working. It uses this I2C filter selection.

Closed 2018-02-18.

Thread 72 (2017-10-27):

Hardware: Bidirectional TVS symbol is misleading

in3otd, 2017-10-27:
The symbol for the SMBJ18CA (D12) and  the CDSOD323-T05LC  (D1) are a bit misleading, they should represent two diodes in "antiseries", like [here](http://www.littelfuse.com/~/media/electronics/datasheets/tvs_diodes/littelfuse_tvs_diode_smbj_datasheet.pdf.pdf).
BTW, I'm not sure that D12 should be a bidirectional diode, even if negative voltages will be blocked by Q1, maybe we could use an unidirectional protection there.

softerhardware, 2017-11-05:
http://datasheet.octopart.com/CDSOD323-T05LC-Bourns-datasheet-13385636.pdf is slightly different.

in3otd, 2017-11-05:
yes and maybe closer to the actual internal design but the complete circuit does not fit well in a schematic symbol :grin: . My point was that the current symbol looks like two Schottky diodes in antiparallel so at a first glance it appears to conduct at around &pm;400 mV

softerhardware, 2017-11-06:
Schematic symbols updated to match datasheets.

Closed 2017-11-06.

Thread 74 (2017-11-07):

Hardware: Confirm if R131/R132 should connect to 3V3 or Veth

softerhardware, 2017-11-07:

softerhardware, 2017-11-15:
Voltage swings between 2.0 and 3.3V when 3.3V is used. Switched to 2.5 Veth on beta3 prototype and now see good swings. Veth is default for beta5 on.

Closed 2017-11-15.

Thread 75 (2017-12-06):

Hardware: All PCB Layers within .GML outline

softerhardware, 2017-12-06:
Some PCB fabrication house do not like drawing outside of the .GML board edge outline.

softerhardware, 2018-02-18:
Done in KiCad files 2/18/2018 on.

Closed 2018-02-18.

Thread 76 (2018-01-06):

Hardware: Schematic needs note reference updates

softerhardware, 2018-01-06:
https://groups.google.com/d/msg/hermes-lite/UPUR8mo7Fpw/xTlNyiXADQAJ

softerhardware, 2018-02-18:
Changed in KiCAD 2/18/2018 files.

Closed 2018-02-18.

Thread 77 (2018-01-12):

Power supply requirement for HL2

oh2lzi, 2018-01-12:
Specify the input power supply requirements in the HL2 schematic.

softerhardware, 2018-02-18:
Done in 2/18/2018 KiCAD.

Closed 2018-02-18.

Thread 78 (2018-01-13):

PA circuit diagram transformer T3 turns incorrect

g3vbv, 2018-01-13:
The note for T3 says:
Hand Wind
B62152A4X30 or BN43-202
4T Primary, 1+1T Secondary
-------------------------------------------------------
Should read 1+1T Primary, 4T Secondary.

softerhardware, 2018-02-18:
Done in KiCAD 2/18/2018 files.

Closed 2018-02-18.

Thread 79 (2018-01-17):

Add this transformer info to the wiki

W9JSW, 2018-01-17:
Pin 2 is the one in the center. Pins 1 and 3 face the LDMOS transistors, towards the edge of the board. Pins 4 and 5 face the center of the board, towards the opamp. For the 1T+1T, these are two single loops (once through the core each) from pin 1 to 2, and another from pin 3 to 2. I usually use two short wires. For the 4T, this is 4 times through the core from pins 4 to 5. There are no unusual crossings and the wires coming out of the core should go nicely to the respective pins. Only the wires going to pin 2 may need a little flexing.

softerhardware, 2018-02-18:
Added to wiki. See https://github.com/softerhardware/Hermes-Lite2/wiki/Hermes-Lite-2.0-Getting-Started#transformer-pin-out

Closed 2018-02-18.

Thread 80 (2018-01-18):

CN4 (SJ1-3525N) Will not sit flat on PCB

kf5kog, 2018-01-18:
This part will not sit flat on PCB.  Based on mechanical drawing is shows a cutout required  for the round section of jack.  There are 2 other possible solutions.  Find a different part or remove the alignment pin holes so the jack will sit on those pins.  This will allow clearance for the jack housing.  I just filed a flat spot on the bottom plastic.  The round metal edge doesn't require filing, just the plastic area just behind it.
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

softerhardware, 2018-02-18:
Added board cutout in hl2b6, 2/18/2018.

Closed 2018-02-18.

Thread 81 (2018-02-18):

Hardware: Better Cooling for AD9866

softerhardware, 2018-02-18:
HL2 beta5 AD9866 is running hot.
 Optional DB6 converted to surface mount footprint to not cut ground plane.
 One via moved to also not cut ground plane.
 Footprints without large manual soldering hole created. These will be used in the final assembly PCB gerber files.

softerhardware, 2018-05-19:
Done, but no significant reduction seen.

Closed 2018-05-19.

Thread 82 (2018-02-18):

Production: New Instructions to Elecrow for HL2b6

softerhardware, 2018-02-18:
For next run:

* Provide power supply shorted tests before power up
* Request inspection for solder balls shorting out AD9866 pins
* Insist on proper soldering of thermal pads, assembly gerber footprints have removed large hole
* If board does not pass test and programming, remove from power supply. Do not keep connected for extended period of time.
* Maybe enhance Raspberry PI test, at least include latest firmware

softerhardware, 2018-05-19:
Build 6 done. RPi test was updated.

Closed 2018-05-19.

Thread 84 (2018-03-16):

shorts >500 ohms

jsavage, 2018-03-16:
One of the checks is to ensure there are 'no shorts (>500 Ohm)'

Since a short is usually a low resistance I wonder if  '< 500 Ohms?' might be more accurate

softerhardware, 2018-05-19:
Clarified wiki.

Closed 2018-05-19.

Thread 85 (2018-05-19):

Firmware: Combine I2C Controllers to Save Resources

softerhardware, 2018-05-19:

softerhardware, 2019-12-14:
This has been done for two controllers. It should be possible to combine the ADC read controller with the default controller.

Thread 89 (2018-05-19):

Production: Investigate Kitting (Filter Board, Enclosure) of Future Builds, ZelPro AD9866/FPGA Assembly

softerhardware, 2018-05-19:

softerhardware, 2019-02-11:
Build 7 was done this way. Lack of testing resulted in me having to do too much work. Going back to 100% built and tested by assembly house in China.

Closed 2019-02-11.

Thread 102 (2018-09-20):

Hardware: Upgrade PS Inductors

softerhardware, 2018-09-20:
Upgrade to shielded inductors for the power supply. I used SRR4528A-2R2Y and SRR4528A-3R3Y for repairs in build 7. I saw about a 10dB drop in the 160M spurs, similar to what I achieved with aluminum foil. They are slightly more expensive and the shield is fragile.

softerhardware, 2019-02-12:
Update build8 BOM

Closed 2019-02-12.

Thread 103 (2018-09-20):

Hardware: Include R117, R118 and R119

softerhardware, 2018-09-20:
Include R117, R118 and R119. There was a case where someone's relay was chattering because TX inhibit was floating with the new firmware. These FPGA inputs do no have internal pull-ups since they are clock inputs. So far we've been lucky without R117, but in some scenarios it will pick up enough RF during TX to cause TX to inhibit. I manually installed R117 on all build 7 units to prevent this.

softerhardware, 2019-02-11:
Done for build8

Closed 2019-02-11.

Thread 104 (2018-09-20):

Hardware: Make X2 easier to solder

softerhardware, 2018-09-20:
Rework the footprint and/or routing for X2. I had to replace about a third of these oscillators in build 7. It wasn't because they were poorly soldered. Many of the metal caps just fell off when a little bit of heat was applied. This didn't happen with the replacement parts. I found it difficult to solder X2 because the ground pin 2 was hard to heat. The pad sizes and thermal transfer to ground need to be reduced. They may have had problems in China with this which led to the many failures.

softerhardware, 2019-02-13:
Changed in build8. Only the smaller size (one that we've been using) is now supported.

Closed 2019-02-13.

Thread 106 (2019-02-20):

JTAG CN1 Pin Out / Marking

jsavage, 2019-02-20:
Hi, just a quick note to suggest silk screen marking the top side of the board for Pin 1 of CN1.
I worked it out from the schematics and identifying R3 and R4 on the back of the board but if there is not significant addition to cost I sure it would help some.
Interestingly, my Rev B programmer cable goes over the Altera when Pin 1 is aligned whereas on the [youtube video](https://www.youtube.com/watch?v=5m2kUmod0yQ&feature=youtu.be) the cable lies the other direction.
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

I appreciate the cutout is shown but not all headers are shaped as anticipated.

softerhardware, 2019-02-24:
Added pin 1 identifier to silkscreen.

Closed 2019-02-24.

Thread 107 (2019-02-24):

Hardware: PCB End Caps

softerhardware, 2019-02-24:
See:

https://groups.google.com/d/msg/hermes-lite/iwl-Kf7IYXw/7PEjHxhHBQAJ

softerhardware, 2019-09-22:
Done and included in build9. See:
https://github.com/softerhardware/Hermes-Lite2/tree/master/hardware/enclosure/endcaps/kf7o

Closed 2019-09-22.

Thread 108 (2019-03-25):

Hardware: enclosure link

csylvain, 2019-03-25:
the link to an Amazon listing is for an enclosure product now unavailable and without other sellers.

instead, use this link:
https://www.amazon.com/MagiDeal-Instrument-Enclosure-Electronic-15010655MM/dp/B01MAYO8TC/

softerhardware, 2019-08-17:
Added the link to the wiki.

Closed 2019-08-17.

Thread 110 (2019-05-20):

Hardware: Missing DC blockers for RF Switch PE4259

rfrht, 2019-05-20:
Hi there, congratulations for the project!

After reviewing the schematics, I have found that U10 and U11 (PE4259 RF switches) has no DC blockers.

As per PE4529 datasheet, verbatim:
"All RF pins must be DC blocked with an external series capacitor or held at 0 VDC."

Might be related to Issue #46.

Just a heads up and hope that helps!

73s de PY2RAF.

softerhardware, 2019-05-21:
Hi,

Thanks for the feedback. The output of the opamp is DC biased, but there is a blocking capacitor between the opamp and the PE4259. The other connections to the PE4259 are not DC biased (at 0VDC) so do not need a blocking capacitor. There have been no issues here now in almost 200 units. We followed this application note: https://www.psemi.com/pdf/app_notes/an27.pdf

73,

Steve
kf7o

Closed 2019-05-21.

Thread 111 (2019-05-25):

Manufacture: Programming and Test must Halt if EEPROM programming fails

softerhardware, 2019-05-25:
Several build8 units were shipped without EEPROM programmed.

softerhardware, 2019-07-14:
Also, update test to point to which components may be faulty. Include additional instructions for bad X3.

softerhardware, 2019-09-22:
The latest 20190922 release checks properly for programmed EEPROM, and prints out possible faulty components for some failing tests. The wiki has instructions for bad X2.

Closed 2019-09-22.

Thread 112 (2019-05-25):

Manufacture: Some boards are too thick or wide for enclosure

softerhardware, 2019-05-25:
Compile list of good 1.6+mm enclosures. Wide boards can be sanded. Consider 1.4mm thick PCBs.

softerhardware, 2019-08-17:
Will stay with 1.6mm boards due to edge launch connectors. The wiki now has links to some enclosures with better slot thickness.

Closed 2019-08-17.

Thread 113 (2019-05-25):

Manufacture: Some SMA connectors have ding damage on top

softerhardware, 2019-05-25:
When the antistatic bag is heat sealed, sometimes the SMA connectors are dinged. Stress with the fab house to be more careful here.

softerhardware, 2019-07-14:
Makerfabs has acknowledged the problem and will be more careful for build9.

softerhardware, 2019-09-22:
Makerfabs has been instructed.

Closed 2019-09-22.

Thread 114 (2019-05-25):

Manufacture: T3 leads are long

softerhardware, 2019-05-25:
Claudio will see if this matters or if it is just cosmetic. Try to have shorted leads in the future.

softerhardware, 2019-07-14:
This does matter. Makerfabs has agreed to use the same wire as used in the mod kit, and to ensure the leads are no more than 3mm. We will hold them to it in build9.

softerhardware, 2019-09-22:
Makerfabs has been instructed.

Closed 2019-09-22.

Thread 115 (2019-05-31):

Issues with the Hermes-Lite2 addtions to the openHPSDR USB frames over IP or Protocol 1

matthew-wolf-n4mtt, 2019-05-31:
There is a new version of the  OpenHPSDR USB frames over IP protocol. The document for version 1.60 was paced on Github in the past month. The the Hermes-Lite2 "C0 Type" for  "RX 8 NCO Frequency" over laps with the new "C0 Type" for "2ND Alex, Firmware Envelope Gain" that was added in version 1.60 of the official protocol.  Also in the protocol document the "C0 Types" are defined as 7 bit numbers NOT 6 bit numbers.  I am adding the Hermes-Lite2 to my Wireshark plugin "openhpsdr-u". The plug-in uses 7 bit numbers for the "C0 Types" below are the 7 bit numbers for the Hermes-Lite2 addtional "C0 Types"

   // Hermes-Lite2 Addtions
   // Defined as 6 bit numbers. The stanard defines the C0 types as 7 bit numbers.
   // This dissector is writen using 7 bit numbers for the C0 types.
   // - 1st number 6 bits - 6:1
   // - 2nd number 7 bits - 7:1 - 1st number left shifed once for MOX.
   // 0x12 0x24 HL2 RX 8 NCO Frequency (Over Lap with 0x24 2ND Alex, Firmware Envelope Gain)
   // 0x13 0x26 HL2 RX 9 NCO Frequency
   // 0x14 0x28 HL2 10 NCO Frequency
   // 0x15 0x2A HL2 RX 11 NCO Frequency
   // 0x16 0x2C HL2 RX 12 NCO Frequency
   // 0x2B 0x56 HL2 Predistortion
   // 0x3B 0x76 AD9866 SPI
   // 0x3C 0x78 I2C1
   // 0x3D 0x7A I2C2
   // 0x3f 0x7E Extended Write Data

softerhardware, 2019-05-31:
Hi Matthew,

The Hermes-Lite only attempts to be compatible with openHPSDR protocol 1 for core use. As you have discovered, we have additional extensions that Quisk and SparkSDR use. For example, the 6 bits for C0 is because we have added commands that require a response by using the extra bit. This is documented on the wiki: https://github.com/softerhardware/Hermes-Lite2/wiki/Protocol

I'd be interested in hearing if you think any of the extensions would conflict with core openhpsdr software use.

73,

Steve
kf7o

matthew-wolf-n4mtt, 2019-05-31:
The major issue is that my plug-in is not correct .I is treating the 7 bit C0 type a a 8 bit number. This will be corrected in the next release. The OpenHPSDR protocol 1 documents are not written in a way that lists the length of the fields.

There should be no issue with Hermes-Lite2 additional 6 bit C0. When they are treated as 7 bit numbers the 7th bit is a zero.

The conflict with C0 18 (0x12) is due to the newest version of the protocol. I let you know if I discover any more conflicts.

Corrected list of "C0 Types":
   // The "C0 Types" are 7 bit numbers.
   // Before version 0.4.0 they were in-correctly treated as 8 bit numbers.
   // 0 0x00 Configuration
   // 1 0x01 TX NCO Frequency
   // 2 0x02 RX 1 NCO Frequency
   // 3 0x03 RX 2 NCO Frequency
   // 4 0x04 RX 3 NCO Frequency
   // 5 0x05 RX 4 NCO Frequency
   // 6 0x06 RX 5 NCO Frequency
   // 7 0x07 RX 6 NCO Frequency
   // 8 0x08 RX 7 NCO Frequency
   // 9 0x09 TX Drive, Anntena Presect, VNA
   // 10 0x0A RX Pre-amp, IF Gain, PureSignal, Open Drain, TTL, 20db/ADC1 Attn
   // 11 0x0B ADC[123] Attn, CW Config
   // 12 0x0C Additional Mercury 1
   // 13 0x0D Additional Mercury 2
   // 14 0x0E ADC RX Assignment
   // 15 0x0F CW Configuration 2
   // 16 0x10 CW Configuration 3
   // 17 0x11 PWM Configuration
   // 18 0x12 2ND Alex, Firmware Envelope Gain

   // Hermes-Lite2 Addtions
   // 18 0x12 HL2 RX 8 NCO Frequency (Conflict with core 0x12 - per 1.60)
   // 19 0x13 HL2 RX 9 NCO Frequency
   // 20 0x14 HL2 10 NCO Frequency
   // 21 0x15 HL2 RX 11 NCO Frequency
   // 22 0x16 HL2 RX 12 NCO Frequency
   // 43 0x2B HL2 Predistortion
   // 59 0x3B AD9866 SPI
   // 60 0x3C I2C1
   // 61 0x3D I2C2
   // 63 0x3F Extended Write Data

Closed 2019-05-31.

Thread 116 (2019-06-09):

Manufacture: 0.2mm clearance on N2ADR filter board

softerhardware, 2019-06-09:
https://groups.google.com/d/msg/hermes-lite/6ekgFg_8U88/vedt1AHIAQAJ

softerhardware, 2019-08-17:
0.21mm in build9.

Closed 2019-08-17.

Thread 118 (2019-07-14):

Gateware: DHCP Discover Dropped if no Checksum

softerhardware, 2019-07-14:
Some DHCP servers will drop the DHCP discover if the checksum is set to all zeros, not used. This is an issue with some DHCP servers as an all zeros checksum (checksum not used) is a legal alternative.  This issue was created to track this known problem, and possibly add checksum to all UDP packets sent from the HL2 (costly in terms of FPGA resources) or to switch to an ethernet stack that applies checksum to all UDP packets, such as https://github.com/alexforencich/verilog-ethernet

csylvain, 2019-07-16:
what is happening is an intermediate network device is messing up the checksum computation when bridging a DHCP packet with a 0x0000 checksum. in turn, the DHCP server rejects the incoming packet because the bridge has added a checksum and it is incorrect. the DHCP server (ISC 4.1 and later) is capable of replying to an incoming udp packet with no checksum, it just rejects packets with invalid checksums.
i see there is already a crc function in the gateware related to the network functions but did not dig in enough to determine where it is already used.

softerhardware, 2019-12-14:
I'm considering this a problem with DHCP servers and will not support workarounds in the HL2.

Closed 2019-12-14.

Thread 120 (2019-07-15):

Gateware: Provide Queue Info and Other Feedback

softerhardware, 2019-07-15:
See this thread: https://groups.google.com/d/msg/hermes-lite/vkkFb6cuvy8/suqbxn5oCQAJ

softerhardware, 2019-07-15:
Have a mode to synchronize the TX on/off with the data stream, not async like CW: https://groups.google.com/d/msg/hermes-lite/e0X2JrogGMo/0pc8JdqvAQAJ

csylvain, 2019-07-16:
does obtaining the same information remotely that is conveyed by the LEDs count as "other feedback"?

softerhardware, 2019-12-14:
This is in latest gateware:
https://github.com/softerhardware/Hermes-Lite2/wiki/Protocol#base-memory-map-when-ack0

Closed 2019-12-14.

Thread 121 (2019-09-12):

Slow Recovery After Multiple CW Dits.

softerhardware, 2019-09-12:
https://groups.google.com/d/msg/hermes-lite/WTZFXb5O40U/EWkRnFULAQAJ
https://groups.google.com/d/msg/hermes-lite/WTZFXb5O40U/191Q95d_AQAJ

softerhardware, 2019-12-14:
I don't see this. Maybe it requires a PA or higher levels of power. I don't like the solution of disabling RX during TX. More investigation is required.

softerhardware, 2020-04-04:
Hardware-based switching between TX and RX LNA gains added in version 70.

Closed 2020-04-04.

Thread 124 (2019-11-08):

PTT Hangs in CW Mode Using Quisk 4.1.40

WN7T, 2019-11-08:
Hello.
When using Quisk version 4.1.40 on a Windows10 laptop and sending CW, the PTT hangs on TX and does not return to receive mode unless I either cycle the "Spot" button (hit it twice), or terminate Quisk. This bug occurs on both a build 8 HL2 with Code Version "68" installed and on a build 9 HL2 with Code Version "67" installed.
Cheers,
Paul WN7T

softerhardware, 2019-11-08:
Thanks. I try to fix this this weekend.

WN7T, 2019-11-08:
Thank you, Steve, for all your hard work and diligence supporting this project.

Sent from my iPhone

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

softerhardware, 2019-12-14:
Fixed in latest gateware.

Closed 2019-12-14.

Thread 126 (2019-12-14):

Gateware: Basic UART Support

softerhardware, 2019-12-14:
Gateware has HR50 support. Extend this to simple bidirectional UART support with pipe to software.

softerhardware, 2020-01-04:
Changing this to microcontroller-based IO. I would like to see a microcontroller used for IO provided it can also do the following:
* UART
* DAC for band level data
* PWM for fan
* Any other slow IO needs

The idea is to have the HL2 send the microcontroller data, the 5 control bytes from the host PC plus maybe another 3 (temperature) etc from the FPGA. That way the microcontroller has all state and can do all slow control. It would make programming IO even easier if the microcontroller supported micropython or circuitpython:

http://www.micropython.org/
https://circuitpython.org/

Currently I am looking at the ESP32, STM32 red/black pills, and the Risc-V Longan Nano. Places like https://jlcpcb.com/ also have microconrollers as standard parts in their SMT libraries for easy fabrication.

softerhardware, 2021-01-01:
One option would be to leverage the work of ucx/qcx or CentSDR:
https://github.com/ttrftech/CentSDR

Or some other standalone SDR. Then the HL2 just needs to generate IQ at an acceptable rate.

Thread 128 (2019-12-14):

Fan Control and Thermal Protection

softerhardware, 2019-12-14:

softerhardware, 2020-03-23:
This is done. See https://github.com/softerhardware/Hermes-Lite2/tree/master/hardware/enclosure/endcaps/kf7o/hl2_40b

Closed 2020-03-23.

Thread 130 (2019-12-14):

Hardware: Best PureSignal Setup

softerhardware, 2019-12-14:
There are already several PureSignal users. We need to experimentally determine the best way to feedback PA signal to the HL2. We don't want low impedance hanging off of the RX chain. What is the best attenuation? Some of the new IO boards have circuitry for Pi and T attenuators which can also translate impedance.

Thread 131 (2019-12-14):

Automatic ATU Testing and Support

softerhardware, 2019-12-14:
Currently the gateware supports talking to the IC-AH4 ATU. This needs to be tested. Additional ATU support can be added if testers step forward.

softerhardware, 2020-03-23:
This is done. My Icom AH4 is working. More field testing is required and some bugs may come up.
https://github.com/softerhardware/Hermes-Lite2/tree/master/hardware/enclosure/endcaps/kf7o/hl2_40b#atu

Closed 2020-03-23.

Thread 132 (2019-12-14):

End Plate to Support IO

softerhardware, 2019-12-14:
A prototype has been released and is being tested. More testing is required, which will probably lead to some refinements of the design.

softerhardware, 2020-03-23:
This is done. Some bug reports from more testing may come up.
https://github.com/softerhardware/Hermes-Lite2/wiki/IO

Closed 2020-03-23.

Thread 133 (2019-12-14):

Backup Image and/or CRC for Robust Gateware Updates

softerhardware, 2019-12-14:
If an error is encountered during a network gateware update, it is possible that the unit becomes unrecoverable and will required Raspberry Pi or USB blaster gateware restoration.

softerhardware, 2020-04-04:
Release 70 supports two images in the eeprom, factory and application.

Closed 2020-04-04.

Thread 135 (2019-12-14):

Port Taka's Audio Codec and Keyer Functionality

softerhardware, 2019-12-14:
Port Taka's changes in https://github.com/ji1udd/Hermes-Lite2/tree/V3_Companion to the official gateware. An additional gateware release (just like the current 6RX release) can be made to support this work.

I don't intend to do this port, but will help facilitate it if someone else steps up. I would like it to be easier to extend and add functionality to the gateware.

softerhardware, 2021-01-01:
Taka has ported his i2c support and adopted/enabled the openhpsdr keyer. This is now included as a standard variant release hl2b5up_ak4951v3.

Closed 2021-01-01.

Thread 137 (2020-01-02):

Small schematic updates

in3otd, 2020-01-02:
On page 7 of the H-Lv2 schematic the text notes referencing "pin 1" for the EXTTR and INTTR signals should be corrected (maybe simply referencing "INTTR" and "EXTTR") as they now go to other connectors/pins.

Also in the [same directory](https://github.com/softerhardware/Hermes-Lite2/tree/master/hardware/hl) the files [frontsilk.pdf](https://github.com/softerhardware/Hermes-Lite2/blob/master/hardware/hl/frontsilk.pdf) and [backsilk.pdf](https://github.com/softerhardware/Hermes-Lite2/blob/master/hardware/hl/backsilk.pdf) are for the old beta2 build and should be updated or deleted.

softerhardware, 2020-03-23:
Done

Closed 2020-03-23.

Thread 138 (2020-01-04):

HL2 Companion PA

softerhardware, 2020-01-04:
A HL2 companion PA would be a nice option to have. See this thread:
https://groups.google.com/forum/#!topic/hermes-lite/NOheAd5xABE

This github:
https://github.com/mathisschmieder/HL2-MRF101

mathisschmieder, 2020-01-31:
The layout is at a stage where I was brave enough to order 3 prototype PCBs and parts. I'll probably have them in a bit less than 2 weeks and will share my results. When it's working, I'd be happy to merge the companion PA into this repository.

softerhardware, 2020-02-01:
Great! Please issue a git pull request when ready.

Thread 139 (2020-01-07):

Failure to exit transmit mode

wb2qll, 2020-01-07:
When the PTT line from my HL2 build 9 is brought low, the HL2 and PowerSDR goes into transmit mode and the MOX button is lit. This is correct. However, in all modes except for cw, when the PTT line is opened (or the PTT cable removed from the jack) the HL2 remains in transmit mode and PowerSDR remains in transmit mode with the MOX button lit as well. This happens even if VAC is disabled throughout the PTT operation. Happens into a dummy load regardless of drive setting. This is on a Windows 7/32 bit system with the HL2 plugged directly into the computer. Transmit mode on both the HL2 and PowerSDR can be exited by pressing the MOX button.

softerhardware, 2020-01-07:
Which gateware version are you using? Software reports it as 65 or 66, etc., usually at the top of window for Quisk. Can you update to the latest testing and see if that fixes the issue? It sounds very much like a bug that was recently fixed.

[latest testing gateware](https://github.com/softerhardware/Hermes-Lite2/tree/master/gateware/bitfiles/testing/20191110_68p4)

[gateware update how to](https://github.com/softerhardware/Hermes-Lite2/wiki/Updating-Gateware)

The ethernet method with SparkSDR or Quisk is recommended.

wb2qll, 2020-01-07:
<!-- DIV {margin:0px;} -->Hi Steve, thanks for the response.I can't get Quisk to work. Python and it installed without errors but when I type "quisk" it just returns the command prompt, no error indication and no processes started. I don't expect you to take time on my issue, but I've never used Python or Quisk before so it may take some time to suss out.PowerSDR reports the firmware as 6.7I do have a USB blaster, which I've never used, but I did see you have a video on running it, so thanks again.Pete-----Original Message-----
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

softerhardware, 2020-01-07:
Hi,

SparkSDR will do network gateware upgrade. It is easy to install on Windows. Just right click on the detected radio shown in the top bar main window and select the .rbf file. SparkSDR is found here:
http://www.ihopper.org/radio/previews.htm

I think you are seeing an issue fixed in the 68 release. See the latest testing gateware link sent before and the bug reported by WN7T.

73,

Steve
kf7o

wb2qll, 2020-01-07:
<!-- DIV {margin:0px;} -->Yes, Steve, thank you very much.I got Quisk working. Jim's web page says, following the install steps "You should then be able to start Quisk with the command "quisk" or "your_install_directory\Scripts\quisk"." I guess that's not right, because that's what I did before. When I typed "python -m quisk" on a hunch it plays nicely!I can follow instructions, but if they're wrong, well....Anyway, it's gateware 67. Yes, it sounds like the same issue WN7T reported, so I guess I'm off to check out Spark.73,PeteWB2QLL-----Original Message-----
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

wb2qll, 2020-01-08:
Hi again. I followed your instructions and installed Spark and selected the  <https://github.com/softerhardware/Hermes-Lite2/blob/master/gateware/bitfiles/testing/20191110_68p4/hl2b2_main/hl2b2_main.rbf> hl2b2_main.rbf from the v68 github area. Spark ran and said programming was completed.

However now neither Spark nor any other software recognizes the HL2. I tried power cycling to no avail.

What to do now?

Tnx

Pete

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

wb2qll, 2020-01-08:
Hi Steve:

I really hate taking your time or seeming to bug you, but I have a feeling you’re going to tell me I have to use the USB blaster to get this HL2 working, since Windows software doesn’t find it.

I can’t use your nice video, because there is no longer an Altera website and the current files are named in a way that doesn’t resemble anything that you’ve specified.

Unless this is written up someplace else I haven’t found, I’ll need to know exactly what to download from github and from:

https://fpgasoftware.intel.com/13.1/?edition=web <https://fpgasoftware.intel.com/13.1/?edition=web&platform=windows> &platform=windows

I think. There’s no such entry as “programming files”.

I do intend to write up a “getting started” piece once I get a stable system.

Thanks again,

Pete

ahopper, 2020-01-08:
@wb2qll Pete, I suspect the programming issue is caused by using the wrong rbf file,  for a build 9 you needed the rbf with 5up in the name. Unfortunately there is no way for the programmer to detect and prevent this at the moment. I think this https://fpgasoftware.intel.com/?edition=lite&elq_cid=2980428&erpm_id=2702282 should have the fpga programmer.

wb2qll, 2020-01-08:
<!-- DIV {margin:0px;} -->I agree, but there wasn't any way I could tell what file I needed.That site does have the fpga programmer, but since the file names don't match your video. I have NO IDEA what to download out of that .Thanks.Pete-----Original Message-----
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

ahopper, 2020-01-08:
@wb2qll Pete,
this link is better https://fpgasoftware.intel.com/18.1/?edition=lite&platform=windows
you can either download the 'combined files' which has everything including stuff to write your own fpga code but is huge or in the 'additional software' tab you can download the stand alone programmer.

ahopper, 2020-01-08:
@wb2qll Pete,
btw for this sort of question you will probably get more help on the google group https://groups.google.com/forum/#!forum/hermes-lite

wb2qll, 2020-01-08:
<!-- DIV {margin:0px;} -->There is nothing on this page that claims to be a stand alone programmer, and I've looked many times.Also, even tho it has my name and password account set, I can't sign in, says there's a "network error" with no further explanation.-----Original Message-----
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

wb2qll, 2020-01-08:
<!-- DIV {margin:0px;} -->Also it says I must download device support but I have no idea which device support file I need, haven't seen that written up anywhere.-----Original Message-----
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

ahopper, 2020-01-08:
There is a tab called 'Additional Software' if you click that you should see 'Stand alone software' and just below that 'quartus prime programmer and tools'

wb2qll, 2020-01-08:
<!-- DIV {margin:0px;} -->Oh, thanks, got it, it was indeed there.Is this the file I need?hl2b5up_main.jicor this one?hl2b5up_6rx.jicHopefully my final question.-----Original Message-----
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

ahopper, 2020-01-08:
hl2b5up_main.jic

wb2qll, 2020-01-08:
<!-- DIV {margin:0px;} -->Great, thanks, so sorry to take up your time!Goodnight.-----Original Message-----
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

wb2qll, 2020-01-10:
I've installed gateware v68 successfully. However the PTT issue remains unfixed. The HL2 stays in transmit mode when the PTT line is opened. This happens in PowerSDR, Quisk, and SDR-Console, all current versions.

The secret to installing the USB Blaster driver was the use of a Windows 10/64 machine and installing the USB Blaster as a Blaster II.

softerhardware, 2020-01-10:
What is the PTT line? It must not be the software PTT as that I use everyday. Are you using the tip or ring of the front jack? Are you grounding the tip or ring and then releasing, or is either the tip or ring always grounded? What modes are the software in? I need a more detailed description. A video or picture would be helpful.

wb2qll, 2020-01-10:
<!-- DIV {margin:0px;} -->The PTT line is, as you told me a few days ago, the ring connector of the front jack. I am operating the hardware PTT as I do every other radio I've ever used, grounding the line for transmit and opening the connection for receive. I have not seen any other indication there was any other way of doing it. The CW key input is not connected for t/r tests.If PowerSDR is in one of the CW modes, grounding PTT works correctly and puts the HL2 into transmit. Grounding the CW (tip) initiates a signal. Ungrounding the PTT line causes the HL2 to revert to receive. This is correct.I PowerSDR is in any of the voice modes, Grounding PTT puts the HL2 into transmit and a modulated signal eventuates. When the PTT line is ungrounded the HL2 continues to transmit a modulated signal. This is incorrect. Pressing MOX takes the HL2 out of transmit and into receive. In all cases when the hardware line is grounded the MOX button lights up.What's the most convenient way to send a video to you? I can do any normal means.-----Original Message-----
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

softerhardware, 2020-01-12:
Hi Pete,
Thanks for additional details, but I can't duplicate your problem. I've tried with Quisk and PowerSDR. I insert a spare audio cable into the key/ptt jack, and then use a jumper cable on the other end to ground either the ring. The HL2 enters TX when the ring is grounded and immediately exits when released. There must be something else going on with your setup:

** Have you double checked that you are using gateware 68? PowerSDR will identify this as 6.8.
** Check for any damage to R75,R76,R77,R78,C71 and C72. Confirm with a voltmeter that if the ring or tip is not grounded, then the ring and tip are pulled to 3.3V by R75 and R76.
** Do you see the same behavior with Quisk or SparkSDR?
** Remove the PowreSDR database and reconfigure from scratch again. Maybe something in your setup is causing this.

73,

Steve
kf7o

wb2qll, 2020-01-12:
Hi Steve, thanks for checking. Before I forget, I have the HL2 working perfectly with JS8Call. Using bog-standard settings of VAC and com0com and JS8Call believes it’s talking to a TS2000 and that is what PowerSDR is set to.

As to the PTT issue, yes PowerSDR and other programs identify the gateware as 68. I’m on a deadline for work this weekend so I don’t have time to check the resistors and caps. You know the print better than I but I doubt its hardware related because the PTT operation works fine when the software is in cw modes as I’ve mentioned.

PowerSDR shows the same issue with two different computers, one Win 7/32, the other Win 10/64 so doubt it’s a database issue. I get the same problem showing up with SDRConsole and Quisk. I haven’t been able to get Spark working properly, doesn’t accept audio input from the Delta 44 sound card and it doesn’t have a cw mode, nor does it respond to the PTT line at all. The software PTT works.

Voltage on the PTT line is 3.2 whether the HL2 is in receive or transmit.

My guess is that once the software sees the PTT line is grounded, the software goes into transmit mode, as it should. But there is a failure of the HL2 to communicate to the software that the PTT is ungrounded. Thus the software keeps the HL2 in transmit when the software in the voice modes.

All I can do for now.

73,

Pete

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

softerhardware, 2020-01-14:
Hi Pete,

This is a tough one as I can't fix a bug I can't replicate. We have to figure out what the difference between your setup and my setup is. Here are a few more ideas:

** Just to eliminate something different with your switch, can you plug in an audio extension cable to the front jack and use tinfoil to either engage PTT or PTT and CW. This is what I am doing and it has always been coming out of TX.

** You can do a wireshark capture of when the PTT should be released. This will tell us who (software or HL2) is holding the transmit.

** A video of the problem can often be very helpful as it will include things we are just not thinking of right now. Just a video of your PC screen with a phone should be fine. You can post it on YouTube or e-mail it to hermeslite@gmail.com.

** I am doing final testing of gateware 69. Please try that when it is released in a few days to see if there is any difference.

** On the list, you believed for a short time that gateware 68 fixed the problem. Did gateware 68 make any difference? Is the problem intermittent so that you thought it was fixed?

73,

Steve
kf7o

wb2qll, 2020-01-14:
<!-- DIV {margin:0px;} -->OK Steve I can try. I brought the HL2 to show and tell at my club meeting last night, people were really interested. May be a few days 'til I can power it up again but I can tell you now:I've never used a switch for PTT, I'm just using an audio cable and touching one end to ground to put it into transmit.I would be happy to run Wireshark, but since I've never used it and never heard of it prior to your mentioning it, that might take a while to install and figure out. I did find the web page.I think I believed 68 made a difference because I had PowerSDR in cw mode where the PTT works properly. This may have changed between v67 and 68. It's my recollection the PTT did not come out of xmit when PowerSDR was in cw mode with v67.The issue is most definitely not intermittent.I'll get you a video when I next power it up.Thanks!Pete-----Original Message-----
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

softerhardware, 2020-01-19:
This was resolved in private e-mails. An upgrade to the latest version 68 solved the issue.

Closed 2020-01-19.

Thread 140 (2020-02-03):

linhpsdr stuttering tx audio

m5evt, 2020-02-03:
Gateware 20190907 and beyond causes linhpsdr to transmit stuttering audio. Inspection of packets in wireshark confirms a systematic pattern where some tx packets are sent from linhpsdr with a time gap of up to 23 ms between packets.

see https://groups.google.com/d/msg/hermes-lite/SjzO6YE28EY/Qk7HMe-TAgAJ

softerhardware, 2020-03-23:
M5EVT has fixed this in linhpsdr. The latest changes to the TX buffer latency should help too.

Closed 2020-03-23.

Thread 141 (2020-03-17):

PS feedback amplitude does not match openhpsdr

softerhardware, 2020-03-17:
When converting to 12-bit and 76.8MHz sampling rate, the TX feedback signal no longer matches the amplitudes that openhpsdr expects. This requires software to be set with quite different parameters to use PureSignal on HL2. Review the DSP chain here and match amplitudes with openhpsdr chain.

softerhardware, 2021-01-01:
This is a duplicate.

Closed 2021-01-01.

Thread 142 (2020-03-23):

The fan does not turn off

lb1hi, 2020-03-23:
_..Observation - not a bug because it is beta phase_
The fan does not turn off even when the temperature has dropped if the control software is off.
Restarting the control program or restarting HL2 fixes the problem and the fan turns off.

PS. If the control software (Quisk) remains switched in RX, the fan switches off as planned at 30 degrees.

PS.2 Additionally suggestion is to raise the switch-off temperature to 35 degrees.

73, Jozef

softerhardware, 2020-05-29:
This has been fixed starting with 71p0 and later.

Closed 2020-05-29.

Thread 144 (2020-05-26):

No Power on TX if First from CW

softerhardware, 2020-05-26:
See:
https://groups.google.com/d/msg/hermes-lite/BRIU6nAFEUA/CxWJ32owAgAJ

softerhardware, 2020-05-29:
Fixed in github and upcoming release. Fix verified by Simon.

Closed 2020-05-29.

Thread 148 (2020-11-22):

DHCP address lost if ethernet cable removed for short period

softerhardware, 2020-11-22:
https://groups.google.com/g/hermes-lite/c/HDf3hpbspTE/m/VxIOkCfNAwAJ

softerhardware, 2021-01-01:
This has been fixed by additions from N1DQ.

softerhardware, 2021-02-01:
Appears to still be an issue.

Alessio1983A, 2023-06-16:
> This has been fixed by additions from N1DQ.non riesco più a collegare  e a trovarlo in casa cm faccio

Thread 151 (2020-12-29):

HL2 stops streaming data when DHCP renewal happens

pjsg, 2020-12-29:
I have my HL2 using DHCP to get its address. I have the ciurrent sparksdr running on windows. After a period of time, the hl2 stops streaming data to sparksdr. It recovers instantly if you press the power button (twice) in sparksdr.

It appears that the DHCP Ack packet stops the streaming. The PCAP is attached that covers the packets of interest. This was captured on a span port for the link to the HL2 so it includes all packets send and received by the HL2:
[hl2.zip](https://github.com/softerhardware/Hermes-Lite2/files/5752247/hl2.zip)

.135 is the hl2, .124 is sparksdr, .68 is the dhcp server

I don't know how good the timestamps are, but there is the additional oddity that the sending of the data packets seems to stop just a little *before* the DHCP ack is seen. Maybe it isn't the dhcp ack, but the ARP response that causes problems.

pjsg, 2020-12-30:
Actually, I think I understand the timestamps -- it looks to me as though the capturing system typically interrupts the kernel for every 2 packets (based on the other timestamps) or on a short timeout. I think that the dhcp response was the first of two packets and so it was only marked as being received after a timeout. Thus, I think, the root cause is the reception of this packet.

Also note that this gateware is my code with the IP ids -- you can see these incrementing nicely. Unfortunately I didn't see if a ping would use the next number, or whether there are some lost packets. I'll redo the test today.

softerhardware, 2020-12-30:
Hi Philip,

Thanks for the pcap file. I did take a look last night. I see there are more DHCP options than typically seen in the ACK but could find no problems in the RTL with this. (In the past we had an issue with some options.)

To clarify, are you saying that the HL2 really stops sending after the DHCP RQST and not after the DHCP ACK as seen in the pcap file?

In your network, does a DHCP RQST result in any physical change to the connection, such as renegotiate the speed? This could cause the DHCP FSM to reset.

What happens after the HL2 stops sending data? In the FSM, the HL2 will wait for 20 seconds for the DHCP ACK. If not DHCP ACK is seen, it will wait for 5 minutes and then attempt another DHCP renewal request. Do you see that?

After the HL2 stops sending data, are you able to ping the HL2? What is the status of the 4 LEDs on the HL2?

You mention that you are using your mod with the IP ids. Is this build now timing clean? Timing issues could lead to some of the strange behavior described.

I will reduce my DHCP's lease time and capture a few DHCP renewal sequences for my network to compare.

73,

Steve
kf7o

softerhardware, 2020-12-30:
Hi Philip,

I captured several HL2 DHCP renewals on my network. The HL2 continued to send data after the renewal. The only difference I noticed was that the DHCP ACK from my server included 8 bytes of padding after the option end of 0xff. Can you enable padding on your server to see if the HL2 is sensitive to this? I can't figure out how to disable it on my. I am running https://freshtomato.org/ which uses dnsmasq for DHCP services. See the picture below.
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

I was running two 384kHz receivers for this test. To match your setup, which software, how many receivers, and what receiver bandwidth are you using?

73,

Steve
kf7o

pjsg, 2020-12-30:
I'm running 10 rx at 192k. I'm currently waiting for it to stop again. I
may have to reduce the lease time....

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

pjsg, 2020-12-30:
I figured it out -- it was the mysterious ICMP unreachable that was the
problem. I don't know why it was sent, but the unreachable handler stops
streaming. I have a mod that I'm about to test that only stops streaming if
the source port on the returned pack is 1024. I'll put up a PR.

Sorry for the confusion.

Philip

On Wed, Dec 30, 2020 at 3:30 PM Philip Gladstone <philip@gladstonefamily.net>
wrote:

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

Closed 2021-01-01.

Thread 155 (2021-01-14):

N2ADR Filter Comapnion Board - typo - Final assembly

waterwin, 2021-01-14:
Typo 1. on wiki ...Companion...

Typo 2. Below is a piture of the recommended enclosure ...picture...

Dremel (dremel)

too tight (tight enough)

https://github.com/softerhardware/Hermes-Lite2/wiki/Final-Assembly

waterwin, 2021-01-14:
Made the edits on the wiki page

Closed 2021-01-14.

Thread 156 (2021-01-14):

Typo on wiki ...Companion...

waterwin, 2021-01-14:
Typo on wiki ...Companion...

N2ADR Filter Comapnion Board

https://github.com/softerhardware/Hermes-Lite2/wiki/Final-Assembly

waterwin, 2021-01-14:
Double add to github

Closed 2021-01-14.

Thread 158 (2021-05-31):

Windows on ARM, Support?

sidd-kishan, 2021-05-31:
Please let us know when can we have an ARM64 version for Windows on ARM OS. We can help you test We have Windows on Rasberry Pi setup. Please pursue it we at Windows on Rasberry Pi community will be glad to extend support in testing your drivers and tools for ARM64.

softerhardware, 2021-06-03:
Please contact software developers. All the code in this repository is OS aganostic.

Closed 2021-06-03.

Thread 171 (2025-05-01):

TX Stuck

ta4a1, 2025-05-01:
My HL2 TX Led always on when i get options on Thetis PTT Disable is ok MOX disable but not turn of TX Led also my RX Sensevity is very very low %80 drop what happen my radio need Help please ,

Thread 172 (2025-06-26):

Hermes lite will not power up

KBCANBE, 2025-06-26:
I have been Running my Hermes for about a year and love it. I recently went out of town and powered down the unit and remove power connector and antenna connection. I left cat 5 cable plugged in. I returned several days later and attempted to power my unit up and when I supply power to the unit it does not go through the boot sequence. No lights no boot. I have been on the Facebook Hermes lite group for weeks/months asking for guidance. I have validated the voltages on the components and all seems correct the fuse is good. I should point out I am trying to boot with nothing connected to the Hermes except the power. This always worked in the past. I always started Hermes and then started Thetis and it would connect through my network. most everyone on the Facebook thread keeps telling me I have a software problem but I am certain that is not the case. The unit is not even getting into the boot sequence to attempting a connection. The only life in the thing is a relay click on power up and a relay click on power down nothing else. Does anyone have any idea what the cause of this no boot situation could be? I am concerned based on the tracing from the cat 5 cable to the chip that the chip may be damaged.

Any Help would be greatly appreciated

No lights come up when powering up

Kind Regards

Thread 173 (2025-08-03):

Link to interactive BOM on "Releases" Page goes to 404

exDB2OO, 2025-08-03:
I wanted to use the interactive BOM to build my Hermes Lite 2, but the link to the Interactive BOM on the "Releases" page goes to nowhere (Error 404)
