softerhardware/Hermes-Lite2/hardware/companions/io_jumper/io_jumper.pdf

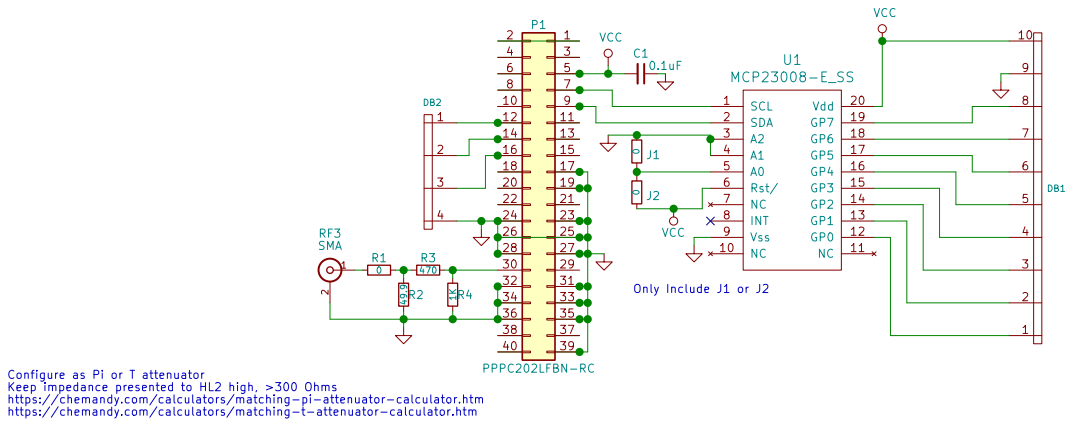
[picture p76: page 1]

9 P1 PPPC202LFBN-RC Configure as Pi or T attenuator

Keep impedance presented to HL2 high, >300 Ohms
https://chemandy.com/calculators/matching-pi-attenuator-calculator.htm
https://chemandy.com/calculators/matching-t-attenuator-calculator.htm

File: io_jumper.sch Sheet: / SofterHardware KF7O Steve Haynal

Id: 1/1 Title: Jumper Board with IO
