softerhardware/Hermes-Lite2/hardware/companions/io/io.pdf

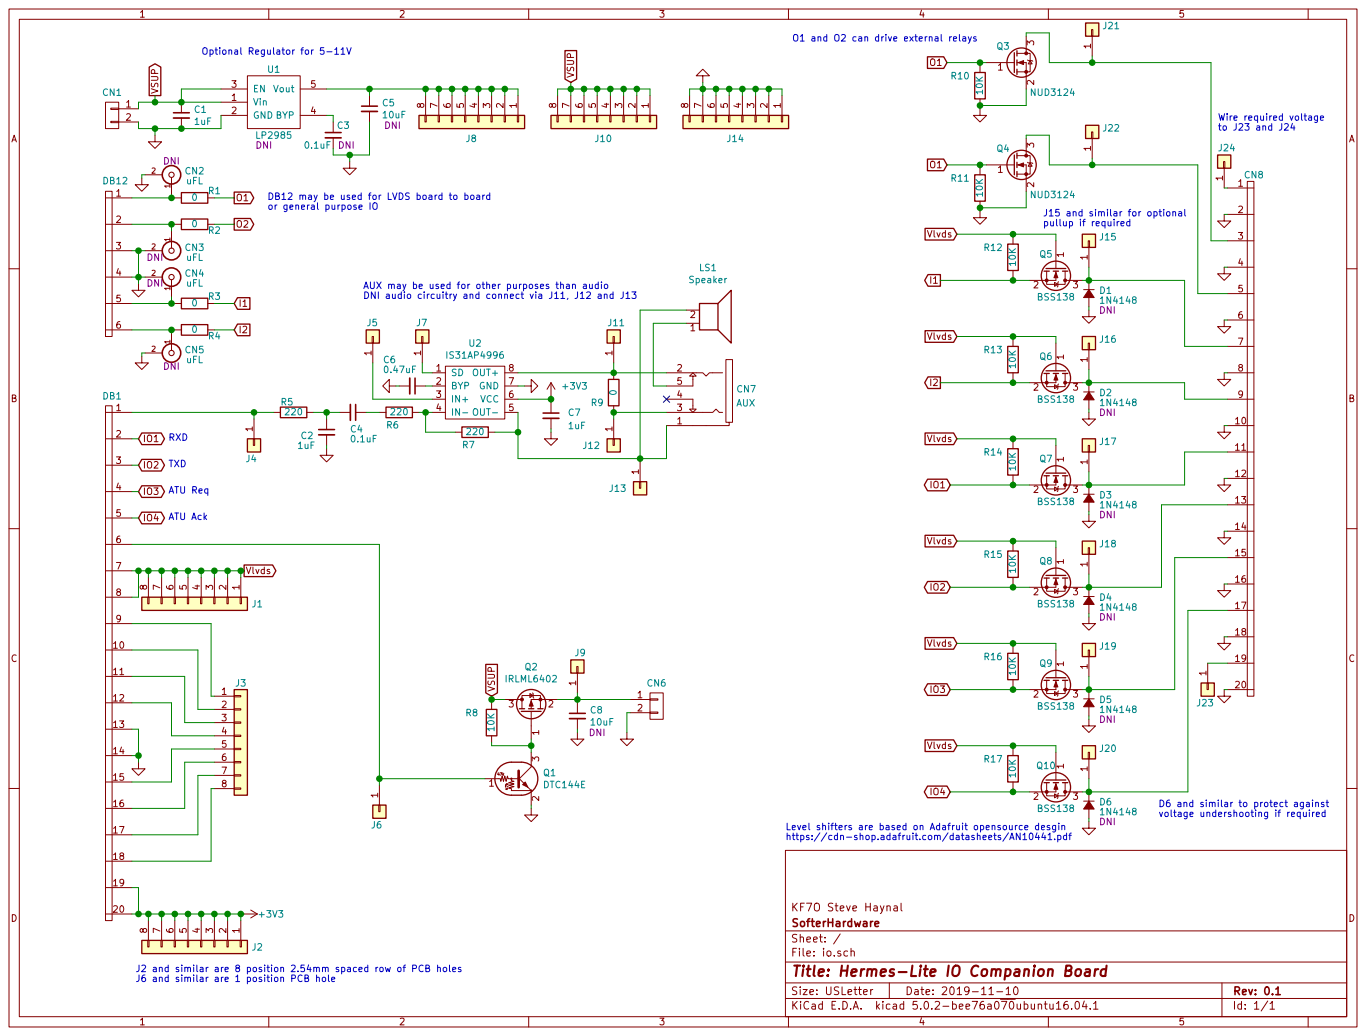
[picture p77: page 1]

O1 and O2 can drive external relays

DB12 may be used for LVDS board to board

AUX may be used for other purposes than audio
DNI audio circuitry and connect via J11, J12 and J13

D6 and similar to protect against
voltage undershooting if required

Level shifters are based on Adafruit opensource desgin
https://cdn-shop.adafruit.com/datasheets/AN10441.pdf

File: io.sch Sheet: / SofterHardware KF7O Steve Haynal

J2 and similar are 8 position 2.54mm spaced row of PCB holes
J6 and similar are 1 position PCB hole

Id: 1/1 Title: Hermes-Lite IO Companion Board
