softerhardware/Hermes-Lite2/hardware/companions/releases/n2adr_e5b9/n2adr.pdf

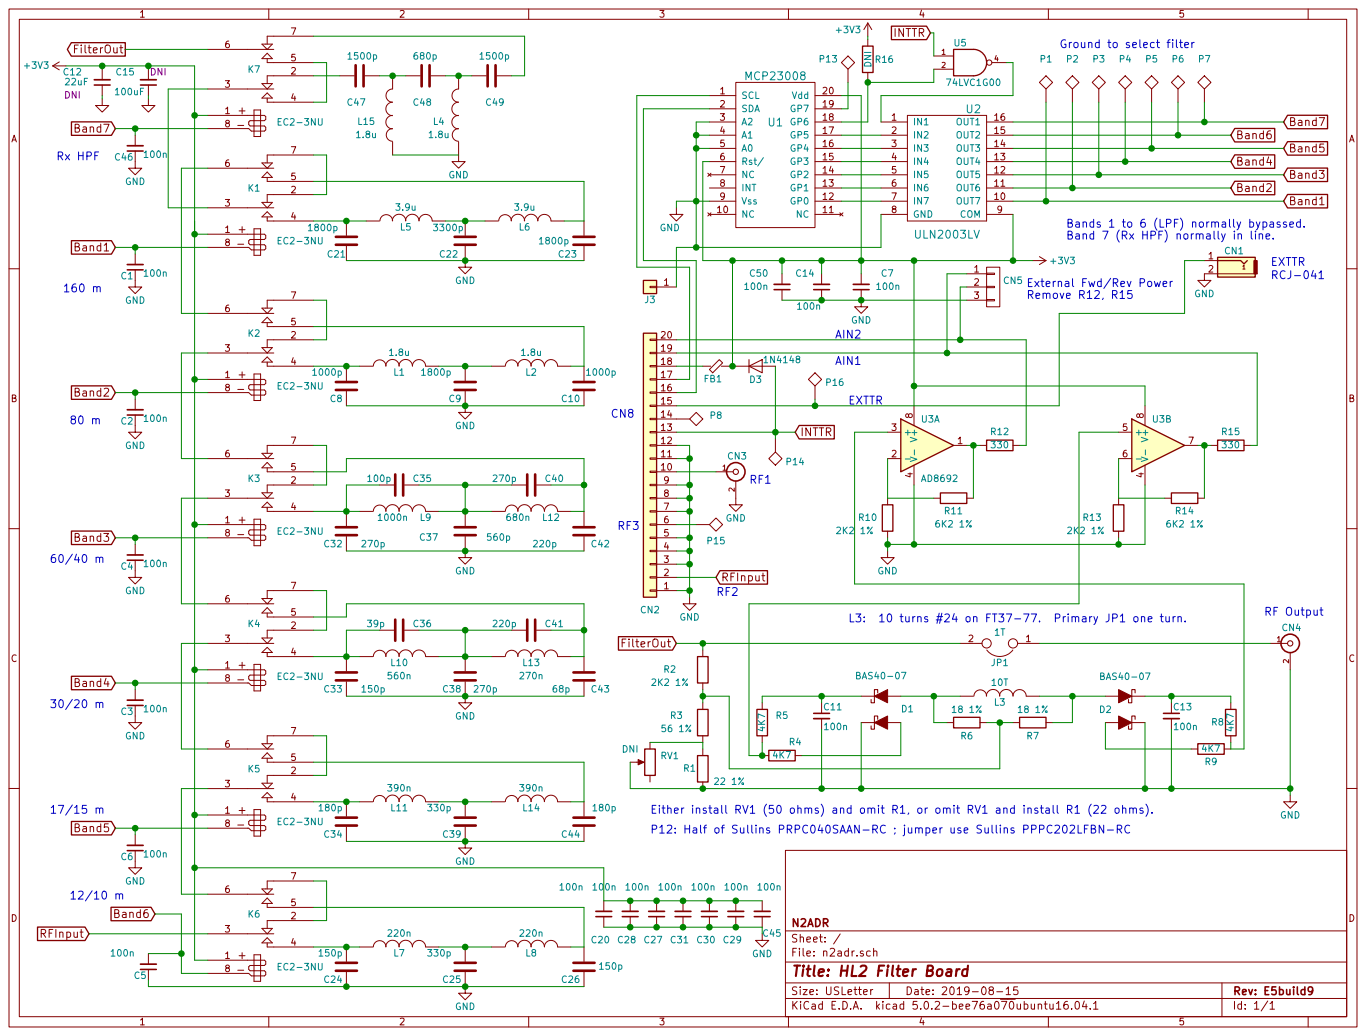
[picture p78: page 1]

IN5 5
IN6 6

Either install RV1 (50 ohms) and omit R1, or omit RV1 and install R1 (22 ohms).
P12: Half of Sullins PRPC040SAAN-RC ; jumper use Sullins PPPC202LFBN-RC

Id: 1/1 Title: HL2 Filter Board
