softerhardware/Hermes-Lite2/hardware/companions/releases/n2adr_e5/n2adr.pdf

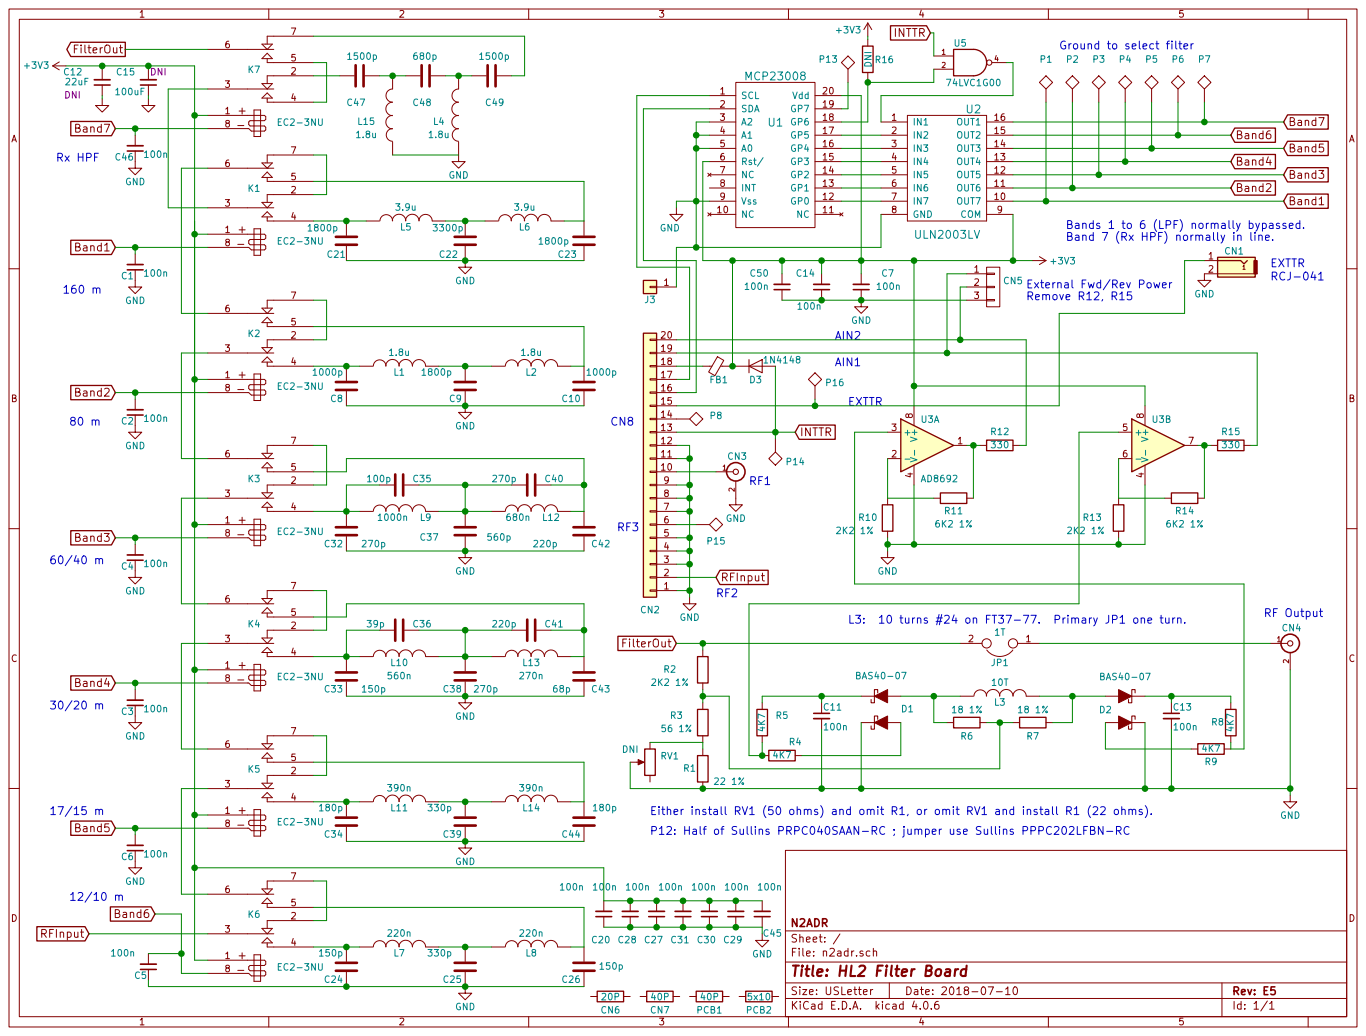
[picture p79: page 1]

SCL 1 SDA 2 A2 3 A1 4 A0 5 Rst/ 6 NC 7

IN5 5
IN6 6

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

Id: 1/1 Title: HL2 Filter Board
