softerhardware/Hermes-Lite2/hardware/hl/releases/hl2p0beta3/hermeslite.pdf

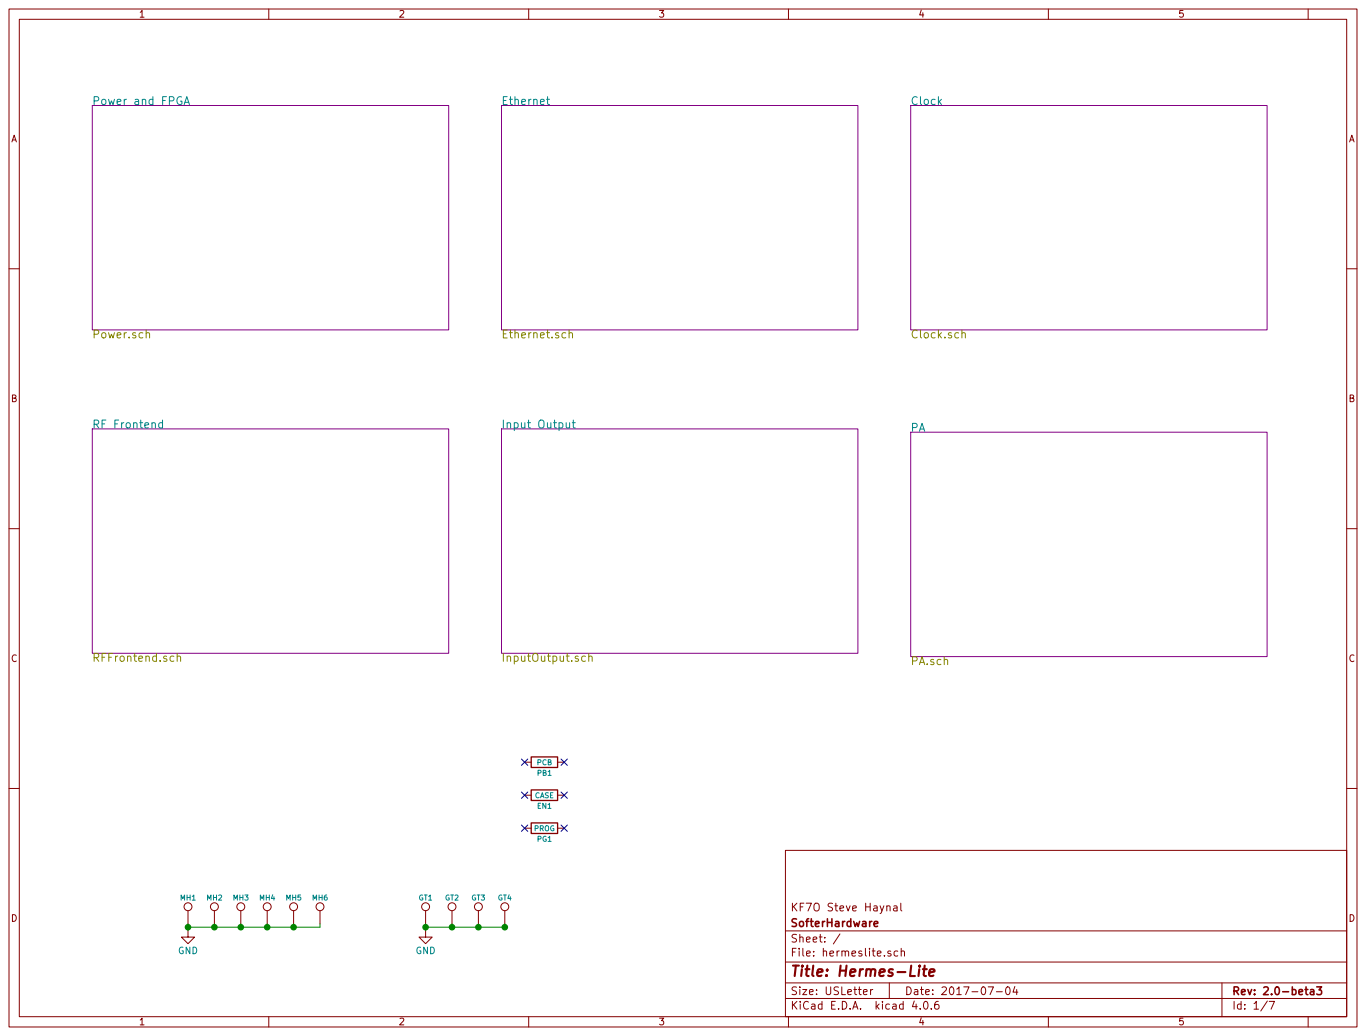
[picture p94: page 1]

Clock.sch RF Frontend RFFrontend.sch

File: hermeslite.sch Sheet: / SofterHardware KF7O Steve Haynal

Id: 1/7 Title: Hermes-Lite

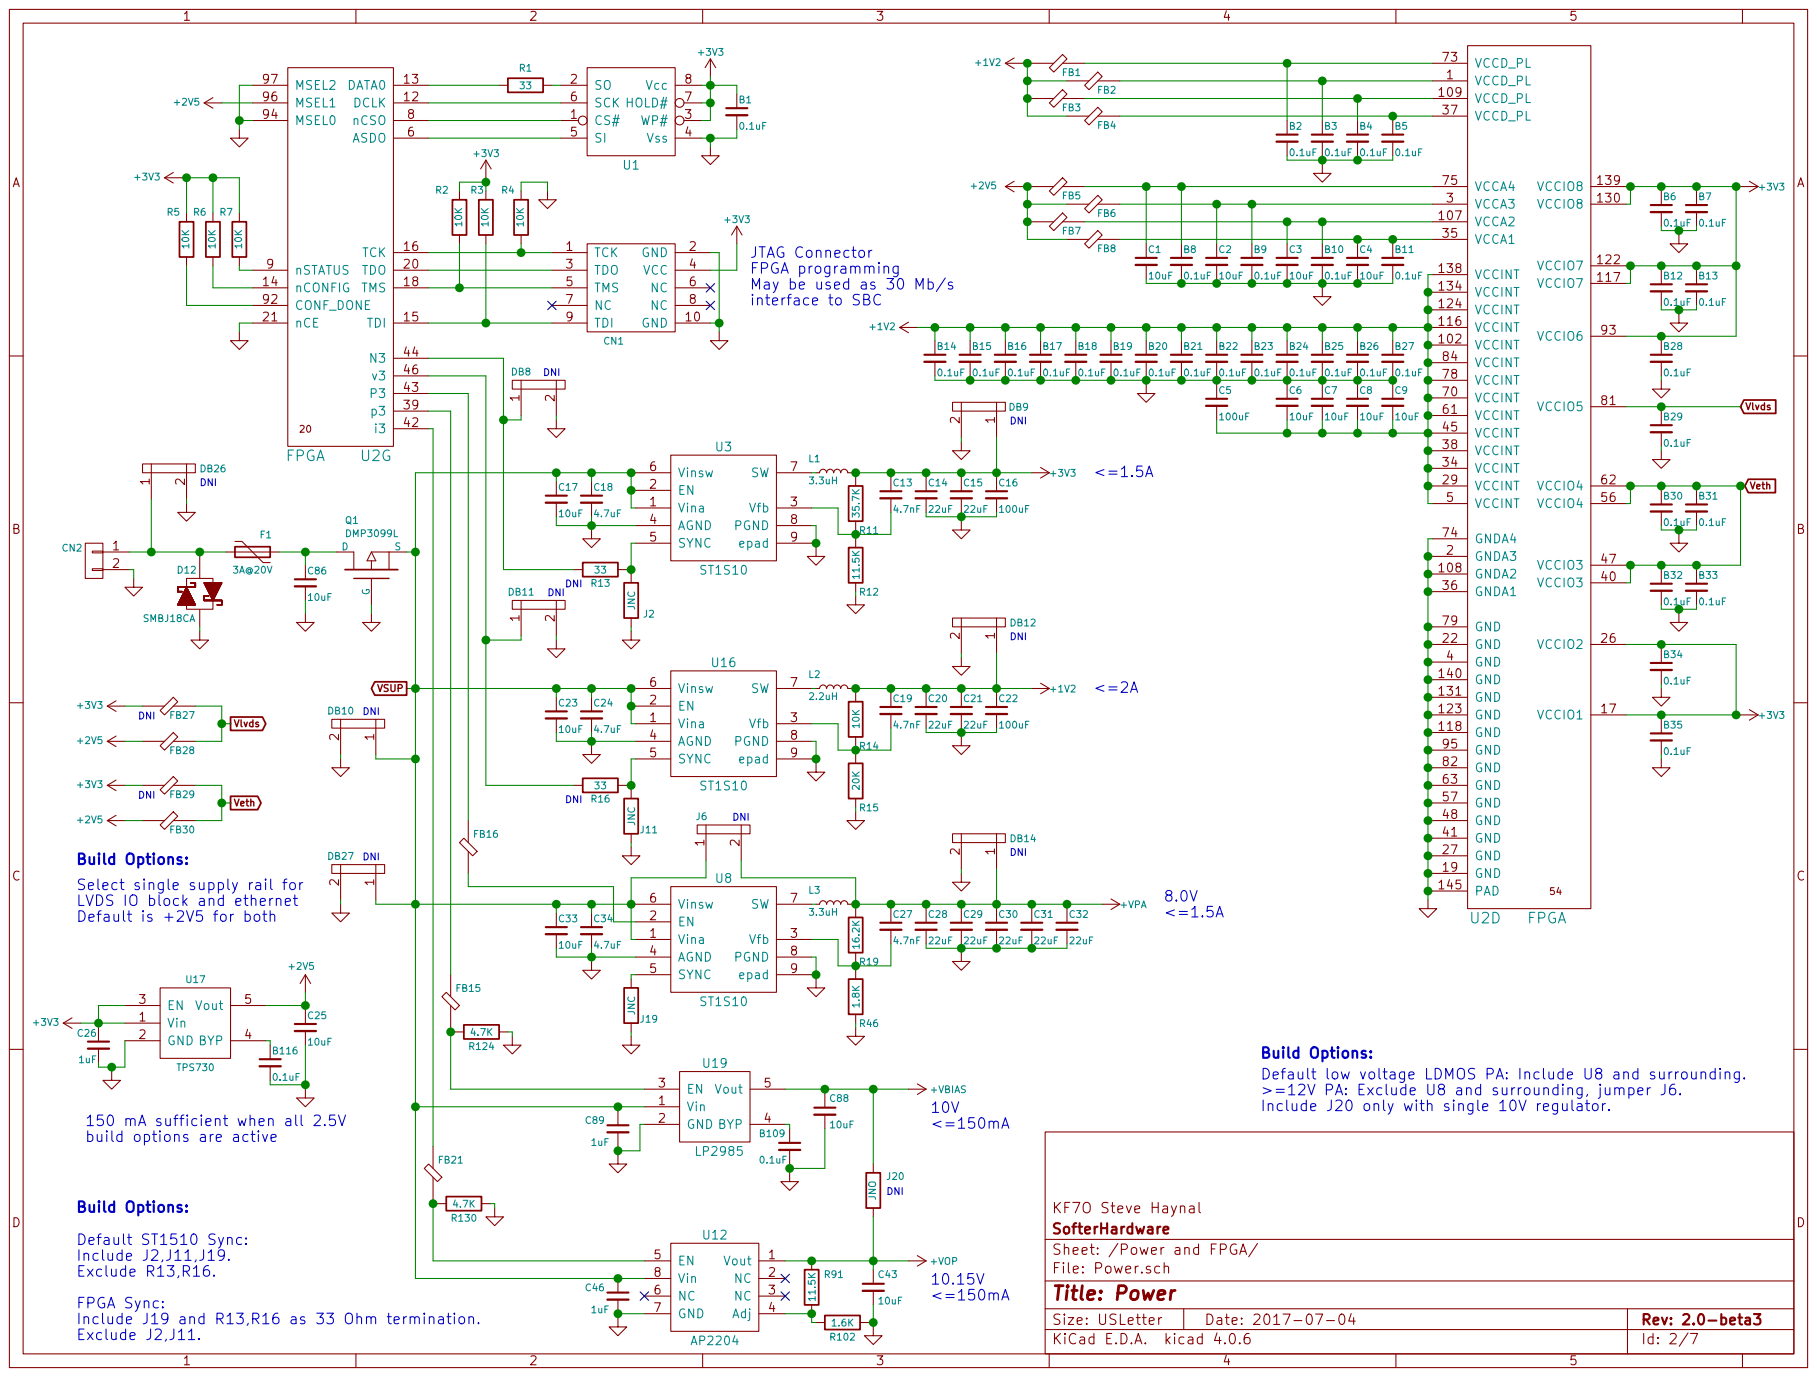
[picture p95: page 2]

FPGA programming
May be used as 30 Mb/s
interface to SBC

FB28 FB27 FB30 FB29 +3V3 +3V3 +2V5 +2V5 Select single supply rail for

<=150mA Build Options:
LVDS IO block and ethernet Default is +2V5 for both

>=12V PA: Exclude U8 and surrounding, jumper J6.

150 mA sufficient when all 2.5V
build options are active

Default ST1510 Sync:
Include J2,J11,J19.
Exclude R13,R16.
FPGA Sync:
Include J19 and R13,R16 as 33 Ohm termination.

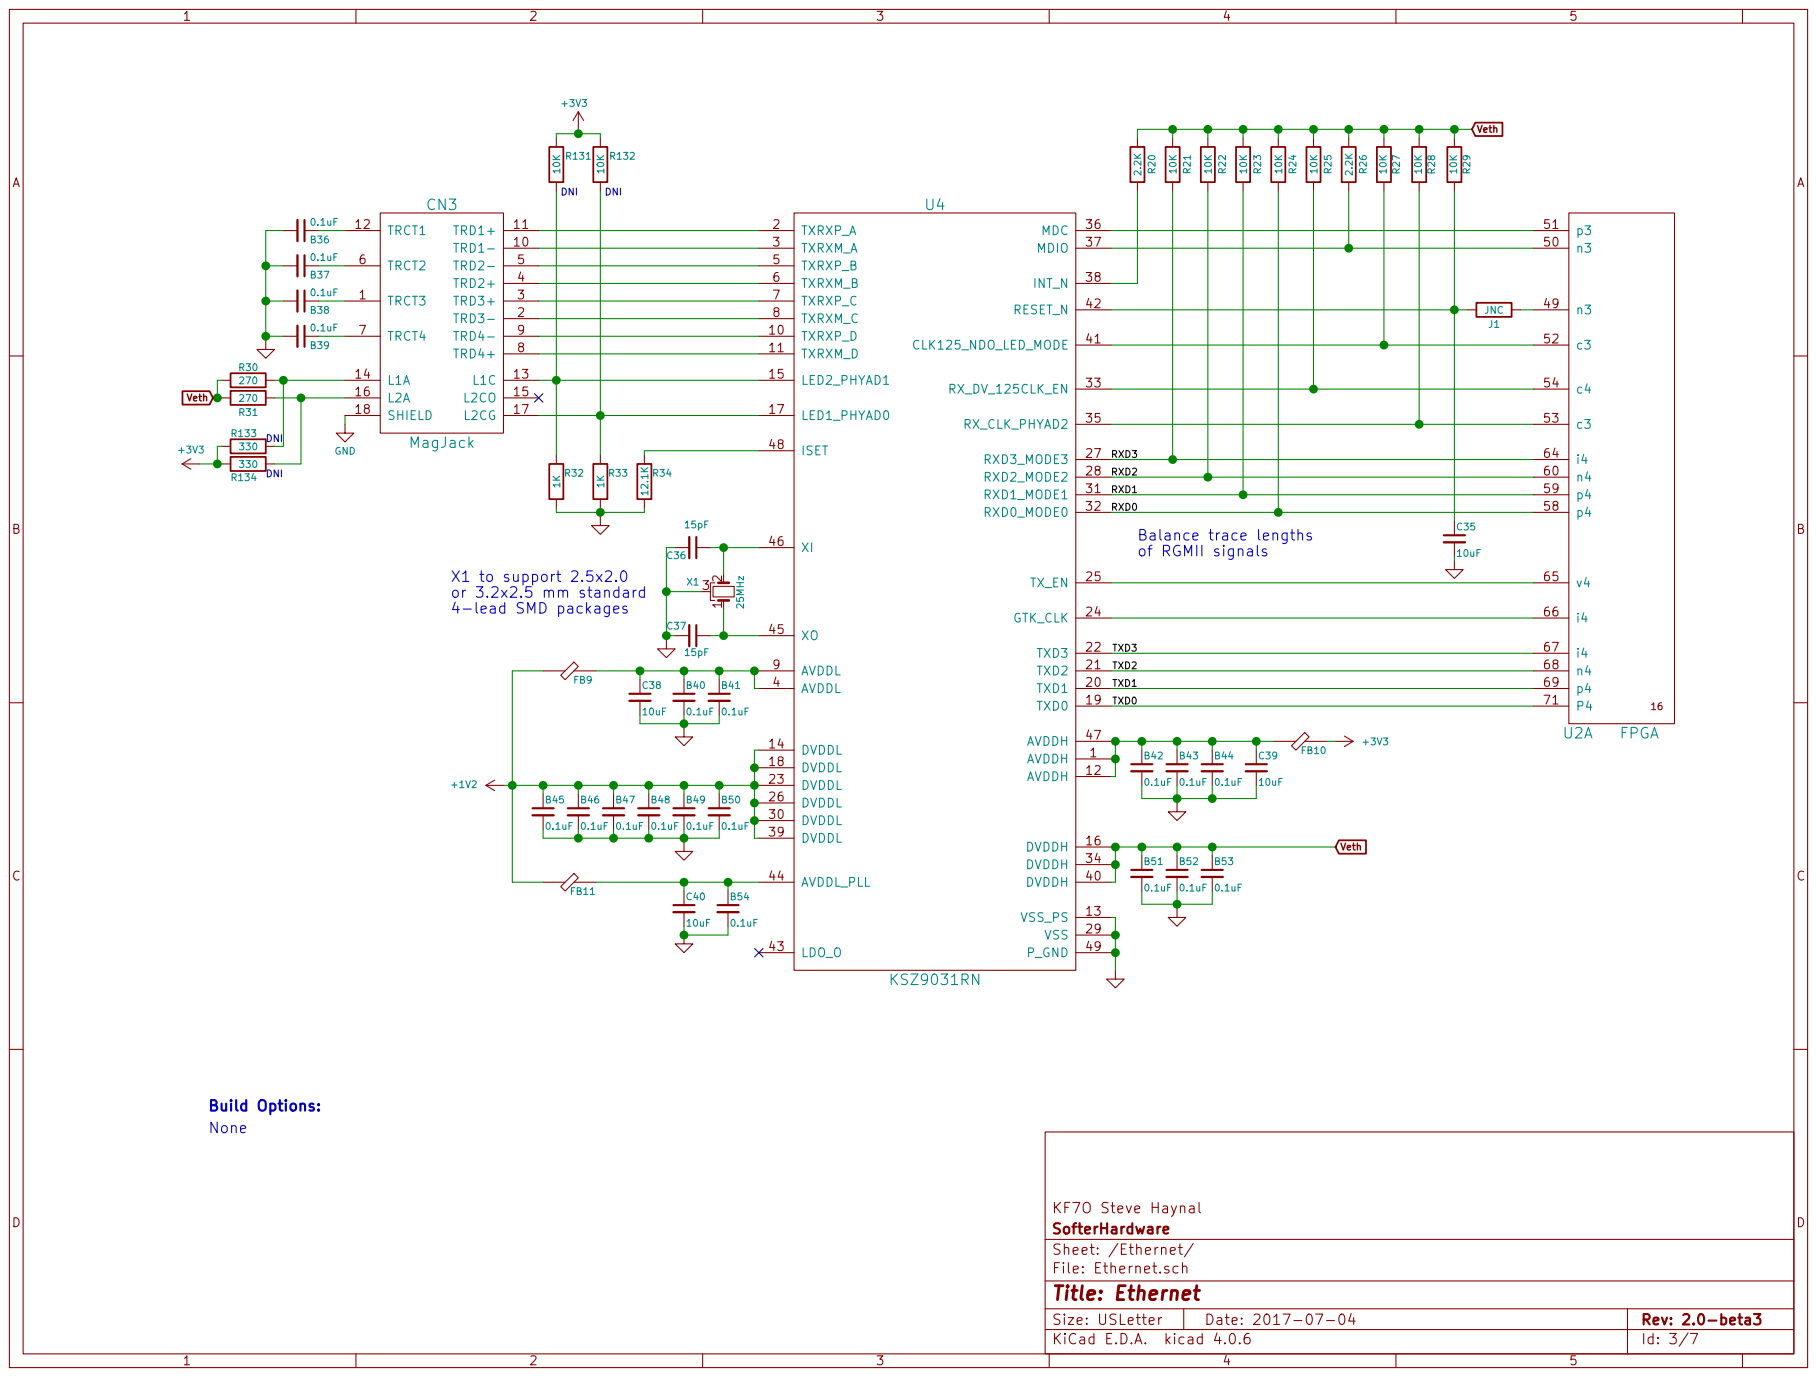
[picture p96: page 3]

Veth Build Options: None

TXD3 TXD2 TXD1 TXD0 B38

p4 59
p4 58

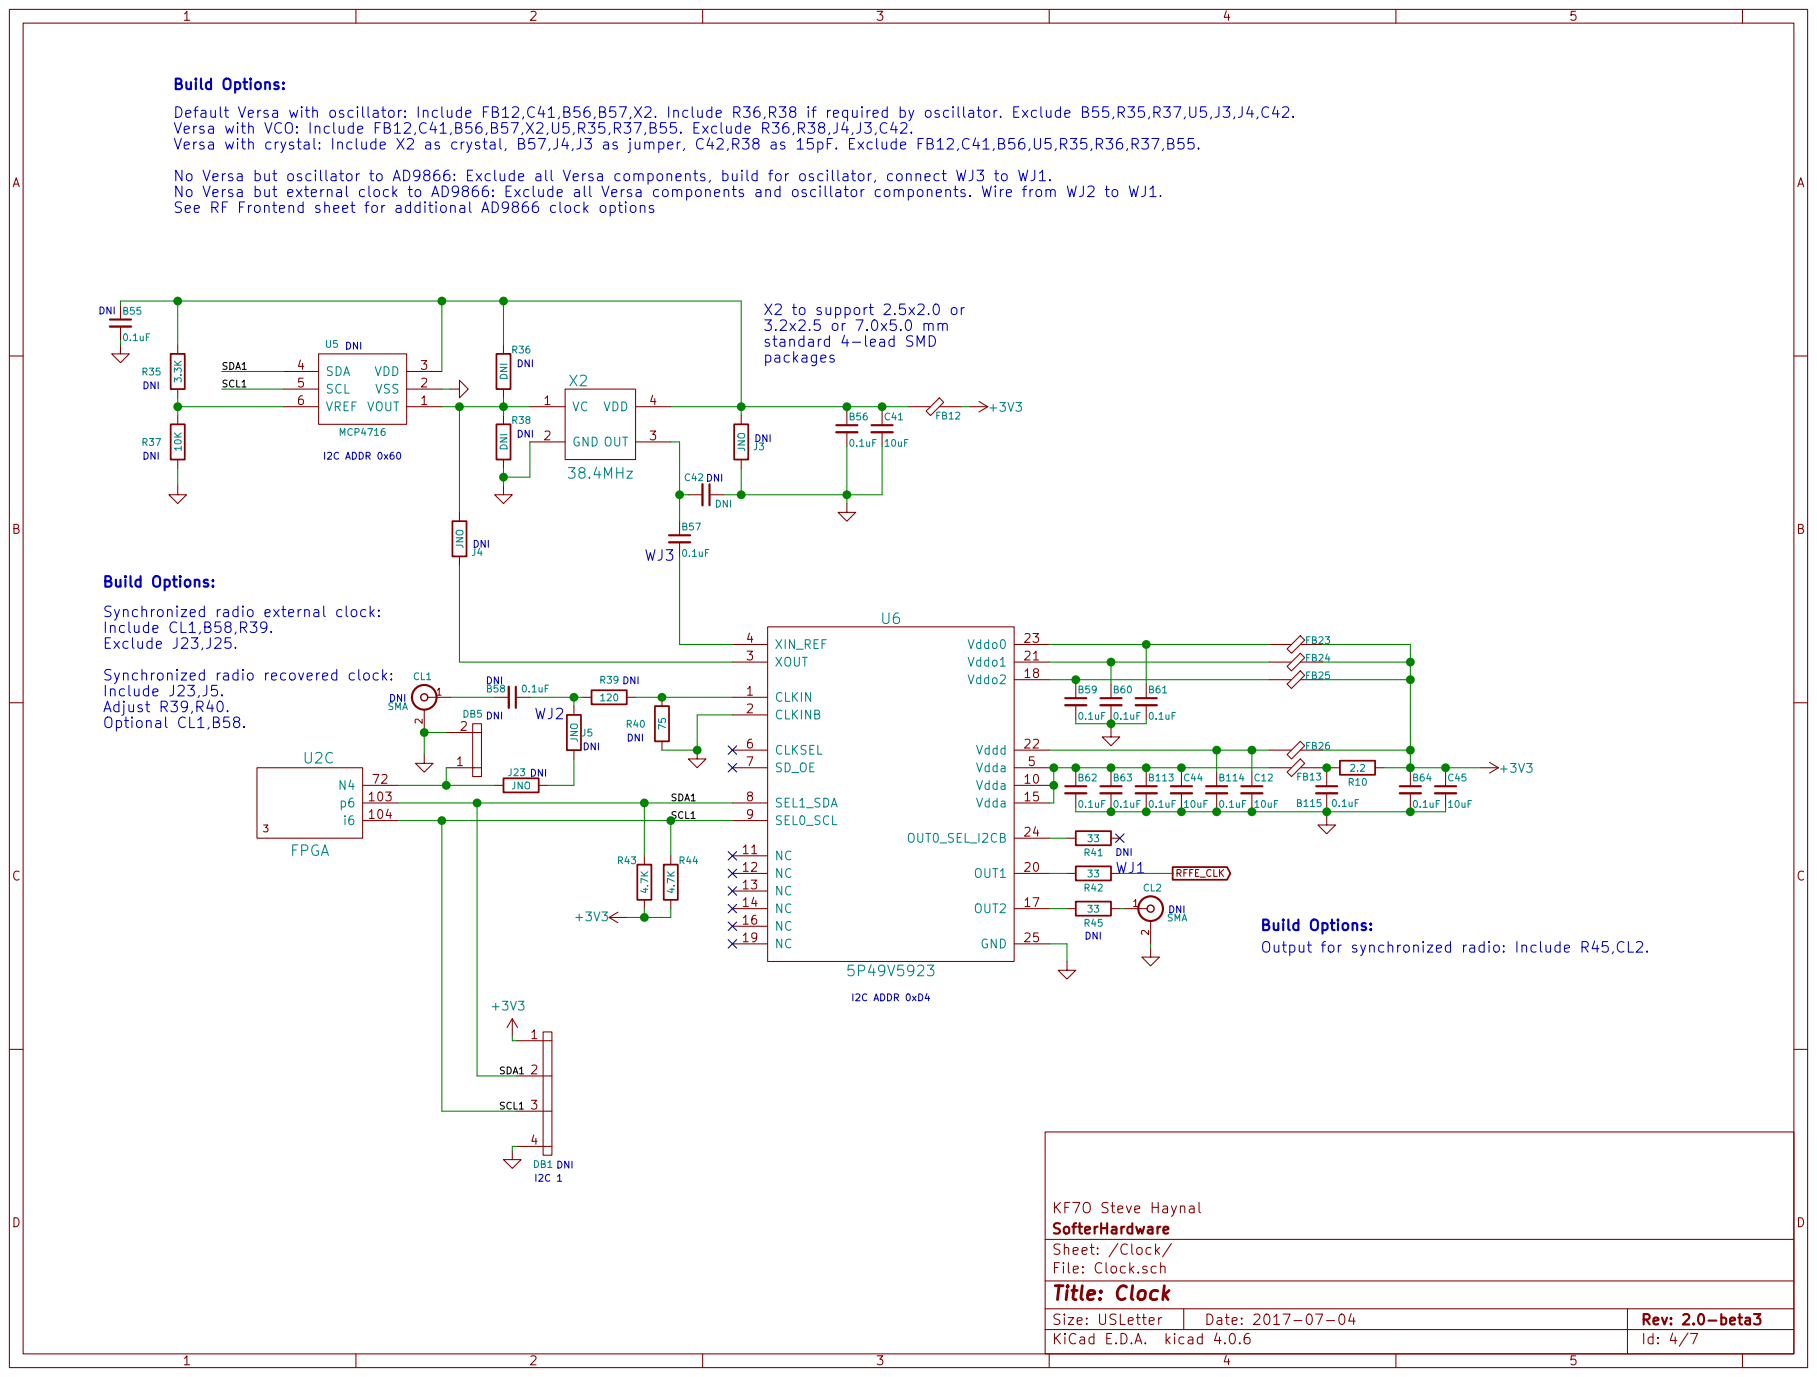
[picture p97: page 4]

Build Options:
Default Versa with oscillator: Include FB12,C41,B56,B57,X2. Include R36,R38 if required by oscillator. Exclude B55,R35,R37,U5,J3,J4,C42.
Versa with VCO: Include FB12,C41,B56,B57,X2,U5,R35,R37,B55. Exclude R36,R38,J4,J3,C42.
Versa with crystal: Include X2 as crystal, B57,J4,J3 as jumper, C42,R38 as 15pF. Exclude FB12,C41,B56,U5,R35,R36,R37,B55.
No Versa but oscillator to AD9866: Exclude all Versa components, build for oscillator, connect WJ3 to WJ1.
No Versa but external clock to AD9866: Exclude all Versa components and oscillator components. Wire from WJ2 to WJ1.

X2 to support 2.5x2.0 or 3.2x2.5 or 7.0x5.0 mm
standard 4-lead SMD
packages

Output for synchronized radio: Include R45,CL2.

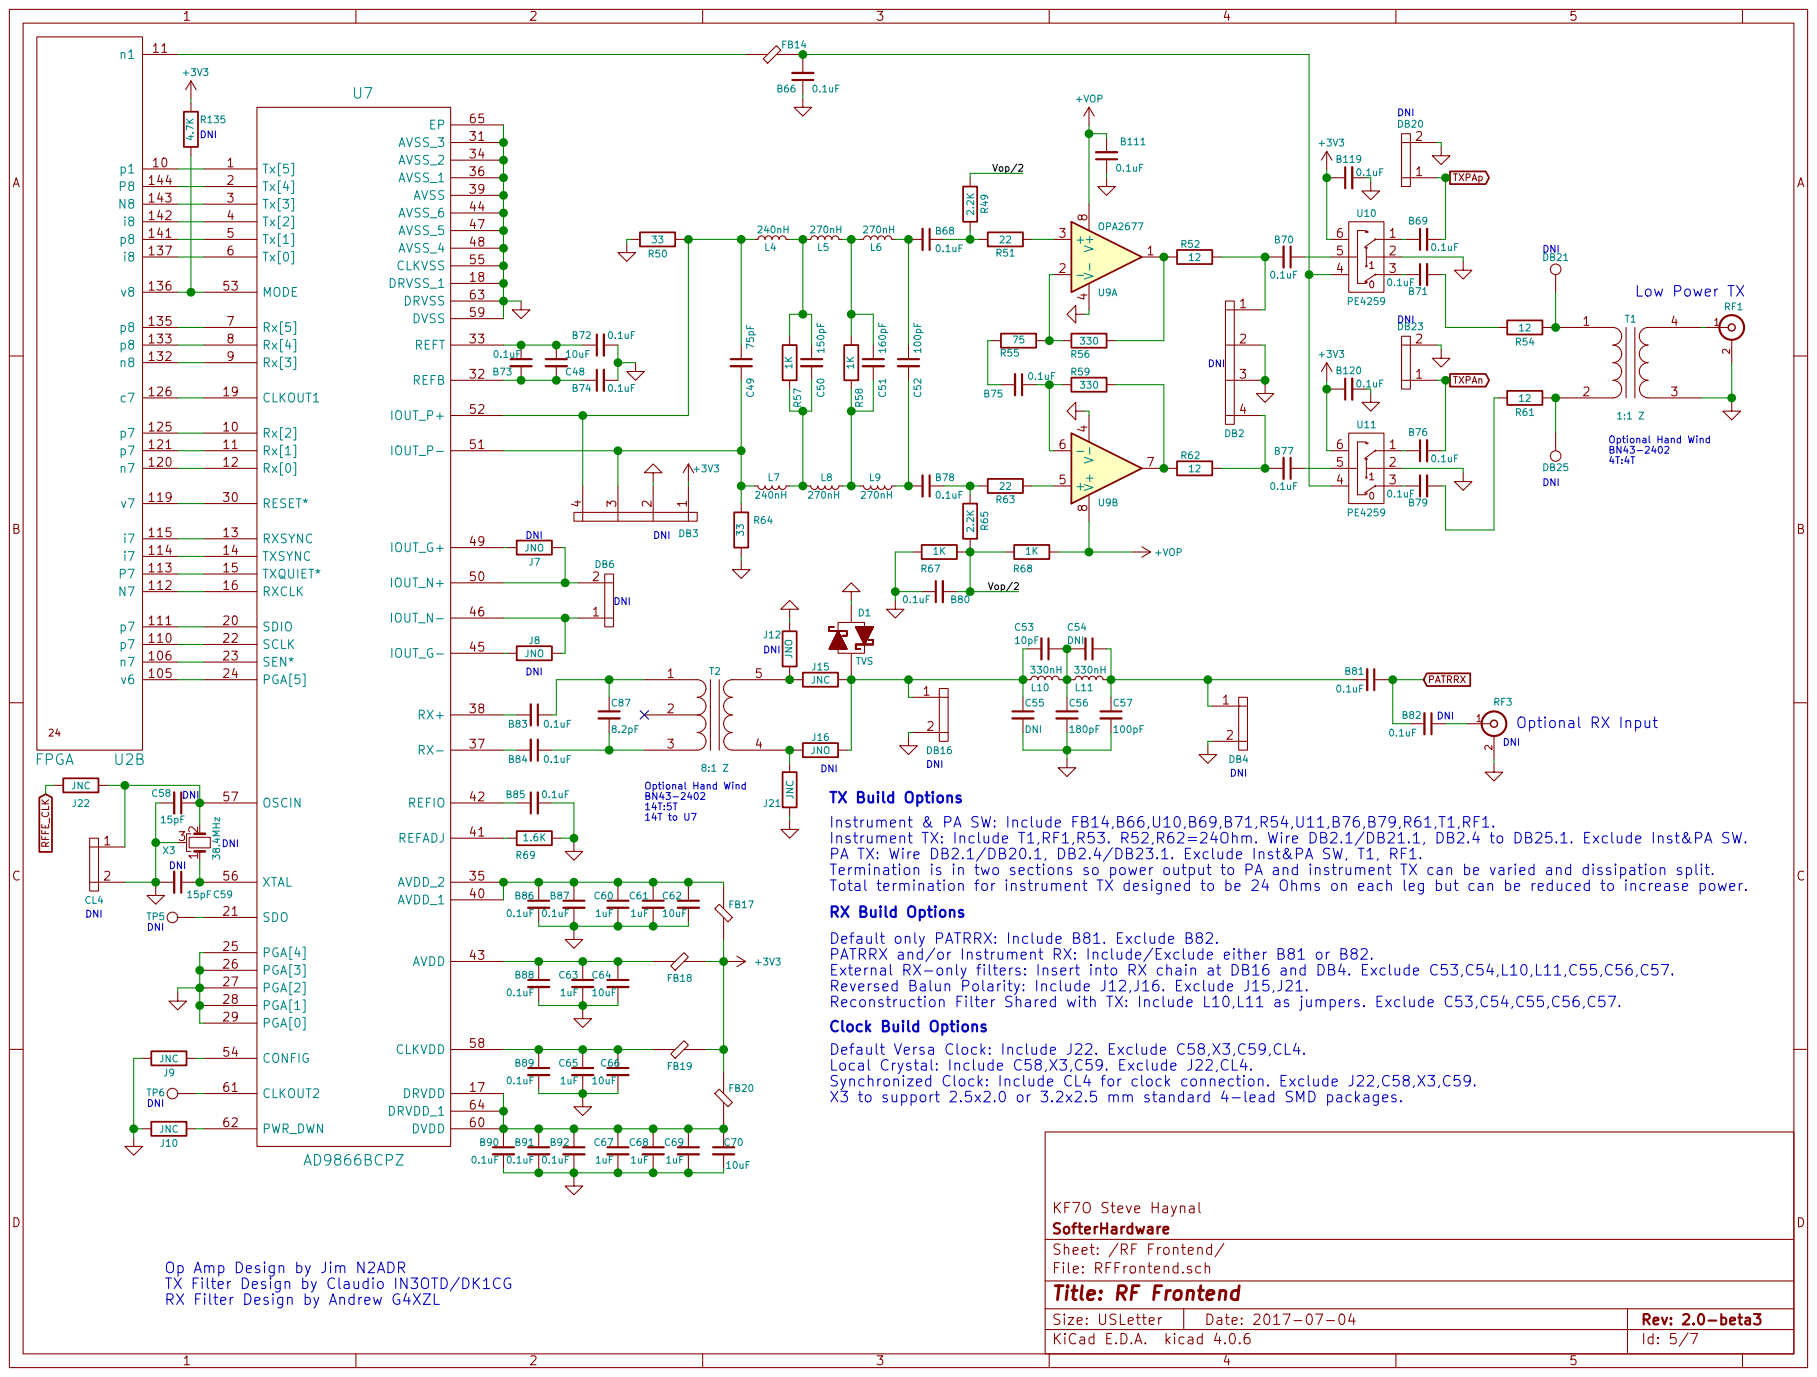
[picture p98: page 5]

2 | JNC

TX Build Options
Instrument & PA SW: Include FB14,B66,U10,B69,B71,R54,U11,B76,B79,R61,T1,RF1.
Instrument TX: Include T1,RF1,R53. R52,R62=24Ohm. Wire DB2.1/DB21.1, DB2.4 to DB25.1. Exclude Inst&PA SW.
PA TX: Wire DB2.1/DB20.1, DB2.4/DB23.1. Exclude Inst&PA SW, T1, RF1.
Termination is in two sections so power output to PA and instrument TX can be varied and dissipation split.
Total termination for instrument TX designed to be 24 Ohms on each leg but can be reduced to increase power.
RX Build Options

File: RFFrontend.sch Sheet: /RF Frontend/ SofterHardware KF7O Steve Haynal B87

PATRRX and/or Instrument RX: Include/Exclude either B81 or B82.
External RX-only filters: Insert into RX chain at DB16 and DB4. Exclude C53,C54,L10,L11,C55,C56,C57.
Reversed Balun Polarity: Include J12,J16. Exclude J15,J21.
Reconstruction Filter Shared with TX: Include L10,L11 as jumpers. Exclude C53,C54,C55,C56,C57.
Clock Build Options
Default Versa Clock: Include J22. Exclude C58,X3,C59,CL4.
Local Crystal: Include C58,X3,C59. Exclude J22,CL4.
Synchronized Clock: Include CL4 for clock connection. Exclude J22,C58,X3,C59.
X3 to support 2.5x2.0 or 3.2x2.5 mm standard 4-lead SMD packages.

TX Filter Design by Claudio IN3OTD/DK1CG
RX Filter Design by Andrew G4XZL

Id: 5/7 Title: RF Frontend

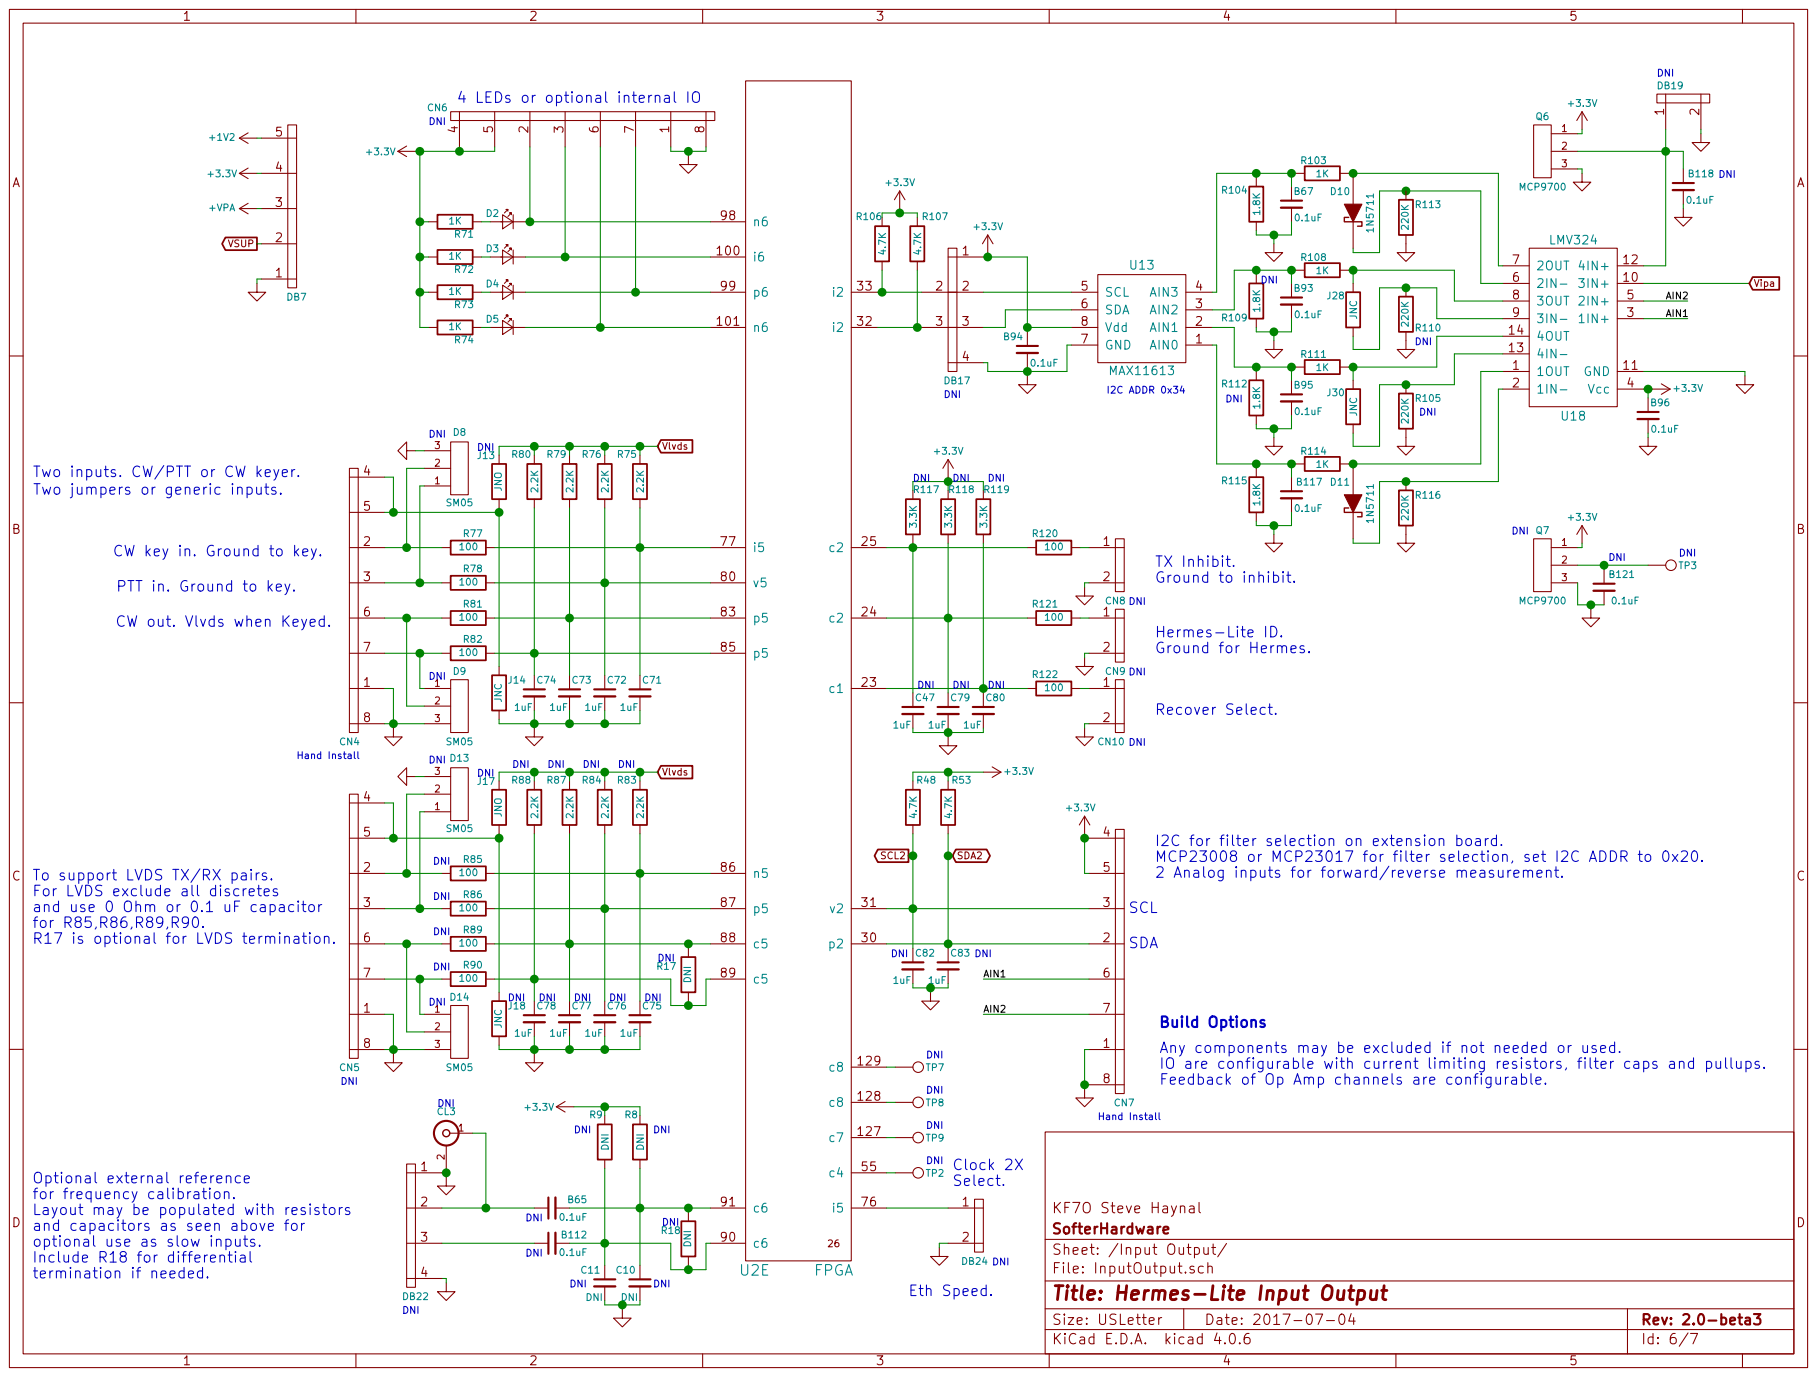
[picture p99: page 6]

8 CN6 4 LEDs or optional internal IO

Two inputs. CW/PTT or CW keyer.

3 | 100 R78 | v5 80

TP3 CW key in. Ground to key.
PTT in. Ground to key.

100 To support LVDS TX/RX pairs.

I2C for filter selection on extension board.
MCP23008 or MCP23017 for filter selection, set I2C ADDR to 0x20.
2 Analog inputs for forward/reverse measurement.

For LVDS exclude all discretes
and use 0 Ohm or 0.1 uF capacitor
for R85,R86,R89,R90.
R17 is optional for LVDS termination.

c6 91 | AIN2 AIN1 7

Any components may be excluded if not needed or used.
IO are configurable with current limiting resistors, filter caps and pullups.

for frequency calibration.
Layout may be populated with resistors
and capacitors as seen above for
optional use as slow inputs.
Include R18 for differential

Sheet: /Input Output/ SofterHardware KF7O Steve Haynal

File: InputOutput.sch
Id: 6/7 Title: Hermes-Lite Input Output

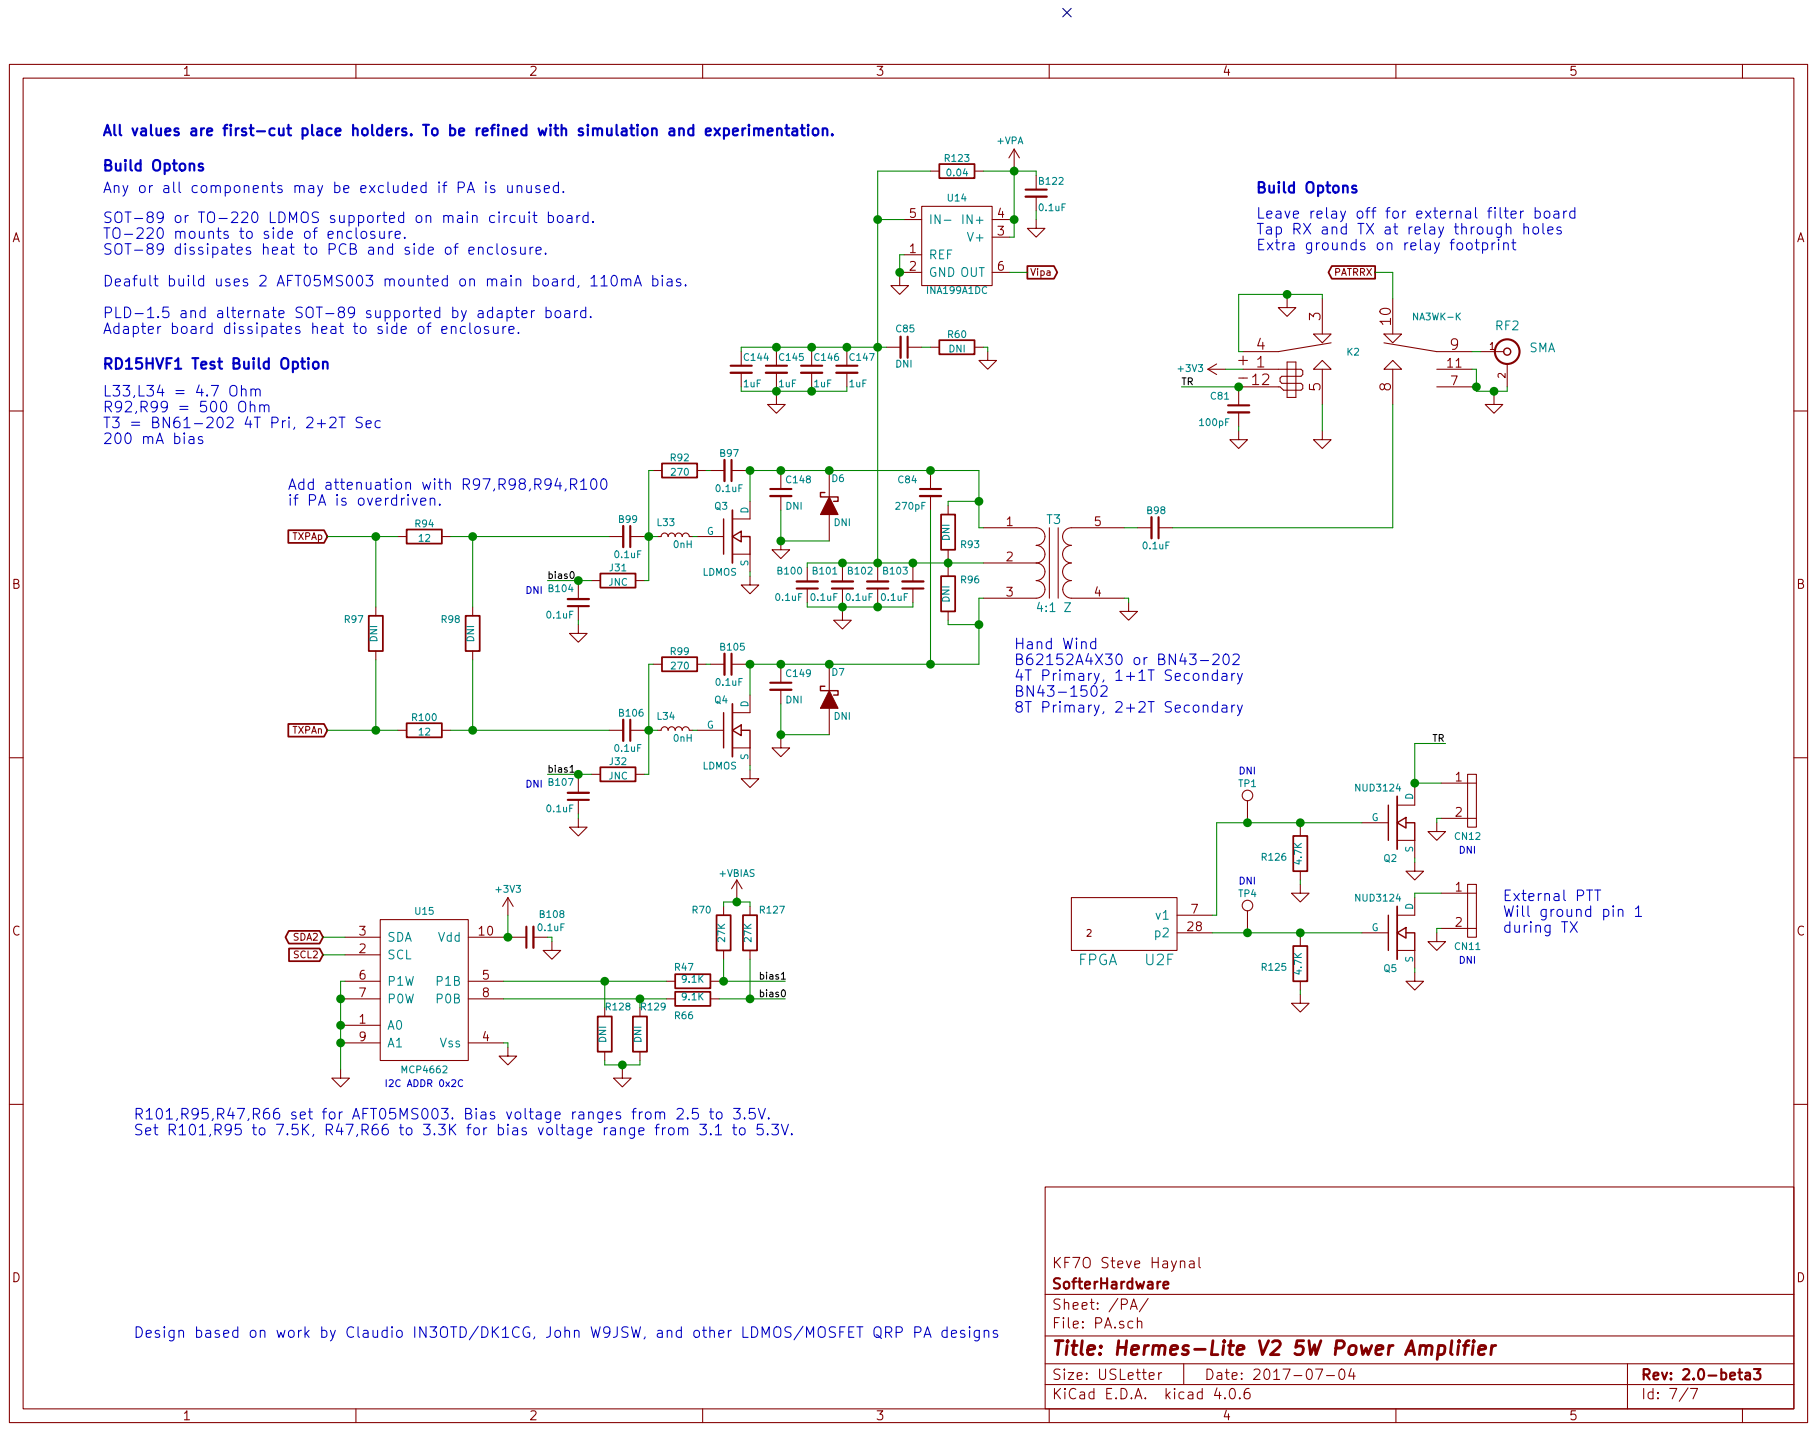
[picture p100: page 7]

TXPAp TXPAn All values are first-cut place holders. To be refined with simulation and experimentation.

2CN12 Build Optons
Extra grounds on relay footprint1

Build Optons
Any or all components may be excluded if PA is unused.
SOT-89 or TO-220 LDMOS supported on main circuit board.
TO-220 mounts to side of enclosure.
SOT-89 dissipates heat to PCB and side of enclosure.
Deafult build uses 2 AFT05MS003 mounted on main board, 110mA bias.
PLD-1.5 and alternate SOT-89 supported by adapter board.
T3 = BN61-202 4T Pri, 2+2T Sec 200 mA bias RD15HVF1 Test Build Option

Leave relay off for external filter board
Tap RX and TX at relay through holes

S D Q5 NUD3124 R125 4.7K External PTT Will ground pin 1

Id: 7/7 Title: Hermes-Lite V2 5W Power Amplifier File: PA.sch Sheet: /PA/ SofterHardware KF7O Steve Haynal bias1

9.1K R101,R95,R47,R66 set for AFT05MS003. Bias voltage ranges from 2.5 to 3.5V.

Set R101,R95 to 7.5K, R47,R66 to 3.3K for bias voltage range from 3.1 to 5.3V.

Design based on work by Claudio IN3OTD/DK1CG, John W9JSW, and other LDMOS/MOSFET QRP PA designs
