softerhardware/Hermes-Lite2/hardware/enclosure/endcaps/kf7o/hl2_40b/endcap.pdf

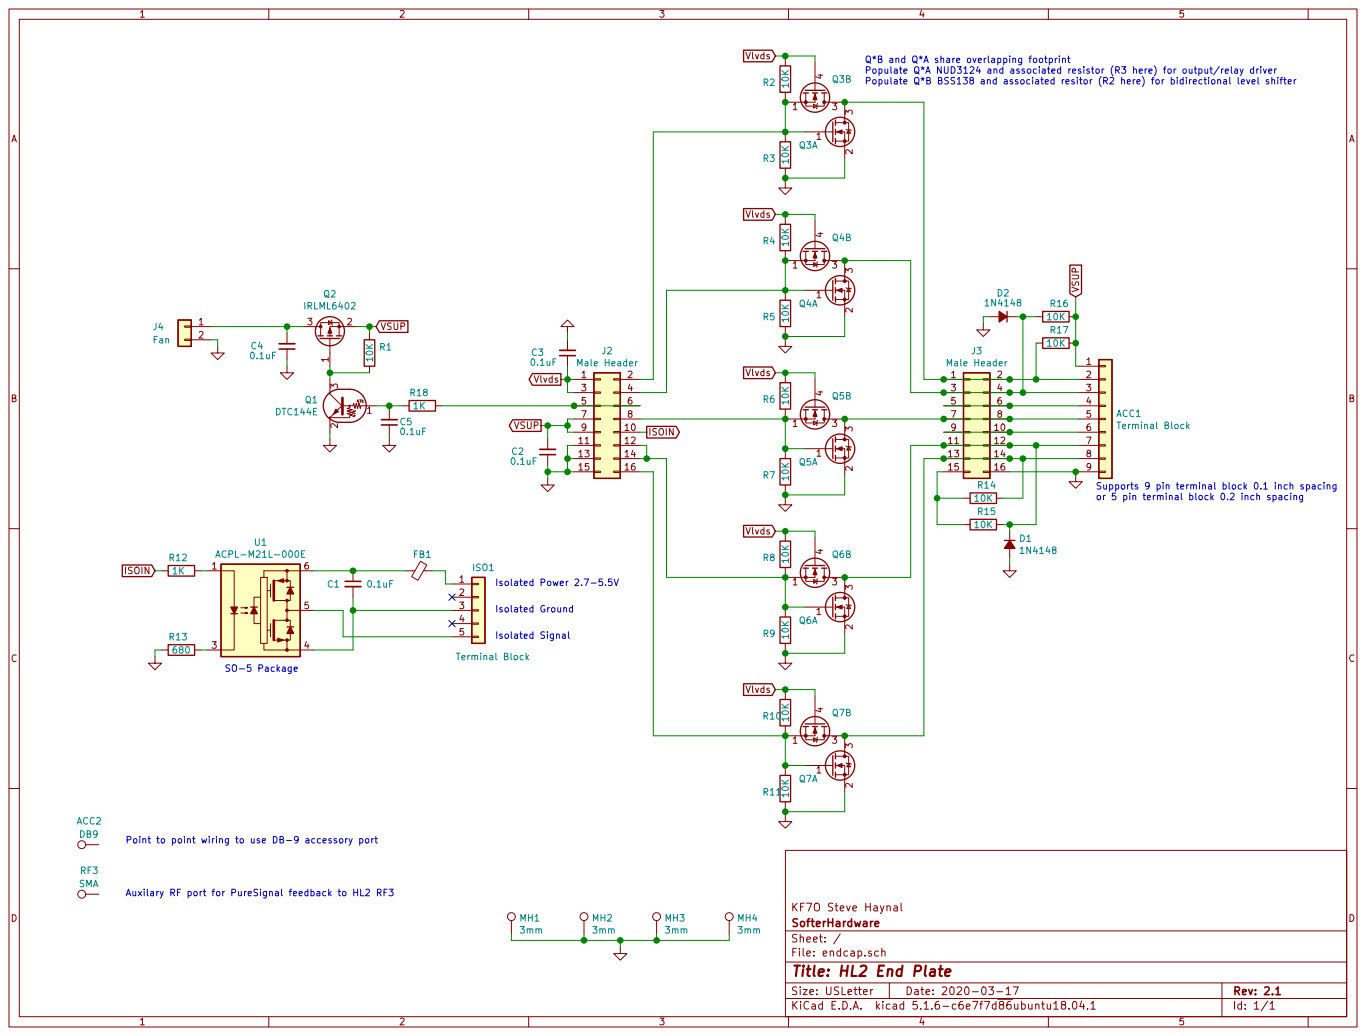
[picture p108: page 1]

Populate Q*A NUD3124 and associated resistor (R3 here) for output/relay driver
Populate Q*B BSS138 and associated resitor (R2 here) for bidirectional level shifter

Supports 9 pin terminal block 0.1 inch spacing
or 5 pin terminal block 0.2 inch spacing

Isolated Signal Isolated Ground Point to point wiring to use DB-9 accessory port

Auxilary RF port for PureSignal feedback to HL2 RF3

File: endcap.sch Sheet: / SofterHardware KF7O Steve Haynal

Id: 1/1 Title: HL2 End Plate
