softerhardware/Hermes-Lite2/hardware/companions/psfeedback/psfeedback.pdf

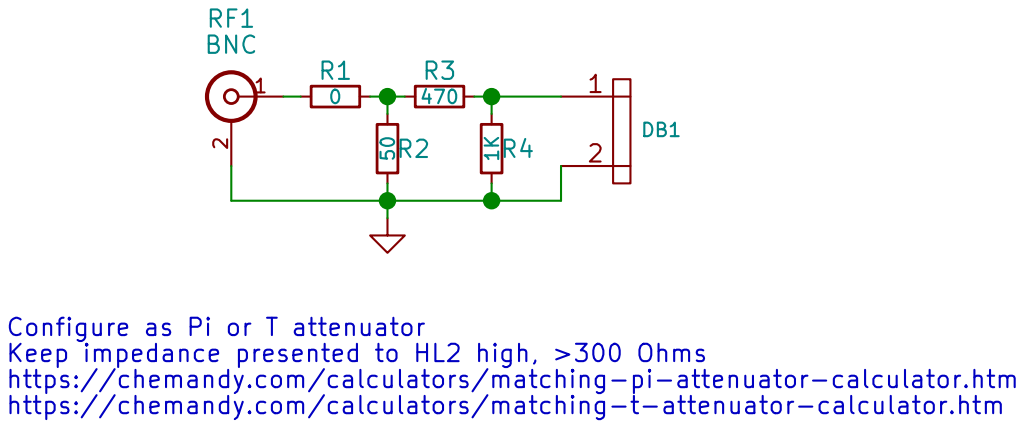
[picture p109: page 1]
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

File: psfeedback.sch Sheet: / SofterHardware KF7O Steve Haynal

Id: 1/1 Title: PureSignal Feedback
