softerhardware/Hermes-Lite2/hardware/companions/db9/db9.pdf

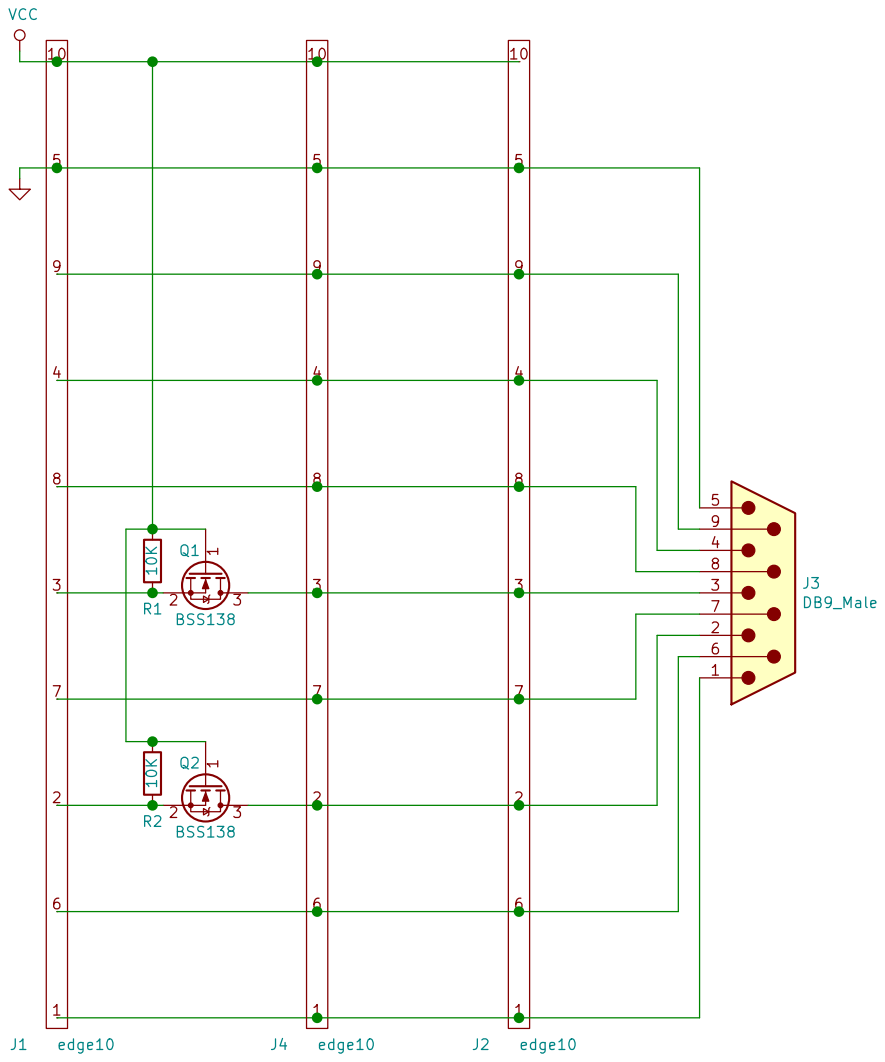
[picture p110: page 1]
