softerhardware/Hermes-Lite2/hardware/companions/smallio/smallio.pdf

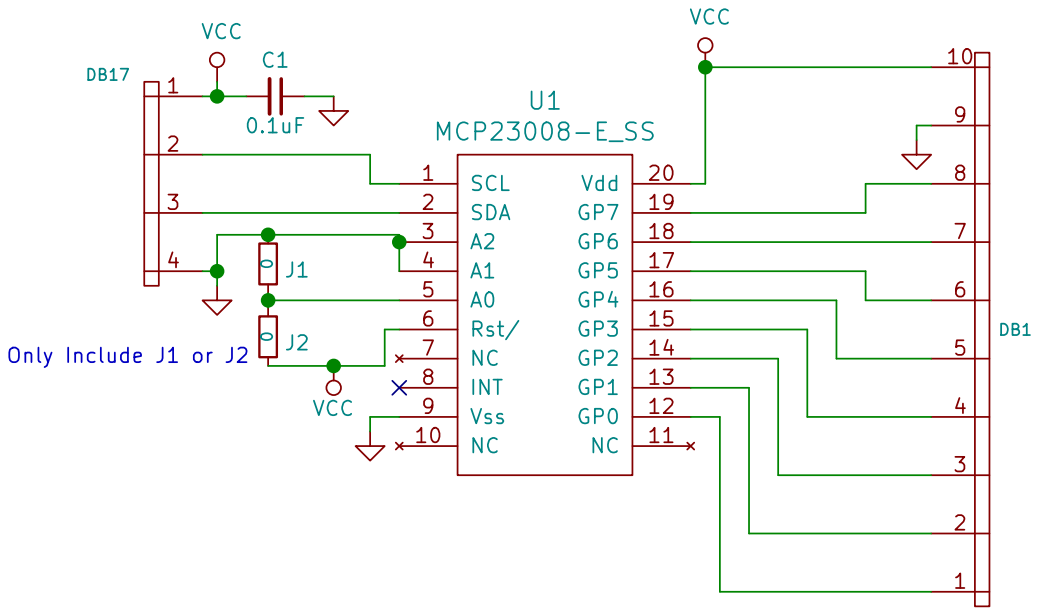
[picture p111: page 1]

File: smallio.sch Sheet: / SofterHardware KF7O Steve Haynal

Id: 1/1 Title: Hermes-Lite Small IO Expansion
