softerhardware/Hermes-Lite2/hardware/enclosure/endcaps/kf7o/hl2_55b/endcap.kicad_pcb

## KiCad design hardware/enclosure/endcaps/kf7o/hl2_55b/endcap.kicad_pcb (2020-03-30)

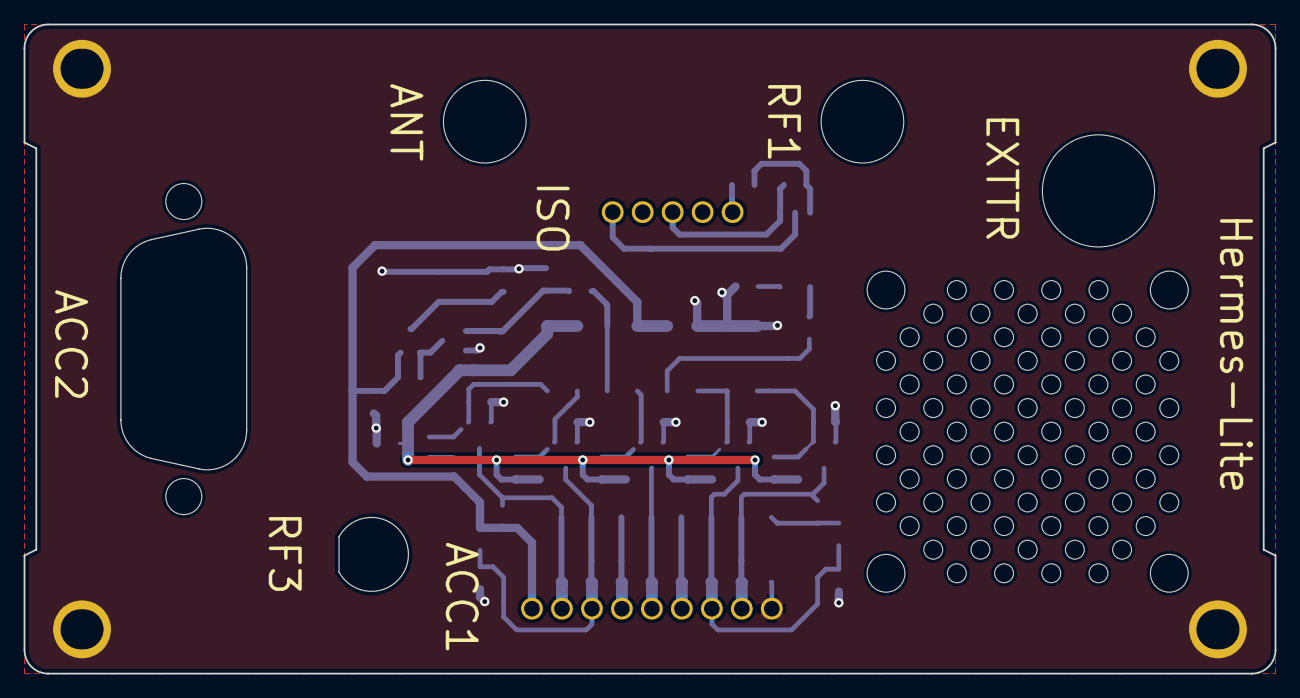
[picture p112: board endcap.kicad_pcb from above]

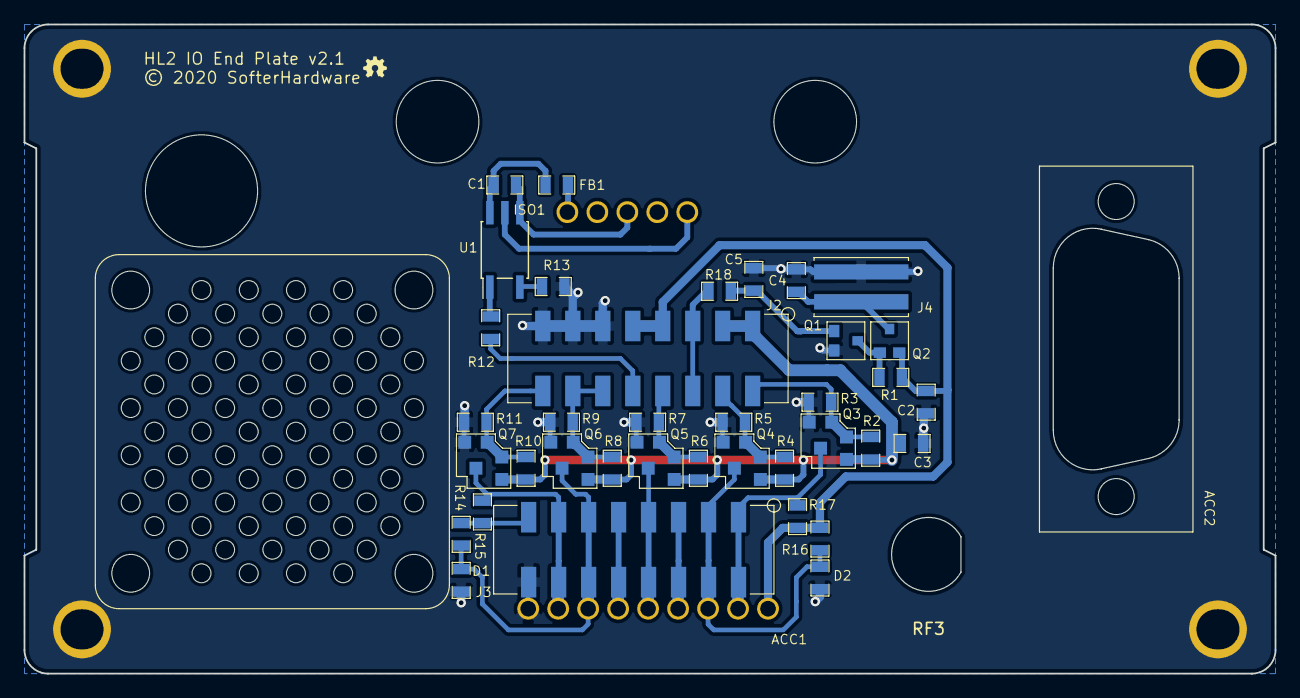
[picture p113: board endcap.kicad_pcb from below]

Board: 2 copper layers, 106.0 x 55.0 mm, 45 parts (41 on the bottom side), 27 nets.

Parts:
ACC1: Terminal Block; terminal_block
ACC2: DB9; db9inside
C1, C2, C3, C4, C5: 0.1uF; SMD-0805
D1, D2: 1N4148; SMD-0805
FB1: Ferrite_Bead_Small; SMD-0805
ISO1: Terminal Block; terminal_block5
J2, J3: Male Header; male_header
J4: Fan; male_header_2
MH1, MH2, MH3, MH4: 3mm; mh3mm
Q1: DTC144E; SOT23_3
Q2: IRLML6402; SOT23_3
Q3, Q4, Q5, Q6, Q7: MULTIFET; 3sot3_3
R1, R2, R3, R4, R5, R6, R7, R8, R9, R10, R11, R14, R15, R16, R17: 10K; SMD-0805
R12, R18: 1K; SMD-0805
R13: 680; SMD-0805
RF3: SMA; sma_panel
U1: ACPL-M21L-000E; SO-5_4.4x3.6mm_P1.27mm

Connections:
GNDS: ACC1.9, C2.1, C3.2, C4.1, C5.1, D1.2, D2.2, J2.11, J2.13, J2.15, J3.16, J4.2, MH1.1, MH2.1, MH3.1, MH4.1, Q1.2, Q3.2, Q4.2, Q5.2, Q6.2, Q7.2, R3.2, R5.2, R7.2, R9.2, R11.2, R13.2
ISOIN: J2.10, R12.2
unnamed: ACC1.2, J3.1, J3.2, Q3.3, R17.2
unnamed: ACC1.3, D2.1, J3.3, J3.4, Q4.3, R16.2
unnamed: ACC1.4, J3.5, J3.6
unnamed: ACC1.5, J3.7, J3.8, Q5.3
unnamed: ACC1.6, J3.9, J3.10
unnamed: ACC1.7, D1.1, J3.11, J3.12, Q6.3, R15.1
unnamed: ACC1.8, J3.13, J3.14, Q7.3, R14.1
unnamed: C1.1, FB1.2, U1.6
unnamed: C1.2, ISO1.3, U1.4
unnamed: C4.2, J4.1, Q2.3
unnamed: C5.2, Q1.1, R18.2
unnamed: FB1.1, ISO1.1
unnamed: ISO1.5, U1.5
unnamed: J2.2, Q3.1, R2.2, R3.1
unnamed: J2.4, Q4.1, R4.2, R5.1
unnamed: J2.5, J2.6, R18.1
unnamed: J2.8, Q5.1, R6.2, R7.1
unnamed: J2.12, J2.14, Q6.1, R8.2, R9.1
unnamed: J2.16, Q7.1, R10.2, R11.1
unnamed: J3.15, R14.2, R15.2
unnamed: Q1.3, Q2.1, R1.2
unnamed: R12.1, U1.1
unnamed: R13.1, U1.3
VSUP: ACC1.1, C2.2, J2.7, J2.9, Q2.2, R1.1, R16.1, R17.1
Vlvds: C3.1, J2.1, J2.3, Q3.4, Q4.4, Q5.4, Q6.4, Q7.4, R2.1, R4.1, R6.1, R8.1, R10.1
