softerhardware/Hermes-Lite2/hardware/companions/db9/db9.kicad_pcb

## KiCad design hardware/companions/db9/db9.kicad_pcb (2019-12-30)

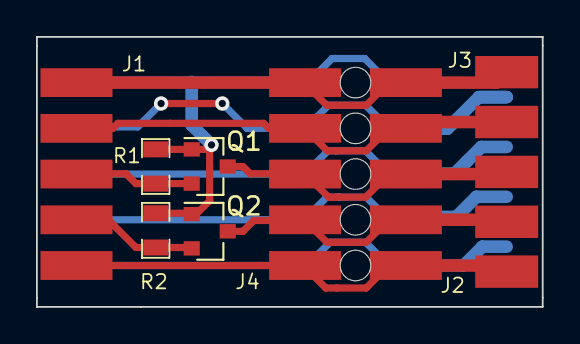
[picture p114: board db9.kicad_pcb from above]

Board: 2 copper layers, 28.1 x 15.0 mm, 9 parts (0 on the bottom side), 12 nets.

Parts:
B1: break10
J1, J2, J4: edge10
J3: DB9_Male; db9edge
Q1, Q2: BSS138; SOT-23
R1, R2: 10K; SMD-0805

Connections:
GNDS: J1.5, J2.5, J3.5, J4.5
unnamed: J1.1, J2.1, J3.1, J4.1
unnamed: J1.2, Q2.2, R2.2
unnamed: J1.3, Q1.2, R1.2
unnamed: J1.4, J2.4, J3.4, J4.4
unnamed: J1.6, J2.6, J3.6, J4.6
unnamed: J1.7, J2.7, J3.7, J4.7
unnamed: J1.8, J2.8, J3.8, J4.8
unnamed: J1.9, J2.9, J3.9, J4.9
unnamed: J2.2, J3.2, J4.2, Q2.3
unnamed: J2.3, J3.3, J4.3, Q1.3
VCC: J1.10, J2.10, J4.10, Q1.1, Q2.1, R1.1, R2.1
