softerhardware/Hermes-Lite2/hardware/companions/smallio/smallio.kicad_pcb

## KiCad design hardware/companions/smallio/smallio.kicad_pcb (2019-12-02)

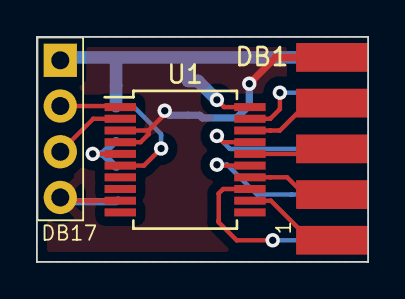
[picture p115: board smallio.kicad_pcb from above]

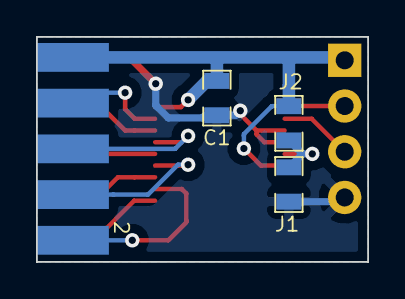
[picture p116: board smallio.kicad_pcb from below]

Board: 2 copper layers, 18.4 x 12.5 mm, 6 parts (3 on the bottom side), 13 nets.

Parts:
C1: 0.1uF; SMD-0805
DB1: IO10; edge10_alt
DB17: RFD4d; 4x1
J1, J2: 0; SMD-0805
U1: MCP23008-E_SS; SSOP-20_5.3x7.2mm_P0.65mm

Connections:
GNDS: C1.1, DB1.9, DB17.4, J1.2, U1.3, U1.4, U1.9
unnamed: DB1.1, U1.12
unnamed: DB1.2, U1.13
unnamed: DB1.3, U1.14
unnamed: DB1.4, U1.15
unnamed: DB1.5, U1.16
unnamed: DB1.6, U1.17
unnamed: DB1.7, U1.18
unnamed: DB1.8, U1.19
unnamed: DB17.2, U1.1
unnamed: DB17.3, U1.2
unnamed: J1.1, J2.2, U1.5
VCC: C1.2, DB1.10, DB17.1, J2.1, U1.6, U1.20
