softerhardware/Hermes-Lite2/hardware/companions/psfeedback/psfeedback.kicad_pcb

## KiCad design hardware/companions/psfeedback/psfeedback.kicad_pcb (2019-12-02)

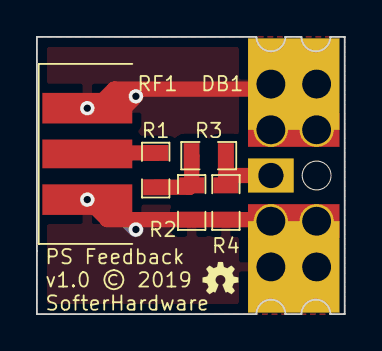
[picture p117: board psfeedback.kicad_pcb from above]

Board: 2 copper layers, 17.1 x 15.4 mm, 6 parts (0 on the bottom side), 4 nets.

Parts:
DB1: RFD2b; psfeedback
R1: 0; SMD-0805
R2: 50; SMD-0805
R3: 470; SMD-0805
R4: 1K; SMD-0805
RF1: BNC; SMAEDGE

Connections:
GNDS: DB1.2, R2.2, R4.2, RF1.2
unnamed: DB1.1, R3.1, R4.1
unnamed: R1.1, R2.1, R3.2
unnamed: R1.2, RF1.1
