softerhardware/Hermes-Lite2/hardware/companions/n2adr/n2adr.kicad_pcb

## KiCad design hardware/companions/n2adr/n2adr.kicad_pcb (2019-08-17)

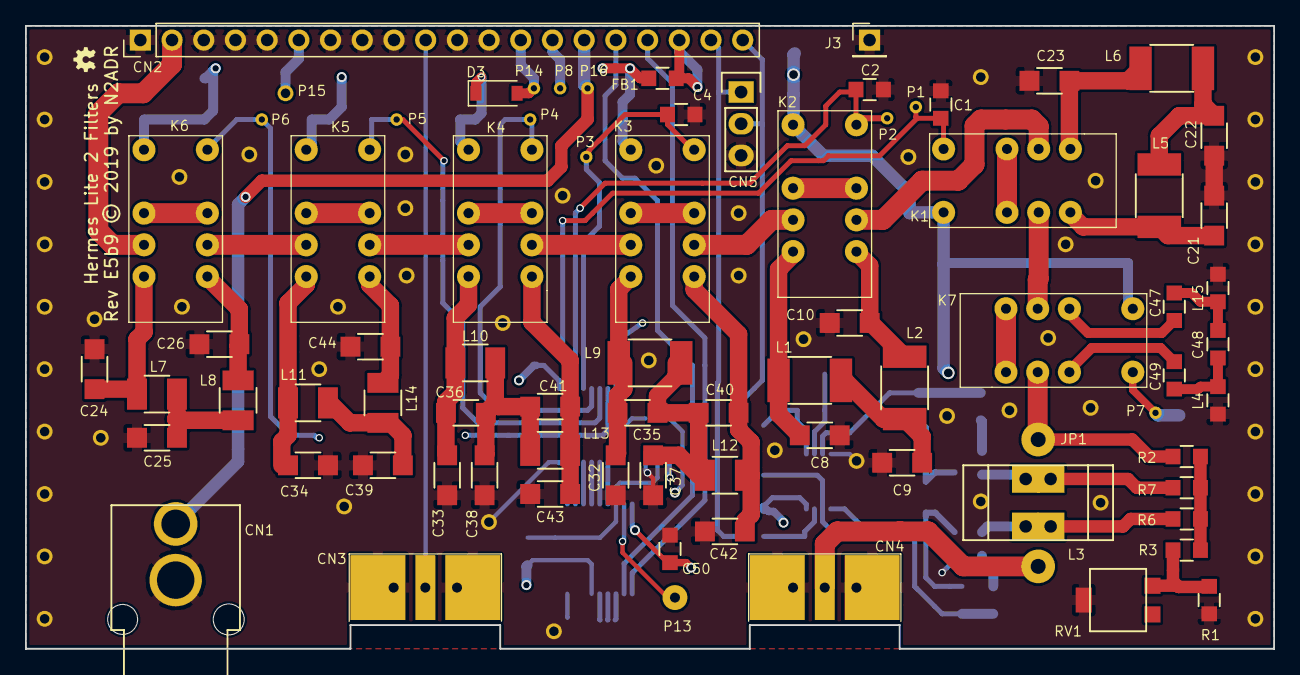
[picture p120: board n2adr.kicad_pcb from above]

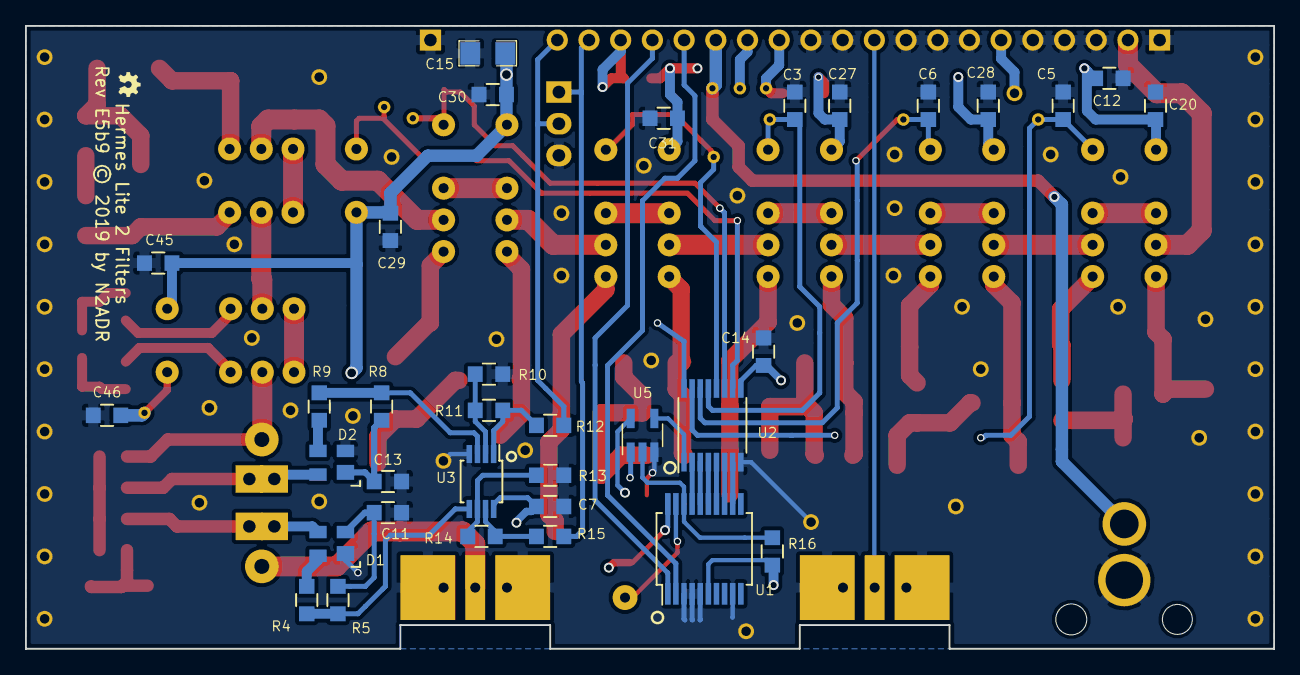
[picture p121: board n2adr.kicad_pcb from below]

Board: 4 copper layers, 100.0 x 49.9 mm, 112 parts (34 on the bottom side), 80 nets.

Parts:
C1, C2, C3, C4, C5, C6, C7, C11, C13, C14, C20, C27, C28, C29, C30, C31, C45, C46, C50: 100n; SMD_0805
C8, C10: 1000p; SMD_1206
C9, C21, C23: 1800p; SMD_1206
C12: 22uF; SMD_0805
C15: 100uF; SMD-1206
C22: 3300p; SMD_1206
C24, C26, C33: 150p; SMD_1206
C25, C39: 330p; SMD_1206
C32, C38, C40: 270p; SMD_1206
C34, C44: 180p; SMD_1206
C35: 100p; SMD_1206
C36: 39p; SMD_1206
C37: 560p; SMD_1206
C41, C42: 220p; SMD_1206
C43: 68p; SMD_1206
C47, C49: 1500p; SMD_0805
C48: 680p; SMD_0805
CN1: Audio-Jack-2; PhonoRcaRCJ-04x
CN2: Conn_01x20; Pin_Header_Straight_1x20_Pitch2.54mm
CN3, CN4: SMA; BNCEDGE
CN5: CONN_01X03; Pin_Header_Straight_1x03
D1, D2: BAS40-07; SOT-143
D3: 1N4148; D_SOD-123
FB1: FB; SMD_0805
J3: Conn_01x01; Pin_Header_Straight_1x01_Pitch2.54mm
JP1: 1T; WireConnection_1.20mmDrill
K1, K2, K3, K4, K5, K6, K7: EC2-3NU; RelayDPDT01
L1, L2: 1.8u; SMD_1812
L3: 10T; ToroidT37
L4, L15: 1.8u; SMD_0805
L5, L6: 3.9u; SMD_1812
L7, L8: 220n; SMD_1210
L9: 1000n; SMD_1812
L10: 560n; SMD_1210
L11, L14: 390n; SMD_1210
L12: 680n; SMD_1210
L13: 270n; SMD_1210
P1, P2, P3, P4, P5, P6, P7, P8, P14, P16: TST; WirePad_0.5mm
P13, P15: TST; SolderWirePad_single_0-8mmDrill
R1: 22 1%; SMD_0805
R2, R10, R13: 2K2 1%; SMD_0805
R3: 56 1%; SMD_0805
R4, R5, R8, R9: 4K7; SMD_0805
R6, R7: 18 1%; SMD_0805
R11, R14: 6K2 1%; SMD_0805
R12, R15: 330; SMD_0805
R16: DNI; SMD_0805
RV1: DNI; Trimpot_Bourns_3314G
U1: MCP23008; SSOP-20_5.3x7.2mm_Pitch0.65mm
U2: ULN2003LV; TSSOP-16_4.4x5mm_Pitch0.65mm
U3: AD8692; MSOP-8_3x3mm_Pitch0.65mm
U5: 74LVC1G00; SOT-23-5_HandSoldering

Connections:
+3V3: C7.2, C12.2, C14.2, C15.2, C20.2, C27.2, C28.2, C29.2, C30.2, C31.2, C45.2, C50.2, D3.1, FB1.1, K1.1, K2.1, K3.1, K4.1, K5.1, K6.1, K7.1, R16.1, U1.6, U1.20, U2.9, U3.8, U5.5
Band1: C1.2, K1.8, P1.1, U2.10
Band2: C2.2, K2.8, P2.1, U2.11
Band3: C4.2, K3.8, P3.1, U2.12
Band4: C3.2, K4.8, P4.1, U2.13
Band5: C6.2, K5.8, P5.1, U2.14
Band6: C5.2, K6.8, P6.1, U2.15
Band7: C46.2, K7.8, P7.1, U2.16
FilterOut: JP1.2, K7.6, R2.2
GND: C1.1, C2.1, C3.1, C4.1, C5.1, C6.1, C7.1, C8.1, C9.1, C10.1, C11.2, C12.1, C13.2, C14.1, C15.1, C20.1, C21.2, C22.2, C23.2, C24.1, C25.1, C26.1, C27.1, C28.1, C29.1, C30.1, C31.1, C32.1, C33.1, C34.1, C37.1, C38.1, C39.1, C42.1, C43.1, C44.1, C45.1, C46.1, C50.1, CN1.2, CN2.1, CN2.3, CN2.4, CN2.5, CN2.7, CN2.8, CN2.9, CN2.11, CN2.12, CN3.2, CN4.2, CN5.3, D1.1, D2.2, J3.1, L4.1, L15.1, R1.1, R10.1, R13.1, RV1.2, U1.3, U1.4, U1.5, U1.9, U2.8, U3.4, U5.3
INTTR: CN2.13, D3.2, P14.1, U5.1
unnamed: C8.2, K2.4, L1.1
unnamed: C9.2, L1.2, L2.1
unnamed: C10.2, K2.5, L2.2
unnamed: C11.1, D1.2, R5.2
unnamed: C13.1, D2.1, R8.2
unnamed: C21.1, K1.4, L5.1
unnamed: C22.1, L5.2, L6.1
unnamed: C23.1, K1.5, L6.2
unnamed: C24.2, K6.4, L7.1
unnamed: C25.2, L7.2, L8.1
unnamed: C26.2, K6.5, L8.2
unnamed: C32.2, C35.2, K3.4, L9.1
unnamed: C33.2, C36.2, K4.4, L10.1
unnamed: C34.2, K5.4, L11.1
unnamed: C35.1, C37.2, C40.2, L9.2, L12.1
unnamed: C36.1, C38.2, C41.2, L10.2, L13.1
unnamed: C39.2, L11.2, L14.1
unnamed: C40.1, C42.2, K3.5, L12.2
unnamed: C41.1, C43.2, K4.5, L13.2
unnamed: C44.2, K5.5, L14.2
unnamed: C47.1, C48.2, L15.2
unnamed: C47.2, K7.2
unnamed: C48.1, C49.2, L4.2
unnamed: C49.1, K7.7
unnamed: CN1.1, CN2.15, P16.1
unnamed: CN2.6, P15.1
unnamed: CN2.10, CN3.1
unnamed: CN2.14, P8.1
unnamed: CN2.16, U1.2
unnamed: CN2.17, U1.1
unnamed: CN2.18, FB1.2
unnamed: CN2.19, CN5.1, R15.2
unnamed: CN2.20, CN5.2, R12.2
unnamed: CN4.1, JP1.1
unnamed: D1.3, L3.1, R6.2
unnamed: D1.4, R4.2
unnamed: D2.3, R9.1
unnamed: D2.4, L3.2, R7.1
unnamed: K1.2, K1.7
unnamed: K1.3, K7.3
unnamed: K1.6, K2.6
unnamed: K2.2, K2.7
unnamed: K2.3, K3.6
unnamed: K3.2, K3.7
unnamed: K3.3, K4.6
unnamed: K4.2, K4.7
unnamed: K4.3, K5.6
unnamed: K5.2, K5.7
unnamed: K5.3, K6.6
unnamed: K6.2, K6.7
unnamed: K7.4, K7.5
unnamed: P13.1, U1.19
unnamed: R1.2, R3.1, RV1.1
unnamed: R2.1, R3.2, R6.1, R7.2
unnamed: R4.1, R5.1, U3.5
unnamed: R8.1, R9.2, U3.3
unnamed: R10.2, R11.1, U3.2
unnamed: R11.2, R12.1, U3.1
unnamed: R13.2, R14.1, U3.6
unnamed: R14.2, R15.1, U3.7
unnamed: R16.2, U1.18, U5.2
unnamed: U1.12, U2.7
unnamed: U1.13, U2.6
unnamed: U1.14, U2.5
unnamed: U1.15, U2.4
unnamed: U1.16, U2.3
unnamed: U1.17, U2.2
unnamed: U2.1, U5.4
RFInput: CN2.2, K6.3
