softerhardware/Hermes-Lite2/gateware/rtl/radioberry/ad9866ctrl.v

//
//  Hermes Lite
// 
//
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
// (C) Steve Haynal KF7O 2014-2018

module ad9866ctrl (
  clk,
  rst,

  rffe_ad9866_sdio,
  rffe_ad9866_sclk,
  rffe_ad9866_sen_n,

  // Command slave interface
  cmd_addr,
  cmd_data,
  cmd_rqst,
  cmd_ack
);

input             clk;
input             rst;

output            rffe_ad9866_sdio;
output            rffe_ad9866_sclk;
output            rffe_ad9866_sen_n;

// Command slave interface
input  [5:0]      cmd_addr;
input  [31:0]     cmd_data;
input             cmd_rqst;
output logic      cmd_ack = 1'b0;   


// SPI
logic   [15:0]    datain;
logic             start;
logic   [3:0]     dut2_bitcount;
logic             dut2_state;
logic   [15:0]    dut2_data;
logic   [5:0]     dut1_pc;
logic             sdo;

logic             cmd_ack_next;
logic             istart;

logic   [8:0]     initarrayv;
// Tool problems if below is logic
reg     [8:0]     initarray [19:0];

localparam 
  CMD_IDLE    = 2'b00,
  CMD_TXGAIN  = 2'b01,
  CMD_RXGAIN  = 2'b11,
  CMD_WRITE   = 2'b10;

// Command slave
logic [1:0]       cmd_state = CMD_IDLE;
logic [1:0]       cmd_state_next;
logic [5:0]       tx_gain = 8'h0;
logic [5:0]       tx_gain_computed;
logic [5:0]       tx_gain_next;
logic [6:0]       rx_gain = 7'b1000000;
logic [6:0]       rx_gain_next;

logic [12:0]      icmd_data = 12'h000;

initial begin
  // First bit is 1'b1 for write enable to that address
  initarray[0] = {1'b0,8'h80}; // Address 0x00, enable 4 wire SPI
  initarray[1] = {1'b0,8'h00}; // Address 0x01,
  initarray[2] = {1'b0,8'h00}; // Address 0x02,
  initarray[3] = {1'b0,8'h00}; // Address 0x03,
  initarray[4] = {1'b1,8'h36}; // Address 0x04,
  initarray[5] = {1'b0,8'h00}; // Address 0x05,
  initarray[6] = {1'b1,8'h14}; // Address 0x06, Disable clkout2
  initarray[7] = {1'b1,8'h21}; // Address 0x07, Initiate DC offset calibration and RX filter on, 21 to 20 to disable RX filter
  initarray[8] = {1'b1,8'h40}; // Address 0x08, RX filter f-3db at ~34 MHz after scaling
  initarray[9] = {1'b1,8'h7f}; // Address 0x09,
  initarray[10] = {1'b1,8'h7f}; // Address 0x0a,
  initarray[11] = {1'b1,8'h00}; // Address 0x0b, No RX gain on PGA
  initarray[12] = {1'b1,8'h43}; // Address 0x0c, TX twos complement and interpolation factor
  initarray[13] = {1'b1,8'h03}; // Address 0x0d, RX twos complement
  initarray[14] = {1'b0,8'h01}; // Address 0x0e, Enable/Disable IAMP
  initarray[15] = {1'b0,8'h00}; // Address 0x0f,
  initarray[16] = {1'b0,8'h84}; // Address 0x10, Select TX gain
  initarray[17] = {1'b0,8'h00}; // Address 0x11, Select TX gain
  initarray[18] = {1'b1,8'h00}; // Address 0x12,
  initarray[19] = {1'b0,8'h00}; // Address 0x13
end

// Command Slave State Machine
always @(posedge clk) begin
  cmd_state <= cmd_state_next;
  tx_gain <= tx_gain_next;
  rx_gain <= rx_gain_next;
  cmd_ack <= cmd_ack_next;
end

always @* begin
  cmd_state_next = cmd_state;
  tx_gain_next = tx_gain;
  rx_gain_next = rx_gain;
  cmd_ack_next = cmd_ack;
  istart = 1'b0;
  // Linear mapping from 0to255 to 0to39, like Hermes-Lite 1
  tx_gain_computed = ((cmd_data[31:24]+4) >> 3) + (cmd_data[31:24] >> 5);

  icmd_data  = {cmd_data[20:16],cmd_data[7:0]};

  case(cmd_state)

    CMD_IDLE: begin
      if (cmd_rqst) begin
        cmd_ack_next = 1'b1; // Assume acknowledge
        // Accept possible write
        case (cmd_addr)
          // Hermes TX Gain Setting
          6'h09: begin
            if (tx_gain != tx_gain_computed) begin
              // Must update
              if (rffe_ad9866_sen_n) begin
                tx_gain_next = tx_gain_computed;
                cmd_state_next = CMD_TXGAIN;
              end else begin
                cmd_ack_next = 1'b0;
              end
            end
          end

          // Hermes RX Gain Setting
          6'h0a: begin
            if (rx_gain != cmd_data[6:0]) begin
              // Must update
              if (rffe_ad9866_sen_n) begin
                rx_gain_next = cmd_data[6:0];
                cmd_state_next = CMD_RXGAIN;
              end else begin
                cmd_ack_next = 1'b0;
              end
            end
          end

          // Generic AD9866 write
          6'h3b: begin
            if (cmd_data[31:24] == 8'h06) begin
              // Must write
              if (rffe_ad9866_sen_n) cmd_state_next = CMD_WRITE;
              else cmd_ack_next = 1'b0;
            end
          end

          default: cmd_state_next = cmd_state;

        endcase 
      end        
    end

    CMD_TXGAIN: begin
      istart     = 1'b1;
      icmd_data  = {5'h0a,2'b01,tx_gain};
      cmd_state_next = CMD_IDLE;
    end
    
    CMD_RXGAIN: begin
      istart          = 1'b1;
      icmd_data[12:6] = {5'h09,2'b01};
      icmd_data[5:0]  = rx_gain[6] ? rx_gain[5:0] : (rx_gain[5] ? ~rx_gain[5:0] : {1'b1,rx_gain[4:0]});
      cmd_state_next  = CMD_IDLE;
    end

    CMD_WRITE: begin
      istart          = 1'b1;
      icmd_data       = {cmd_data[20:16],cmd_data[7:0]};
      cmd_state_next  = CMD_IDLE;
    end

  endcase
end

// SPI interface
assign sdo       = 1'b0;

// Init program counter
always @(posedge clk) begin: AD9866_DUT1_FSM
    if (rst) begin
        dut1_pc <= 6'h00;
    end
    else begin
        if ((dut1_pc != 6'h3f) & rffe_ad9866_sen_n) begin
            dut1_pc <= (dut1_pc + 6'h01);
        end
        // Toggle LSB
        else if ((dut1_pc == 6'h3f) & rffe_ad9866_sen_n) begin
            dut1_pc <= 6'h3e;
        end
    end
end

always @* begin
    initarrayv = initarray[dut1_pc[5:1]];
    datain = {3'b000,icmd_data};   
    start = 1'b0;
    if (rffe_ad9866_sen_n) begin
        if (dut1_pc[5:1] <= 6'h13) begin
            if (dut1_pc[0] == 1'b0) begin
                
                datain = {3'h0,dut1_pc[5:1],initarrayv[7:0]};
                start = initarrayv[8];
            end
        end else begin
            start = istart;
        end
    end
end

//assign dataout = dut2_data[8-1:0];
assign rffe_ad9866_sdio = dut2_data[15];

// SPI state machine
always @(posedge clk) begin: AD9866_DUT2_FSM
  if (rst) begin
    rffe_ad9866_sen_n <= 1;
    rffe_ad9866_sclk <= 0;
    dut2_state <= 1'b0;
    dut2_data <= 0;
    dut2_bitcount <= 0;
  end
  else begin
    case (dut2_state)
      1'b0: begin
        rffe_ad9866_sclk <= 0;
        dut2_bitcount <= 15;
        if (start) begin
          dut2_data <= datain;
          rffe_ad9866_sen_n <= 0;
          dut2_state <= 1'b1;
        end
        else begin
          rffe_ad9866_sen_n <= 1;
        end
      end
      1'b1: begin
        dut2_state <= 1'b1;
        if ((!rffe_ad9866_sclk)) begin
          rffe_ad9866_sclk <= 1;
        end
        else begin
          dut2_data <= {dut2_data[15-1:0], sdo};
          dut2_bitcount <= (dut2_bitcount - 4'h1);
          rffe_ad9866_sclk <= 0;
          if ((dut2_bitcount == 0)) begin
            dut2_state <= 1'b0;
          end
        end
      end
    endcase
  end
end

endmodule // ad9866ctrl
