softerhardware/Hermes-Lite2/gateware/rtl/ad9866.v

//
//  Hermes Lite
// 
//
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
// (C) Steve Haynal KF7O 2014-2018

module ad9866 (
  clk,
  clk_2x,

  rst,

  tx_data,
  rx_data,
  tx_en,
  cw_on,

  rxclip,
  rxgoodlvl,
  rxclrstatus,

  rffe_ad9866_tx,
  rffe_ad9866_rx,
  rffe_ad9866_rxsync,
  rffe_ad9866_rxclk,
  rffe_ad9866_txquiet_n,
  rffe_ad9866_txsync,
  rffe_ad9866_mode,
  rffe_ad9866_pga5,

  // Command slave interface
  cmd_addr,
  cmd_data,
  cmd_rqst,
  cmd_ack

);

input             clk;
input             clk_2x;

input             rst;

input   [11:0]    tx_data;
output  [11:0]    rx_data;
input             tx_en;
input             cw_on;

output logic      rxclip = 1'b0;
output logic      rxgoodlvl = 1'b0;
input             rxclrstatus;

`ifdef HALFDUPLEX
inout   [5:0]     rffe_ad9866_tx;
inout   [5:0]     rffe_ad9866_rx;
output            rffe_ad9866_rxsync;
output            rffe_ad9866_rxclk; 
`else
output  [5:0]     rffe_ad9866_tx;
input   [5:0]     rffe_ad9866_rx;
input             rffe_ad9866_rxsync;
input             rffe_ad9866_rxclk; 
`endif
output            rffe_ad9866_txquiet_n;
output            rffe_ad9866_txsync;

output            rffe_ad9866_mode;

output            rffe_ad9866_pga5;

// Command slave interface
input   [5:0]     cmd_addr;
input   [31:0]    cmd_data;
input             cmd_rqst;
output            cmd_ack;

parameter         FAST_LNA = 0;


// TX Path
logic   [11:0]    tx_data_d1;
logic             tx_sync;
logic             tx_en_d1;

// RX Path
logic   [11:0]    rx_data_assemble;
logic    [5:0]    rffe_ad9866_rx_d1, rffe_ad9866_rx_d2;
logic             rffe_ad9866_rxsync_d1;


logic             rxclipp, rxclipn;
logic             rxgoodlvlp, rxgoodlvln;



// TX Path

`ifdef HALFDUPLEX
always @(posedge clk) tx_en_d1 <= tx_en;

always @(posedge clk) tx_data_d1 <= tx_data;
assign rffe_ad9866_tx = tx_en_d1 ? tx_data_d1[11:6] : 6'bZ;
assign rffe_ad9866_rx = tx_en_d1 ? tx_data_d1[5:0]  : 6'bZ;
assign rffe_ad9866_txsync = tx_en_d1;
assign rffe_ad9866_txquiet_n = clk;

`else

generate if (FAST_LNA == 1) begin: FAST_LNA

  logic   [ 5:0]    gain, tx_gain, rx_gain = 6'h1f;
  logic             en_tx_gain = 1'b0;
  logic             pga5_d1;
  logic             update_gain = 1'b0;

  always @(posedge clk) begin
    if (cmd_rqst) begin
      case (cmd_addr)
          6'h0a: begin
            rx_gain <= cmd_data[6] ? cmd_data[5:0] : (cmd_data[5] ? ~cmd_data[5:0] : {1'b1,cmd_data[4:0]});
          end

          6'h0e: begin
            tx_gain <= cmd_data[14] ? cmd_data[13:8] : (cmd_data[13] ? ~cmd_data[13:8] : {1'b1,cmd_data[12:8]});
            en_tx_gain <= cmd_data[15];
          end
      endcase
    end

    if ((rx_gain != gain) & (~tx_en | (~en_tx_gain & ~cw_on))) begin
      gain <= rx_gain;
      update_gain <= 1'b1;
    end else if ((tx_gain != gain) & (tx_en & en_tx_gain)) begin
      gain <= tx_gain;
      update_gain <= 1'b1;
    end else if ((gain != 6'h0) & ~en_tx_gain & cw_on) begin
      gain <= 6'h00;
      update_gain <= 1'b1;
    end else begin
      update_gain <= rst;
    end
  end

  always @(posedge clk_2x) begin
    tx_en_d1 <= tx_en;
    tx_sync <= ~tx_sync;
    if (tx_en_d1) begin
      if (tx_sync) begin
        tx_data_d1 <= update_gain ? {gain,tx_data[5:0]} : tx_data;
        pga5_d1 <= update_gain;
        rffe_ad9866_tx <= tx_data_d1[5:0];
        rffe_ad9866_pga5 <= 1'b0;
        rffe_ad9866_txsync <= ~pga5_d1; // No TX transaction completion if fast LNA update
      end else begin
        rffe_ad9866_tx <= tx_data_d1[11:6];
        rffe_ad9866_pga5 <= pga5_d1;
        rffe_ad9866_txsync <= 1'b0;
      end
    end else begin
      tx_data_d1 <= {gain,tx_data[5:0]};
      pga5_d1 <= update_gain;
      rffe_ad9866_tx <= tx_data_d1[11:6];
      rffe_ad9866_txsync <= 1'b0;
      rffe_ad9866_pga5 <= pga5_d1;
    end
  end

end else begin: SLOW_LNA

  assign rffe_ad9866_pga5 = 1'b0;

  always @(posedge clk_2x) begin
    tx_en_d1 <= tx_en;
    tx_sync <= ~tx_sync;
    if (tx_en_d1) begin
      if (tx_sync) begin
        tx_data_d1 <= tx_data;
        rffe_ad9866_tx <= tx_data_d1[5:0];
      end else begin
        rffe_ad9866_tx <= tx_data_d1[11:6];
      end
      rffe_ad9866_txsync <= tx_sync;
    end else begin
      rffe_ad9866_tx <= 6'h00;
      rffe_ad9866_txsync <= 1'b0;
    end
  end

end endgenerate

assign rffe_ad9866_txquiet_n = tx_en_d1; 

`endif

// RX Path

`ifdef HALFDUPLEX
always @(posedge clk) rx_data_assemble <= {rffe_ad9866_tx,rffe_ad9866_rx};
assign rffe_ad9866_rxsync = ~tx_en_d1;
assign rffe_ad9866_rxclk = clk;
assign rffe_ad9866_mode = 1'b0;

`else
// Assume that ad9866_rxclk is synchronous to ad9866clk
// Don't know the phase relation
always @(posedge clk_2x) begin
  rffe_ad9866_rx_d1 <= rffe_ad9866_rx;
  rffe_ad9866_rx_d2 <= rffe_ad9866_rx_d1;
  rffe_ad9866_rxsync_d1 <= rffe_ad9866_rxsync;
  if (rffe_ad9866_rxsync_d1) rx_data_assemble <= {rffe_ad9866_rx_d2,rffe_ad9866_rx_d1};
end
assign rffe_ad9866_mode = 1'b1;
`endif

always @ (posedge clk) rx_data <= rx_data_assemble;


assign rxclipp = (rx_data == 12'b011111111111);
assign rxclipn = (rx_data == 12'b100000000000);

// Like above but 2**11.585 = (4096-1024) = 3072
assign rxgoodlvlp = (rx_data[11:9] == 3'b011);
assign rxgoodlvln = (rx_data[11:9] == 3'b100);

always @(posedge clk) begin
  if (rxclrstatus) rxclip <= 1'b0;
  if (rxclipp | rxclipn) rxclip <= 1'b1;
end

always @(posedge clk) begin
  if (rxclrstatus) rxgoodlvl <= 1'b0;
  if (rxgoodlvlp | rxgoodlvln) rxgoodlvl <= 1'b1;
end

endmodule // ad9866
