softerhardware/Hermes-Lite2/gateware/rtl/radio_openhpsdr1/firrom/coefL4.py

scoeffs = """ 0         4    0.00000608          4.08
   1         3    0.00000403          2.70
   2         3    0.00000377          2.53
   3         1    0.00000174          1.17
   4        -2   -0.00000289         -1.94
   5        -7   -0.00001095         -7.35
   6       -16   -0.00002317        -15.55
   7       -27   -0.00004003        -26.86
   8       -41   -0.00006169        -41.39
   9       -59   -0.00008781        -58.91
  10       -79   -0.00011756        -78.87
  11      -100   -0.00014953       -100.32
  12      -122   -0.00018179       -121.96
  13      -142   -0.00021202       -142.25
  14      -159   -0.00023768       -159.46
  15      -172   -0.00025623       -171.90
  16      -178   -0.00026537       -178.04
  17      -177   -0.00026338       -176.70
  18      -167   -0.00024930       -167.26
  19      -150   -0.00022314       -149.71
  20      -125   -0.00018599       -124.78
  21       -94   -0.00014001        -93.93
  22       -59   -0.00008829        -59.24
  23       -23   -0.00003463        -23.23
  24        11    0.00001682         11.29
  25        42    0.00006195         41.57
  26        65    0.00009713         65.16
  27        80    0.00011956         80.21
  28        86    0.00012769         85.67
  29        81    0.00012134         81.41
  30        68    0.00010181         68.31
  31        48    0.00007177         48.15
  32        23    0.00003496         23.45
  33        -3   -0.00000418         -2.81
  34       -28   -0.00004102        -27.52
  35       -48   -0.00007124        -47.80
  36       -61   -0.00009141        -61.32
  37       -67   -0.00009930        -66.62
  38       -63   -0.00009425        -63.24
  39       -52   -0.00007719        -51.78
  40       -34   -0.00005052        -33.90
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

mifpreamble = """DEPTH = 256;
WIDTH = 18;
ADDRESS_RADIX = HEX;
DATA_RADIX = HEX;
CONTENT
BEGIN
"""


def dgain():
  gain = 0
  m = 0
  scale = 670914.837311
  coeffs = scoeffs.split("\n")
  for coeff in coeffs:
      cs = coeff.split()
      c2 = float(cs[2])
      c3 = float(cs[3])
      m += (c3/c2)
      print c3,round(c2*scale,2)
      #c2 = coeff.split()[2]
      #coeff = coeff.split()[3]
      #gain = gain + (1.5*float(coeff))/4096
  print "gain is",gain
  print "m is",m/len(coeffs)


def do(filename,modulus):
  f1 = open(filename+".txt","w")
  f2 = open(filename+".mif","w")
  f2.write(mifpreamble)
  coeffs = scoeffs.split('\n')
  i = 0
  k = 0
  for coeff in coeffs:
    if i%8 == (modulus+4): 
      coeff = coeff.split()[3]
      fv = float(coeff)
      iv = int(round(fv))
      hv = 0x3ffff & iv
      f1.write("{0:018b} // {1} {2}\n".format(hv,iv,fv))
      f2.write("{0:02X} : {1:05X}; --  {2} {3}\n".format(k,hv,iv,fv))
      k = k + 1
    i = i + 1

  for j in range(k,128):
    f1.write("000000000000000000\n")
    f2.write("{0:02X} : 00000;\n".format(j))
    i = i + 1

  i = 128
  k = 128
  for coeff in coeffs:
    if i%8 == modulus: 
      coeff = coeff.split()[3]
      fv = float(coeff)
      iv = int(round(fv))
      hv = 0x3ffff & iv
      f1.write("{0:018b} // {1} {2}\n".format(hv,iv,fv))
      f2.write("{0:02X} : {1:05X}; --  {2} {3}\n".format(k,hv,iv,fv))
      k = k + 1
    i = i + 1

  for j in range(k,256):
    f1.write("000000000000000000\n")
    f2.write("{0:02X} : 00000;\n".format(j))


  f2.write("END;\n")

  f1.close()
  f2.close()


def do_with_gain(filename,modulus,gain):
  f1 = open(filename+".txt","w")
  f2 = open(filename+".mif","w")
  f2.write(mifpreamble)
  coeffs = scoeffs.split('\n')
  i = 0
  k = 0
  for coeff in coeffs:
    if i%8 == (modulus+4): 
      coeff = coeff.split()[2]
      fv = gain*float(coeff)
      iv = int(round(fv))
      hv = 0x3ffff & iv
      f1.write("{0:018b} // {1} {2}\n".format(hv,iv,fv))
      f2.write("{0:02X} : {1:05X}; --  {2} {3}\n".format(k,hv,iv,fv))
      k = k + 1
    i = i + 1

  for j in range(k,128):
    f1.write("000000000000000000\n")
    f2.write("{0:02X} : 00000;\n".format(j))
    i = i + 1

  i = 128
  k = 128
  for coeff in coeffs:
    if i%8 == modulus: 
      coeff = coeff.split()[2]
      fv = gain*float(coeff)
      iv = int(round(fv))
      hv = 0x3ffff & iv
      f1.write("{0:018b} // {1} {2}\n".format(hv,iv,fv))
      f2.write("{0:02X} : {1:05X}; --  {2} {3}\n".format(k,hv,iv,fv))
      k = k + 1
    i = i + 1

  for j in range(k,256):
    f1.write("000000000000000000\n")
    f2.write("{0:02X} : 00000;\n".format(j))


  f2.write("END;\n")

  f1.close()
  f2.close()



do("coefL4AE",3)
do("coefL4BF",2)
do("coefL4CG",1)
do("coefL4DH",0)

## Input is 16 bit signed, may not reach max
## Output is 24 bit signed
## 8 bits to grow
## Algorithm is shifting by 12 bits to divide by 2**12
## 1.5/670914/2**12 < 256
g = 1.5*670914
#do_with_gain("coefL4AE",3,g)
#do_with_gain("coefL4BF",2,g)
#do_with_gain("coefL4CG",1,g)
#do_with_gain("coefL4DH",0,g)


dgain()
