softerhardware/Hermes-Lite2/gateware/rtl/nco/mix2.v

`timescale 1us/1ns
/* verilator lint_off WIDTH */
module mix2 (
  clk,
  clk_2x,
  rst,
  phi0,
  phi1,
  adc,
  mixdata0_i,
  mixdata0_q,
  mixdata1_i,
  mixdata1_q
);

input                 clk;
input                 clk_2x;
input                 rst;
input         [31:0]  phi0;
input         [31:0]  phi1;
input  signed [11:0]  adc;
output logic signed [17:0]  mixdata0_i;
output logic signed [17:0]  mixdata0_q;
output logic signed [17:0]  mixdata1_i;
output logic signed [17:0]  mixdata1_q;

parameter CALCTYPE = 0;

logic         [18:0]  sin, ssin;
logic         [18:0]  cos, scos;

logic  signed [17:0]  ssin_q, scos_q;
logic  signed [35:0]  i_data_d, q_data_d;
logic  signed [18:0]  i_rounded, q_rounded;

logic                 state = 1'b0;

nco2 #(.CALCTYPE(CALCTYPE)) nco2_i (
  .state(state),
  .clk(clk),
  .clk_2x(clk_2x),
  .rst(rst),
  .phi0(phi0),
  .phi1(phi1),
  .cos(cos),
  .sin(sin)
);

always @(posedge clk_2x) begin
  state <= ~state;
end

assign ssin = {sin[18],~sin[17:0]} + 19'h01;
assign scos = {cos[18],~cos[17:0]} + 19'h01;

always @(posedge clk_2x) begin
  ssin_q <= sin[18] ? ssin[18:1] : sin[18:1];
  scos_q <= cos[18] ? scos[18:1] : cos[18:1];
end


mult_ABOpiped imult (
  .clk(clk_2x),
  .a({{6{adc[11]}},adc}),
  .b(scos_q),
  .o(i_data_d)
);

mult_ABOpiped qmult (
  .clk(clk_2x),
  .a({{6{adc[11]}},adc}),
  .b(ssin_q),
  .o(q_data_d)
);


assign i_rounded = i_data_d[28:11] + {17'h00,i_data_d[10]};
assign q_rounded = q_data_d[28:11] + {17'h00,q_data_d[10]};

always @(posedge clk_2x) begin
  if (state) begin
    mixdata0_i <= i_rounded[17:0];
    mixdata0_q <= q_rounded[17:0];
  end else begin
    mixdata1_i <= i_rounded[17:0];
    mixdata1_q <= q_rounded[17:0];
  end
end

endmodule
/* verilator lint_on WIDTH */
