softerhardware/Hermes-Lite2/(commit log)

2016-11-24 Added Hardware
    [Clock.sch, Ethernet.sch, InputOutput.sch, PA.sch, Power.sch, RFFrontend.sch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]
2016-12-26 Added LED and Ethernet tests
    [Clock.sch, Ethernet.sch, InputOutput.sch, PA.sch, Power.sch, RFFrontend.sch, hermeslite.sch]
2017-01-09 Added clock test, updated to led test to faster counter and noninverted count
2017-01-10 No changes. Just make a new hermeslite.net from the schematic, and read into the PCB. There are changes to name Ext, name Option and name Key. Parts R14, R15, R31, R30 changed value. Some parts chang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
    [hermeslite.kicad_pcb]
2017-01-10 Add "9.44 V" to the VPA symbol on the schematic. Add "Input 12 to 18 V" and "3 A" and several "+" to silkscreen on PCB.
    [Clock.sch, Ethernet.sch, InputOutput.sch, PA.sch, Power.sch, RFFrontend.sch, hermeslite.kicad_pcb, hermeslite.sch]
2017-01-10 Change the footprint for X2 in library HERMESLITE/MULTIOSC to accomodate the packages 2.5x2.0mm 4 and 6-pad, 3.2x2.5mm 4-pad, 5x7mm 4 and 10 pad. Change the PCB to use this footprint. Add a keepout a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
    [Clock.sch, Ethernet.sch, InputOutput.sch, PA.sch, Power.sch, RFFrontend.sch, hermeslite.kicad_pcb, hermeslite.sch]
2017-01-10 Remoed hermeslite-cache LIBS
    [Clock.sch, Ethernet.sch, InputOutput.sch, PA.sch, Power.sch, RFFrontend.sch, hermeslite.sch]
2017-01-11 DHCP renewal from Jim, stream corruption fix from Alan
    [dhcp.v, network.v]
2017-01-11 Updated BOM
2017-01-11 Added updateprices.py script for BOM
2017-01-14 Refactoring to include all RTL
    [hermeslite-B.Cu.gbr, hermeslite-B.Mask.gbr, hermeslite-B.SilkS.gbr, hermeslite-Edge.Cuts.gbr, hermeslite-F.Cu.gbr, hermeslite-F.Mask.gbr, hermeslite-F.SilkS.gbr, hermeslite-In1.Cu.gbr]
2017-01-23 Reset and clock cleanup, first TX tests
    [ethernet.v, hermeslite.v, network.v, rgmii_send.v]
2017-01-28 DHCP fixes, ethernet timing fixes, TX output level adjusted
    [dhcp.v, ethernet.v, icmp.v]
2017-02-18 Adding i2c2_init
2017-02-27 Changes to diminish variations in LNA gain across the spectrum, PCB cleanup
    [hermeslite.kicad_pcb]
2017-03-07 i2c refactor
2017-03-09 New i2c interface
2017-04-07 Slow ADC
2017-04-17 Temperature support, 16 bit CIC to VARCIC path
2017-04-24 Updated schematics with Input Output
    [Clock.sch, Ethernet.sch, InputOutput.sch, PA.sch, Power.sch, RFFrontend.sch, hermeslite.sch]
2017-04-29 First wishbone interfaces, switch to dcfifo in icmp to ease and simplify timing
2017-05-01 Wishbone to ad9866 spi added
2017-05-02 Fixes for ad9866 SPI access
    [hermeslite.v, i2c.v]
2017-05-05 LNA gain using SPI
2017-05-15 First round of beta3 schematic updates
    [Clock.sch, Ethernet.sch, InputOutput.sch, PA.sch, Power.sch, RFFrontend.sch, hermeslite.sch]
2017-05-16 Beta3 schematic work
    [InputOutput.sch, PA.sch, Power.sch, RFFrontend.sch]
2017-05-22 Beta3 May 21 schematic
    [Clock.sch, Ethernet.sch, InputOutput.sch, PA.sch, Power.sch, RFFrontend.sch, hermeslite.sch]
2017-05-22 Added old schematic
2017-05-22 Add annotation to schematic
    [Clock.sch, Ethernet.sch, InputOutput.sch, PA.sch, Power.sch, RFFrontend.sch, hermeslite.sch]
2017-05-24 New FPGA AD9866 connections, other changes
    [Clock.sch, Ethernet.sch, InputOutput.sch, PA.sch, Power.sch, RFFrontend.sch, hermeslite.sch]
2017-05-25 Changes to bias
    [PA.sch, RFFrontend.sch]
2017-05-25 Changes date on schematic
    [Clock.sch, Ethernet.sch, InputOutput.sch, PA.sch, Power.sch, RFFrontend.sch, hermeslite.sch]
2017-05-29 Before beta3 netlist import to PCB editor
    [Clock.sch, Ethernet.sch, InputOutput.sch, PA.sch, Power.sch, RFFrontend.sch, hermeslite.sch]
2017-05-30 Initial work on beta3 PCB
    [InputOutput.sch, Power.sch, hermeslite.kicad_pcb]
2017-06-02 PCB layout checkpoint
    [Clock.sch, Ethernet.sch, InputOutput.sch, PA.sch, Power.sch, RFFrontend.sch, hermeslite.kicad_pcb]
2017-06-08 More beta3 PCB layout
    [Clock.sch, Ethernet.sch, InputOutput.sch, PA.sch, Power.sch, RFFrontend.sch, hermeslite.kicad_pcb]
2017-06-09 PCB layout before FPGA rerouting
    [PA.sch, hermeslite.kicad_pcb]
2017-06-10 Beta3 PCB layout work
    [Clock.sch, Ethernet.sch, InputOutput.sch, PA.sch, Power.sch, RFFrontend.sch, hermeslite.kicad_pcb]
2017-06-10 Latest schematic with June9 date
    [Clock.sch, Ethernet.sch, InputOutput.sch, PA.sch, Power.sch, RFFrontend.sch, hermeslite.sch]
2017-06-10 PCB DRC Clean
    [InputOutput.sch, PA.sch, RFFrontend.sch, hermeslite.kicad_pcb]
2017-06-11 Before LDMOS footprint update
    [hermeslite.kicad_pcb]
2017-06-11 More ground under LDMOS devices for alternate heat sinking
    [hermeslite.kicad_pcb]
2017-06-12 PCB Layout
    [hermeslite.kicad_pcb, hermeslite.sch]
2017-06-12 Updated dates
    [Clock.sch, Ethernet.sch, InputOutput.sch, PA.sch, Power.sch, RFFrontend.sch, hermeslite.kicad_pcb, hermeslite.sch]
2017-06-17 Before FPGA pin type changes
    [Ethernet.sch, InputOutput.sch, PA.sch, Power.sch, hermeslite.kicad_pcb]
2017-06-18 BOM work
    [PA.sch, hermeslite.kicad_pcb]
2017-06-19 Updated schematic
    [Clock.sch, Ethernet.sch, InputOutput.sch, PA.sch, Power.sch, RFFrontend.sch, hermeslite.sch]
2017-06-19 Added beta3 BOM
2017-06-20 Drill Hole Work
    [InputOutput.sch, PA.sch, Power.sch, hermeslite.kicad_pcb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]
2017-06-22 Silkscreen work
    [hermeslite.kicad_pcb]
2017-06-26 Tented and untented via selection
    [Clock.sch, Ethernet.sch, InputOutput.sch, PA.sch, Power.sch, RFFrontend.sch, hermeslite.kicad_pcb, hermeslite.sch]
2017-06-26 New gerber files
    [Clock.sch, Ethernet.sch, InputOutput.sch, PA.sch, Power.sch, RFFrontend.sch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]
2017-06-28 Beta3 revision in Quartus to test pin assignment changes
2017-07-04 Parts DB contains more information for PCB assembly houses
    [InputOutput.sch, PA.sch, Power.sch, RFFrontend.sch, hermeslite.sch]
2017-07-04 Assembly BOM work
2017-07-04 Assembly CSV generation support
2017-07-05 Final schematic and PCB for beta3
    [Clock.sch, Ethernet.sch, InputOutput.sch, PA.sch, Power.sch, RFFrontend.sch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]
2017-07-05 Added assembly BOMs
    [bom.assembly.xlsx]
2017-07-29 Proper power connector in parts DB
2017-07-29 Fix for bandscope in latest firmware
    [hermeslite.v]
2017-09-04 Added HL2p0beta3 release
    [Makerfabs PCBA Quotation for hermeslite2beta3.xlsx, PCBA with elecrow quotation_hermeslite2 1pcs_5pcs_10pcs_50pcs.xlsx]
2017-09-05 Beta3 switch to 3.3V LEDs, fix for 20.480MHz spur, 20170904 release
    [hermeslite.v, mdio.v]
2017-09-07 Beta3 release, initial schematic work on next revision
    [Clock.sch, Ethernet.sch, InputOutput.sch, PA.sch, Power.sch, RFFrontend.sch, hermeslite.sch]
2017-09-20 Beta4 schematic and pcb updates
    [Clock.sch, Ethernet.sch, InputOutput.sch, PA.sch, Power.sch, RFFrontend.sch, hermeslite.kicad_pcb, hermeslite.sch]
2017-09-20 Beta4 schematic as pdf
2017-09-20 Updates for beta4 BOM creation
2017-09-20 Updated 22uF, no substitutions for filter caps
2017-09-21 Beta4 changes, T3 cap, 6th hole on SMA, U18 unused inputs, CN11,12 spacing
    [Clock.sch, Ethernet.sch, InputOutput.sch, PA.sch, Power.sch, RFFrontend.sch, hermeslite.kicad_pcb, hermeslite.sch]
2017-09-22 Added gerber files
    [hermeslite-B.Cu.gbr, hermeslite-B.Mask.gbr, hermeslite-B.SilkS.gbr, hermeslite-Edge.Cuts.gbr, hermeslite-F.Cu.gbr, hermeslite-F.Mask.gbr, hermeslite-F.SilkS.gbr, hermeslite-In1.Cu.gbr]
2017-09-23 Updated bom .xml for pdf generation
    [hermeslite-B.Cu.gbr, hermeslite-B.Mask.gbr, hermeslite-B.SilkS.gbr, hermeslite-Edge.Cuts.gbr, hermeslite-F.Cu.gbr, hermeslite-F.Mask.gbr, hermeslite-F.SilkS.gbr, hermeslite-In1.Cu.gbr]
2017-10-01 Repositioned RF connectors for 0.1 inch connection to companion filter card
    [hermeslite.kicad_pcb]
2017-10-01 Started beta4, removed U18 and surrounding, DB7 and CN7
    [Clock.sch, Ethernet.sch, InputOutput.sch, PA.sch, Power.sch, RFFrontend.sch, hermeslite.sch]
2017-10-01 Removed CN10, CN11
    [Clock.sch, Ethernet.sch, InputOutput.sch, PA.sch, Power.sch, RFFrontend.sch, hermeslite.kicad_pcb, hermeslite.sch]
2017-10-02 PDF for new board to board interconnect
    [InputOutput.sch, PA.sch, hermeslite.kicad_pcb]
2017-10-08 Work on finishing back and adding barrel power connector
    [Clock.sch, Ethernet.sch, InputOutput.sch, PA.sch, Power.sch, RFFrontend.sch, hermeslite.kicad_pcb]
2017-10-09 Hopefully finalized back connectors
    [Clock.sch, Ethernet.sch, InputOutput.sch, PA.sch, Power.sch, RFFrontend.sch, hermeslite.kicad_pcb, hermeslite.sch]
2017-10-16 Enable power added, fuse and reverse connection components placed and routed
    [Clock.sch, Ethernet.sch, InputOutput.sch, PA.sch, Power.sch, RFFrontend.sch, hermeslite.kicad_pcb, hermeslite.sch]
2017-10-18 Reworked LVDS connection
    [InputOutput.sch, PA.sch, hermeslite.kicad_pcb]
2017-10-18 Removed 3.3V option on Veth, Vlvds, Removed 2.5 on Eth LEDs
    [Clock.sch, Ethernet.sch, InputOutput.sch, PA.sch, Power.sch, RFFrontend.sch, hermeslite.kicad_pcb]
2017-10-18 Removed and rearranged unused IO
    [Clock.sch, InputOutput.sch, PA.sch, hermeslite.kicad_pcb]
2017-10-18 Consolidation of IO connectors
    [Clock.sch, Ethernet.sch, InputOutput.sch, PA.sch, Power.sch, RFFrontend.sch, hermeslite.kicad_pcb, hermeslite.sch]
2017-10-18 Removed VCO option
    [Clock.sch, hermeslite.kicad_pcb]
2017-10-23 Routing of new front IO
    [Clock.sch, Ethernet.sch, InputOutput.sch, PA.sch, Power.sch, RFFrontend.sch, hermeslite.kicad_pcb, hermeslite.sch]
2017-10-23 Beta 5 work, cleaner/clearer back connectors in schematic
    [Clock.sch, Ethernet.sch, InputOutput.sch, PA.sch, Power.sch, RFFrontend.sch, hermeslite.kicad_pcb, hermeslite.sch]
2017-10-26 Beta5 work, schematic clean-up
    [Clock.sch, Ethernet.sch, InputOutput.sch, PA.sch, Power.sch, RFFrontend.sch, hermeslite.kicad_pcb, hermeslite.sch]
2017-10-30 Beta5 work
    [Clock.sch, Ethernet.sch, InputOutput.sch, PA.sch, Power.sch, RFFrontend.sch, hermeslite.kicad_pcb, hermeslite.sch]
2017-11-06 Beta5 work, ready for review
    [Clock.sch, Ethernet.sch, InputOutput.sch, PA.sch, Power.sch, RFFrontend.sch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]
2017-11-12 BOM work for beta5
    [Clock.sch, Ethernet.sch, InputOutput.sch, PA.sch, Power.sch, RFFrontend.sch, hermeslite.kicad_pcb, hermeslite.sch]
2017-11-12 Added NOBOM key to GT and MH items
    [hermeslite.sch]
2017-11-12 Preliminary Beta5 BOM
2017-11-14 Beta5 cleanup, switch to Veth for ETH LED config pullup
    [Clock.sch, Ethernet.sch, InputOutput.sch, PA.sch, Power.sch, RFFrontend.sch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]
2017-11-14 Beta5 assembly BOMs and spreadsheet
2017-11-20 First cut at 1000/100 Mbits support
2017-12-12 Unconstrained io inputs as constraints led to bad timing closure
2017-12-29 Added new i2c_bus2 module and test
2018-01-01 Tighter timing on high speed ports
    [network.v]
2018-01-01 Filter selection support
2018-01-01 Remvoed i2c2_init.v
2018-02-18 Switch to low power ADC
2018-02-18 Build6 changes
    [Clock.sch, Ethernet.sch, InputOutput.sch, PA.sch, Power.sch, RFFrontend.sch, hermeslite.kicad_pcb, hermeslite.sch]
2018-02-25 RTL refactoring, proper ref placement to nohole footprints
2018-02-25 Prep for build6 release
    [hermeslite.kicad_pcb]
2018-02-25 Fix thermal holes outside of AD9866nohole boundary
2018-02-25 Update date in bom generation scripts
2018-02-26 Added hiresolution assembly pictures
2018-03-19 Switch to AXIS for upstream to readio
2018-03-31 Reworking the downstream path
    [dsopenhpsdr1.v, hermeslite.v]
2018-05-19 Added 3d end caps from w3drk
    [HL2_Enclosure_Front_Cap.stl, HL2_Enclosure_Rear_Cap.stl, HL2_End_Caps.f3d]
2018-05-22 Fix proper padding for 3 receivers
    [usopenhpsdr1.v]
2018-05-30 By Jim Ahlstrom, N2ADR. This code works for Quisk, but fails on HamVNA. Further work is required. control.v: Do not turn on Tx for vna mode. Require MOX. For vna mode, power amp and T/R switch are de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
    [vna_scanner.v]
2018-06-16 Added .dxf files
    [HL_Front_Cover.dxf, HL_Rear_Cover.dxf]
2018-06-17 Added fr4grx endcaps
    [front.dxf, rear.dxf]
2018-06-18 Build7 scehmatics
    [Clock.sch, Ethernet.sch, InputOutput.sch, PA.sch, Power.sch, RFFrontend.sch, hermeslite.kicad_pcb, hermeslite.sch]
2018-06-18 Marked Build7 No Assembly Components as ADNI
    [Ethernet.sch, InputOutput.sch, Power.sch, RFFrontend.sch]
2018-06-20 Added ADNI to all FPGA instances
    [Ethernet.sch, InputOutput.sch, PA.sch, Power.sch]
2018-06-20 Updated BOM generation scripts
2018-06-30 Forked n2adr filter board
    [n2adr.kicad_pcb, n2adr.sch]
2018-07-02 Updates to N2ADR board
    [n2adr.kicad_pcb, n2adr.sch]
2018-07-02 Finalizing n2adr changes
    [n2adr.kicad_pcb, n2adr.sch]
2018-07-03 Added n2adr schematic and first gerber files
2018-07-06 Added BOM generation
    [n2adr.sch]
2018-07-06 Schematic Updates
    [n2adr.sch]
2018-07-06 BOM LaTeX Generation
2018-07-06 Added Assembly BOM
2018-07-08 Change the CW waveform rise/fall time from 2 msec to 4 msec. Sequence the T/R relay and amp power for CW. By N2ADR.
2018-07-08 Sync PCB with schematic
    [n2adr.kicad_pcb, n2adr.sch]
2018-07-09 Final schematic and pcb updates for N2ADR E5
    [n2adr.kicad_pcb, n2adr.sch]
2018-07-11 N2ADR standard BOM
2018-07-11 N2ADR E5 release
    [n2adr.sch]
2018-11-04 Added interactive BOM
2018-11-04 Linked to www.hermeslite.com for interactive BOM proper rendering
2018-11-21 Add TX envelope PWM output for EER/ET
    code taken from Hermes
2018-12-03 Added stencil gerber files
2019-02-02 Updated permissions, deleted stale files
    [Clock.sch, Ethernet.sch, HL2_Enclosure_Front_Cap.stl, HL2_Enclosure_Rear_Cap.stl, HL2_End_Caps.f3d, InputOutput.sch, PA.sch, Power.sch]
2019-02-02 Build Completion with PWM setting
2019-02-03 Increase watchdog timer to 2.68 seconds
2019-02-03 Fixed clip to not include good level, requires 4 clips to send to PC
    [control.v]
2019-02-04 20190203 Release, PCB switching to 5.02 KiCAD
    [Clock.sch, Ethernet.sch, InputOutput.sch, PA.sch, Power.sch, RFFrontend.sch, hermeslite.sch]
2019-02-11 Work towards build8 release
    [Clock.sch, Ethernet.sch, InputOutput.sch, PA.sch, Power.sch, RFFrontend.sch, hermeslite.sch]
2019-02-12 Build8 updates
    [Ethernet.sch, PA.sch, Power.sch, RFFrontend.sch]
2019-02-13 Update X2 footprint on PCB for build8
    [Clock.sch, hermeslite.kicad_pcb]
2019-02-17 BOM updates for build8
    [Clock.sch, Ethernet.sch, InputOutput.sch, PA.sch, Power.sch, RFFrontend.sch, hermeslite.kicad_pcb, hermeslite.sch]
2019-02-18 Build 8 release for review
    [InputOutput.sch, bom.assembly.xlsx, hermeslite.kicad_pcb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]
2019-02-19 Add test output to LEDs
2019-02-21 Updates to N2ADR filterboard for build8 group buy
    [n2adr.kicad_pcb, n2adr.sch]
2019-02-24 Updates to hl20build8 fabrication files
    [Clock.sch, Ethernet.sch, InputOutput.sch, PA.sch, Power.sch, RFFrontend.sch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]
2019-02-25 n2adr filter board and jumper build8
    [Header2x20.kicad_pcb, Header2x20.sch, bom.assembly.xlsx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]
2019-03-10 Switch to enamel wire for power sense toroid on N2ADR filter board
    [bom.assembly.xlsx]
2019-03-11 Deleted drill file
    [Header2x20.drl]
2019-05-11 Adjustment to test for larger temperature rise
2019-06-17 Release 20190616, FPGA-generated power supply switching frequency
2019-06-30 Increase sync width for envelope filter
    and change the PWM output pin to io_lvds_txp: the previously used
    io_lvds_txn now outputs the inverted PWM signal.
    [hermeslite.v, radio.v]
2019-06-30 Use rounding to avoid missing codes
    in the PWM output
    [radio.v]
2019-06-30 Select 2.5 V IO standard for BANK5
2019-07-23 Initial checkin of ad5dz endcaps.
    [front.dxf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]
2019-07-23 Added the 105mm mechanical drawing with the wrong widths on it.
2019-08-15 Added HL2 build9
    [Clock.sch, Ethernet.sch, InputOutput.sch, PA.sch, Power.sch, RFFrontend.sch, bom.assembly.xlsx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]
2019-08-17 N2ADR work
    [n2adr.kicad_pcb, n2adr.sch]
2019-08-17 Added N2ADR filter board build9
    [bom.assembly.xlsx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]
2019-08-18 Added kf7o endcap
    [endcap.kicad_pcb, endcap.sch]
2019-08-25 Added 55mm front and back standalone
    [endcap.kicad_pcb, endcap.sch]
2019-08-25 Added beta release files for 55mm high end plates
    [endcap-B.Paste.gbr, endcap-DWgs.User.gbr, endcap-F.Paste.gbr, endcap.GBL, endcap.GBO, endcap.GBS, endcap.GTL, endcap.GTS]
2019-08-25 Added panel schematics
2019-08-26 Build9 final changes before submission
    [Clock.sch, Ethernet.sch, InputOutput.sch, PA.sch, Power.sch, RFFrontend.sch, bom.assembly.xlsx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]
2019-09-01 Added 40mm enclosure
    [endcap.kicad_pcb, endcap.sch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]
2019-09-01 11-16V on 55m templates
    [endcap-B.Paste.gbr, endcap-DWgs.User.gbr, endcap-F.Paste.gbr, endcap.GBL, endcap.GBO, endcap.GBS, endcap.GTL, endcap.GTS]
2019-09-29 Update BOM for webpage link
2019-10-21 Switched to 16-bit values for wide band data, added HARD_STATUS to discovery reply
2019-10-27 First working i2c read
2019-10-28 Power on read of EEPROM
2019-11-04 Added delay to slow adc
2019-11-11 VNA working with NCO phase reset
    [asmi_interface.v, control.v, hermeslite_core.v, nco2.v, usopenhpsdr1.v]
2019-11-11 Added IO companion board
    [io.kicad_pcb, io.sch]
2019-11-19 Rev 2 of rear end plate
    [endcap.kicad_pcb, endcap.sch]
2019-11-19 Swap horizontal and veritical lettering
    [endcap.kicad_pcb]
2019-11-21 Rear end plate 40mm 2.0
    [endcap.kicad_pcb, endcap.sch]
2019-11-23 Updates to endplate
    [endcap.kicad_pcb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]
2019-11-24 55mm rev2 endplate
    [endcap-B.Paste.gbr, endcap-DWgs.User.gbr, endcap-F.Paste.gbr, endcap.GBL, endcap.GBO, endcap.GBS, endcap.GTL, endcap.GTS]
2019-11-25 Added pullups, diodes to some channels
    [endcap.kicad_pcb, endcap.sch]
2019-11-27 Added db9 adapter and smallio
    [db9.kicad_pcb, db9.sch, smallio.kicad_pcb, smallio.sch]
2019-11-30 Added io_jumper and psfeedback boards
    [io_jumper.kicad_pcb, io_jumper.sch, psfeedback.kicad_pcb, psfeedback.sch]
2019-12-02 Final IO end plates
    [endcap.kicad_pcb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]
2019-12-02 Added BOM and generated gerber files
    [db9.kicad_pcb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]
2019-12-21 radioberry firmware and gateware added. 4rx (48k) and 1 tx (initial version)
    [radioberry.smp_dump.txt]
2019-12-21 build results removed
    [radioberry.smp_dump.txt]
2019-12-23 Assembly updates
2019-12-23 Assembly edits
2019-12-24 Added more assembly notes
2019-12-30 Added wiring diagram, increased PCB size
    [db9.kicad_pcb]
2020-01-01 Added sym-lib-table and updated .sch to use only n2adr.lib
    [n2adr.sch]
2020-01-13 Added fan control, psync as generate, board id in discovery, fifo fixes
    [control.v, fifos.v, hermeslite.v, hermeslite_core.v, radio.v, usopenhpsdr1.v]
2020-01-18 Timing path fix in vna_scanner
    [mix2.v, nco2.v, radio.v, vna_scanner.v]
2020-02-03 Fix for receivers number of 2,3,5 and 6
    [radio.v]
2020-02-14 Added cw_basic and led_flash
2020-03-09 Updated end plate README
2020-03-22 Add LPF for fan on latest end plates
    [endcap.kicad_pcb, endcap.sch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]
2020-03-23 Minor updates to schematic text
    [Clock.sch, Ethernet.sch, InputOutput.sch, PA.sch, Power.sch, RFFrontend.sch, hermeslite.sch]
2020-03-30 Change in size to SMA cutout
    [endcap.kicad_pcb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]
2020-04-21 fan changes
2020-04-21 cwx fix to not accumulate data in TX buffer
    [hermeslite_core.v, radio.v]
2020-05-03 Alex rx antenna
2020-05-04 revert fast LNA and increased tx pwr
    [ad9866ctrl.v, radioberry.v, radioberry_core.v]
2020-05-06 Switched to IAMP TX gain based on Hermes-Lite 1
2020-05-16 Tighten timing on PGA5
2020-05-23 Relaxed no filter 160M test
2020-05-29 Output register for UART
2020-05-29 Fix for no CW in SDR Console
    [ad9866.v]
2020-05-29 Fix for github issue 145
    [radio.v]
2020-05-30 71p3 and support to reset Versa5
    [hermeslite_core.v, i2c.v]
2020-06-30 added and modified files for AK4951 Companion Board Version 3
2020-07-11 i2c with clock sync working
2020-07-24 First working discovery on second ethernet port, updates to hl2link
    [endcap.sch]
2020-07-25 Switch CDC in udp_destination to one way handshake
2020-07-27 Added extra discover fields, fixed ARP CDC, extra byte in UDP
    [control.v, hermeslite_core.v, ip_recv.v, mac_recv.v, mac_send.v, network.v, rgmii_recv.v, rgmii_send.v]
2020-11-03 Added band voltage PWM output.
2020-11-03 Updated Band Volts to co-exist with Fan PWM. Selection via Dither bit.
2020-11-03 Adjusted for 3.3V power supply
2020-11-08 Restructured to avoid timing path
    [usopenhpsdr1.v]
2020-11-14 radioberry; gateware 72.2; local CW pihpsdr; using RB connector(CN301) to connect paddle
2020-11-26 Added heatshim
    [HL2CoolerCorrected.FCStd, HL2CoolerCorrected.step, HL2CoolerCorrected.stl]
2020-11-28 Make sure that we revert to doing a DHCP discover after the network cable is unplugged and reconnected. Also, ask, in the DHCP DISCOVER for the IP address that we want.
    Also, don't respond to pings that are unicast to us when the IP address
    doesn't match. This fixes a problem where the DHCP server thinsks that
    our requested address is already in use by another system!
    [dhcp.v, ip_recv.v, network.v]
2020-12-03 Removed ip_id to fix timing
    [ip_send.v]
2020-12-17 FAN/ATU clarifications
    Clearing up some items that tripped me up.
2020-12-31 Adjust value to get the port number correctly.
    [icmp.v]
2020-12-31 Fix the use of tabs
    [icmp.v]
2021-01-03 added my endcaps with higher airflow
    [endcap-B_Cu.gbr, endcap-B_Mask.gbr, endcap-B_SilkS.gbr, endcap-Edge_Cuts.gbr, endcap-F_Cu.gbr, endcap-F_Mask.gbr, endcap-F_SilkS.gbr, endcap.drl]
2021-02-16 radioberry gateware 73.0; support of PA board
2021-09-11 radioberry 73.2 8bits rx + tx spi
2021-09-12 replaced sidetone module to reduce FPGA resources and revive 4rx and PS.
    [cw_sidetone.v, hermeslite.v, hermeslite_core.v, localaudio.v, radio.v]
2021-09-22 fixed excessive AK4951 microphone gain
    [i2c.v, i2c_bus2.v]
2021-09-29 fixed abnormal CW code duty if breakin is OFF setting
    [radio.v]
2021-12-12 Proper i2c output drivers
2021-12-12 Switch to release 74p0
2022-01-10 Bug fixes for last commit
    [ad9866ctrl.v, radio.v]
2023-01-14 Updates for new LDMOS devices
2023-12-08 Corrected the inversion of the (active low) Txinhibit signal as sent in the protocol
    [control.v]
2023-12-29 Fix for incorrect response to cwx bits if cwx disabled but cw is used during SSB or other mode
    [dsopenhpsdr1.v]
2024-01-08 Added testing 74p2 rbf files of ak4951 variants
    ak4951v4 is for v4 board that supports ATU, ak4951v3 is for v3 that doesn't support ATU.
    [hermeslite.v]
2026-10-26 Fix for lost IP when ethernet cable is removed
