softerhardware/Hermes-Lite2/(notices)

Notices in the files:
gateware/rtl/ethernet/ip_recv.v:
This program is free software; you can redistribute it and/or modify
it under the terms of the GNU General Public License as published by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
hardware/enclosure/endcaps/ad5dz/hl2-back-vert/hl2-back-vert.kicad_pcb:
© 2019 by Roger E Critchlow Jr, Santa Fe, NM, USA
hardware/enclosure/endcaps/kd9s/hl2_55b/hl2_55b_v/endcap.kicad_pcb:
© 2020 SofterHardware
hardware/companions/psfeedback/psfeedback.kicad_pcb:
v1.0 © 2019
hardware/companions/n2adr/n2adr.kicad_pcb:
Rev E5b9 © 2019 by N2ADR
hardware/hl/hermeslite.kicad_pcb:
© 2019 SofterHardware
